levdan159/abx-motion/abx-3dmodels/README.txt

3D visualization models

DFN-8-1EP_3x3mm_P0.65mm_EP1.5x2.25mm.step
Source: installed KiCad Package_DFN_QFN.3dshapes library (/usr/share/kicad/3dmodels).
Used as a generic 3 x 3 mm, 0.65 mm pitch visual package for U710 (TPS3431 DRB).
The generic model exposed-pad geometry differs from the device-specific footprint; this model does not define copper, paste, assembly or thermal requirements.

U701-U703 use the existing project-local DRV8462_DDW0044E_Envelope.wrl mechanical envelope.
These visual models do not replace component drawings or the PCB land patterns.
