levdan159/abx-motion/design/thermal-rev1.2-20261023/README.txt

Rev 1.2a checkpoint, 2026-10-23

filled-capped-vias.csv describes the implemented PCB fabrication features.
thermal-assembly.pdf, HS1-machining-plan.dxf, heatsink-bom.csv and heatsink-placement.png describe a SUPERSEDED machined-heatsink study. They are not current assembly instructions or purchasing approval.

No custom machining is available. Current cooling direction: stock underside finned heatsinks plus supplemental individual top-side driver heatsinks. Exact parts, retention and performance are pending. See ../thermal-rev1.2-20261023.md and ../rev-1.2a-checkpoint.md.
