levdan159/abx-motion/production/rev-1.2a-20261023/drill-report.txt

Drill report for abx-motion.kicad_pcb
Created on 2026-10-23T12:07:56

Copper Layer Stackup:
    =============================================================
    L1 :  F.Cu                      front
    L2 :  In1.Cu                    in1
    L3 :  In2.Cu                    in2
    L4 :  B.Cu                      back

Drill file 'abx-motion-PTH.drl' contains
    plated through holes:
    =============================================================
    T1  0.250mm  0.0098"  (587 holes))
    T2  0.300mm  0.0118"  (511 holes))
    T3  0.300mm  0.0118"  (38 holes))
    T4  0.400mm  0.0157"  (33 holes))
    T5  0.500mm  0.0197"  (32 holes))
    T6  0.600mm  0.0236"  (4 holes)  (with 4 slots)
    T7  0.750mm  0.0295"  (24 holes))
    T8  0.800mm  0.0315"  (6 holes))
    T9  0.900mm  0.0354"  (4 holes))
    T10  0.950mm  0.0374"  (24 holes))
    T11  1.000mm  0.0394"  (32 holes))
    T12  1.300mm  0.0512"  (28 holes))
    T13  1.800mm  0.0709"  (4 holes))
    T14  3.200mm  0.1260"  (4 holes))
    T15  4.500mm  0.1772"  (2 holes))

    Total plated holes count 1333

Drill file 'abx-motion-NPTH.drl' contains
    unplated through holes:
    =============================================================
    T1  0.650mm  0.0256"  (2 holes))
    T2  2.200mm  0.0866"  (2 holes))

    Total unplated holes count 4
