levdan159/abx-motion/design/rev-1.2-research/conduction-loss-comparison.csv

driver | phase_RMS_A | condition | HS_ohm | LS_ohm | conduction_W_per_axis | conduction_W_three_axes
DRV8461_PWP | 1 | typ25 | 0.153 | 0.15 | 0.606 | 1.818
DRV8461_PWP | 1 | max25 | 0.18 | 0.185 | 0.73 | 2.19
DRV8461_PWP | 1 | max125 | 0.285 | 0.3 | 1.17 | 3.51
DRV8461_PWP | 1.5 | typ25 | 0.153 | 0.15 | 1.3635 | 4.0905
DRV8461_PWP | 1.5 | max25 | 0.18 | 0.185 | 1.6425 | 4.9275
DRV8461_PWP | 1.5 | max125 | 0.285 | 0.3 | 2.6325 | 7.8975
DRV8461_PWP | 2 | typ25 | 0.153 | 0.15 | 2.424 | 7.272
DRV8461_PWP | 2 | max25 | 0.18 | 0.185 | 2.92 | 8.76
DRV8461_PWP | 2 | max125 | 0.285 | 0.3 | 4.68 | 14.04
DRV8452_PWP | 1 | typ25 | 0.057 | 0.06 | 0.234 | 0.702
DRV8452_PWP | 1 | max25 | 0.068 | 0.072 | 0.28 | 0.84
DRV8452_PWP | 1 | max125 | 0.1 | 0.105 | 0.41 | 1.23
DRV8452_PWP | 1.5 | typ25 | 0.057 | 0.06 | 0.5265 | 1.5795
DRV8452_PWP | 1.5 | max25 | 0.068 | 0.072 | 0.63 | 1.89
DRV8452_PWP | 1.5 | max125 | 0.1 | 0.105 | 0.9225 | 2.7675
DRV8452_PWP | 2 | typ25 | 0.057 | 0.06 | 0.936 | 2.808
DRV8452_PWP | 2 | max25 | 0.068 | 0.072 | 1.12 | 3.36
DRV8452_PWP | 2 | max125 | 0.1 | 0.105 | 1.64 | 4.92
