levdan159/abx-motion/abx_gears.png

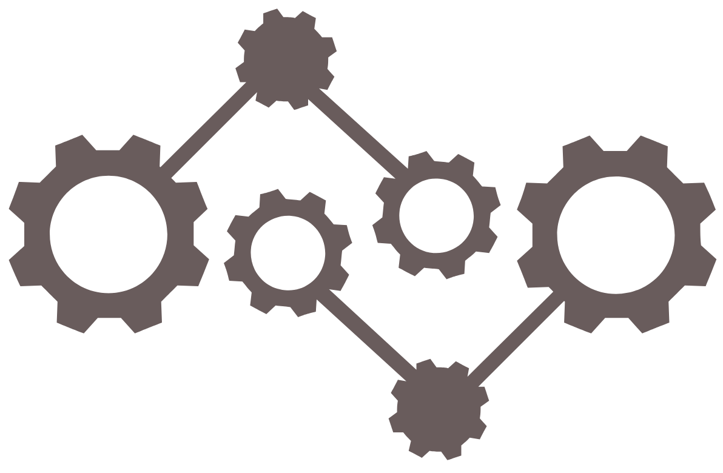
abx_gears.png
