levdan159/abx-motion/design/thermal-rev1.2-20261023/heatsink-placement.png

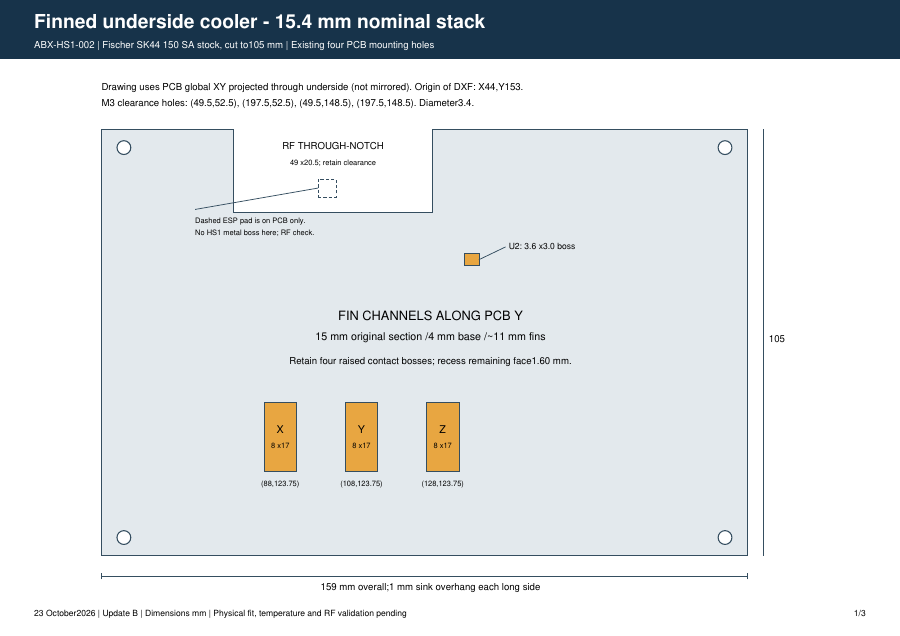
design/thermal-rev1.2-20261023/heatsink-placement.png
