levdan159/abx-motion/production/rev-1.1b-20261020/pcb_3d_top.png

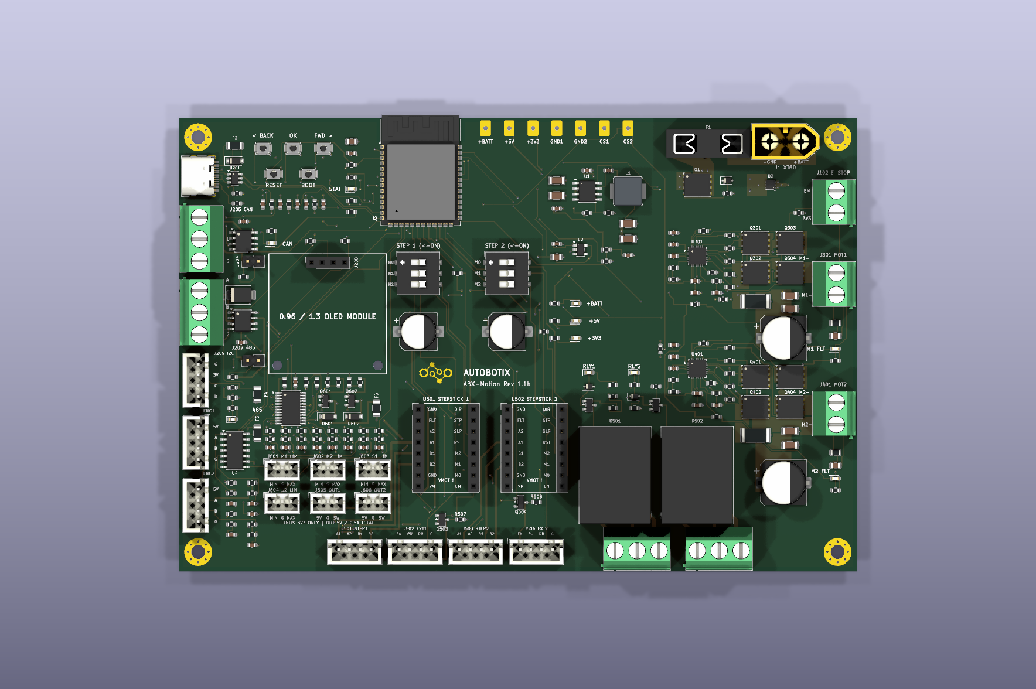
production/rev-1.1b-20261020/pcb_3d_top.png
