levdan159/abx-motion/production/rev-1.1b-20261020/placement-summary.png

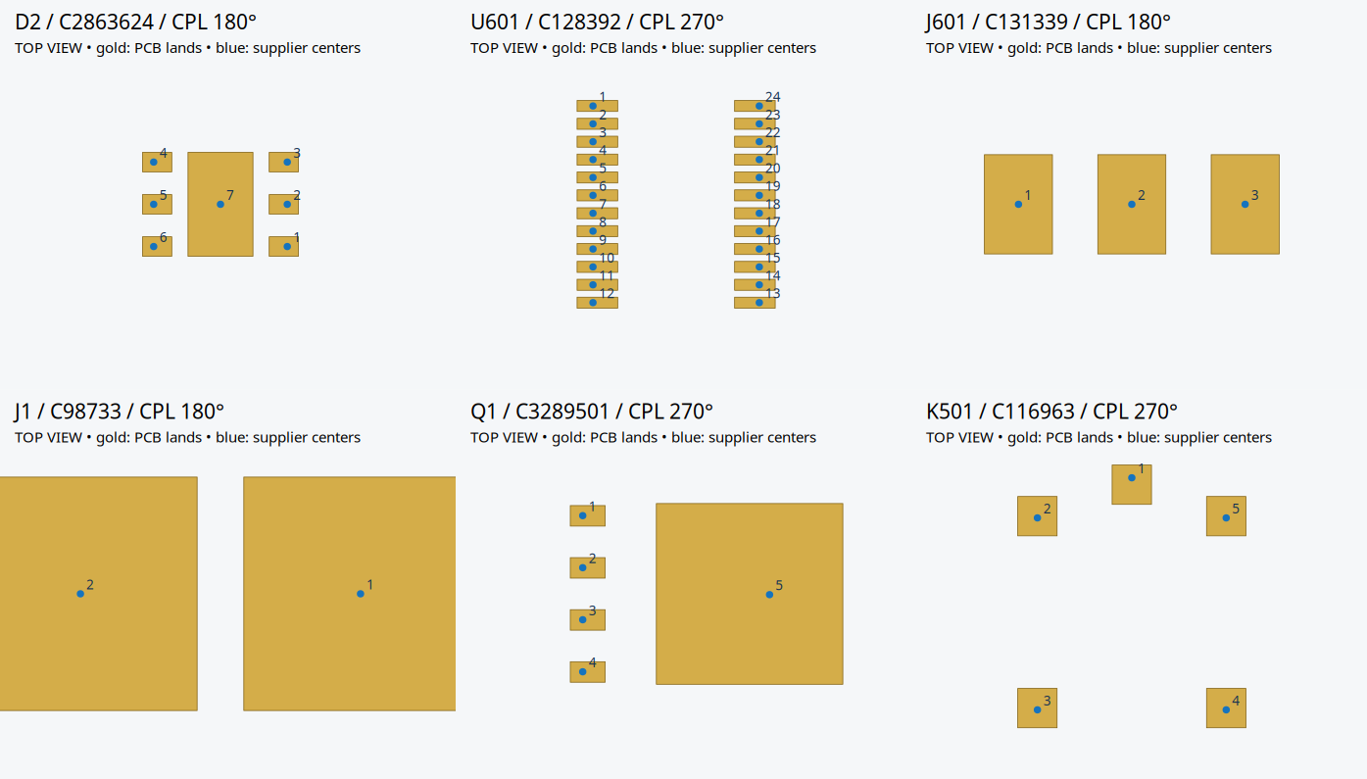
production/rev-1.1b-20261020/placement-summary.png
