levdan159/abx-motion/renders/f1_bottom_check.png

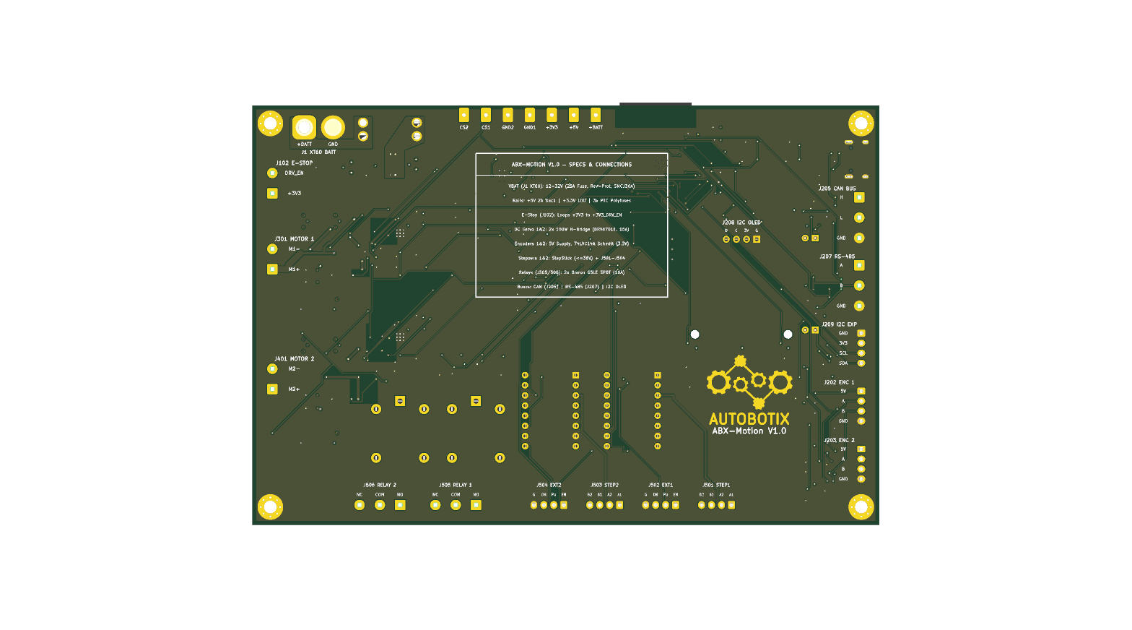
renders/f1_bottom_check.png
