levdan159/abx-motion/renders/f1_check.png

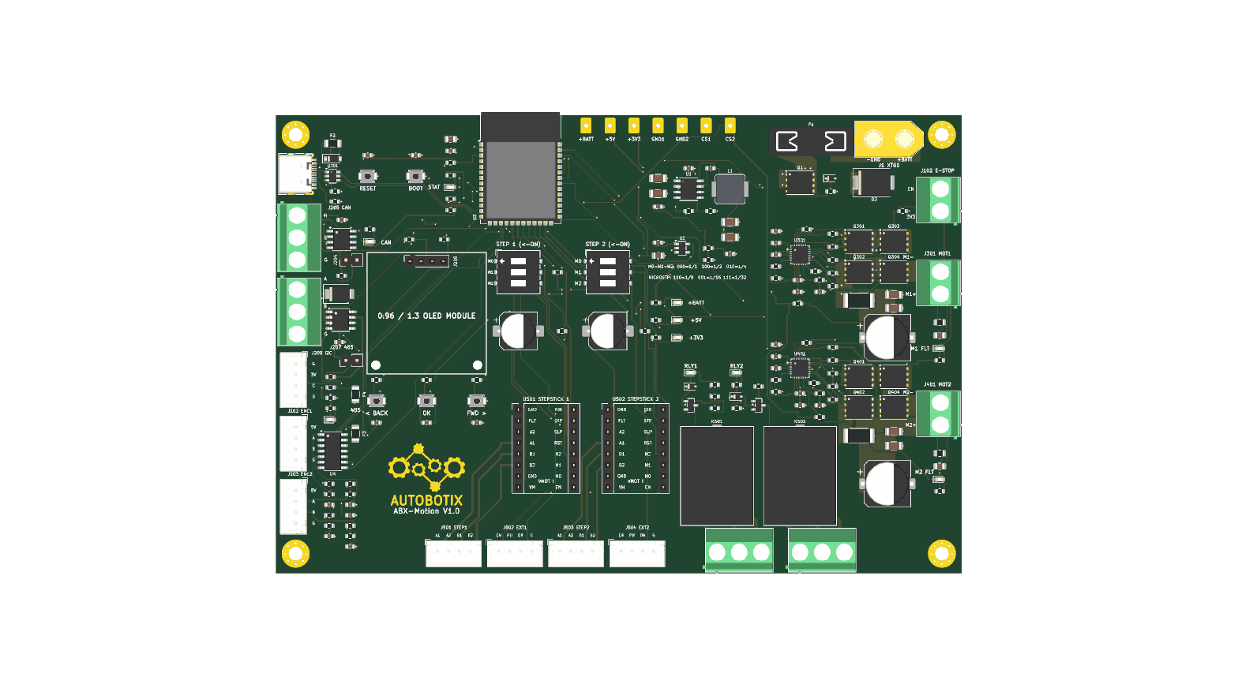
renders/f1_check.png
