levdan159/abx-motion/renders/page-1.png

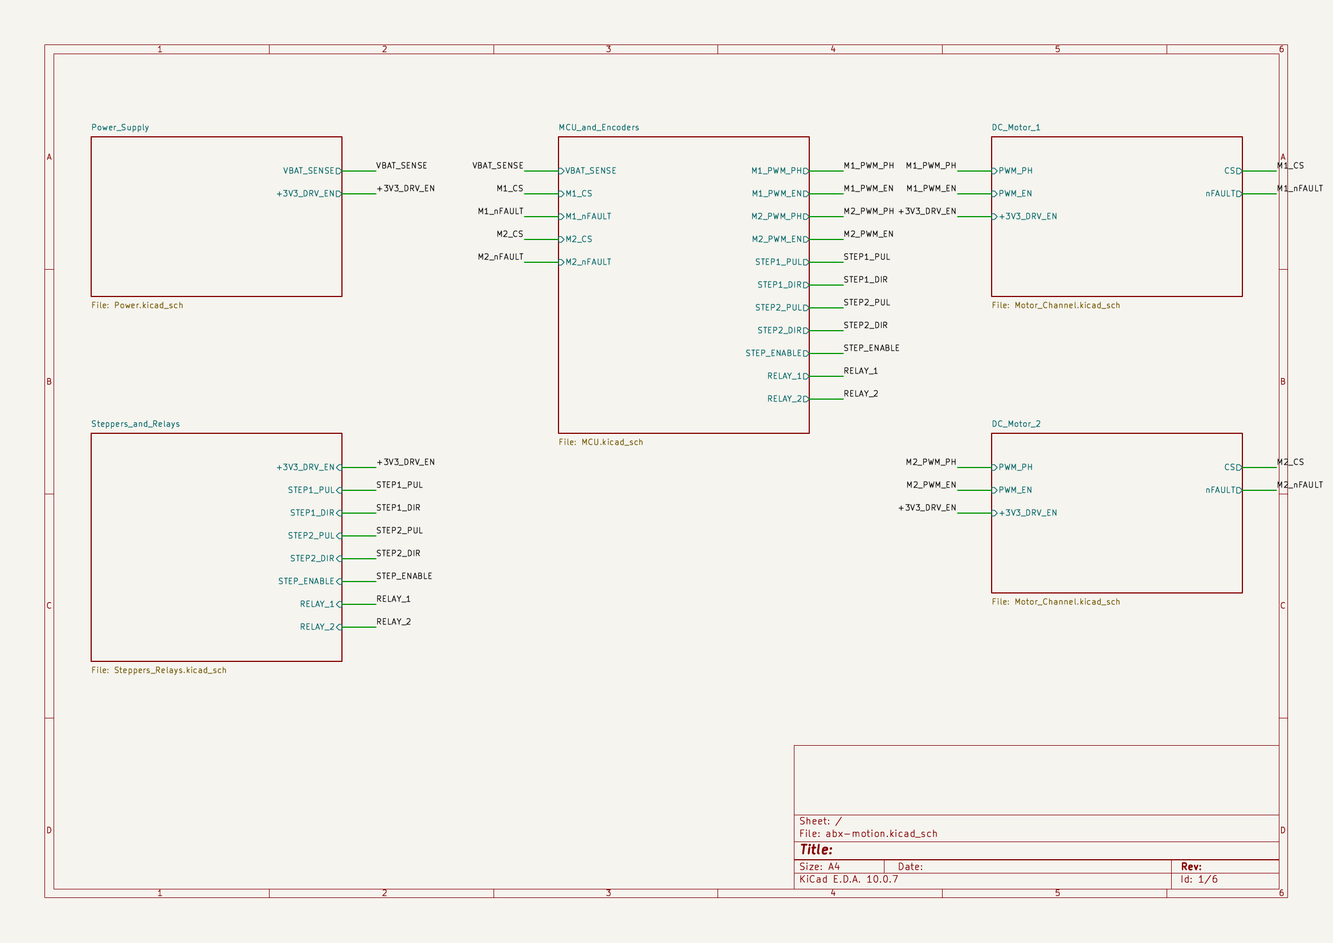
renders/page-1.png
