levdan159/abx-motion/renders/page-2.png

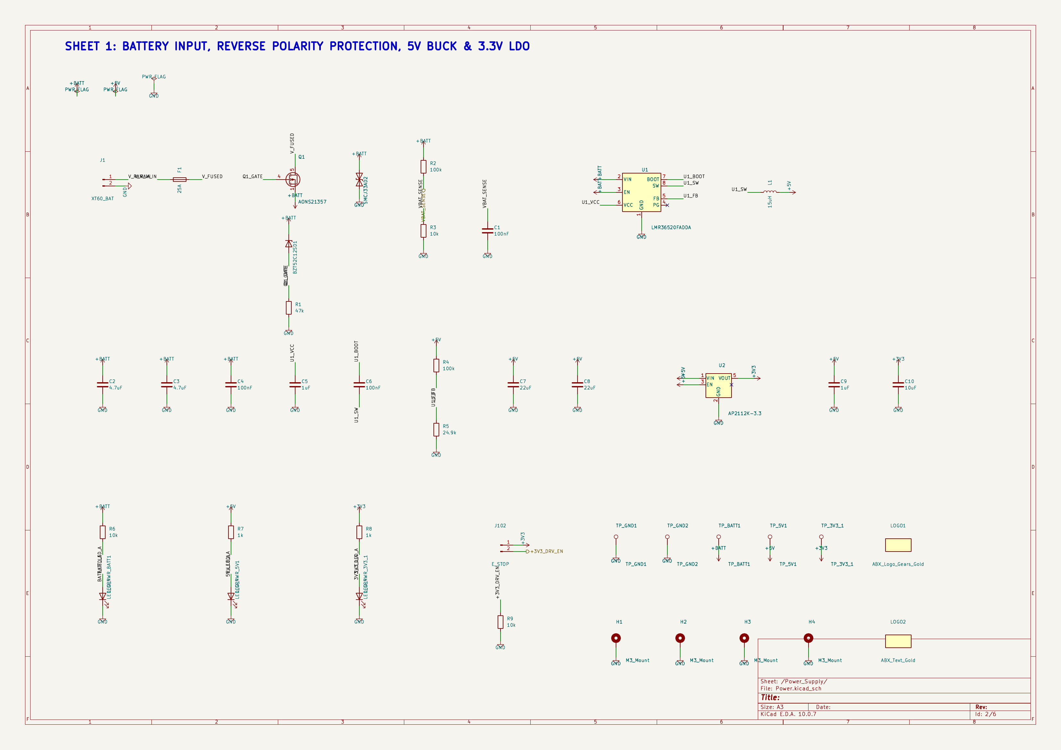
renders/page-2.png
