levdan159/abx-motion/renders/page-3.png

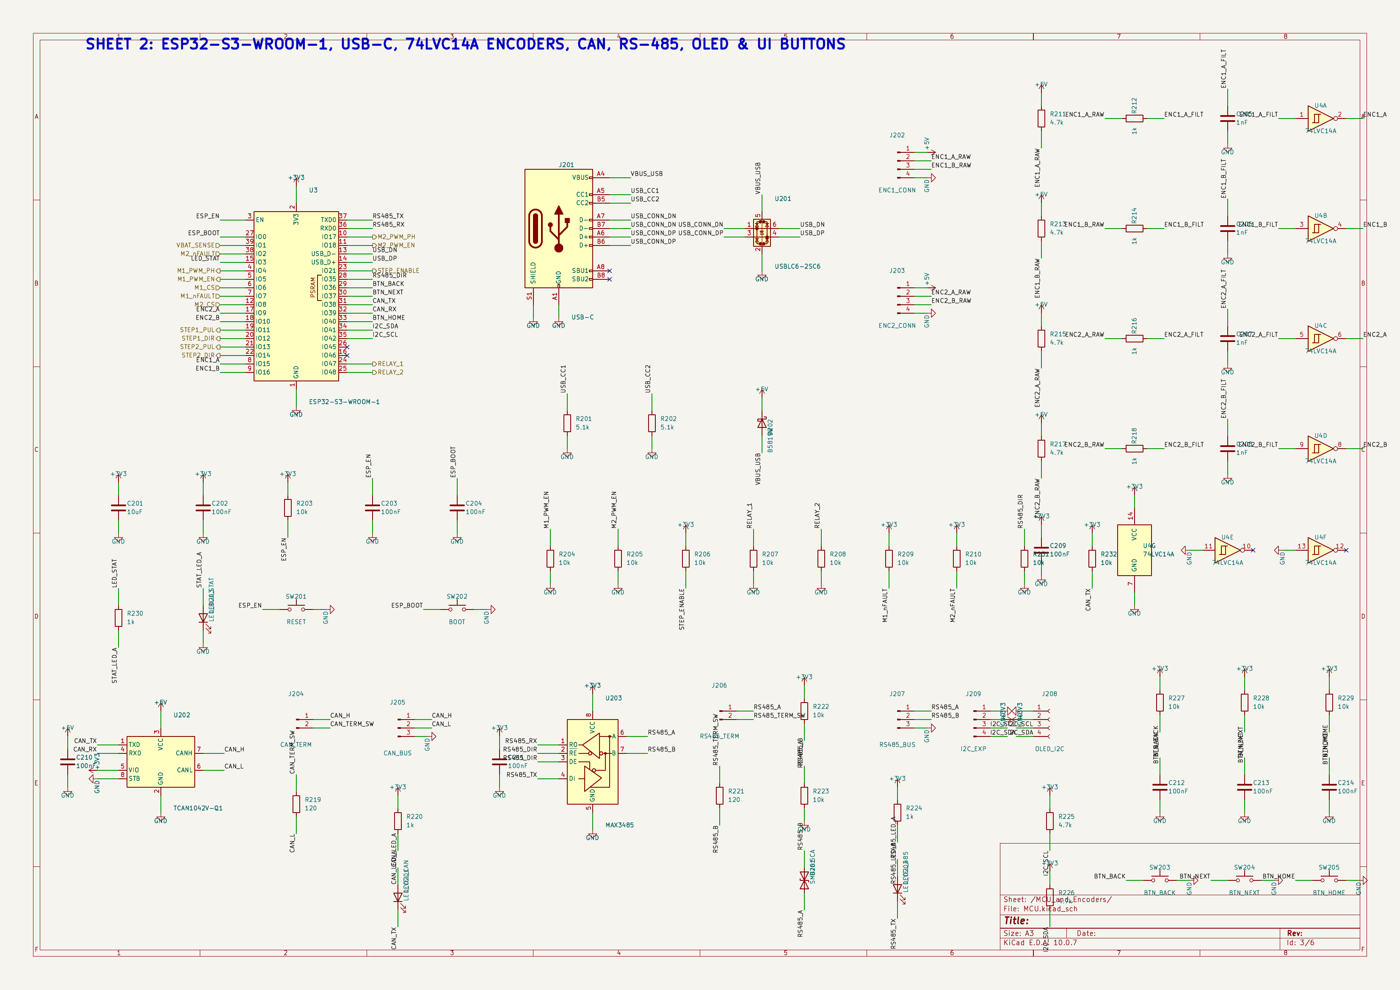
renders/page-3.png
