levdan159/abx-motion/renders/page-4.png

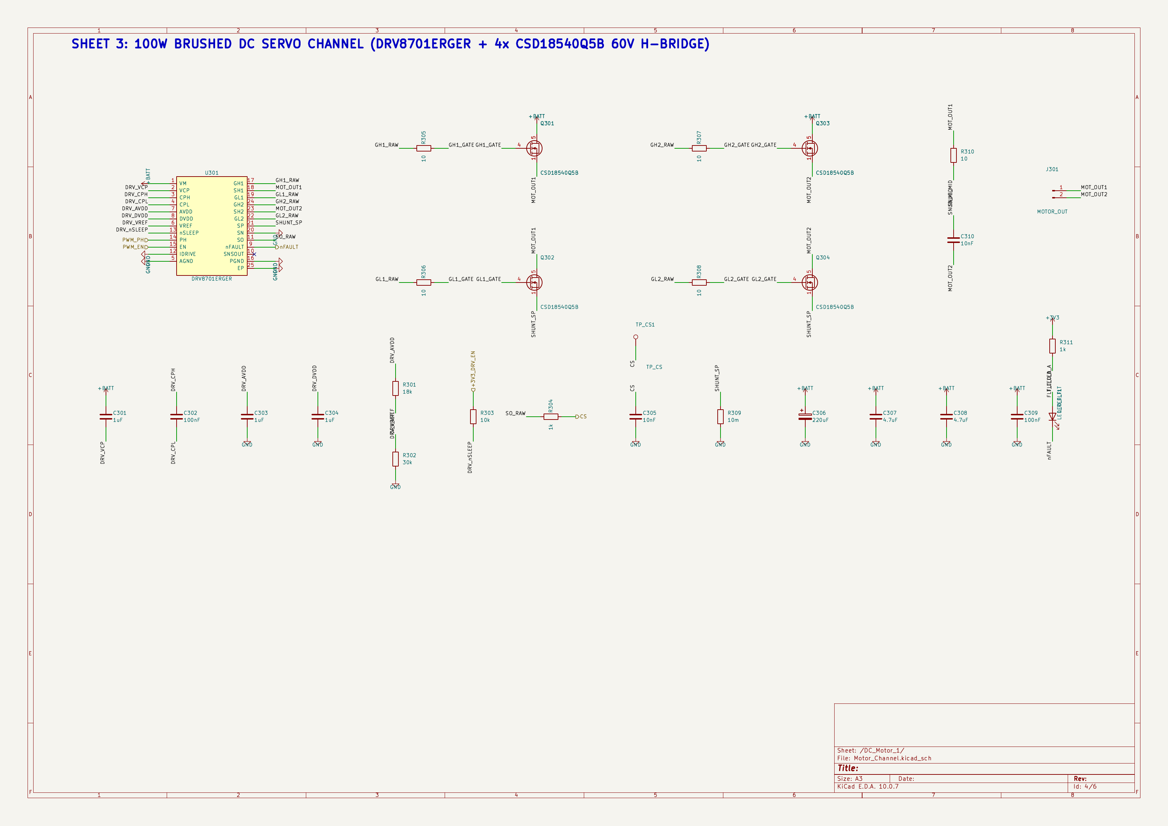
renders/page-4.png
