levdan159/abx-motion/renders/page-6.png

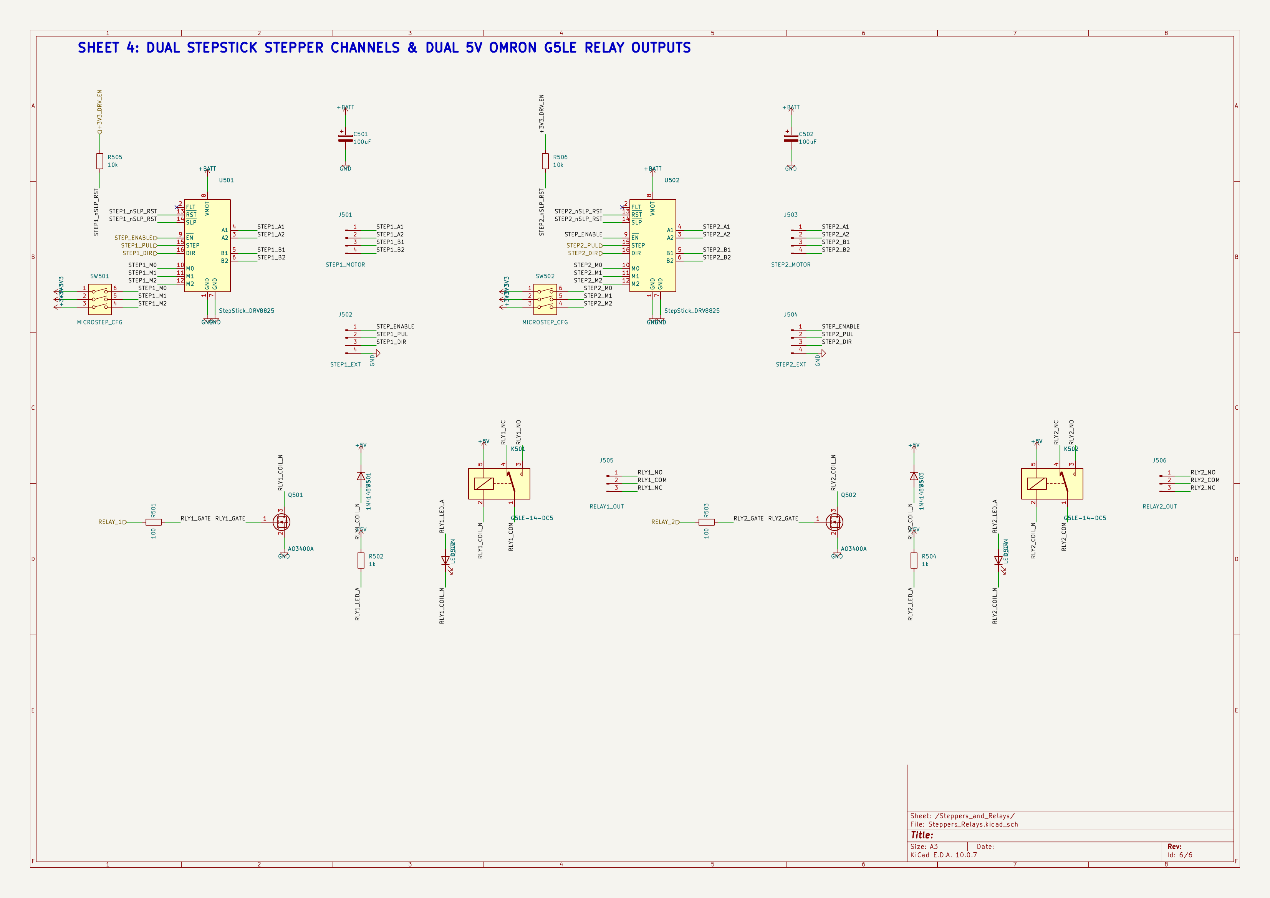
renders/page-6.png
