levdan159/abx-motion/renders/pcb_bottom.png

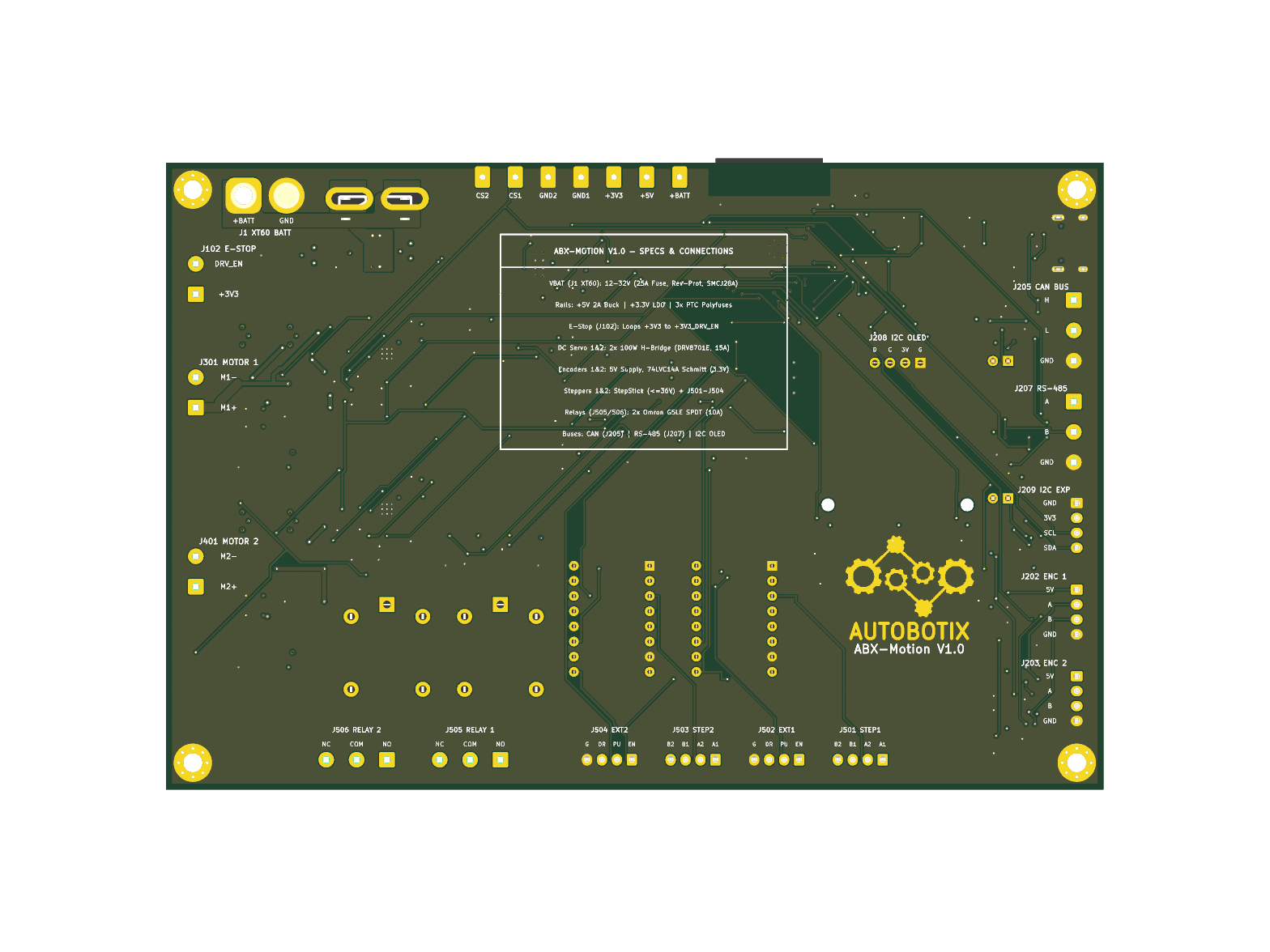
renders/pcb_bottom.png
