levdan159/abx-motion/renders/pcb_isometric.png

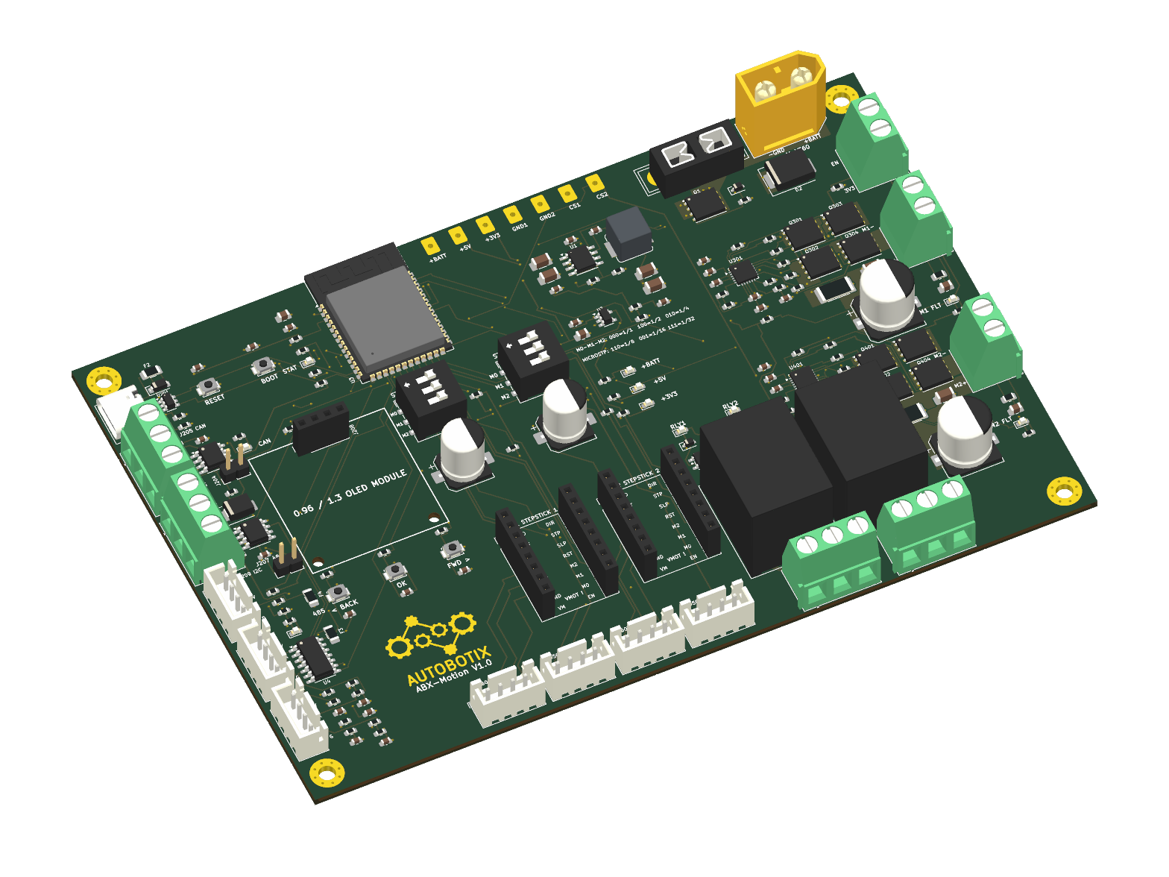
renders/pcb_isometric.png
