levdan159/abx-motion/renders/pcb_placement.png

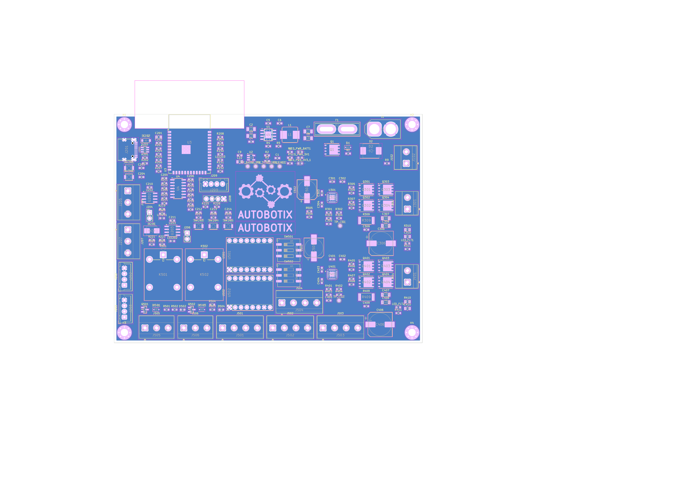
renders/pcb_placement.png
