levdan159/abx-motion/variants/ABX-Motion-ETH/layout-review/placement-3d.png

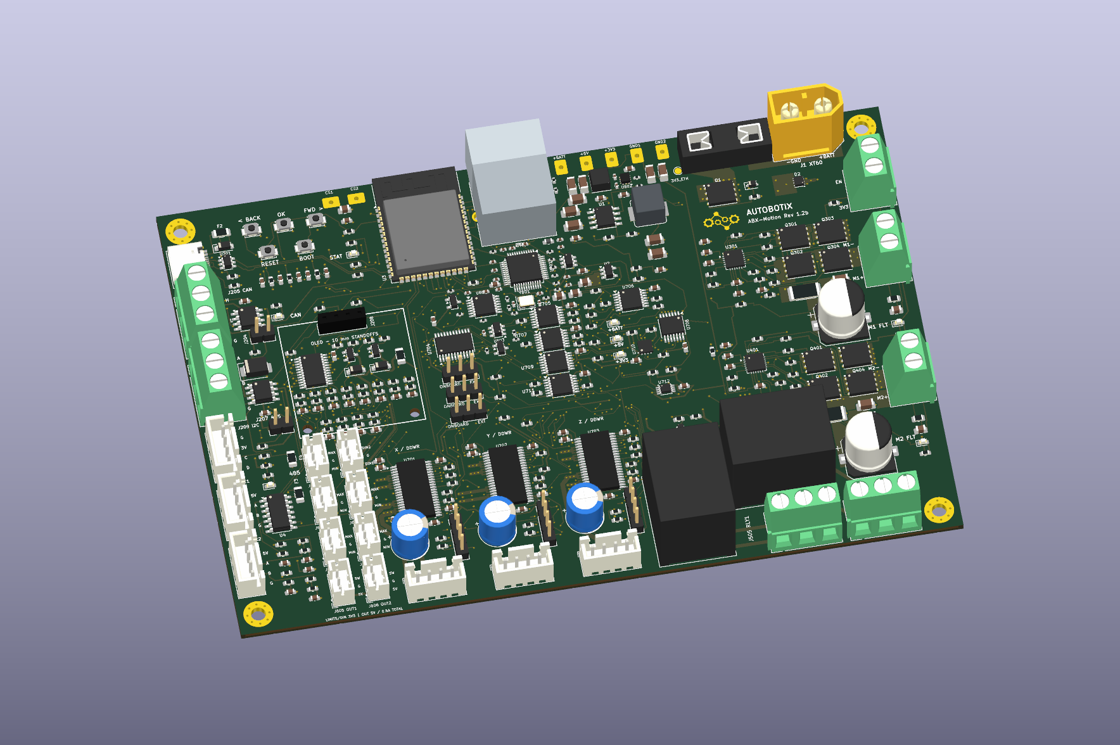
variants/ABX-Motion-ETH/layout-review/placement-3d.png
