levdan159/abx-motion/variants/ABX-Motion-ETH/layout-review/placement-detail.png

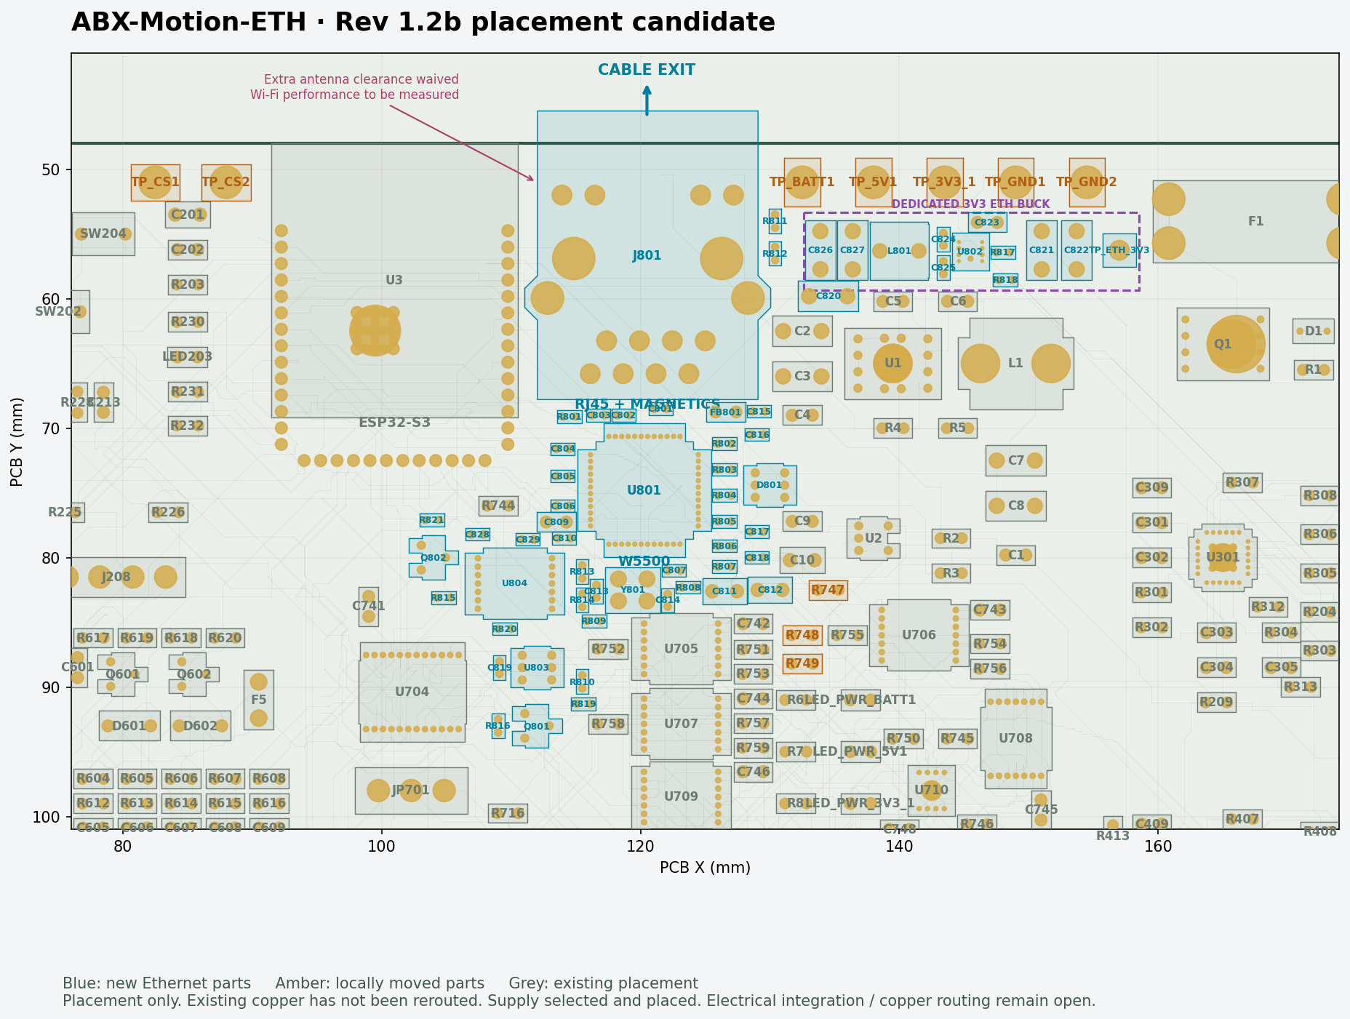
variants/ABX-Motion-ETH/layout-review/placement-detail.png
