levdan159/abx-motion/variants/ABX-Motion-ETH/layout-review/placement-overview.png

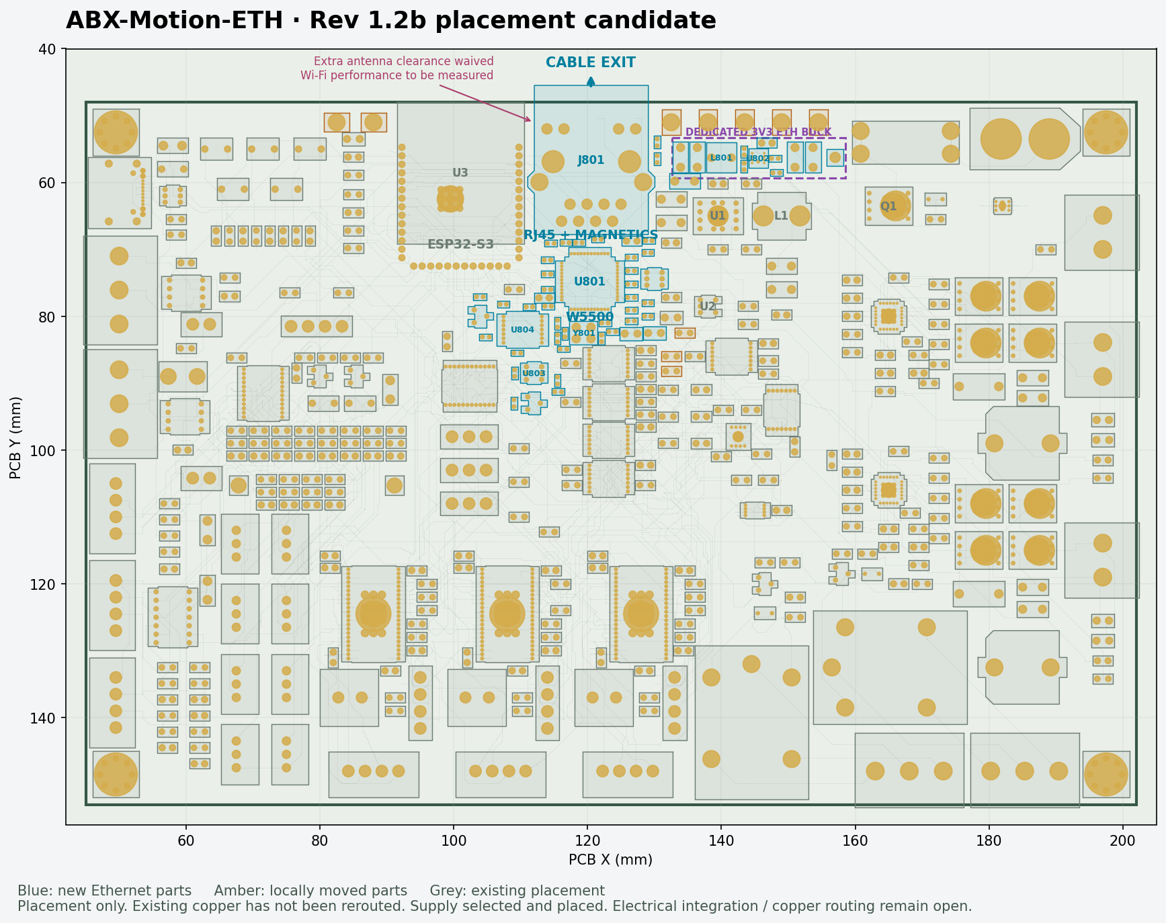
variants/ABX-Motion-ETH/layout-review/placement-overview.png
