levdan159/abx-motion/variants/ABX-Motion-ETH/layout-review/power-routing-plan.png

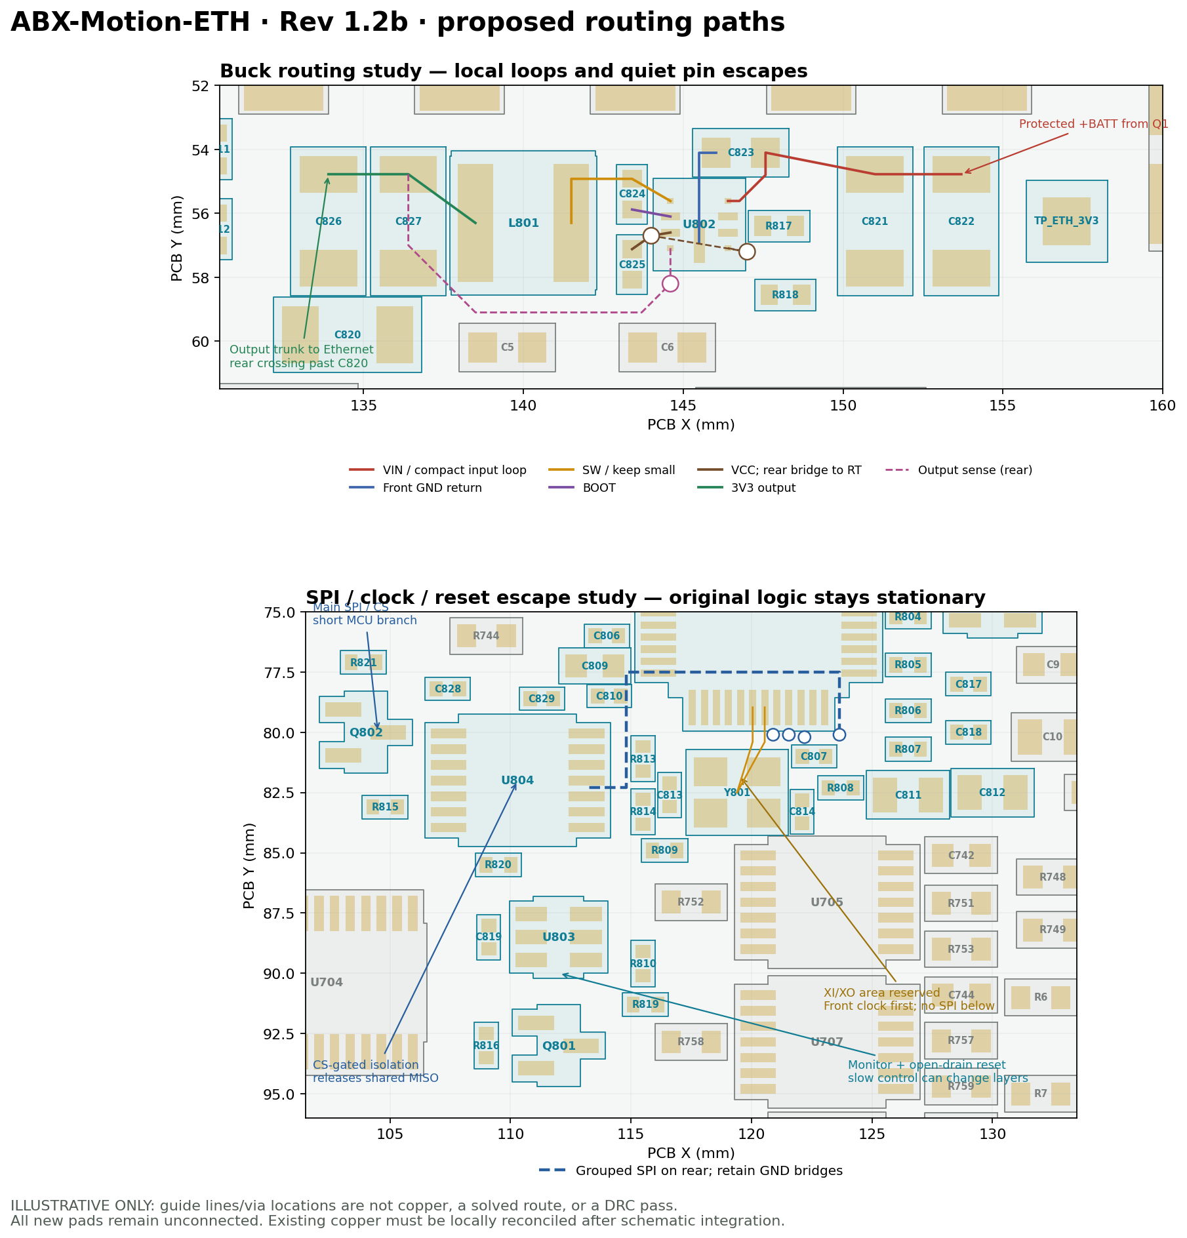
variants/ABX-Motion-ETH/layout-review/power-routing-plan.png
