levdan159/abx-motion/variants/ABX-Motion-ETH/layout-review/routing-overview.png

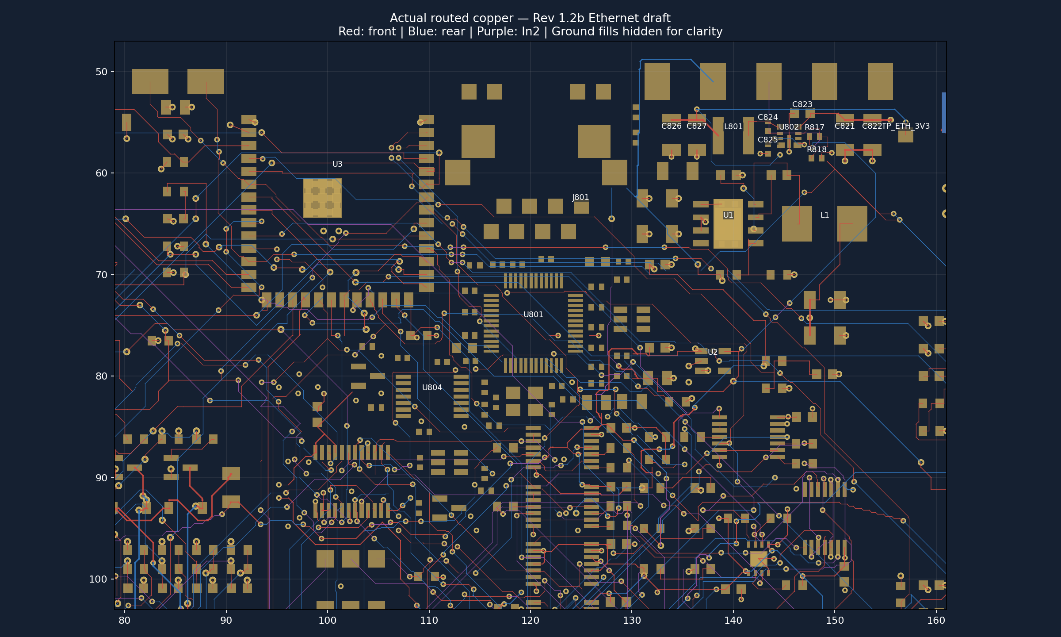
variants/ABX-Motion-ETH/layout-review/routing-overview.png
