levdan159/abx-motion/variants/ABX-Motion-ETH/layout-review/routing-supply.png

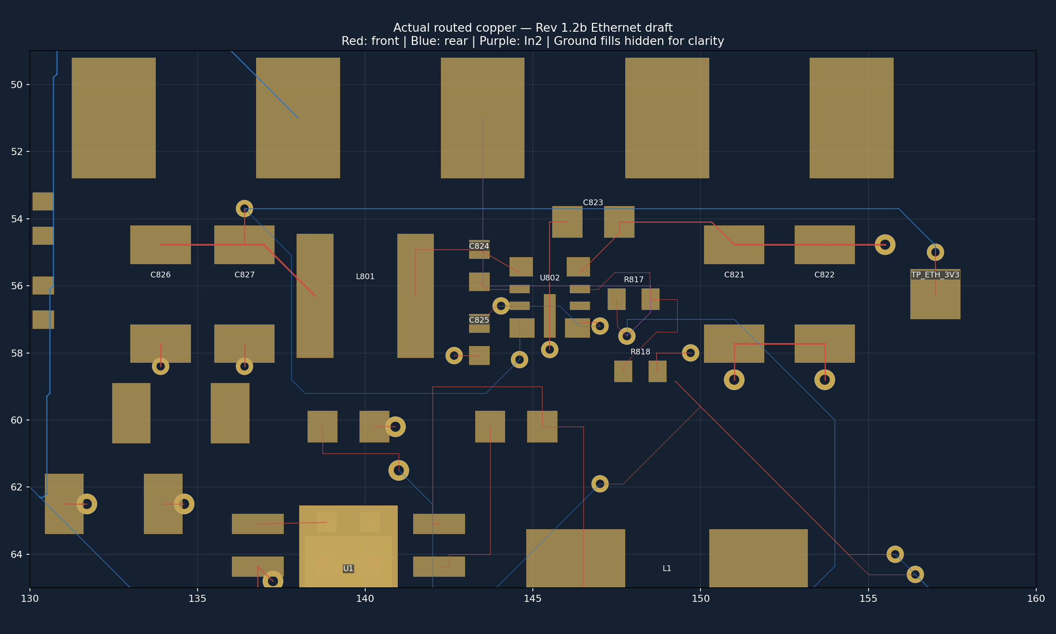
variants/ABX-Motion-ETH/layout-review/routing-supply.png
