levdan159/abx-motion/work/rev-1.2-ext-upright/review/front.png

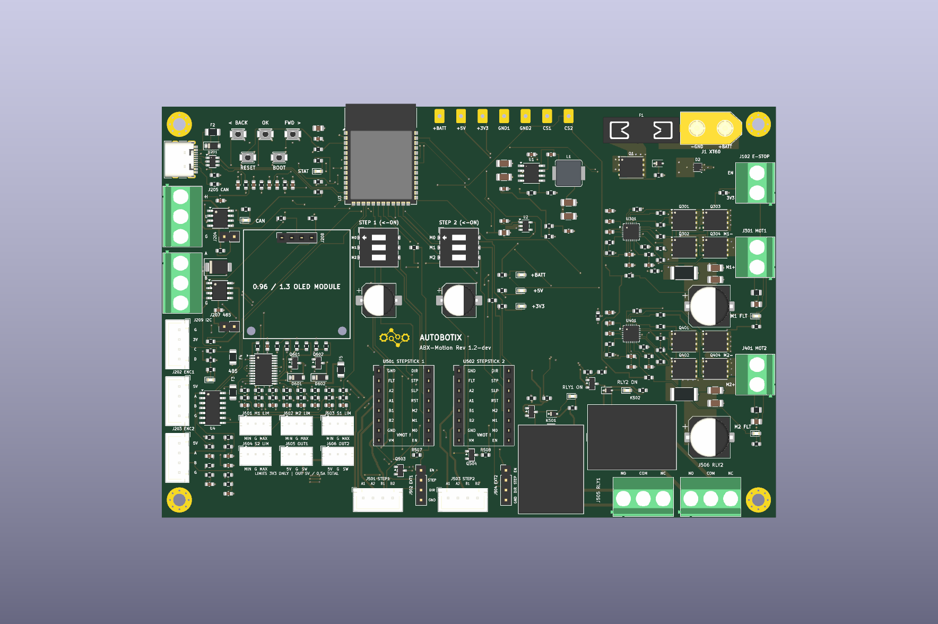
work/rev-1.2-ext-upright/review/front.png
