levdan159/abx-motion/work/rev-1.2-relay-bay/review/relay-bay-before-after.png

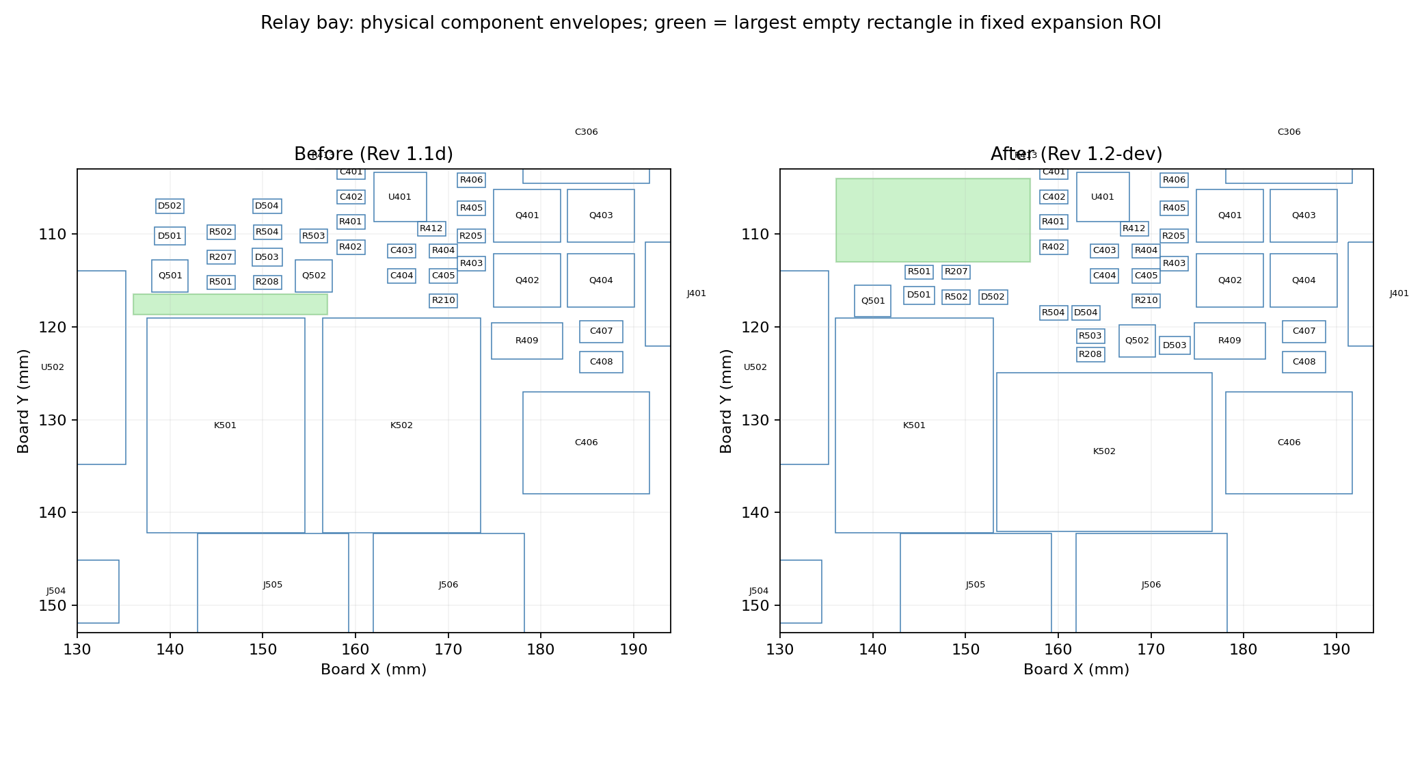
work/rev-1.2-relay-bay/review/relay-bay-before-after.png
