levdan159/abx-motion/work/rev-1.2-relay-bottom-right/review/relay-bay-before-after.png

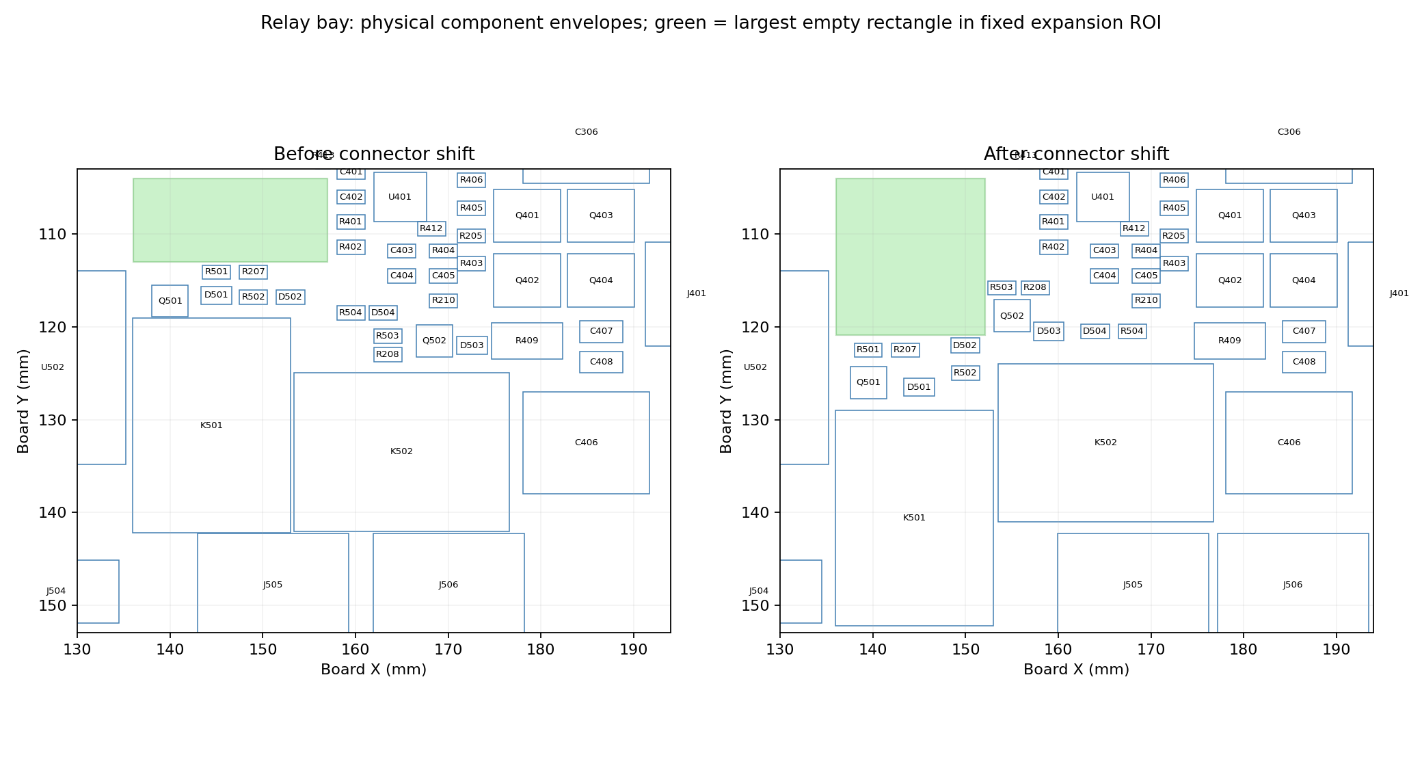
work/rev-1.2-relay-bottom-right/review/relay-bay-before-after.png
