levdan159/abx-motion/validation/rev-1.2a-20261023/inventory-summary.txt

R305,R306,R307,R308,R405,R406,R407,R408 10 R_0603_1608Metric C22859
R310,R410 10 R_0805_2012Metric C844598
R501,R503,R619,R620,R751,R752,R753,R754,R755,R756,R757,R758,R759 100 R_0603_1608Metric C22775
R4 100k R_0603_1608Metric C25803
C1,C202,C203,C204,C209,C210,C211,C212,C213,C214,C302,C309,C4,C402,C409,C6,C601 100nF C_0603_1608Metric C14663
C715,C725,C735,C741,C742,C743,C744,C745,C746,C747,C748,C749 100nF 16V X7R C_0603_1608Metric C14663
C713,C723,C733 100nF 63V X7R C_0603_1608Metric C77058
C717,C727,C737 100uF 63V CP_Radial_D8.0mm_P3.50mm C88747
R203,R204,R205,R206,R207,R208,R209,R210,R227,R228,R229,R231,R232,R3,R303,R403,R711,R712,R713,R714,R715,R716,R717,R718,R721,R722,R723,R724,R725,R726,R727,R728,R731,R732,R733,R734,R735,R736,R737,R738,R744,R745,R746,R747,R748,R749,R750,R9 10k R_0603_1608Metric C25804
R309,R409 10mR_3W R_2512_6332Metric C840621
C305,C405,C602,C603,C604,C605,C606,C607,C608,C609,C610,C611,C612,C613 10nF C_0603_1608Metric C57112
C711,C712,C721,C722,C731,C732 10nF 63V X7R C_0603_1608Metric C162275
C10,C201 10uF C_0805_2012Metric C15850
R219,R221 120 R_0603_1608Metric C22787
F5 1206L050/15YR Fuse_1206_3216Metric C151162
R302,R402 12k R_0603_1608Metric C22790
R2 150k R_0603_1608Metric C22807
L1 15uH L_Bourns_SRP7028A_7.3x6.6mm C177243
R301,R401 18k R_0603_1608Metric C25810
D501,D503 1N4148WS D_SOD-323 C2128
R212,R214,R216,R218,R220,R224,R230,R304,R311,R313,R404,R411,R413,R502,R504,R609,R610,R611,R612,R613,R614,R615,R616,R617,R618,R625,R626,R629,R630,R7,R761,R762,R763,R764,R765,R8 1k R_0603_1608Metric C21190
C205,C206,C207,C208 1nF C_0603_1608Metric C1588
C301,C303,C304,C401,C403,C404,C5,C9 1uF C_0603_1608Metric C15849
C716,C726,C736 1uF 10V X7R C_0603_1608Metric C59782
C714,C724,C734 1uF 16V X7R C_0603_1608Metric C59782
C310,C410 2.2nF C_0805_2012Metric C107136
R312,R412 200k R_0603_1608Metric C25811
C306,C406 220uF CP_Elec_10x10.5 C72499
R6 22k R_0603_1608Metric C31850
C7,C8 22uF C_1206_3216Metric C12891
R5 24.9k R_0603_1608Metric C25962
F4 250mA_PTC Fuse_1206_3216Metric C20798
F1 25A Fuseholder_Keystone_3557-2 C352820
R222,R223 330R R_0603_1608Metric C23138
R211,R213,R215,R217,R225,R226,R601,R602,R603,R604,R605,R606,R607,R608,R623,R624,R627,R628 4.7k R_0603_1608Metric C23162
C2,C3,C307,C308,C407,C408 4.7uF C_1206_3216Metric C29823
R1 47k R_0603_1608Metric C25819
R201,R202 5.1k R_0603_1608Metric C23186
F2,F3 500mA_PTC Fuse_1206_3216Metric C2984676
U4 74LVC14A SOIC-14_3.9x8.7mm_P1.27mm C133541
Q501,Q502,Q601,Q602 AO3400A SOT-23 C20917
U2 AP2112K-3.3 SOT-23-5 C51118
J601,J602,J603,J604,J605,J606,J607,J608 B3B-PH-K-S JST_PH_B3B-PH-K_1x03_P2.00mm_Vertical C131339
D202,D601,D602 B5819W D_SOD-123 C8598
SW202 BOOT SW_SPST_B3U-1000P C231329
SW203 BTN_BACK SW_SPST_B3U-1000P C231329
SW205 BTN_HOME SW_SPST_B3U-1000P C231329
SW204 BTN_NEXT SW_SPST_B3U-1000P C231329
D1 BZT52C12S D_SOD-323 C14643
J205 CAN_BUS TerminalBlock_Phoenix_MKDS-1,5-3-5.08_1x03_P5.08mm_Horizontal C72334
J204 CAN_TERM PinHeader_1x02_P2.54mm_Vertical C492401
Q301,Q302,Q303,Q304,Q401,Q402,Q403,Q404 CSD18540Q5B TDSON-8-1 C86513
U701,U702,U703 DRV8462DDWR DRV8462_DDW0044E C5930226
U301,U401 DRV8701ERGER Texas_RGE0024C_VQFN-24-1EP_4x4mm_P0.5mm_EP2.1x2.1mm_ThermalVias C90964
J202 ENC1_CONN JST_XH_B4B-XH-A_1x04_P2.50mm_Vertical C566014
J203 ENC2_CONN JST_XH_B4B-XH-A_1x04_P2.50mm_Vertical C566014
U3 ESP32-S3-WROOM-1-N8R2 ESP32-S3-WROOM-1 C2913204
J701,J702,J703 EXT 5V TTL EN_N STEP DIR GND PinHeader_1x04_P2.54mm_Vertical C492403
J102 E_STOP TerminalBlock_Phoenix_MKDS-1,5-2-5.08_1x02_P5.08mm_Horizontal C8465
K501,K502 G5LE-14-DC5 Relay_SPDT_Omron-G5LE-1 C116963
J209 I2C_EXP JST_XH_B4B-XH-A_1x04_P2.50mm_Vertical C566014
J711 JST-XH MOTOR 1 JST_XH_B4B-XH-A_1x04_P2.50mm_Vertical C566014
J712 JST-XH MOTOR 2 JST_XH_B4B-XH-A_1x04_P2.50mm_Vertical C566014
J713 JST-XH MOTOR 3 JST_XH_B4B-XH-A_1x04_P2.50mm_Vertical C566014
LED203 LED_BLU_STAT LED_0603_1608Metric C2288
D502,D504,LED_PWR_3V3_1,LED_PWR_5V1,LED_PWR_BATT1 LED_GRN LED_0603_1608Metric C12624
LED_FLT1,LED_FLT2 LED_RED_FLT LED_0603_1608Metric C2286
LED202 LED_YEL_485 LED_0603_1608Metric C2287
LED201 LED_YEL_CAN LED_0603_1608Metric C2287
U1 LMR36520FADDA Texas_HSOP-8-1EP_3.9x4.9mm_P1.27mm_ThermalVias C1858395
H1,H2,H3,H4 M3_Mount MountingHole_3.2mm_M3_Pad_Via 
J301,J401 MOTOR_OUT TerminalBlock_Phoenix_MKDS-1,5-2-5.08_1x02_P5.08mm_Horizontal C8465
J208 OLED_I2C OLED_Socket_SLW_1x04_P2.54mm_LowProfile 
JP701,JP702,JP703 ONBOARD / EXT PinHeader_1x03_P2.54mm_Vertical C492402
U601,U704 PCA9555PW,118 TSSOP-24_4.4x7.8mm_P0.65mm C128392
J505 RELAY1_OUT TerminalBlock_Phoenix_MKDS-1,5-3-5.08_1x03_P5.08mm_Horizontal C72334
J506 RELAY2_OUT TerminalBlock_Phoenix_MKDS-1,5-3-5.08_1x03_P5.08mm_Horizontal C72334
SW201 RESET SW_SPST_B3U-1000P C231329
J207 RS485_BUS TerminalBlock_Phoenix_MKDS-1,5-3-5.08_1x03_P5.08mm_Horizontal C72334
J206 RS485_TERM PinHeader_1x02_P2.54mm_Vertical C492401
D201 SMBJ6.5CA D_SMB C78428
U705,U706,U707 SN74AHCT14PWR TSSOP-14_4.4x5mm_P0.65mm C7481
U708,U711 SN74HC08PWR TSSOP-14_4.4x5mm_P0.65mm C7642
U709 SN74HC74PWR TSSOP-14_4.4x5mm_P0.65mm C6761
U712 SN74LVC2G08DCUR VSSOP-8_2.3x2mm_P0.5mm C91875
Q1 SQJ459EP-T1_GE3 TDSON-8-1 C3289501
U202 TCAN1042V-Q1 SOIC-8_3.9x4.9mm_P1.27mm C132550
U203 THVD1450DR SOIC-8_3.9x4.9mm_P1.27mm C2671361
U710 TPS3431SDRBR TPS3431_DRB0008A C702145
TP_3V3_1 TP_3V3_1 TestPoint_Pad_D1.5mm 
TP_5V1 TP_5V1 TestPoint_Pad_D1.5mm 
TP_BATT1 TP_BATT1 TestPoint_Pad_D1.5mm 
TP_CS1,TP_CS2 TP_CS TestPoint_Pad_D1.5mm 
TP_GND1 TP_GND1 TestPoint_Pad_D1.5mm 
TP_GND2 TP_GND2 TestPoint_Pad_D1.5mm 
D2 TVS3300DRVR TVS3300_DRV0006A_2x2mm C2863624
J201 USB-C USB_C_Receptacle_HRO_TYPE-C-31-M-12 C165948
U201 USBLC6-2SC6 SOT-23-6 C7519
J1 XT60_BAT AMASS_XT60-M_1x02_P7.20mm_Vertical C98733
