levdan159/abx-motion/production/assembly-audit-20261020/DO_NOT_ORDER.txt

HOLD: protection choice unresolved; relay physical alignment requires assembler review
See review.txt. The small TVS candidate is not released for unknown motor energy.
