levdan159/abx-motion/production/abx-motion-bom.csv

Comment | Designator | Footprint | LCSC Part #
100nF | C1,C202,C203,C204,C209,C210,C211,C212,C213,C214,C302,C309,C4,C402,C409,C6,C601 | C_0603_1608Metric | C14663
10uF | C10,C201 | C_0805_2012Metric | C15850
4.7uF | C2,C3,C307,C308,C407,C408 | C_1206_3216Metric | C29823
1nF | C205,C206,C207,C208 | C_0603_1608Metric | C1588
1uF | C301,C303,C304,C401,C403,C404,C5,C9 | C_0603_1608Metric | C15849
10nF | C305,C405,C602,C603,C604,C605,C606,C607,C608,C609 | C_0603_1608Metric | C57112
220uF | C306,C406 | CP_Elec_10x10.5 | C72499
2.2nF | C310,C410 | C_0805_2012Metric | C107136
100uF | C501,C502 | CP_Elec_8x10.5 | C72480
22uF | C7,C8 | C_1206_3216Metric | C12891
BZT52C12S | D1 | D_SOD-323 | C14643
TVS3300DRVR | D2 | TVS3300_DRV0006A_2x2mm | C2863624
SMBJ6.5CA | D201 | D_SMB | C78428
B5819W | D202,D601,D602 | D_SOD-123 | C8598
1N4148WS | D501,D503 | D_SOD-323 | C2128
KT-0603G | D502,D504,LED_PWR_3V3_1,LED_PWR_5V1,LED_PWR_BATT1 | LED_0603_1608Metric | C12624
25A | F1 | Fuseholder_Keystone_3557-2 | C352820
500mA_PTC | F2,F3 | Fuse_1206_3216Metric | C2984676
250mA_PTC | F4 | Fuse_1206_3216Metric | C20798
1206L050/15YR | F5 | Fuse_1206_3216Metric | C151162
XT60_BAT | J1 | AMASS_XT60-M_1x02_P7.20mm_Vertical | C98733
WJ500V-5.08-2P | J102,J301,J401 | TerminalBlock_Phoenix_MKDS-1,5-2-5.08_1x02_P5.08mm_Horizontal | C8465
USB-C | J201 | USB_C_Receptacle_HRO_TYPE-C-31-M-12 | C165948
B4B-XH-A-E(LF)(SN) | J202,J203,J209,J501,J502,J503,J504 | JST_XH_B4B-XH-A_1x04_P2.50mm_Vertical | C566014
PZ254V-11-02P | J204,J206 | PinHeader_1x02_P2.54mm_Vertical | C492401
WJ500V-5.08-3P-14-00A | J205,J207,J505,J506 | TerminalBlock_Phoenix_MKDS-1,5-3-5.08_1x03_P5.08mm_Horizontal | C72334
OLED_I2C | J208 | PinSocket_1x04_P2.54mm_Vertical | C2718488
B3B-PH-K-S | J601,J602,J603,J604,J605,J606 | JST_PH_B3B-PH-K_1x03_P2.00mm_Vertical | C131339
G5LE-14-DC5 | K501,K502 | Relay_SPDT_Omron-G5LE-1 | C116963
15uH | L1 | L_Bourns_SRP7028A_7.3x6.6mm | C177243
KT-0603Y | LED201,LED202 | LED_0603_1608Metric | C2287
LED_BLU_STAT | LED203 | LED_0603_1608Metric | C2288
LED_RED_FLT | LED_FLT1,LED_FLT2 | LED_0603_1608Metric | C2286
SQJ459EP-T1_GE3 | Q1 | TDSON-8-1 | C3289501
CSD18540Q5B | Q301,Q302,Q303,Q304,Q401,Q402,Q403,Q404 | TDSON-8-1 | C86513
AO3400A | Q501,Q502,Q503,Q504,Q601,Q602 | SOT-23 | C20917
47k | R1 | R_0603_1608Metric | C25819
150k | R2 | R_0603_1608Metric | C22807
5.1k | R201,R202 | R_0603_1608Metric | C23186
10k | R203,R204,R205,R206,R207,R208,R209,R210,R227,R228,R229,R231,R232,R3,R303,R403,R505,R506,R507,R508,R621,R622,R9 | R_0603_1608Metric | C25804
4.7k | R211,R213,R215,R217,R225,R226,R601,R602,R603,R604,R605,R606,R607,R608 | R_0603_1608Metric | C23162
1k | R212,R214,R216,R218,R220,R224,R230,R304,R311,R313,R404,R411,R413,R502,R504,R609,R610,R611,R612,R613,R614,R615,R616,R617,R618,R7,R8 | R_0603_1608Metric | C21190
120 | R219,R221 | R_0603_1608Metric | C22787
330R | R222,R223 | R_0603_1608Metric | C23138
18k | R301,R401 | R_0603_1608Metric | C25810
12k | R302,R402 | R_0603_1608Metric | C22790
10 | R305,R306,R307,R308,R405,R406,R407,R408 | R_0603_1608Metric | C22859
10mR_3W | R309,R409 | R_2512_6332Metric | C840621
10 | R310,R410 | R_0805_2012Metric | C844598
200k | R312,R412 | R_0603_1608Metric | C25811
100k | R4 | R_0603_1608Metric | C25803
24.9k | R5 | R_0603_1608Metric | C25962
100 | R501,R503,R619,R620 | R_0603_1608Metric | C22775
22k | R6 | R_0603_1608Metric | C31850
B3U-1000P | SW201,SW202,SW203,SW204,SW205 | SW_SPST_B3U-1000P | C231329
MICROSTEP_CFG | SW501,SW502 | SW_DIP_SPSTx03_Slide_9.78x9.8mm_W8.61mm_P2.54mm | C319040
LMR36520FADDA | U1 | Texas_HSOP-8-1EP_3.9x4.9mm_P1.27mm_ThermalVias | C1858395
AP2112K-3.3 | U2 | SOT-23-5 | C51118
USBLC6-2SC6 | U201 | SOT-23-6 | C7519
TCAN1042V-Q1 | U202 | SOIC-8_3.9x4.9mm_P1.27mm | C132550
THVD1450DR | U203 | SOIC-8_3.9x4.9mm_P1.27mm | C2671361
ESP32-S3-WROOM-1-N8R2 | U3 | ESP32-S3-WROOM-1 | C2913204
DRV8701ERGER | U301,U401 | Texas_RGE0024C_VQFN-24-1EP_4x4mm_P0.5mm_EP2.1x2.1mm_ThermalVias | C90964
74LVC14A | U4 | SOIC-14_3.9x8.7mm_P1.27mm | C133541
2.54-1*8P | U501_L,U501_R,U502_L,U502_R | PinSocket_1x08_P2.54mm_Vertical | C27438
PCA9555PW,118 | U601 | TSSOP-24_4.4x7.8mm_P0.65mm | C128392
