levdan159/abx-motion/validation/jlc-review-20261019_143817/confirmed-bom-errors.csv

references | code | actual | required | impact | source | candidate
C306,C406 | C72496 | ROQANG RVT1C221M0607: 220uF,16V,6.3mm diameter,7.7mm height | Battery-rail capacitor rated above maximum supply/transients; verify 50V or higher candidate and exact 10mm land pattern, ripple and ESR | Both are across +BATT/GND. 16V is unsuitable for the stated 12-32V range. Selected package also differs from CP_Elec_10x10.5 footprint. | https://www.lcsc.com/product-detail/C72496.html
F1 | C2897423 | HCTL PM254-2-03-W-8.5: six-pin right-angle female socket,2.54mm pitch | 25A ATO blade fuse compatible with the direct-solder blade slots | Wrong component category and incompatible lead count/geometry. Rotating the socket cannot make it a fuse. | https://www.lcsc.com/product-detail/C2897423.html | Select an exact blade fuse by mechanical drawing, or omit F1 from factory assembly and fit the verified fuse separately.
J205,J207,J505,J506 | C8466 | KANGNEX WJ15EDGK-3.81-02P-14-00A: two-position,3.81mm free-hanging pluggable connector | Three-position 5.08mm through-hole terminal block | Wrong number of contacts, pitch and connector style for three PCB holes spaced 5.08mm. | https://www.lcsc.com/product-detail/C8466.html | C72334: WJ500V-5.08-03P-14-00A is a three-position 5.08mm candidate. Verify full drawing, pin diameter, body/entry direction and ratings against the Phoenix footprint before substituting. https://www.lcsc.com/product-detail/C72334.html
SW201,SW202,SW203,SW204,SW205 | C110221 | Shikues 1N4148WS diode | OMRON B3U-1000P pushbutton | The diode is not a pushbutton despite the BOM Comment and Footprint labels. | https://www.lcsc.com/product-detail/C110221.html | C231329 is listed as OMRON B3U-1000P. https://www.lcsc.com/product-detail/C231329.html
