levdan159/abx-motion/design/rev-1.2-work-packages.csv

id | phase | title | model | reasoning_effort | depends_on | mode | scope | inputs | deliverables | pass_criteria | starting_context_target_tokens | status | prompt_path | shared_context_path | result_schema_path | estimated_shared_plus_prompt_tokens
1.1 | 1 | Live baseline and compact context | gpt-6.1-sol | low |  | read-only CAD / write reports | Snapshot current root hashes; export fresh ERC/DRC/parity/netlist and footprint/pad/stackup summaries without changing CAD. Inspect helper scripts before use; adapt stale wrappers in an isolated validation project. | Root native project; completion plan; latest layout review | state.json; baseline reports; context.txt; file-index.csv | Fresh reports identify their exact input hashes; root source unchanged; prior drafts not promoted. | 3-6k | PLANNED | design/rev-1.2-execution-contexts/1.1-live-baseline-and-compact-context.txt | design/rev-1.2-execution-contexts/00-project-context.txt | design/rev-1.2-execution-contexts/result.schema.json | 3436
1.2 | 1 | Primary-source component evidence | gpt-6-luna | medium | 1.1 | read-only research | Extract exact selected-part limits and package drawings by component family. Record tables/pages/conditions and source hashes; do not choose substitutes or infer ratings from headlines. | 1.1 inventory; TI DDWR and selected Q1/regulator/connector/relay datasheets | component-evidence.csv; source index | Every numerical limit has units, conditions, exact MPN/package and primary-source location; missing data explicit. | 3-6k per family | PLANNED | design/rev-1.2-execution-contexts/1.2-primary-source-component-evidence.txt | design/rev-1.2-execution-contexts/00-project-context.txt | design/rev-1.2-execution-contexts/result.schema.json | 3048
1.3 | 1 | As-built pin and connector maps | gpt-6.1-sol | low | 1.1 | read-only CAD / write reports | Derive GPIO, expander addresses/bits, connector pins and schematic-to-PCB mappings using deterministic extraction. Include the proposed Z mapping separately from current hardware. | 1.1 exports; authoritative root schematics | pinmap.csv; connector-map.csv; discrepancy list | Maps reconcile fresh netlist and PCB pads; no invented or stale StepStick mappings. | 3-6k | PLANNED | design/rev-1.2-execution-contexts/1.3-as-built-pin-and-connector-maps.txt | design/rev-1.2-execution-contexts/00-project-context.txt | design/rev-1.2-execution-contexts/result.schema.json | 2969
1.4 | 1 | Reset and inhibit behavior | gpt-6.1-sol | high | 1.2;1.3 | analysis | Audit cold/warm boot, power-domain sequencing, E-stop, watchdog, expander retained state, faults, missing jumpers and re-arm behavior; distinguish DC brake and high-Z states. | Relevant schematic slices; 1.2 selected-device evidence; 1.3 map | truth-table.csv; timing targets; electrical issues | Every defined fault has a reasoned output state and recovery sequence tied to actual pins and component behavior. | 6-12k | PLANNED | design/rev-1.2-execution-contexts/1.4-reset-and-inhibit-behavior.txt | design/rev-1.2-execution-contexts/00-project-context.txt | design/rev-1.2-execution-contexts/result.schema.json | 3101
1.5 | 1 | Power path and protection budget | gpt-6.1-sol | high | 1.2;1.3 | analysis | Calculate STEPPER_ONLY and COMBINED input/component currents, Q1 and regulator dissipation, fuse/connector/copper limits and bounded return-energy envelope. Include radio/peripheral loads and tolerances. | Relevant power/DC schematics; geometry extracts; 1.2 evidence | power-budget.csv; protection-envelope.txt; reproducible calculations | No battery/phase-current conflation; margins and unknown motor/BMS properties explicit; failed budget is an issue rather than a cooling assumption. | 6-12k | PLANNED | design/rev-1.2-execution-contexts/1.5-power-path-and-protection-budget.txt | design/rev-1.2-execution-contexts/00-project-context.txt | design/rev-1.2-execution-contexts/result.schema.json | 3143
1.6 | 1 | Driver and board thermal model | gpt-6.1-sol | high | 1.2;1.5 | analysis | Calculate 2/3/3.5 A RMS driver losses and thermal paths, shared heating, actual 1 oz baseline and candidate 2 oz/via options. Include PCB resistance between exposed pad and underside sink. | Selected DDWR data; 1.1 geometry; 1.5 loads; thermal construction evidence | thermal-model script/results; heat map; sink/interface requirements | Source-backed units and hot losses; sensitivity/uncertainty; both profiles; 40 C ambient and proposed <=125 C driver-junction target checked. | 6-12k | PLANNED | design/rev-1.2-execution-contexts/1.6-driver-and-board-thermal-model.txt | design/rev-1.2-execution-contexts/00-project-context.txt | design/rev-1.2-execution-contexts/result.schema.json | 3201
1.7 | 1 | Independent electrical and thermal gate | gpt-6-astra | medium | 1.4;1.5;1.6 | independent review | Challenge coupled assumptions in the circuit, load budget, fault behavior and thermal model. Recompute representative cases and inspect source evidence independently. No CAD edits. | Frozen phase-1 evidence pack plus selected original source/schematic excerpts | phase-1-review.txt; approved decisions and issue owners | No unresolved electrical/protection/thermal blocker; unmeasured claims and unresolved requirements remain explicit. Stop for user review. | 8-16k | PLANNED | design/rev-1.2-execution-contexts/1.7-independent-electrical-and-thermal-gate.txt | design/rev-1.2-execution-contexts/00-project-context.txt | design/rev-1.2-execution-contexts/result.schema.json | 3186
2.1 | 2 | Z-limit schematic and placement | gpt-6.1-sol | medium | 1.7 | single CAD writer | Add J607 and matching two 4.7k/two 1k/two 10nF network using U704.19/.20; move existing connector bank down nominally 10.5 mm and add top connector. Validate isolated draft against live source before reuse. | Accepted phase-1 pin map; local bank/OLED geometry; current root | Root CAD delta; fresh netlist; placement views | Existing pin functions retained; correct Z mappings; actual courtyard/edge/OLED/cable checks; only declared schematic changes. | 5-9k | PLANNED | design/rev-1.2-execution-contexts/2.1-z-limit-schematic-and-placement.txt | design/rev-1.2-execution-contexts/00-project-context.txt | design/rev-1.2-execution-contexts/result.schema.json | 3202
2.2 | 2 | Reconnect moved bank and Z inputs | gpt-6.1-sol | medium | 2.1 | single CAD writer | Route the moved connectors and new conditioning/network locally. Preserve existing input/output contracts, ground reference and power copper. | 2.1 local geometry/netlist; exact before snapshot; approved routing constraints | Root routing delta; local connectivity report | All new and moved-bank pad groups connected; no accidental pad/via net reassignment or unrelated lost groups. | 5-9k | PLANNED | design/rev-1.2-execution-contexts/2.2-reconnect-moved-bank-and-z-inputs.txt | design/rev-1.2-execution-contexts/00-project-context.txt | design/rev-1.2-execution-contexts/result.schema.json | 3051
2.3 | 2 | U702 sleep-pin escape | gpt-6.1-sol | medium | 2.2 | single CAD writer | Close AX2_SLEEP_N using actual connected anchors. Preserve charge-pump loop; use bounded local R721/ENABLE-fanout adjustment only if needed. | Fresh target-net components; U702 local F/B/In2 plots; R721 candidate | Route delta; DRC and before/after local view | Target net closed without sacrificing power/thermal/charge-pump geometry; stopped searches report obstacle geometry. | 4-8k | PLANNED | design/rev-1.2-execution-contexts/2.3-u702-sleep-pin-escape.txt | design/rev-1.2-execution-contexts/00-project-context.txt | design/rev-1.2-execution-contexts/result.schema.json | 3014
2.4 | 2 | Close CS and E-stop-feed gaps | gpt-6.1-sol | medium | 2.3 | single CAD writer | Route AX3_CS_N and +3V3_DRV_EN as two sequential net-specific substeps. Validate each before proceeding; the latter is the E-stop-derived logic feed. | Fresh connected-anchor reports and local corridors; phase-1 maps | Two route deltas; current connectivity/DRC | Both gaps closed; correct logical topology retained; no signal use of In1 ground layer or reserved heat-contact areas. | 4-8k per net | PLANNED | design/rev-1.2-execution-contexts/2.4-close-cs-and-e-stop-feed-gaps.txt | design/rev-1.2-execution-contexts/00-project-context.txt | design/rev-1.2-execution-contexts/result.schema.json | 2959
2.5 | 2 | DVDD loops and signal cleanup | gpt-6.1-sol | medium | 2.4 | single CAD writer | Trial in-place capacitor flips and shorter supply/return loops; retire only proven orphan stubs and redundant signal geometry. Keep intentional current and thermal structures. | Local capacitor/return geometry; raw warning items; phase-1 thermal constraints | Geometry delta; retained-connected-group audit | Every retained change has an actual loop/routing benefit; no blanket deletion of dangling-warning items. | 4-8k | PLANNED | design/rev-1.2-execution-contexts/2.5-dvdd-loops-and-signal-cleanup.txt | design/rev-1.2-execution-contexts/00-project-context.txt | design/rev-1.2-execution-contexts/result.schema.json | 3040
2.6 | 2 | Silkscreen and connector legends | gpt-6.1-sol | low | 2.5 | single CAD writer | Apply prescribed front/back reference/function/pin labels for the shifted bank and J607; resolve identified overlaps without altering copper. | Accepted connector map; actual footprint views; exact label issues | Root label-only delta; front/back plots | Correct physical pin positions on both faces; readable assembled labels; copper/net geometry unchanged. | 3-6k | PLANNED | design/rev-1.2-execution-contexts/2.6-silkscreen-and-connector-legends.txt | design/rev-1.2-execution-contexts/00-project-context.txt | design/rev-1.2-execution-contexts/result.schema.json | 2939
2.7 | 2 | Layout regression review | gpt-6.1-sol | high | 2.6 | independent review | Run fresh refill/ERC/DRC/parity and compare all old pad groups, allowed net changes, critical copper and new via-drill clearances. Review warning dispositions and actual layout. | Fresh root and before state; change manifest; official pin evidence | Phase-2 audit; issue list; final native previews | Zero opens and unexplained errors; no parity mismatch or unapproved topology/copper loss. Stop for user review. | 6-12k | PLANNED | design/rev-1.2-execution-contexts/2.7-layout-regression-review.txt | design/rev-1.2-execution-contexts/00-project-context.txt | design/rev-1.2-execution-contexts/result.schema.json | 3097
3.1 | 3 | Exact sourcing evidence | gpt-6-luna | medium | 1.7 | read-only research | Collect exact availability/drawings for selected MPNs, capacitor dimensions/ripple, harness contacts, relay holes, OLED stack, TIM and heatsink candidates. Report gaps; no substitution approval. | Approved MPN list; supplier sources; mechanical envelope | sourcing.csv; numbered-pad/dimension evidence | Every candidate exact variant and source/date recorded; no misleading stock equivalence or package assumptions. | 3-6k per family | PLANNED | design/rev-1.2-execution-contexts/3.1-exact-sourcing-evidence.txt | design/rev-1.2-execution-contexts/00-project-context.txt | design/rev-1.2-execution-contexts/result.schema.json | 2969
3.2 | 3 | Passive heatsink assembly | gpt-6.1-sol | high | 2.7;3.1 | analysis / mechanical design | Choose dimensioned common or individual underside cooling from the thermal budget. Specify TIM, insulation, support, flatness, compression and natural-convection conditions; check cable/solder-tail/antenna access. | 1.6 thermal model; current geometry; 3.1 parts evidence | Cooling/assembly drawing; thermal-resistance allocation; exact parts | Buildable fit with mechanical tolerances, no board bow or live-copper contact, thermal coupling accounted for. | 6-12k | PLANNED | design/rev-1.2-execution-contexts/3.2-passive-heatsink-assembly.txt | design/rev-1.2-execution-contexts/00-project-context.txt | design/rev-1.2-execution-contexts/result.schema.json | 3153
3.3 | 3 | Thermal copper and fabrication construction | gpt-6.1-sol | high | 3.2 | single CAD writer | Implement only justified local GND/via/mask/paste or stackup changes. Validate fabricator limits for chosen copper and fine pitch; reconcile actual PowerPAD solder/via process. | 3.2 drawings; 1.6 calculations; exact fab/assembler process evidence | Root thermal delta; mask/paste views; fabrication notes; repeated DRC/parity | Quantified heat-path improvement; preserved intended return paths and nets; supported assembly process; no new routing regression. | 6-12k | PLANNED | design/rev-1.2-execution-contexts/3.3-thermal-copper-and-fabrication-construction.txt | design/rev-1.2-execution-contexts/00-project-context.txt | design/rev-1.2-execution-contexts/result.schema.json | 3152
3.4 | 3 | Mechanical and procurement freeze | gpt-6.1-sol | medium | 3.3 | review / documentation | Reconcile final mechanical stack, exact BOM, hand-fit/DNP decisions and all phase-3 CAD changes. Independently check relay pad mapping and post-thermal geometry. | 3.1-3.3 evidence; fresh native checks | Phase-3 BOM/drawings/audit; closed exceptions | No critical mechanical/part/process unknown; phases 2 and 3 remain electrically consistent. Stop for user review. | 5-9k | PLANNED | design/rev-1.2-execution-contexts/3.4-mechanical-and-procurement-freeze.txt | design/rev-1.2-execution-contexts/00-project-context.txt | design/rev-1.2-execution-contexts/result.schema.json | 3061
4.1 | 4 | Firmware board definition and diagnostics skeleton | gpt-6.1-sol | low | 1.7 | firmware writer | Create explicit versioned GPIO/expander/connector definitions and buildable diagnostic scaffolding from approved maps; no guessed hardware allocation. | Approved 1.3 map; selected toolchain documents | Firmware build; board definitions; map consistency check | Build reproducible; definitions match source-reviewed pin map, including Z bits; no motor-arm logic enabled by scaffolding. | 4-8k | PLANNED | design/rev-1.2-execution-contexts/4.1-firmware-board-definition-and-diagnostics-skeleton.txt | design/rev-1.2-execution-contexts/00-project-context.txt | design/rev-1.2-execution-contexts/result.schema.json | 3065
4.2 | 4 | Arming, watchdog and latched faults | gpt-6.1-sol | high | 4.1 | firmware writer | Implement reviewed state machine, warm-reset handling, safe expander sequencing, verified configuration and progress-based watchdog; define safe stop/re-arm actions. | 1.4 state/timing specification; board definitions | State-machine firmware; representative fault/sequence tests | Behavior matches 1.4 truth table; failure cannot silently arm/restart; logical tests distinguished from physical measurements. | 6-12k | PLANNED | design/rev-1.2-execution-contexts/4.2-arming-watchdog-and-latched-faults.txt | design/rev-1.2-execution-contexts/00-project-context.txt | design/rev-1.2-execution-contexts/result.schema.json | 3104
4.3 | 4 | Hardware pulse generation and motion bounds | gpt-6.1-sol | medium | 4.2 | firmware writer | Implement synchronized STEP/DIR timing with appropriate hardware peripherals; acceleration, buffer-underrun and bounded-command handling. | Selected ESP-IDF primary docs; timing contract; 4.2 API | Motion module; timing tests; expected scope traces | No I2C-generated pulse train; DIR/pulse timings respect device data; failure/underrun follows accepted inhibit policy. | 5-9k | PLANNED | design/rev-1.2-execution-contexts/4.3-hardware-pulse-generation-and-motion-bounds.txt | design/rev-1.2-execution-contexts/00-project-context.txt | design/rev-1.2-execution-contexts/result.schema.json | 3008
4.4 | 4 | Limits and onboard/external modes | gpt-6.1-sol | medium | 4.3 | firmware writer | Implement all limit/encoder checks and controlled retreat; axis mode selection and external interface profiles; no armed mode change. | Approved connector map; 4.2-4.3 interfaces | I/O/mode module; simulated limit/mode tests | Existing DC/X/Y mapping retained; Z works logically; EXT remains ESP-controlled; mode transitions are defined and bounded. | 4-8k | PLANNED | design/rev-1.2-execution-contexts/4.4-limits-and-onboard-external-modes.txt | design/rev-1.2-execution-contexts/00-project-context.txt | design/rev-1.2-execution-contexts/result.schema.json | 3061
4.5 | 4 | Operating profiles, telemetry and calibration | gpt-6.1-sol | medium | 4.4 | firmware writer | Implement STEPPER_ONLY/COMBINED ceilings, DC burst limits, readback, fault/OT reporting, timestamped logs and versioned calibration/configuration integrity. | Approved power/thermal ceilings; telemetry scale/error model | Profile/diagnostic firmware; schema and decoder; calibration commands | No unqualified setting enabled by default; DC commands locked off in stepper-only mode; measurements distinguish inferred/set/observed quantities. | 5-9k | PLANNED | design/rev-1.2-execution-contexts/4.5-operating-profiles-telemetry-and-calibration.txt | design/rev-1.2-execution-contexts/00-project-context.txt | design/rev-1.2-execution-contexts/result.schema.json | 3141
4.6 | 4 | Firmware integration gate | gpt-6.1-sol | high | 4.5;3.4 | independent review | Review reset/fault/timing/profile interactions against final hardware; run meaningful host tests and build checks; define unrun hardware tests. | Final board definition; source modules; independent requirements/test mapping | Phase-4 review; build artifacts; test map | Every safety/timing requirement mapped to a check; firmware ready for controlled commissioning. Stop for user review. | 6-12k | PLANNED | design/rev-1.2-execution-contexts/4.6-firmware-integration-gate.txt | design/rev-1.2-execution-contexts/00-project-context.txt | design/rev-1.2-execution-contexts/result.schema.json | 3091
5.1 | 5 | Reproducible first-article export | gpt-6.1-sol | low | 3.4;4.6 | exports only | Export matched CAM, BOM, CPL and assembly drawings from frozen native source with version/tool/hash manifest. Never rebuild CAD with legacy generators. | Frozen CAD; exact approved BOM; reviewed export commands | First-article candidate bundle; manifest; deterministic exporter | All outputs from same source revision; counts/references reconcile; originals/releases preserved. | 4-8k | PLANNED | design/rev-1.2-execution-contexts/5.1-reproducible-first-article-export.txt | design/rev-1.2-execution-contexts/00-project-context.txt | design/rev-1.2-execution-contexts/result.schema.json | 3083
5.2 | 5 | CAM, numbered-pad and assembly audit | gpt-6.1-sol | high | 5.1 | independent review | Check actual Gerbers/mask/paste/drills, layer stack, clearances, populated sides, every MPN pin1/polarity and CPL origin/rotation against supplier drawings and assembly preview. | 5.1 outputs; exact source drawings; current assembly preview | CAM/assembly audit with annotated evidence; dispositions | No unexplained orientation/package/process discrepancy; 3D model is not sole placement proof; heatsink/harness/fuse details included. | 6-12k | PLANNED | design/rev-1.2-execution-contexts/5.2-cam-numbered-pad-and-assembly-audit.txt | design/rev-1.2-execution-contexts/00-project-context.txt | design/rev-1.2-execution-contexts/result.schema.json | 3138
5.3 | 5 | Independent first-article release gate | gpt-6-astra | medium | 5.2 | independent review | Read actual source/output checks and challenge electrical, thermal and assembly consistency. Confirm test firmware/fixture readiness and list post-fabrication tests explicitly. | Compact accepted phase evidence; selected original CAD/CAM/source checks | Phase-5 first-article release recommendation; unresolved issues | Pre-fabrication blockers closed; no claims of powered qualification. Stop for user review; no order/upload/push by review alone. | 8-16k | PLANNED | design/rev-1.2-execution-contexts/5.3-independent-first-article-release-gate.txt | design/rev-1.2-execution-contexts/00-project-context.txt | design/rev-1.2-execution-contexts/result.schema.json | 3109
6.1 | 6 | Bench fixture and commissioning procedure | gpt-6.1-sol | medium | 5.3 | procedure design | Prepare intended-voltage energy-limited fixture, probe references, calibrated instruments, rail targets, scope setup, thermal sensors and step-by-step stop conditions. | Released hardware/firmware; power/protection envelope; available instruments | Fixture/procedure; expected observations; blank result sheets | Energy-return path defined before regeneration; no unjustified destructive short/reverse/hot-plug procedure; all readings attributable to a test setup. | 5-9k | PLANNED | design/rev-1.2-execution-contexts/6.1-bench-fixture-and-commissioning-procedure.txt | design/rev-1.2-execution-contexts/00-project-context.txt | design/rev-1.2-execution-contexts/result.schema.json | 3141
6.2 | 6 | First power and interface evidence | gpt-6.1-sol | medium | 6.1 | HUMAN BENCH + analysis | A human technician inspects assembly, powers at intended voltage and checks rails, USB/battery modes and all interfaces. Model reviews supplied measurements and photos. | Physical first article; technician readings and instruments; 6.1 procedure | Actual bench records; assembly and rail measurements; interface results | No unintended energization, cycling/backfeed or unexplained heat; failures investigated; missing physical evidence remains NOT RUN. | 4-8k per result set | PLANNED | design/rev-1.2-execution-contexts/6.2-first-power-and-interface-evidence.txt | design/rev-1.2-execution-contexts/00-project-context.txt | design/rev-1.2-execution-contexts/result.schema.json | 3063
6.3 | 6 | Fault timing and low-current motors | gpt-6.1-sol | medium | 6.2 | HUMAN BENCH + analysis | Human measures reset/E-stop/watchdog/config-failure behavior and one low-current motor per channel; model compares scope/current records with timing/behavior contract. | 6.2 passed setup; measured scope/current data; fault truth table | Fault/timing traces; low-current motor records; phase-6 report | Each expected state/timing verified; no unexpected restart; escalation to Sol High for ambiguous waveforms or contradictions. Stop for user review. | 5-9k per result set | PLANNED | design/rev-1.2-execution-contexts/6.3-fault-timing-and-low-current-motors.txt | design/rev-1.2-execution-contexts/00-project-context.txt | design/rev-1.2-execution-contexts/result.schema.json | 3116
7.1 | 7 | Qualification experiment design | gpt-6.1-sol | high | 6.3 | analysis | Freeze matrix for current, all-axis concurrency, hold/motion, ambient, heatsink orientation, DC duty, cables and calibration uncertainty. Define stop/acceptance criteria before testing. | Approved targets; actual parts/fixture; commissioning evidence | Qualification matrix; thermal/current uncertainty method; report templates | Tests isolate assumptions and cover both profiles; 3.5 A port tests excluded unless complete path specifications allow them. | 6-12k | PLANNED | design/rev-1.2-execution-contexts/7.1-qualification-experiment-design.txt | design/rev-1.2-execution-contexts/00-project-context.txt | design/rev-1.2-execution-contexts/result.schema.json | 3164
7.2 | 7 | Per-axis and all-axis thermal runs | gpt-6.1-sol | medium | 7.1 | HUMAN BENCH + analysis | Human performs progressive 2 A then allowed 3 A stepper-only tests, including hold and motion; model analyzes temperature/current/voltage trends and equilibrium. | 7.1 matrix; actual bench time-series and configuration | Raw logs; plots; measured margins and exceptions | Actual harness/heatsink/ambient documented; uncertainty included; proposed junction/connector limits met or current derated. | 4-8k per run family | PLANNED | design/rev-1.2-execution-contexts/7.2-per-axis-and-all-axis-thermal-runs.txt | design/rev-1.2-execution-contexts/00-project-context.txt | design/rev-1.2-execution-contexts/result.schema.json | 3072
7.3 | 7 | Combined loading and regenerative limits | gpt-6.1-sol | high | 7.2 | HUMAN BENCH + analysis | Human performs bounded DC bursts, combined profiles and defined stop/return-energy cases only with an adequate sink/fixture. Model reviews interacting input, switch-node and thermal evidence. | 7.1 matrix; protection envelope; human-supplied waveforms and signed-current data | Combined-load/current/VM traces; duty limits; fault/return-energy results | No transfer of stepper-only rating to combined use; transients/components inside reviewed limits; actual energy acceptance demonstrated. | 6-12k per run family | PLANNED | design/rev-1.2-execution-contexts/7.3-combined-loading-and-regenerative-limits.txt | design/rev-1.2-execution-contexts/00-project-context.txt | design/rev-1.2-execution-contexts/result.schema.json | 3132
7.4 | 7 | Derive validated limits and calibration | gpt-6.1-sol | high | 7.2;7.3 | analysis / bounded firmware update | Fit calibration with uncertainty; determine per-profile ratings and firmware ceilings from measurements; evaluate mixed-load acceptance run and unresolved failures. | Raw test data; computation scripts; independent requirements and pass criteria | Measured rating tables; calibration/error report; firmware-limit changes and retest scope | No extrapolation beyond evidence; limits trace to raw data; any hardware/firmware change gets affected checks repeated. Stop for user review. | 6-12k | PLANNED | design/rev-1.2-execution-contexts/7.4-derive-validated-limits-and-calibration.txt | design/rev-1.2-execution-contexts/00-project-context.txt | design/rev-1.2-execution-contexts/result.schema.json | 3150
8.1 | 8 | Instrument manual and unit records | gpt-6-luna | medium | 7.4 | documentation | Assemble user/service documentation from approved pin maps, mechanical drawings, validated rating/calibration tables and actual test records. Do not invent performance claims. | Only accepted phase outputs; approved documentation outline | Operating/service manual; quick start; unit record template | Every published rating maps to approved evidence; correct hardware/firmware/serial/recovery and thermal/harness requirements. | 4-8k | PLANNED | design/rev-1.2-execution-contexts/8.1-instrument-manual-and-unit-records.txt | design/rev-1.2-execution-contexts/00-project-context.txt | design/rev-1.2-execution-contexts/result.schema.json | 3077
8.2 | 8 | Reproduction and release archive | gpt-6.1-sol | low | 8.1 | packaging | Package exact CAD, dependencies, BOM/CPL/CAM, firmware/config/calibration schema and test references; verify manifests and reproduction instructions. | Accepted artifacts; deterministic export/build procedures | Release candidate archive; manifest; reproduction checklist | Artifacts reconcile their frozen revisions; no stale release files or unapproved upload/push; reproducibility checks pass. | 4-8k | PLANNED | design/rev-1.2-execution-contexts/8.2-reproduction-and-release-archive.txt | design/rev-1.2-execution-contexts/00-project-context.txt | design/rev-1.2-execution-contexts/result.schema.json | 3034
8.3 | 8 | Final evidence and traceability review | gpt-6.1-sol | high | 8.2 | independent review | Cross-check manual, firmware settings, hardware source, released manufacturing data and actual qualification evidence; ensure failures/deferred tests remain visible. | Release candidate; index of underlying evidence; sampled original records | Phase-8 final review and release recommendation | An outside engineer can reproduce/commission/diagnose from the package; all rating claims supported. Stop for user review. | 6-12k | PLANNED | design/rev-1.2-execution-contexts/8.3-final-evidence-and-traceability-review.txt | design/rev-1.2-execution-contexts/00-project-context.txt | design/rev-1.2-execution-contexts/result.schema.json | 3067
