levdan159/abx-motion/abx-motion.csv

Reference | Qty | Value | DNP | Exclude from BOM | Exclude from Board | Footprint | Datasheet
C1,C4,C6,C202,C203,C204,C209,C210,C211,C212,C213,C214,C302,C309,C402,C409 | 16 | 100nF |  |  |  | Capacitor_SMD:C_0603_1608Metric
C2,C3,C307,C308,C407,C408 | 6 | 4.7uF |  |  |  | Capacitor_SMD:C_1206_3216Metric
C5,C9,C301,C303,C304,C401,C403,C404 | 8 | 1uF |  |  |  | Capacitor_SMD:C_0603_1608Metric
C7,C8 | 2 | 22uF |  |  |  | Capacitor_SMD:C_1206_3216Metric
C10,C201 | 2 | 10uF |  |  |  | Capacitor_SMD:C_0805_2012Metric
C205,C206,C207,C208 | 4 | 1nF |  |  |  | Capacitor_SMD:C_0603_1608Metric
C305,C405 | 2 | 10nF |  |  |  | Capacitor_SMD:C_0603_1608Metric
C306,C406 | 2 | 220uF |  |  |  | Capacitor_SMD:CP_Elec_10x10.5
C310,C410 | 2 | 10nF |  |  |  | Capacitor_SMD:C_0805_2012Metric
C501,C502 | 2 | 100uF |  |  |  | Capacitor_SMD:CP_Elec_8x10.5
D1 | 1 | BZT52C12S |  |  |  | Diode_SMD:D_SOD-323
D2 | 1 | SMCJ33A |  |  |  | Diode_SMD:D_SMC
D201 | 1 | SMBJ6.5CA |  |  |  | Diode_SMD:D_SMB
D202 | 1 | B5819W |  |  |  | Diode_SMD:D_SOD-123
D501,D503 | 2 | 1N4148WS |  |  |  | Diode_SMD:D_SOD-323
D502,D504,LED_PWR_3V3_1,LED_PWR_5V1,LED_PWR_BATT1 | 5 | LED_GRN |  |  |  | LED_SMD:LED_0603_1608Metric
F1 | 1 | 25A |  |  |  | Fuse:Fuse_Blade_ATO_directSolder
H1,H2,H3,H4 | 4 | M3_Mount |  |  |  | MountingHole:MountingHole_3.2mm_M3_Pad_Via
J1 | 1 | XT60_BAT |  |  |  | Connector_AMASS:AMASS_XT60-M_1x02_P7.20mm_Vertical
J102 | 1 | E_STOP |  |  |  | TerminalBlock_Phoenix:TerminalBlock_Phoenix_MKDS-1,5-2-5.08_1x02_P5.08mm_Horizontal
J201 | 1 | USB-C |  |  |  | Connector_USB:USB_C_Receptacle_HRO_TYPE-C-31-M-12
J202 | 1 | ENC1_CONN |  |  |  | Connector_JST:JST_XH_B4B-XH-A_1x04_P2.50mm_Vertical
J203 | 1 | ENC2_CONN |  |  |  | Connector_JST:JST_XH_B4B-XH-A_1x04_P2.50mm_Vertical
J204 | 1 | CAN_TERM |  |  |  | Connector_PinHeader_2.54mm:PinHeader_1x02_P2.54mm_Vertical
J205 | 1 | CAN_BUS |  |  |  | TerminalBlock_Phoenix:TerminalBlock_Phoenix_MKDS-1,5-3-5.08_1x03_P5.08mm_Horizontal
J206 | 1 | RS485_TERM |  |  |  | Connector_PinHeader_2.54mm:PinHeader_1x02_P2.54mm_Vertical
J207 | 1 | RS485_BUS |  |  |  | TerminalBlock_Phoenix:TerminalBlock_Phoenix_MKDS-1,5-3-5.08_1x03_P5.08mm_Horizontal
J208 | 1 | OLED_I2C |  |  |  | Connector_PinSocket_2.54mm:PinSocket_1x04_P2.54mm_Vertical
J209 | 1 | I2C_EXP |  |  |  | Connector_JST:JST_XH_B4B-XH-A_1x04_P2.50mm_Vertical
J301,J401 | 2 | MOTOR_OUT |  |  |  | TerminalBlock_Phoenix:TerminalBlock_Phoenix_MKDS-1,5-2-5.08_1x02_P5.08mm_Horizontal
J501 | 1 | STEP1_MOTOR |  |  |  | Connector_JST:JST_XH_B4B-XH-A_1x04_P2.50mm_Vertical
J502 | 1 | STEP1_EXT |  |  |  | Connector_JST:JST_XH_B4B-XH-A_1x04_P2.50mm_Vertical
J503 | 1 | STEP2_MOTOR |  |  |  | Connector_JST:JST_XH_B4B-XH-A_1x04_P2.50mm_Vertical
J504 | 1 | STEP2_EXT |  |  |  | Connector_JST:JST_XH_B4B-XH-A_1x04_P2.50mm_Vertical
J505 | 1 | RELAY1_OUT |  |  |  | TerminalBlock_Phoenix:TerminalBlock_Phoenix_MKDS-1,5-3-5.08_1x03_P5.08mm_Horizontal
J506 | 1 | RELAY2_OUT |  |  |  | TerminalBlock_Phoenix:TerminalBlock_Phoenix_MKDS-1,5-3-5.08_1x03_P5.08mm_Horizontal
K501,K502 | 2 | G5LE-14-DC5 |  |  |  | Relay_THT:Relay_SPDT_Omron-G5LE-1
L1 | 1 | 15uH |  |  |  | Inductor_SMD:L_Bourns_SRP7028A_7.3x6.6mm
LED201 | 1 | LED_YEL_CAN |  |  |  | LED_SMD:LED_0603_1608Metric
LED202 | 1 | LED_YEL_485 |  |  |  | LED_SMD:LED_0603_1608Metric
LED203 | 1 | LED_BLU_STAT |  |  |  | LED_SMD:LED_0603_1608Metric
LED_FLT1,LED_FLT2 | 2 | LED_RED_FLT |  |  |  | LED_SMD:LED_0603_1608Metric
Q1 | 1 | AONS21357 |  |  |  | Package_TO_SOT_SMD:TDSON-8-1
Q301,Q302,Q303,Q304,Q401,Q402,Q403,Q404 | 8 | CSD18540Q5B |  |  |  | Package_TO_SOT_SMD:TDSON-8-1
Q501,Q502 | 2 | AO3400A |  |  |  | Package_TO_SOT_SMD:SOT-23
R1 | 1 | 47k |  |  |  | Resistor_SMD:R_0603_1608Metric
R2,R4 | 2 | 100k |  |  |  | Resistor_SMD:R_0603_1608Metric
R3,R6,R9,R203,R204,R205,R206,R207,R208,R209,R210,R222,R223,R227,R228,R229,R231,R232,R303,R403,R505,R506 | 22 | 10k |  |  |  | Resistor_SMD:R_0603_1608Metric
R5 | 1 | 24.9k |  |  |  | Resistor_SMD:R_0603_1608Metric
R7,R8,R212,R214,R216,R218,R220,R224,R230,R304,R311,R404,R411,R502,R504 | 15 | 1k |  |  |  | Resistor_SMD:R_0603_1608Metric
R201,R202 | 2 | 5.1k |  |  |  | Resistor_SMD:R_0603_1608Metric
R211,R213,R215,R217,R225,R226 | 6 | 4.7k |  |  |  | Resistor_SMD:R_0603_1608Metric
R219,R221 | 2 | 120 |  |  |  | Resistor_SMD:R_0603_1608Metric
R301,R401 | 2 | 18k |  |  |  | Resistor_SMD:R_0603_1608Metric
R302,R402 | 2 | 30k |  |  |  | Resistor_SMD:R_0603_1608Metric
R305,R306,R307,R308,R405,R406,R407,R408 | 8 | 10 |  |  |  | Resistor_SMD:R_0603_1608Metric
R309,R409 | 2 | 10m |  |  |  | Resistor_SMD:R_2512_6332Metric
R310,R410 | 2 | 10 |  |  |  | Resistor_SMD:R_0805_2012Metric
R501,R503 | 2 | 100 |  |  |  | Resistor_SMD:R_0603_1608Metric
SW201 | 1 | RESET |  |  |  | Button_Switch_SMD:SW_SPST_B3U-1000P
SW202 | 1 | BOOT |  |  |  | Button_Switch_SMD:SW_SPST_B3U-1000P
SW203 | 1 | BTN_BACK |  |  |  | Button_Switch_SMD:SW_SPST_B3U-1000P
SW204 | 1 | BTN_NEXT |  |  |  | Button_Switch_SMD:SW_SPST_B3U-1000P
SW205 | 1 | BTN_HOME |  |  |  | Button_Switch_SMD:SW_SPST_B3U-1000P
SW501,SW502 | 2 | MICROSTEP_CFG |  |  |  | Button_Switch_SMD:SW_DIP_SPSTx03_Slide_9.78x9.8mm_W8.61mm_P2.54mm
TP_3V3_1 | 1 | TP_3V3_1 |  |  |  | TestPoint:TestPoint_Pad_D1.5mm
TP_5V1 | 1 | TP_5V1 |  |  |  | TestPoint:TestPoint_Pad_D1.5mm
TP_BATT1 | 1 | TP_BATT1 |  |  |  | TestPoint:TestPoint_Pad_D1.5mm
TP_CS1,TP_CS2 | 2 | TP_CS |  |  |  | TestPoint:TestPoint_Pad_D1.5mm
TP_GND1 | 1 | TP_GND1 |  |  |  | TestPoint:TestPoint_Pad_D1.5mm
TP_GND2 | 1 | TP_GND2 |  |  |  | TestPoint:TestPoint_Pad_D1.5mm
U1 | 1 | LMR36520FADDA |  |  |  | Package_SO:Texas_HSOP-8-1EP_3.9x4.9mm_P1.27mm_ThermalVias
U2 | 1 | AP2112K-3.3 |  |  |  | Package_TO_SOT_SMD:SOT-23-5
U3 | 1 | ESP32-S3-WROOM-1 |  |  |  | RF_Module:ESP32-S3-WROOM-1
U4 | 1 | 74LVC14A |  |  |  | Package_SO:SOIC-14_3.9x8.7mm_P1.27mm
U201 | 1 | USBLC6-2SC6 |  |  |  | Package_TO_SOT_SMD:SOT-23-6
U202 | 1 | TCAN1042V-Q1 |  |  |  | Package_SO:SOIC-8_3.9x4.9mm_P1.27mm
U203 | 1 | MAX3485 |  |  |  | Package_SO:SOIC-8_3.9x4.9mm_P1.27mm
U301,U401 | 2 | DRV8701ERGER |  |  |  | Package_DFN_QFN:Texas_RGE0024C_VQFN-24-1EP_4x4mm_P0.5mm_EP2.1x2.1mm_ThermalVias
U501,U502 | 2 | StepStick_DRV8825 |  |  |  | Module:Pololu_Breakout-16_15.2x20.3mm
