levdan159/abx-motion/validation/jlc-review-20261019_143817/placement-review.csv

references | observation | current_cpl_rotation | required_action | confidence
U1 | Preview lead rows appear rotated 90 degrees relative to board pads. | 270 | Match actual supplier pin 1 and all lead positions to the PCB before selecting the corrected angle. | visual flag; exact correction not established
D2 | Preview diode is vertical while PCB lands are horizontal. | 270 | Rotate to align lands and verify cathode ends on +BATT (PCB pad 1); do not rely only on body outline. | visual flag; exact correction not established
SW501,SW502 | Preview switch orientation appears inconsistent with the two side rows of PCB pads. | 0 | Verify supplier pad numbering and switched pairs against board nets, then establish the per-part rotation. | visual flag; exact correction not established
U3 | Preview module appears translated relative to castellated PCB pads. | 0 | Align the supplier module land pattern with all side/bottom rows; confirm model centroid convention rather than changing PCB position. | visual flag; exact translation not established
J102,J301,J401,J202,J203,J209,J501,J502,J503,J504 | Connector body position needs supplier-model origin and pin-order verification; footprint anchor and pin-row midpoint differ. | part dependent | Match individual leads to holes and verify pin order/connector facing. A pad-average centroid is not universally the supplier-model body centroid. | requires model/drawing comparison
K501,K502 | BOM still names G5LE-14-DC5 but code C35449 selects Songle SRD-05VDC-SL-C. | 270 | Either source the named Omron relay or verify Songle coil/contact positions, hole spacing and ratings as a deliberate substitution. | supplier identity confirmed; substitution compatibility not signed off
