levdan159/abx-motion/design/thermal-rev1.2-20261023/filled-capped-vias.csv

ref | x_mm | y_mm | drill_mm | uuid | process
U701 | 89.4 | 124.1 | 0.3 | 01e62a76-96b3-4650-9e13-ecd90d6b0d5a | IPC-4761 Type VII resin filled, planarized, copper capped both faces
U701 | 85.75 | 123.0 | 0.25 | 1a3be12f-e983-4233-8366-f716ec11b351 | IPC-4761 Type VII resin filled, planarized, copper capped both faces
U701 | 86.6 | 125.7 | 0.3 | 1add6488-926d-40a2-9cd0-897c0e3d2895 | IPC-4761 Type VII resin filled, planarized, copper capped both faces
U701 | 88.58 | 125.35 | 0.3 | 2036bd23-f1d6-4bae-b232-1f82d0228789 | IPC-4761 Type VII resin filled, planarized, copper capped both faces
U701 | 86.6 | 127.3 | 0.3 | 20ce0355-86a6-4efe-899b-d611fa6a2ac5 | IPC-4761 Type VII resin filled, planarized, copper capped both faces
U701 | 90.25 | 130.0 | 0.25 | 2bf44e89-e2e1-4571-baae-ffad1e272bd7 | IPC-4761 Type VII resin filled, planarized, copper capped both faces
U701 | 88.0 | 121.7 | 0.3 | 5757cc4b-53c6-4f89-a2ac-07fea5fa7917 | IPC-4761 Type VII resin filled, planarized, copper capped both faces
U701 | 87.3 | 126.5 | 0.3 | 5e152323-78e1-4484-aadf-04d9f3926151 | IPC-4761 Type VII resin filled, planarized, copper capped both faces
U701 | 85.75 | 128.0 | 0.25 | 61480eb2-1cca-435a-8f56-ddfe677312a9 | IPC-4761 Type VII resin filled, planarized, copper capped both faces
U701 | 87.3 | 120.9 | 0.3 | 6313315d-b5ca-41b7-a13b-85c7dae96631 | IPC-4761 Type VII resin filled, planarized, copper capped both faces
U701 | 85.75 | 130.0 | 0.25 | 63aaf42c-fd7e-4963-aee0-278da318906b | IPC-4761 Type VII resin filled, planarized, copper capped both faces
U701 | 88.7 | 126.5 | 0.3 | 670507fe-faf6-4a27-b7aa-d0a9658b9d18 | IPC-4761 Type VII resin filled, planarized, copper capped both faces
U701 | 85.75 | 121.0 | 0.25 | 68401341-2d88-450e-bace-d53021dd02af | IPC-4761 Type VII resin filled, planarized, copper capped both faces
U701 | 88.7 | 123.3 | 0.3 | 6cfd1e69-7dc4-484b-aa2d-5f487df2c857 | IPC-4761 Type VII resin filled, planarized, copper capped both faces
U701 | 90.25 | 128.0 | 0.25 | 7dd4f469-17c3-4193-889e-5505dd8f2e5d | IPC-4761 Type VII resin filled, planarized, copper capped both faces
U701 | 85.75 | 119.0 | 0.25 | 88bf8180-ce02-47fe-8cfa-2544e4d7c3df | IPC-4761 Type VII resin filled, planarized, copper capped both faces
U701 | 90.25 | 119.0 | 0.25 | 8da82592-91c5-480f-b319-c7112c047455 | IPC-4761 Type VII resin filled, planarized, copper capped both faces
U701 | 90.25 | 121.0 | 0.25 | 96576bd7-cd5c-43bf-b3b2-a3880b4888f4 | IPC-4761 Type VII resin filled, planarized, copper capped both faces
U701 | 85.75 | 126.0 | 0.25 | a0089ad6-967f-4a25-b0cb-912e609abf6f | IPC-4761 Type VII resin filled, planarized, copper capped both faces
U701 | 90.25 | 126.0 | 0.25 | a8fb20ca-fb49-4e25-84d5-edc52af9ed6f | IPC-4761 Type VII resin filled, planarized, copper capped both faces
U701 | 89.4 | 127.3 | 0.3 | b0bcc4e6-90db-4c8a-b36e-ef993c05354e | IPC-4761 Type VII resin filled, planarized, copper capped both faces
U701 | 87.3 | 122.5 | 0.3 | b951c2c3-f200-4c51-ba20-9e5c8708560e | IPC-4761 Type VII resin filled, planarized, copper capped both faces
U701 | 88.0 | 128.1 | 0.3 | bdb6ebbb-554e-453b-91e7-82d32291d24a | IPC-4761 Type VII resin filled, planarized, copper capped both faces
U701 | 88.7 | 120.9 | 0.3 | ce73dc62-7ede-4376-9fa5-990dc886220c | IPC-4761 Type VII resin filled, planarized, copper capped both faces
U701 | 89.4 | 125.7 | 0.3 | d0d9588a-a008-401d-8222-8dbafb68eab9 | IPC-4761 Type VII resin filled, planarized, copper capped both faces
U701 | 89.4 | 121.7 | 0.3 | d79f7246-05a1-4395-8053-9e624e389a69 | IPC-4761 Type VII resin filled, planarized, copper capped both faces
U701 | 86.6 | 123.3 | 0.3 | daab00f8-b581-42f7-acec-b55e0eb1adcf | IPC-4761 Type VII resin filled, planarized, copper capped both faces
U701 | 86.6 | 121.7 | 0.3 | e47c69b5-3a51-4e0a-8979-74b1b131bd03 | IPC-4761 Type VII resin filled, planarized, copper capped both faces
U701 | 86.6 | 124.9 | 0.3 | e7b16013-a777-4f38-b7ed-a95264f38290 | IPC-4761 Type VII resin filled, planarized, copper capped both faces
U701 | 90.25 | 123.0 | 0.25 | f0772d97-9114-427c-9fa9-c58729e951e2 | IPC-4761 Type VII resin filled, planarized, copper capped both faces
U701 | 87.3 | 124.1 | 0.3 | ff2a0864-6759-45b1-9f3b-e73a58359cb4 | IPC-4761 Type VII resin filled, planarized, copper capped both faces
U702 | 108.7 | 122.5 | 0.3 | 0f072a1b-bd3b-4c71-ac8e-b8ec799120ec | IPC-4761 Type VII resin filled, planarized, copper capped both faces
U702 | 105.75 | 130.0 | 0.25 | 5326f27d-695c-4ff0-8dd3-ccac2e7d6db2 | IPC-4761 Type VII resin filled, planarized, copper capped both faces
U702 | 105.75 | 128.0 | 0.25 | 63c34d06-c3ed-4739-94aa-025d1fe6b161 | IPC-4761 Type VII resin filled, planarized, copper capped both faces
U702 | 105.75 | 121.0 | 0.25 | 6c0694e0-45ee-4719-9fc2-18899a1e5738 | IPC-4761 Type VII resin filled, planarized, copper capped both faces
U702 | 110.25 | 126.0 | 0.25 | 6e1bd0c2-9c4e-4f83-8797-a0ef9fad9ca9 | IPC-4761 Type VII resin filled, planarized, copper capped both faces
U702 | 107.3 | 125.7 | 0.3 | 7c0240f2-da2c-490c-b9bf-53dd91cce171 | IPC-4761 Type VII resin filled, planarized, copper capped both faces
U702 | 108.7 | 128.1 | 0.3 | 8eb32c1a-355f-4e02-bed5-7f1908cff583 | IPC-4761 Type VII resin filled, planarized, copper capped both faces
U702 | 106.6 | 125.7 | 0.3 | 925ff3d6-6df2-450d-bf9e-7014ef92588d | IPC-4761 Type VII resin filled, planarized, copper capped both faces
U702 | 110.25 | 128.0 | 0.25 | 9ddba233-4023-4dc8-9ad4-8b4003711378 | IPC-4761 Type VII resin filled, planarized, copper capped both faces
U702 | 105.75 | 119.0 | 0.25 | aaa25b8d-8613-48f5-b06a-bb9b3481ebc9 | IPC-4761 Type VII resin filled, planarized, copper capped both faces
U702 | 106.6 | 124.1 | 0.3 | ae758321-f0c3-4762-ab1c-64eea2815428 | IPC-4761 Type VII resin filled, planarized, copper capped both faces
U702 | 107.3 | 128.1 | 0.3 | b19eca7f-cde4-401d-9032-213133c8307a | IPC-4761 Type VII resin filled, planarized, copper capped both faces
U702 | 109.4 | 122.5 | 0.3 | b3ae7855-075a-45a9-93c1-365989b612c8 | IPC-4761 Type VII resin filled, planarized, copper capped both faces
U702 | 105.75 | 126.0 | 0.25 | bac43786-a38e-49da-942d-4bf049994546 | IPC-4761 Type VII resin filled, planarized, copper capped both faces
U702 | 106.6 | 128.1 | 0.3 | bcd81616-0f66-494c-aa98-c4fe5dd3f0e7 | IPC-4761 Type VII resin filled, planarized, copper capped both faces
U702 | 108.7 | 121.7 | 0.3 | bf4a63f6-5da4-466c-8541-790ef97589ce | IPC-4761 Type VII resin filled, planarized, copper capped both faces
U702 | 108.0 | 125.7 | 0.3 | c87bb3ba-47ba-487e-8637-ed1dfa9b190a | IPC-4761 Type VII resin filled, planarized, copper capped both faces
U702 | 108.7 | 125.7 | 0.3 | ca6486fe-7f3f-43f6-83f5-5c32c2ac7007 | IPC-4761 Type VII resin filled, planarized, copper capped both faces
U702 | 109.4 | 121.7 | 0.3 | cd756482-db26-4e0a-8680-1df0e9421683 | IPC-4761 Type VII resin filled, planarized, copper capped both faces
U702 | 105.75 | 123.0 | 0.25 | d2f0dfc2-bc1f-496b-ab4a-c5626938de74 | IPC-4761 Type VII resin filled, planarized, copper capped both faces
U702 | 108.0 | 128.1 | 0.3 | d735cc59-96a7-46a2-9bba-c15c45f4ce03 | IPC-4761 Type VII resin filled, planarized, copper capped both faces
U702 | 109.4 | 128.1 | 0.3 | d84bd03e-2b9f-423c-9fc5-b973d5fb2838 | IPC-4761 Type VII resin filled, planarized, copper capped both faces
U702 | 110.25 | 119.0 | 0.25 | dcffa748-67b2-48e6-8a4e-593f7b7176e9 | IPC-4761 Type VII resin filled, planarized, copper capped both faces
U702 | 108.0 | 121.7 | 0.3 | df3da924-83fa-4944-8b4d-b836d044960d | IPC-4761 Type VII resin filled, planarized, copper capped both faces
U702 | 110.25 | 123.0 | 0.25 | e20c8bff-a6a2-4875-a8d5-4fe3e7824121 | IPC-4761 Type VII resin filled, planarized, copper capped both faces
U702 | 109.4 | 125.7 | 0.3 | e8df0ea6-8db1-49d7-866c-9df65eea00b3 | IPC-4761 Type VII resin filled, planarized, copper capped both faces
U702 | 110.25 | 130.0 | 0.25 | ed43818f-1bf1-44f0-90e0-20c453ba7033 | IPC-4761 Type VII resin filled, planarized, copper capped both faces
U702 | 110.25 | 121.0 | 0.25 | f005a261-f375-42f3-8885-4669e542f5e7 | IPC-4761 Type VII resin filled, planarized, copper capped both faces
U703 | 126.6 | 121.7 | 0.3 | 17a0f3b3-0a6e-48d8-93a5-2905a185a645 | IPC-4761 Type VII resin filled, planarized, copper capped both faces
U703 | 128.699999 | 126.5 | 0.3 | 193af8ba-d896-4dba-94f9-4d31787d3f35 | IPC-4761 Type VII resin filled, planarized, copper capped both faces
U703 | 125.75 | 128.0 | 0.25 | 2898b920-dd1f-4f1f-baeb-da3bd06c41cc | IPC-4761 Type VII resin filled, planarized, copper capped both faces
U703 | 126.6 | 124.1 | 0.3 | 2d7b729c-de9b-4b02-a58f-9a272a4999bb | IPC-4761 Type VII resin filled, planarized, copper capped both faces
U703 | 128.0 | 124.1 | 0.3 | 2fa8dc8a-15be-481d-a567-5b839f578f69 | IPC-4761 Type VII resin filled, planarized, copper capped both faces
U703 | 129.4 | 127.3 | 0.3 | 37c13139-fc1c-4f8a-8259-687d61a43b09 | IPC-4761 Type VII resin filled, planarized, copper capped both faces
U703 | 128.699999 | 120.9 | 0.3 | 43025e0c-0e25-4d81-bfa3-026b26c44a22 | IPC-4761 Type VII resin filled, planarized, copper capped both faces
U703 | 129.4 | 124.1 | 0.3 | 4d03013c-da72-4c38-9a08-ae0cda4d5baf | IPC-4761 Type VII resin filled, planarized, copper capped both faces
U703 | 125.75 | 126.0 | 0.25 | 4fa33f5a-58d9-44eb-8cd0-c4f31c4213ee | IPC-4761 Type VII resin filled, planarized, copper capped both faces
U703 | 130.25 | 130.0 | 0.25 | 588d90a1-4c47-4a3e-a033-8154630e6bc8 | IPC-4761 Type VII resin filled, planarized, copper capped both faces
U703 | 127.3 | 123.3 | 0.3 | 5c6d3783-24a6-4062-b286-28eb5014eb12 | IPC-4761 Type VII resin filled, planarized, copper capped both faces
U703 | 130.25 | 126.0 | 0.25 | 6f7cd730-343b-4dab-8266-7ae7bb10c88b | IPC-4761 Type VII resin filled, planarized, copper capped both faces
U703 | 129.4 | 126.5 | 0.3 | 7166dd6f-9ffd-4e66-9d5a-c619593f2fbc | IPC-4761 Type VII resin filled, planarized, copper capped both faces
U703 | 127.3 | 120.9 | 0.3 | 716fa699-34a8-4169-a6a6-a80ec572d017 | IPC-4761 Type VII resin filled, planarized, copper capped both faces
U703 | 129.4 | 123.3 | 0.3 | 73c6fce9-d8ec-4406-8b7e-075b4cc77a2d | IPC-4761 Type VII resin filled, planarized, copper capped both faces
U703 | 128.699999 | 123.3 | 0.3 | 801242d3-794d-46f0-92f2-ad0bac080010 | IPC-4761 Type VII resin filled, planarized, copper capped both faces
U703 | 130.25 | 123.0 | 0.25 | 8fe15afb-9157-451d-9537-e9671665fb75 | IPC-4761 Type VII resin filled, planarized, copper capped both faces
U703 | 128.0 | 127.3 | 0.3 | 92a20f65-9aad-47ea-afb5-22eadadf0fd3 | IPC-4761 Type VII resin filled, planarized, copper capped both faces
U703 | 126.6 | 127.3 | 0.3 | 94e107c4-7a07-493a-a99a-cd8803ac76b1 | IPC-4761 Type VII resin filled, planarized, copper capped both faces
U703 | 125.75 | 121.0 | 0.25 | 99e09d03-a1be-4278-bfaf-a8e32a3a64b1 | IPC-4761 Type VII resin filled, planarized, copper capped both faces
U703 | 125.75 | 130.0 | 0.25 | 99f34ae2-b331-4f76-84a8-adb1ac35acb8 | IPC-4761 Type VII resin filled, planarized, copper capped both faces
U703 | 130.25 | 128.0 | 0.25 | dc6d25bb-a262-412f-ae27-d3f94c86efa6 | IPC-4761 Type VII resin filled, planarized, copper capped both faces
U703 | 125.75 | 119.0 | 0.25 | e4e01ae3-bc97-4f14-a717-9a84c7d35d5d | IPC-4761 Type VII resin filled, planarized, copper capped both faces
U703 | 130.25 | 121.0 | 0.25 | eb2ee880-8db0-4eba-bc62-25f4a73700ca | IPC-4761 Type VII resin filled, planarized, copper capped both faces
U703 | 127.3 | 126.5 | 0.3 | ed6265e2-9f37-48b0-9370-c095f34737a5 | IPC-4761 Type VII resin filled, planarized, copper capped both faces
U703 | 130.25 | 119.0 | 0.25 | ee4261fa-344f-4588-adc0-c97da2d8a439 | IPC-4761 Type VII resin filled, planarized, copper capped both faces
U703 | 128.0 | 121.7 | 0.3 | eed77cb4-a09f-4127-a201-ca430e483f13 | IPC-4761 Type VII resin filled, planarized, copper capped both faces
U703 | 129.4 | 121.7 | 0.3 | efcd81b0-17d0-493c-9930-8c71c52e8b48 | IPC-4761 Type VII resin filled, planarized, copper capped both faces
U703 | 129.4 | 120.9 | 0.3 | f16be6df-01fb-4460-8e78-19b4e7bef828 | IPC-4761 Type VII resin filled, planarized, copper capped both faces
U703 | 125.75 | 123.0 | 0.25 | f2f84ec7-2b39-4ef6-b86a-bab6b02a420e | IPC-4761 Type VII resin filled, planarized, copper capped both faces
U3_EP41_THERMAL_HOLE | 98.1 | 61.76 | 0.3 | 1918edf4-e2c7-498e-af92-1023292fe677 | SELECTED MODULE EP THERMAL HOLE ONLY: resin fill + planarize + copper cap; not an insertion hole
U3_EP41_THERMAL_HOLE | 98.1 | 63.16 | 0.3 | 1c86b1dd-048c-495a-bb11-d2e46a1305e9 | SELECTED MODULE EP THERMAL HOLE ONLY: resin fill + planarize + copper cap; not an insertion hole
U3_EP41_THERMAL_HOLE | 98.8 | 61.06 | 0.3 | 11dbc1c1-feee-4d90-9524-8405e4780c39 | SELECTED MODULE EP THERMAL HOLE ONLY: resin fill + planarize + copper cap; not an insertion hole
U3_EP41_THERMAL_HOLE | 98.8 | 62.46 | 0.3 | 6afc1480-685d-4911-aa84-3bb07f2c065f | SELECTED MODULE EP THERMAL HOLE ONLY: resin fill + planarize + copper cap; not an insertion hole
U3_EP41_THERMAL_HOLE | 98.8 | 63.86 | 0.3 | 22422f42-81cd-476b-b07d-3ee31ec9e668 | SELECTED MODULE EP THERMAL HOLE ONLY: resin fill + planarize + copper cap; not an insertion hole
U3_EP41_THERMAL_HOLE | 99.5 | 61.76 | 0.3 | 8dba9169-fbe0-48ea-a52c-b067bfbdb25a | SELECTED MODULE EP THERMAL HOLE ONLY: resin fill + planarize + copper cap; not an insertion hole
U3_EP41_THERMAL_HOLE | 99.5 | 63.16 | 0.3 | e2c8e775-dd5e-45f3-805e-22efb75ffc2b | SELECTED MODULE EP THERMAL HOLE ONLY: resin fill + planarize + copper cap; not an insertion hole
U3_EP41_THERMAL_HOLE | 100.2 | 61.06 | 0.3 | a87be300-6335-4ae2-8188-da1bb99dfd70 | SELECTED MODULE EP THERMAL HOLE ONLY: resin fill + planarize + copper cap; not an insertion hole
U3_EP41_THERMAL_HOLE | 100.2 | 62.46 | 0.3 | f03fd1a3-510e-4034-b969-7292186c85b1 | SELECTED MODULE EP THERMAL HOLE ONLY: resin fill + planarize + copper cap; not an insertion hole
U3_EP41_THERMAL_HOLE | 100.2 | 63.86 | 0.3 | f403e7f4-2271-4a8b-b4d6-6fbe60341bae | SELECTED MODULE EP THERMAL HOLE ONLY: resin fill + planarize + copper cap; not an insertion hole
U3_EP41_THERMAL_HOLE | 100.9 | 61.76 | 0.3 | c23f4387-be08-4f53-adc1-655669f185ef | SELECTED MODULE EP THERMAL HOLE ONLY: resin fill + planarize + copper cap; not an insertion hole
U3_EP41_THERMAL_HOLE | 100.9 | 63.16 | 0.3 | 913a90a9-29e5-4c57-961a-bfd09e9f68b7 | SELECTED MODULE EP THERMAL HOLE ONLY: resin fill + planarize + copper cap; not an insertion hole
U2 | 135.6 | 79.0 | 0.3 | 53277dd0-e828-4dab-8d14-0410961239aa | IPC-4761 Type VII resin filled, planarized, copper capped both faces
U2 | 134.1 | 80.2 | 0.3 | 6250c222-097a-4df7-8151-9fc362f9abdc | IPC-4761 Type VII resin filled, planarized, copper capped both faces
U2 | 135.6 | 80.6 | 0.3 | 92528cda-7cdf-4f59-9d82-7229a40b1384 | IPC-4761 Type VII resin filled, planarized, copper capped both faces
