levdan159/abx-motion/work/rev-1.2-io-under-oled/review/placements-native.csv

Reference | X mm native | Y mm native | Rotation degrees native | Side | Value
C601 | 76.5 | 88.5 | -90.0 | Front | 100nF
C602 | 67.5 | 100.9 | 0.0 | Front | 10nF
C603 | 70.9 | 100.9 | 0.0 | Front | 10nF
C604 | 74.3 | 100.9 | 0.0 | Front | 10nF
C605 | 77.7 | 100.9 | 0.0 | Front | 10nF
C606 | 81.1 | 100.9 | 0.0 | Front | 10nF
C607 | 84.5 | 100.9 | 0.0 | Front | 10nF
C608 | 87.9 | 100.9 | 0.0 | Front | 10nF
C609 | 91.3 | 100.9 | 0.0 | Front | 10nF
D601 | 80.5 | 93.0 | 0.0 | Front | B5819W
D602 | 86.0 | 93.0 | 0.0 | Front | B5819W
F5 | 90.5 | 91.0 | 90.0 | Front | 1206L050/15YR
J208 | 75.69 | 81.5 | 90.0 | Front | OLED_I2C
J601 | 67.5 | 116.0 | 90.0 | Front | B3B-PH-K-S
J602 | 75.0 | 116.0 | 90.0 | Front | B3B-PH-K-S
J603 | 67.5 | 126.5 | 90.0 | Front | B3B-PH-K-S
J604 | 75.0 | 126.5 | 90.0 | Front | B3B-PH-K-S
J605 | 67.5 | 137.0 | 90.0 | Front | B3B-PH-K-S
J606 | 75.0 | 137.0 | 90.0 | Front | B3B-PH-K-S
Q601 | 80.0 | 89.0 | 0.0 | Front | AO3400A
Q602 | 85.5 | 89.0 | 0.0 | Front | AO3400A
R206 | 67.5 | 86.2 | 0.0 | Front | 10k
R601 | 67.5 | 97.1 | 0.0 | Front | 4.7k
R602 | 70.9 | 97.1 | 0.0 | Front | 4.7k
R603 | 74.3 | 97.1 | 0.0 | Front | 4.7k
R604 | 77.7 | 97.1 | 0.0 | Front | 4.7k
R605 | 81.1 | 97.1 | 0.0 | Front | 4.7k
R606 | 84.5 | 97.1 | 0.0 | Front | 4.7k
R607 | 87.9 | 97.1 | 0.0 | Front | 4.7k
R608 | 91.3 | 97.1 | 0.0 | Front | 4.7k
R609 | 67.5 | 99.0 | 180.0 | Front | 1k
R610 | 70.9 | 99.0 | 180.0 | Front | 1k
R611 | 74.3 | 99.0 | 180.0 | Front | 1k
R612 | 77.7 | 99.0 | 180.0 | Front | 1k
R613 | 81.1 | 99.0 | 180.0 | Front | 1k
R614 | 84.5 | 99.0 | 180.0 | Front | 1k
R615 | 87.9 | 99.0 | 180.0 | Front | 1k
R616 | 91.3 | 99.0 | 180.0 | Front | 1k
R617 | 77.7 | 86.2 | 0.0 | Front | 1k
R618 | 84.5 | 86.2 | 0.0 | Front | 1k
R619 | 81.1 | 86.2 | 0.0 | Front | 100
R620 | 87.9 | 86.2 | 0.0 | Front | 100
R621 | 70.9 | 86.2 | 0.0 | Front | 10k
R622 | 74.3 | 86.2 | 0.0 | Front | 10k
U601 | 71.5 | 91.5 | 0.0 | Front | PCA9555PW,118
