levdan159/abx-motion/production/rev-1.2a-20261023/assembly/supplier-C8465-entry.png

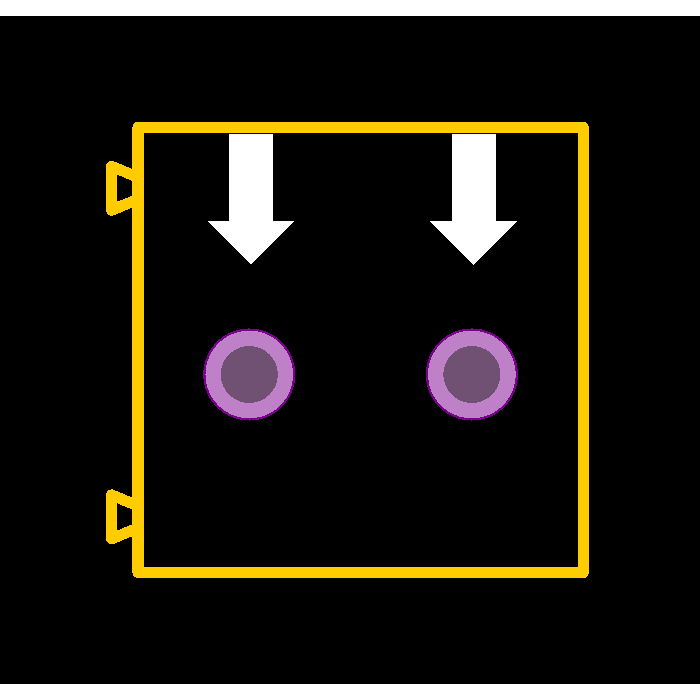
production/rev-1.2a-20261023/assembly/supplier-C8465-entry.png
