levdan159/abx-motion/production/rev-1.2a-20261023/assembly/supplier-C72334-entry.png

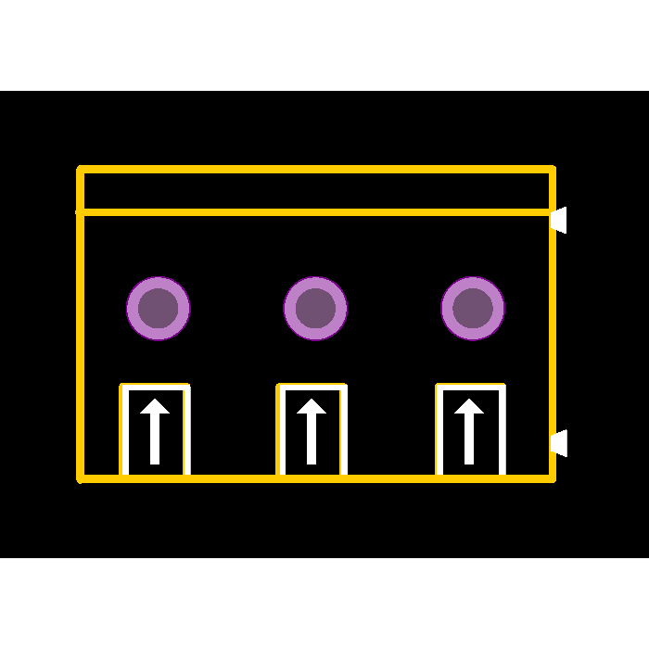
production/rev-1.2a-20261023/assembly/supplier-C72334-entry.png
