levdan159/abx-motion/production/rev-1.2a-20261023/assembly/supplier-polarity-and-keying.png

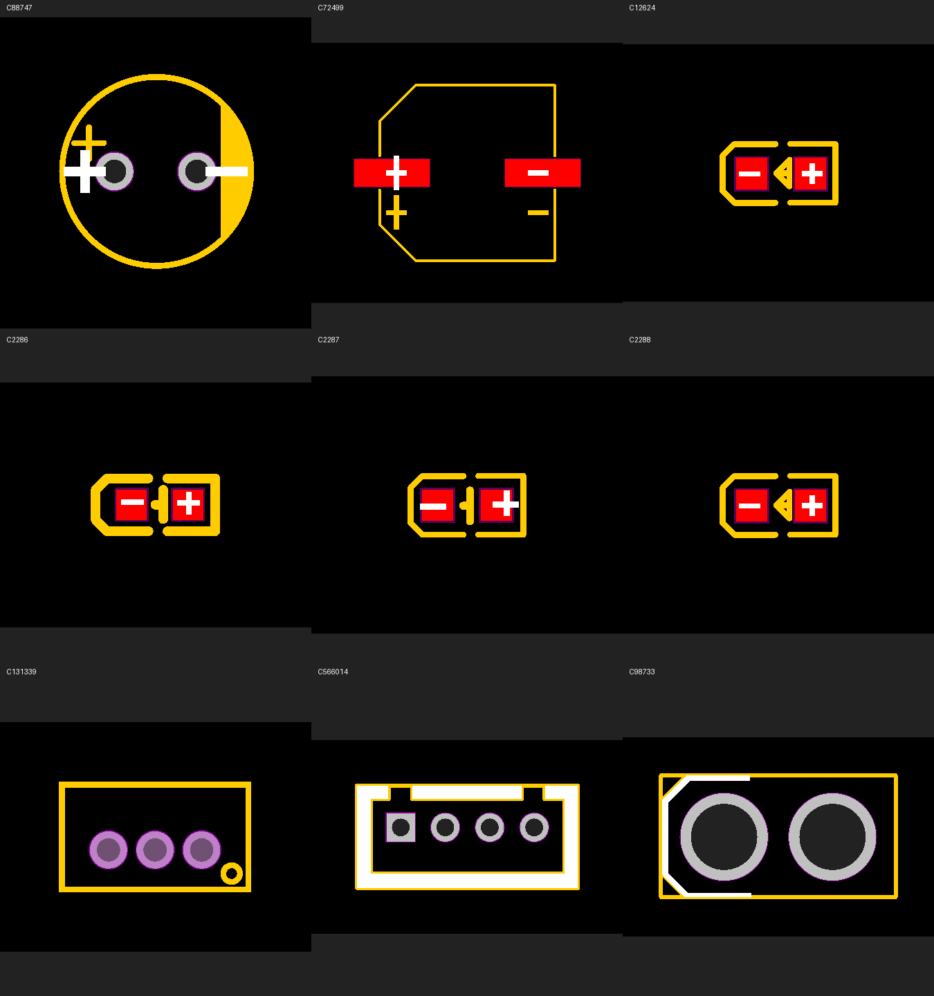
production/rev-1.2a-20261023/assembly/supplier-polarity-and-keying.png
