levdan159/abx-motion/design/thermal-rev1.2-20261023/HS1-machining-plan.dxf

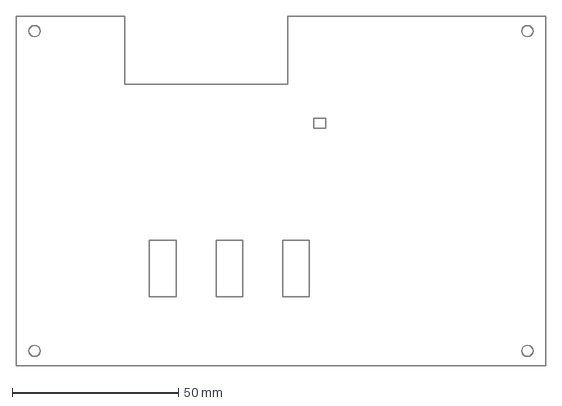
[picture p31: CAD file, 2026-10-23]
design/thermal-rev1.2-20261023/HS1-machining-plan.dxf
159.0 x 105.0 mm
