levdan159/abx-motion/variants/ABX-Motion-ETH/3dmodels/Fuseholder_Keystone_3557-2.step

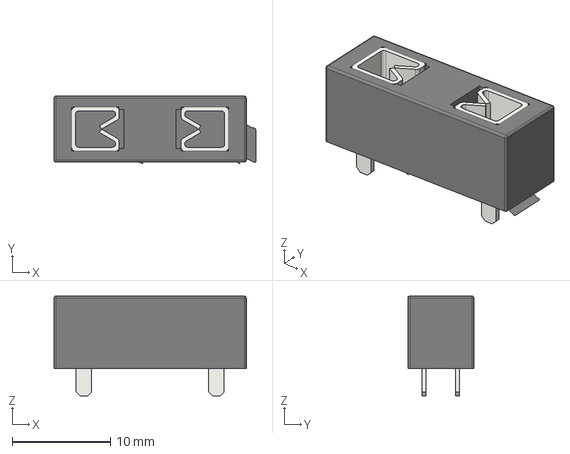
[picture p32: CAD file, 2026-10-19]
variants/ABX-Motion-ETH/3dmodels/Fuseholder_Keystone_3557-2.step
20.5 x 6.91 x 10.2 mm
