levdan159/abx-motion/variants/ABX-Motion-ETH/abx-3dmodels/DFN-8-1EP_3x3mm_P0.65mm_EP1.5x2.25mm.step

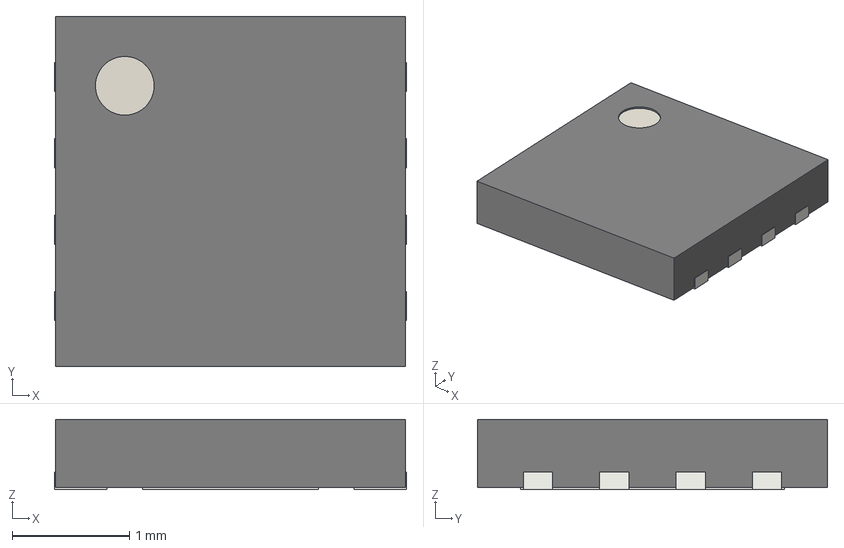
[picture p33: CAD file, 2026-10-23]
variants/ABX-Motion-ETH/abx-3dmodels/DFN-8-1EP_3x3mm_P0.65mm_EP1.5x2.25mm.step
3.00 x 2.98 x 0.6 mm
