levdan159/abx-motion/abx-3dmodels/ethernet/SOT-23-6.step

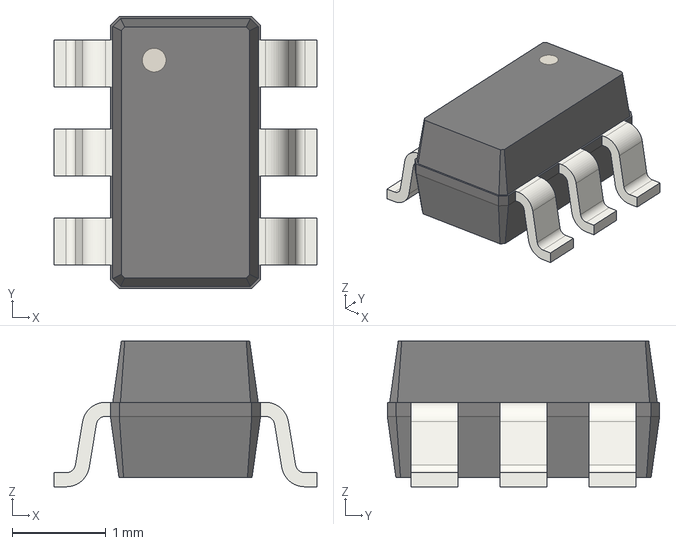
[picture p34: CAD file, 2026-10-24]
abx-3dmodels/ethernet/SOT-23-6.step
2.80 x 2.90 x 1.55 mm
