levdan159/abx-motion/abx-3dmodels/ethernet/C_0805_2012Metric.step

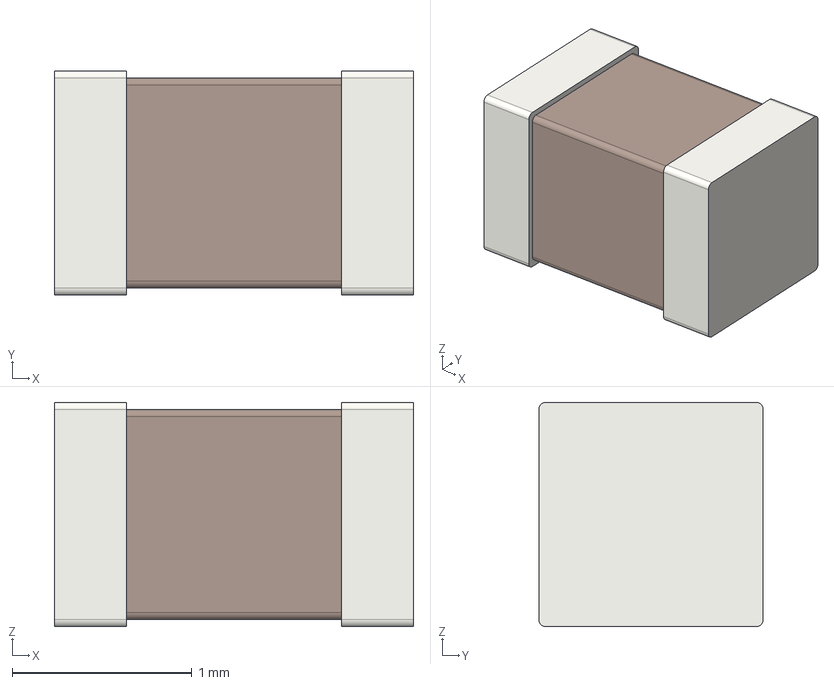
[picture p35: CAD file, 2026-10-24]
abx-3dmodels/ethernet/C_0805_2012Metric.step
2.00 x 1.25 x 1.25 mm
