levdan159/abx-motion/abx-3dmodels/ethernet/SOT-23.step

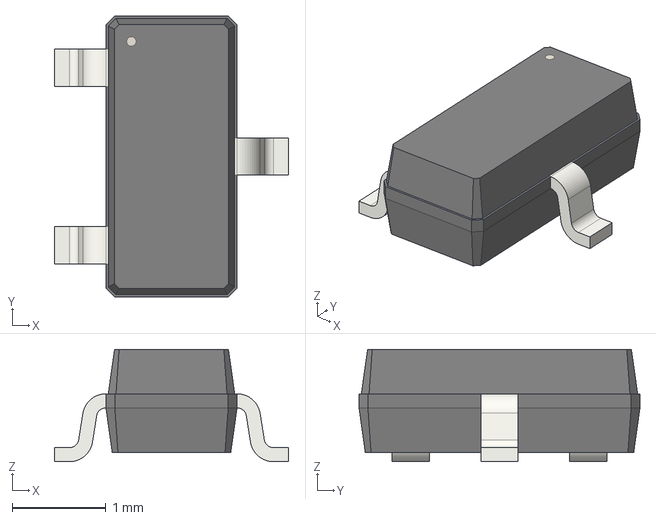
[picture p36: CAD file, 2026-10-24]
abx-3dmodels/ethernet/SOT-23.step
2.50 x 3.00 x 1.20 mm
