levdan159/abx-motion/abx-3dmodels/ethernet/L_0603_1608Metric.step

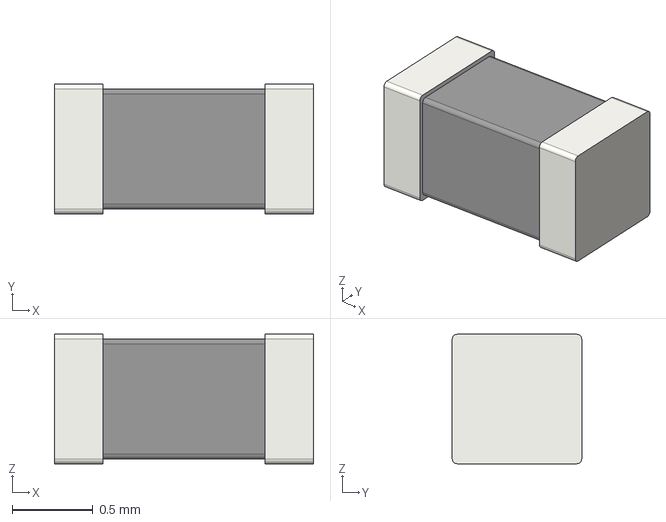
[picture p37: CAD file, 2026-10-24]
abx-3dmodels/ethernet/L_0603_1608Metric.step
1.60 x 0.8 x 0.8 mm
