levdan159/abx-motion/abx-3dmodels/ethernet/C_1206_3216Metric.step

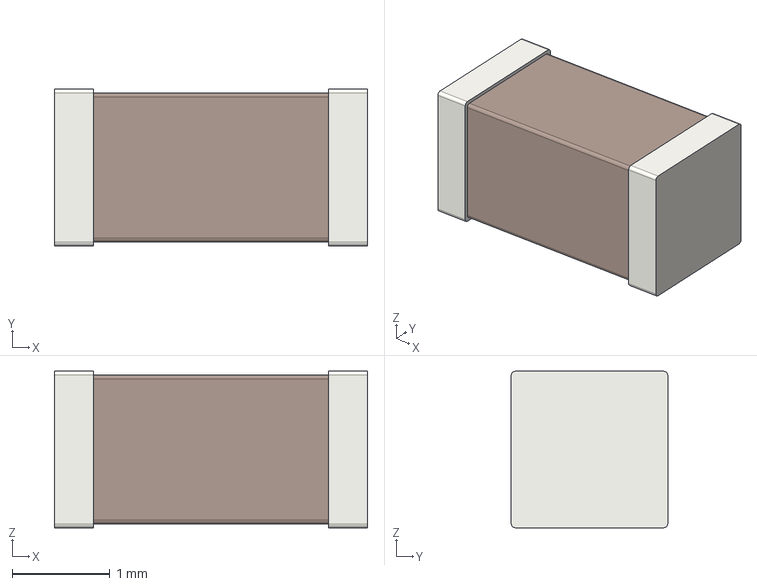
[picture p38: CAD file, 2026-10-24]
abx-3dmodels/ethernet/C_1206_3216Metric.step
3.20 x 1.60 x 1.60 mm
