levdan159/abx-motion/abx-3dmodels/ethernet/L_Sunlord_SWPA4030S.step

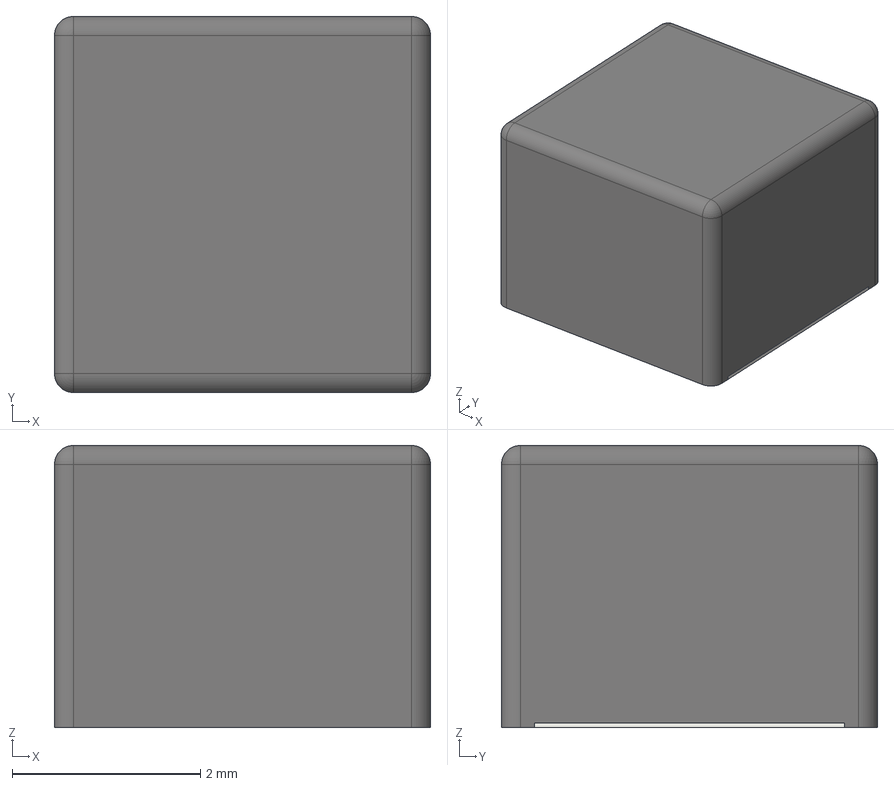
[picture p39: CAD file, 2026-10-24]
abx-3dmodels/ethernet/L_Sunlord_SWPA4030S.step
4.00 x 4.00 x 3.00 mm
a68460a4-8551-11ed-a139-00155d22e2d7_part
a684622a-8551-11ed-a139-00155d22e2d7_part
a68462b6-8551-11ed-a139-00155d22e2d7_part
