levdan159/abx-motion/abx-3dmodels/ethernet/R_0402_1005Metric.step

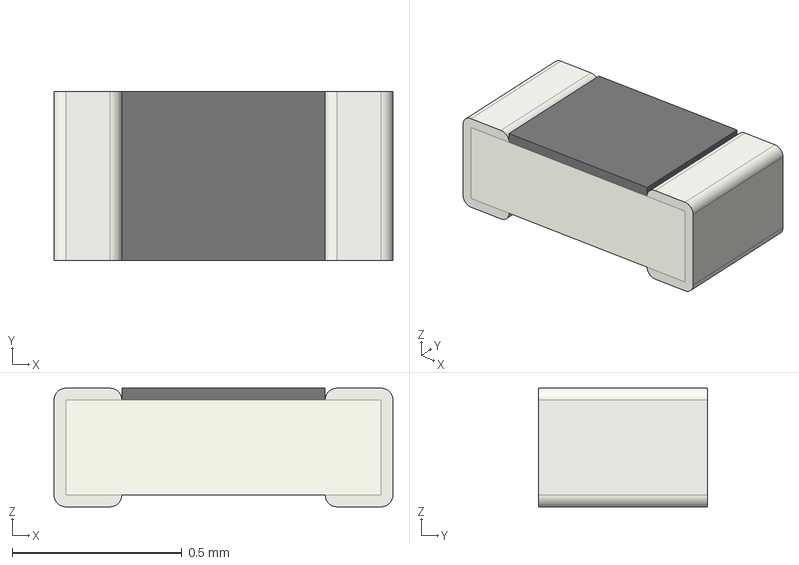
[picture p40: CAD file, 2026-10-24]
abx-3dmodels/ethernet/R_0402_1005Metric.step
1.00 x 0.5 x 0.35 mm
