levdan159/abx-motion/abx-3dmodels/ethernet/TSSOP-14_4.4x5mm_P0.65mm.step

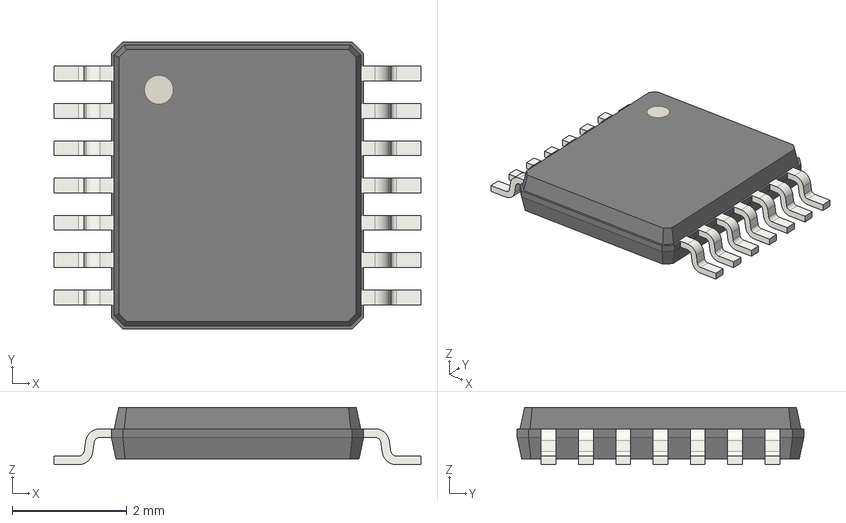
[picture p41: CAD file, 2026-10-24]
abx-3dmodels/ethernet/TSSOP-14_4.4x5mm_P0.65mm.step
6.40 x 5.00 x 1.00 mm
