levdan159/abx-motion/abx-3dmodels/ethernet/Crystal_SMD_3225-4Pin_3.2x2.5mm.step

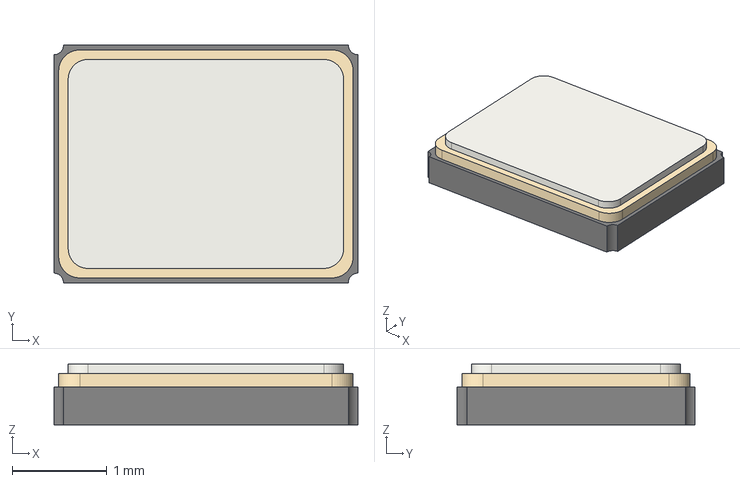
[picture p42: CAD file, 2026-10-24]
abx-3dmodels/ethernet/Crystal_SMD_3225-4Pin_3.2x2.5mm.step
3.20 x 2.50 x 0.64 mm
