levdan159/abx-motion/abx-3dmodels/ethernet/LQFP-48_7x7mm_P0.5mm.step

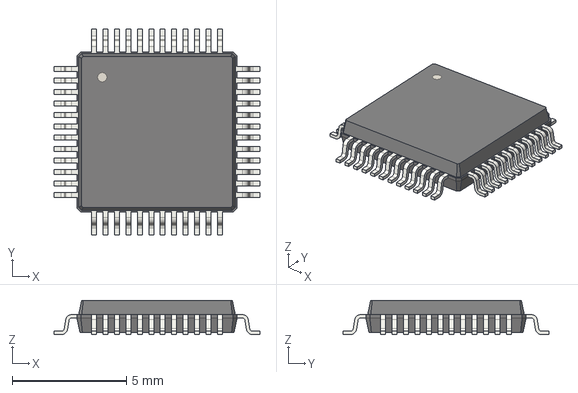
[picture p43: CAD file, 2026-10-24]
abx-3dmodels/ethernet/LQFP-48_7x7mm_P0.5mm.step
9.00 x 9.00 x 1.50 mm
