levdan159/abx-motion/(list of files, cad)

Other CAD files:
abx-3dmodels/ethernet/C_0603_1608Metric.step
