levdan159/abx-motion/production/assembly-audit-20261020/placement-overlays.html

# Supplier-to-PCB placement audit

239 placements / 66 SKUs. Gold = native PCB copper bounding boxes; blue = numbered supplier pad centers. This checks placement geometry, not load/thermal qualification. Relay supplier CAD is inconsistent with Omron: resolve assembler origin against the manufacturer drawing.

Same clockwise-screen transform for all parts: supplier SVG rotated by minus CPL angle.

Same clockwise-screen transform for all parts: supplier SVG rotated by minus CPL angle.

Same clockwise-screen transform for all parts: supplier SVG rotated by minus CPL angle.

Same clockwise-screen transform for all parts: supplier SVG rotated by minus CPL angle.

Same clockwise-screen transform for all parts: supplier SVG rotated by minus CPL angle.

Same clockwise-screen transform for all parts: supplier SVG rotated by minus CPL angle.

Same clockwise-screen transform for all parts: supplier SVG rotated by minus CPL angle.

Same clockwise-screen transform for all parts: supplier SVG rotated by minus CPL angle.

Same clockwise-screen transform for all parts: supplier SVG rotated by minus CPL angle.

Same clockwise-screen transform for all parts: supplier SVG rotated by minus CPL angle.

Same clockwise-screen transform for all parts: supplier SVG rotated by minus CPL angle.

Same clockwise-screen transform for all parts: supplier SVG rotated by minus CPL angle.

Same clockwise-screen transform for all parts: supplier SVG rotated by minus CPL angle. Pin 1 LOWER-RIGHT; left leads +BATT, right leads/EP GND. TI land pattern uses 1.95 mm row centers versus supplier preview 2.0574 mm; matching orientation and overlapping lands.

Same clockwise-screen transform for all parts: supplier SVG rotated by minus CPL angle.

Same clockwise-screen transform for all parts: supplier SVG rotated by minus CPL angle.

Same clockwise-screen transform for all parts: supplier SVG rotated by minus CPL angle.

Same clockwise-screen transform for all parts: supplier SVG rotated by minus CPL angle.

Same clockwise-screen transform for all parts: supplier SVG rotated by minus CPL angle. Unpolarized holder; four holes match two clips. Actual blade fuse is separate.

Same clockwise-screen transform for all parts: supplier SVG rotated by minus CPL angle.

Same clockwise-screen transform for all parts: supplier SVG rotated by minus CPL angle.

Same clockwise-screen transform for all parts: supplier SVG rotated by minus CPL angle.

Same clockwise-screen transform for all parts: supplier SVG rotated by minus CPL angle.

Same clockwise-screen transform for all parts: supplier SVG rotated by minus CPL angle.

Same clockwise-screen transform for all parts: supplier SVG rotated by minus CPL angle.

Same clockwise-screen transform for all parts: supplier SVG rotated by minus CPL angle.

Same clockwise-screen transform for all parts: supplier SVG rotated by minus CPL angle.

Same clockwise-screen transform for all parts: supplier SVG rotated by minus CPL angle.

Same clockwise-screen transform for all parts: supplier SVG rotated by minus CPL angle.

Same clockwise-screen transform for all parts: supplier SVG rotated by minus CPL angle.

Same clockwise-screen transform for all parts: supplier SVG rotated by minus CPL angle.

Same clockwise-screen transform for all parts: supplier SVG rotated by minus CPL angle.

Same clockwise-screen transform for all parts: supplier SVG rotated by minus CPL angle.

Same clockwise-screen transform for all parts: supplier SVG rotated by minus CPL angle.

Same clockwise-screen transform for all parts: supplier SVG rotated by minus CPL angle.

Same clockwise-screen transform for all parts: supplier SVG rotated by minus CPL angle.

Same clockwise-screen transform for all parts: supplier SVG rotated by minus CPL angle.

Same clockwise-screen transform for all parts: supplier SVG rotated by minus CPL angle.

Same clockwise-screen transform for all parts: supplier SVG rotated by minus CPL angle.

Same clockwise-screen transform for all parts: supplier SVG rotated by minus CPL angle.

Same clockwise-screen transform for all parts: supplier SVG rotated by minus CPL angle.

Same clockwise-screen transform for all parts: supplier SVG rotated by minus CPL angle.

Same clockwise-screen transform for all parts: supplier SVG rotated by minus CPL angle. Pin 1 LEFT on top view; MIN for J601–604, +5V for J605–606. Supplier pin1 is right at zero rotation; CPL180 reverses it correctly.

Same clockwise-screen transform for all parts: supplier SVG rotated by minus CPL angle. Pin 1 LEFT on top view; MIN for J601–604, +5V for J605–606. Supplier pin1 is right at zero rotation; CPL180 reverses it correctly.

Same clockwise-screen transform for all parts: supplier SVG rotated by minus CPL angle. Pin 1 LEFT on top view; MIN for J601–604, +5V for J605–606. Supplier pin1 is right at zero rotation; CPL180 reverses it correctly.

Same clockwise-screen transform for all parts: supplier SVG rotated by minus CPL angle. Pin 1 LEFT on top view; MIN for J601–604, +5V for J605–606. Supplier pin1 is right at zero rotation; CPL180 reverses it correctly.

Same clockwise-screen transform for all parts: supplier SVG rotated by minus CPL angle. Pin 1 LEFT on top view; MIN for J601–604, +5V for J605–606. Supplier pin1 is right at zero rotation; CPL180 reverses it correctly.

Same clockwise-screen transform for all parts: supplier SVG rotated by minus CPL angle. Pin 1 LEFT on top view; MIN for J601–604, +5V for J605–606. Supplier pin1 is right at zero rotation; CPL180 reverses it correctly.

Supplier COM-to-coil-row offset is 2.55 mm; Omron specifies 2.00 mm and PCB agrees. Do not move holes to supplier CAD. Assembler must use the manufacturer drawing to align the physical relay; CPL origin is not certified by this malformed supplier pad pattern.

Same clockwise-screen transform for all parts: supplier SVG rotated by minus CPL angle.

Same clockwise-screen transform for all parts: supplier SVG rotated by minus CPL angle.

Same clockwise-screen transform for all parts: supplier SVG rotated by minus CPL angle.

Same clockwise-screen transform for all parts: supplier SVG rotated by minus CPL angle.

Same clockwise-screen transform for all parts: supplier SVG rotated by minus CPL angle.

Same clockwise-screen transform for all parts: supplier SVG rotated by minus CPL angle.

Same clockwise-screen transform for all parts: supplier SVG rotated by minus CPL angle.

Same clockwise-screen transform for all parts: supplier SVG rotated by minus CPL angle.

Same clockwise-screen transform for all parts: supplier SVG rotated by minus CPL angle.

Same clockwise-screen transform for all parts: supplier SVG rotated by minus CPL angle.

Same clockwise-screen transform for all parts: supplier SVG rotated by minus CPL angle.

Same clockwise-screen transform for all parts: supplier SVG rotated by minus CPL angle.

Same clockwise-screen transform for all parts: supplier SVG rotated by minus CPL angle.

Same clockwise-screen transform for all parts: supplier SVG rotated by minus CPL angle.

Same clockwise-screen transform for all parts: supplier SVG rotated by minus CPL angle.

Same clockwise-screen transform for all parts: supplier SVG rotated by minus CPL angle.

Same clockwise-screen transform for all parts: supplier SVG rotated by minus CPL angle.

Same clockwise-screen transform for all parts: supplier SVG rotated by minus CPL angle.

Same clockwise-screen transform for all parts: supplier SVG rotated by minus CPL angle.

Same clockwise-screen transform for all parts: supplier SVG rotated by minus CPL angle.

Same clockwise-screen transform for all parts: supplier SVG rotated by minus CPL angle.

Same clockwise-screen transform for all parts: supplier SVG rotated by minus CPL angle.

Same clockwise-screen transform for all parts: supplier SVG rotated by minus CPL angle.

Same clockwise-screen transform for all parts: supplier SVG rotated by minus CPL angle.

Same clockwise-screen transform for all parts: supplier SVG rotated by minus CPL angle.

Same clockwise-screen transform for all parts: supplier SVG rotated by minus CPL angle.

Same clockwise-screen transform for all parts: supplier SVG rotated by minus CPL angle.

Same clockwise-screen transform for all parts: supplier SVG rotated by minus CPL angle.

Same clockwise-screen transform for all parts: supplier SVG rotated by minus CPL angle.

Same clockwise-screen transform for all parts: supplier SVG rotated by minus CPL angle.

Same clockwise-screen transform for all parts: supplier SVG rotated by minus CPL angle.

Same clockwise-screen transform for all parts: supplier SVG rotated by minus CPL angle.

Same clockwise-screen transform for all parts: supplier SVG rotated by minus CPL angle.

Same clockwise-screen transform for all parts: supplier SVG rotated by minus CPL angle.

Same clockwise-screen transform for all parts: supplier SVG rotated by minus CPL angle.

Same clockwise-screen transform for all parts: supplier SVG rotated by minus CPL angle.

Same clockwise-screen transform for all parts: supplier SVG rotated by minus CPL angle.

Same clockwise-screen transform for all parts: supplier SVG rotated by minus CPL angle.

Same clockwise-screen transform for all parts: supplier SVG rotated by minus CPL angle.

Same clockwise-screen transform for all parts: supplier SVG rotated by minus CPL angle.

Same clockwise-screen transform for all parts: supplier SVG rotated by minus CPL angle. 1.0 mm PCB drills; unkeyed 1x8 strips are electrically symmetric under 180-degree reversal.

Same clockwise-screen transform for all parts: supplier SVG rotated by minus CPL angle. Pin 1 UPPER-LEFT. Supplier zero-angle pin1 is lower-left; CPL270 maps it to upper-left.
