levdan159/abx-motion/production/rev-1.2a-20261023/assembly/placement-overlays.html

# Rev 1.2a supplier placement audit

Top view. Gold: native PCB lands; blue: supplier pad centers using exported CPL origins and rotations. Labels source→native show explicit functional mapping for A/K LED polarity or independent terminal contacts. Raw pad-number equality alone is not an orientation check. All 328 placements audited; panels cover each SKU/angle and every connector/relay. Relays require manufacturer alignment review.

PASS — Supplier numbered pad geometry; native pin mapping retained.

PASS — Supplier numbered pad geometry; native pin mapping retained.

PASS — Supplier numbered pad geometry; native pin mapping retained.

PASS — Supplier numbered pad geometry; native pin mapping retained.

PASS — Supplier numbered pad geometry; native pin mapping retained.

PASS — Supplier numbered pad geometry; native pin mapping retained.

PASS — Supplier numbered pad geometry; native pin mapping retained.

PASS — Supplier numbered pad geometry; native pin mapping retained.

PASS — Supplier numbered pad geometry; native pin mapping retained.

PASS — Supplier numbered pad geometry; native pin mapping retained.

PASS — Supplier numbered pad geometry; native pin mapping retained.

PASS — Supplier numbered pad geometry; native pin mapping retained.

PASS — Supplier numbered pad geometry; native pin mapping retained.

PASS — Supplier numbered pad geometry; native pin mapping retained.

PASS — Supplier numbered pad geometry; native pin mapping retained.

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

PASS — Supplier numbered pad geometry; native pin mapping retained.

PASS — Supplier numbered pad geometry; native pin mapping retained.

PASS — Supplier numbered pad geometry; native pin mapping retained.

PASS — Supplier numbered pad geometry; native pin mapping retained.
