levdan159/abx-motion/validation/robustness-final-20261020/bench-results.csv

Test | Status | VBAT_V | 5V_V | 3V3_V | Input_A | Phase_peak_A | VM_peak_V | Q1_case_C | Bridge_case_C | Duration_s | Notes
Unpowered inspection | NOT RUN
Energy-limited first power at intended voltage | NOT RUN
No-motor rails | NOT RUN
USB-only / battery-only / dual power | NOT RUN
Cold / warm reset defaults | NOT RUN
E-stop gate disable | NOT RUN
Logic fault latch / timeout | NOT RUN
Motor1 low energy | NOT RUN
Motor2 low energy | NOT RUN
Measured chopping threshold | NOT RUN
Motor1 150W 1s | NOT RUN
Motor2 150W 1s | NOT RUN
Both motors 150W each 1s | NOT RUN
Measured low-energy coast / brake / reversal | NOT RUN
