levdan159/abx-motion/validation/drc-cleanup-20261024/top.png

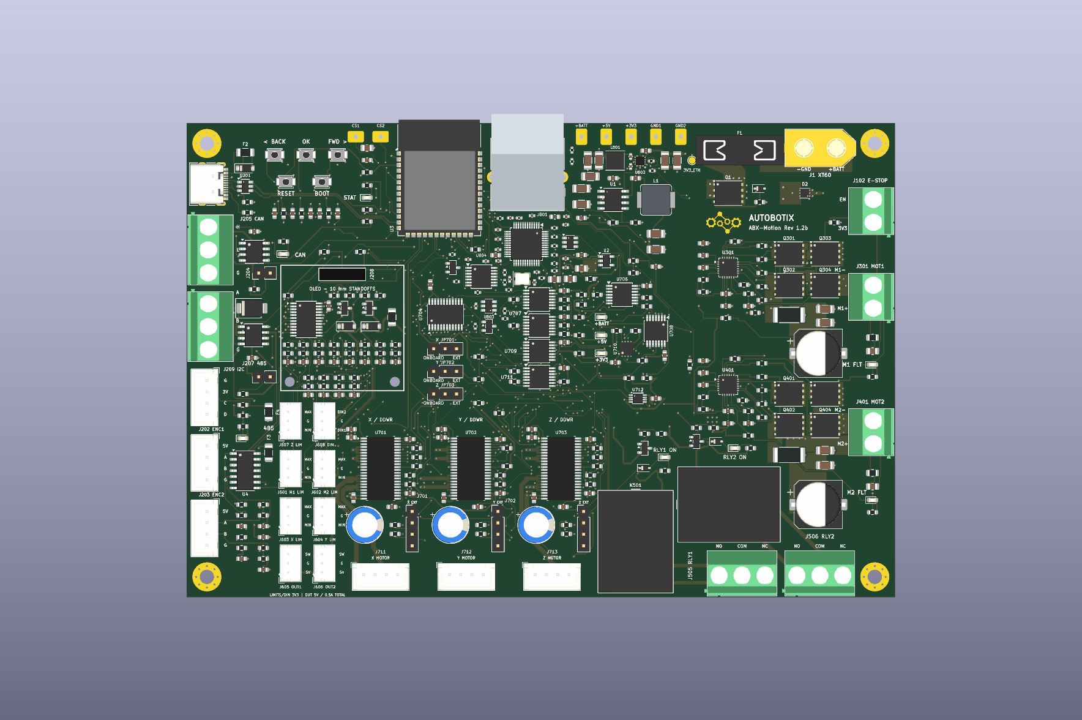
validation/drc-cleanup-20261024/top.png
