levdan159/abx-motion/validation/prototype-review-20261019_153750/ground.png

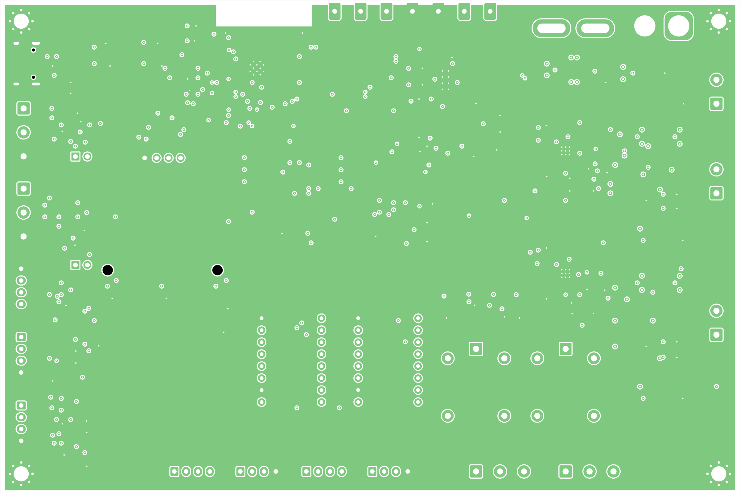
validation/prototype-review-20261019_153750/ground.png
