levdan159/abx-motion/validation/run-review-20261020/aesthetic-bottom.png

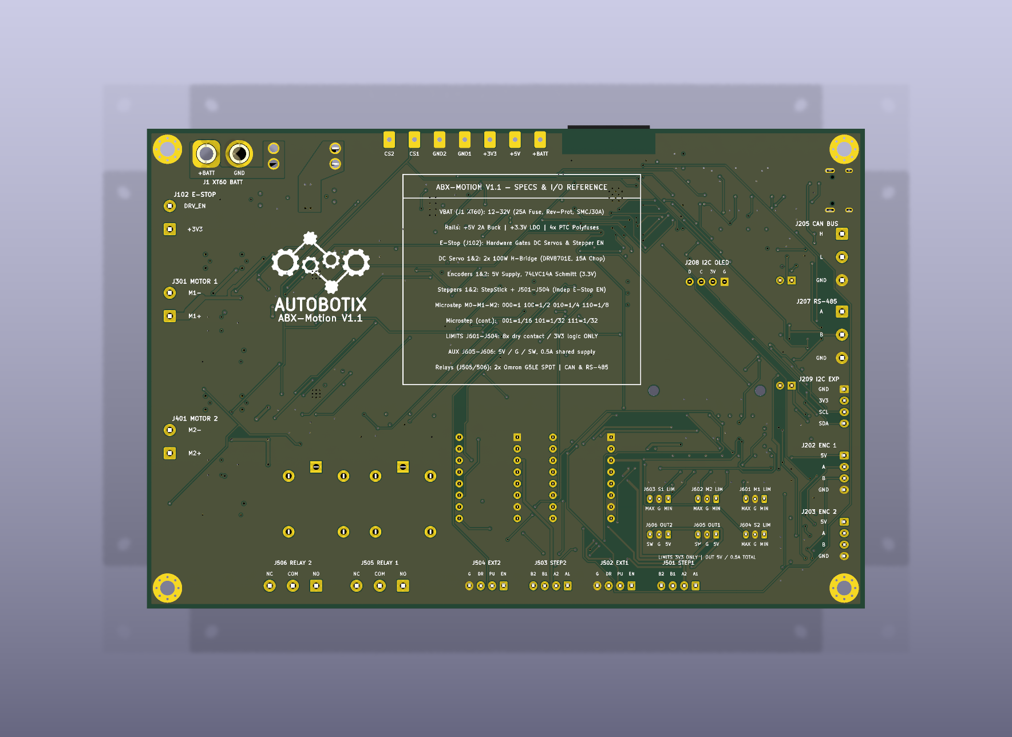
validation/run-review-20261020/aesthetic-bottom.png
