levdan159/abx-motion/work/rev-1.2-relay-bottom-right/review/native-placement-changes.csv

Reference | Old X | Old Y | Old angle | New X | New Y | New native angle
K501 | 144.5 | 122.0 | 0.0 | 144.5 | 132.0 | 0.0
K502 | 173.6 | 133.5 | -90.0 | 156.5 | 132.5 | 90.0
J505 | 146.0 | 148.0 | 0.0 | 163.0 | 148.0 | 0.0
J506 | 165.0 | 148.0 | 0.0 | 180.25 | 148.0 | 0.0
R501 | 145.0 | 114.1 | 0.0 | 139.5 | 122.5 | 0.0
R207 | 149.0 | 114.1 | 0.0 | 143.5 | 122.5 | 0.0
Q501 | 140.0 | 117.2 | 0.0 | 139.5 | 126.0 | 0.0
D501 | 145.0 | 116.6 | 0.0 | 145.0 | 126.5 | 0.0
R502 | 149.0 | 116.8 | 0.0 | 150.0 | 125.0 | 0.0
D502 | 153.0 | 116.8 | 0.0 | 150.0 | 122.0 | 0.0
R503 | 163.5 | 121.0 | 0.0 | 153.9 | 115.8 | 0.0
R208 | 163.5 | 123.0 | 0.0 | 157.5 | 115.8 | 0.0
Q502 | 168.5 | 121.5 | 0.0 | 155.0 | 118.8 | 0.0
D503 | 172.6 | 122.0 | 0.0 | 159.0 | 120.5 | 0.0
R504 | 159.5 | 118.5 | 0.0 | 168.0 | 120.5 | 0.0
D504 | 163.0 | 118.5 | 0.0 | 164.0 | 120.5 | 0.0
