levdan159/abx-motion/work/rev-1.2-relay-bay/review/native-placement-changes.csv

Reference | Old X mm | Old Y mm | Old native angle deg | New X mm | New Y mm | New native angle deg
K501 | 146.0 | 122.0 | 0.0 | 144.5 | 122 | 0
K502 | 165.0 | 122.0 | 0.0 | 173.6 | 133.5 | 270
R207 | 145.5 | 112.5 | 0.0 | 149 | 114.1 | 0
R501 | 145.5 | 115.2 | 0.0 | 145 | 114.1 | 0
R502 | 145.5 | 109.8 | 0.0 | 149 | 116.8 | 0
D502 | 140.0 | 107.0 | 0.0 | 153 | 116.8 | 0
Q501 | 140.0 | 114.5 | 0.0 | 140 | 117.2 | 0
D501 | 140.0 | 110.2 | 0.0 | 145 | 116.6 | 0
R503 | 155.5 | 110.2 | 0.0 | 163.5 | 121 | 0
R208 | 150.5 | 115.2 | 0.0 | 163.5 | 123 | 0
R504 | 150.5 | 109.8 | 0.0 | 159.5 | 118.5 | 0
D504 | 150.5 | 107.0 | 0.0 | 163 | 118.5 | 0
Q502 | 155.5 | 114.5 | 0.0 | 168.5 | 121.5 | 0
D503 | 150.5 | 112.5 | 0.0 | 172.6 | 122 | 0
