levdan159/abx-motion/abx-motion-schematics.pdf

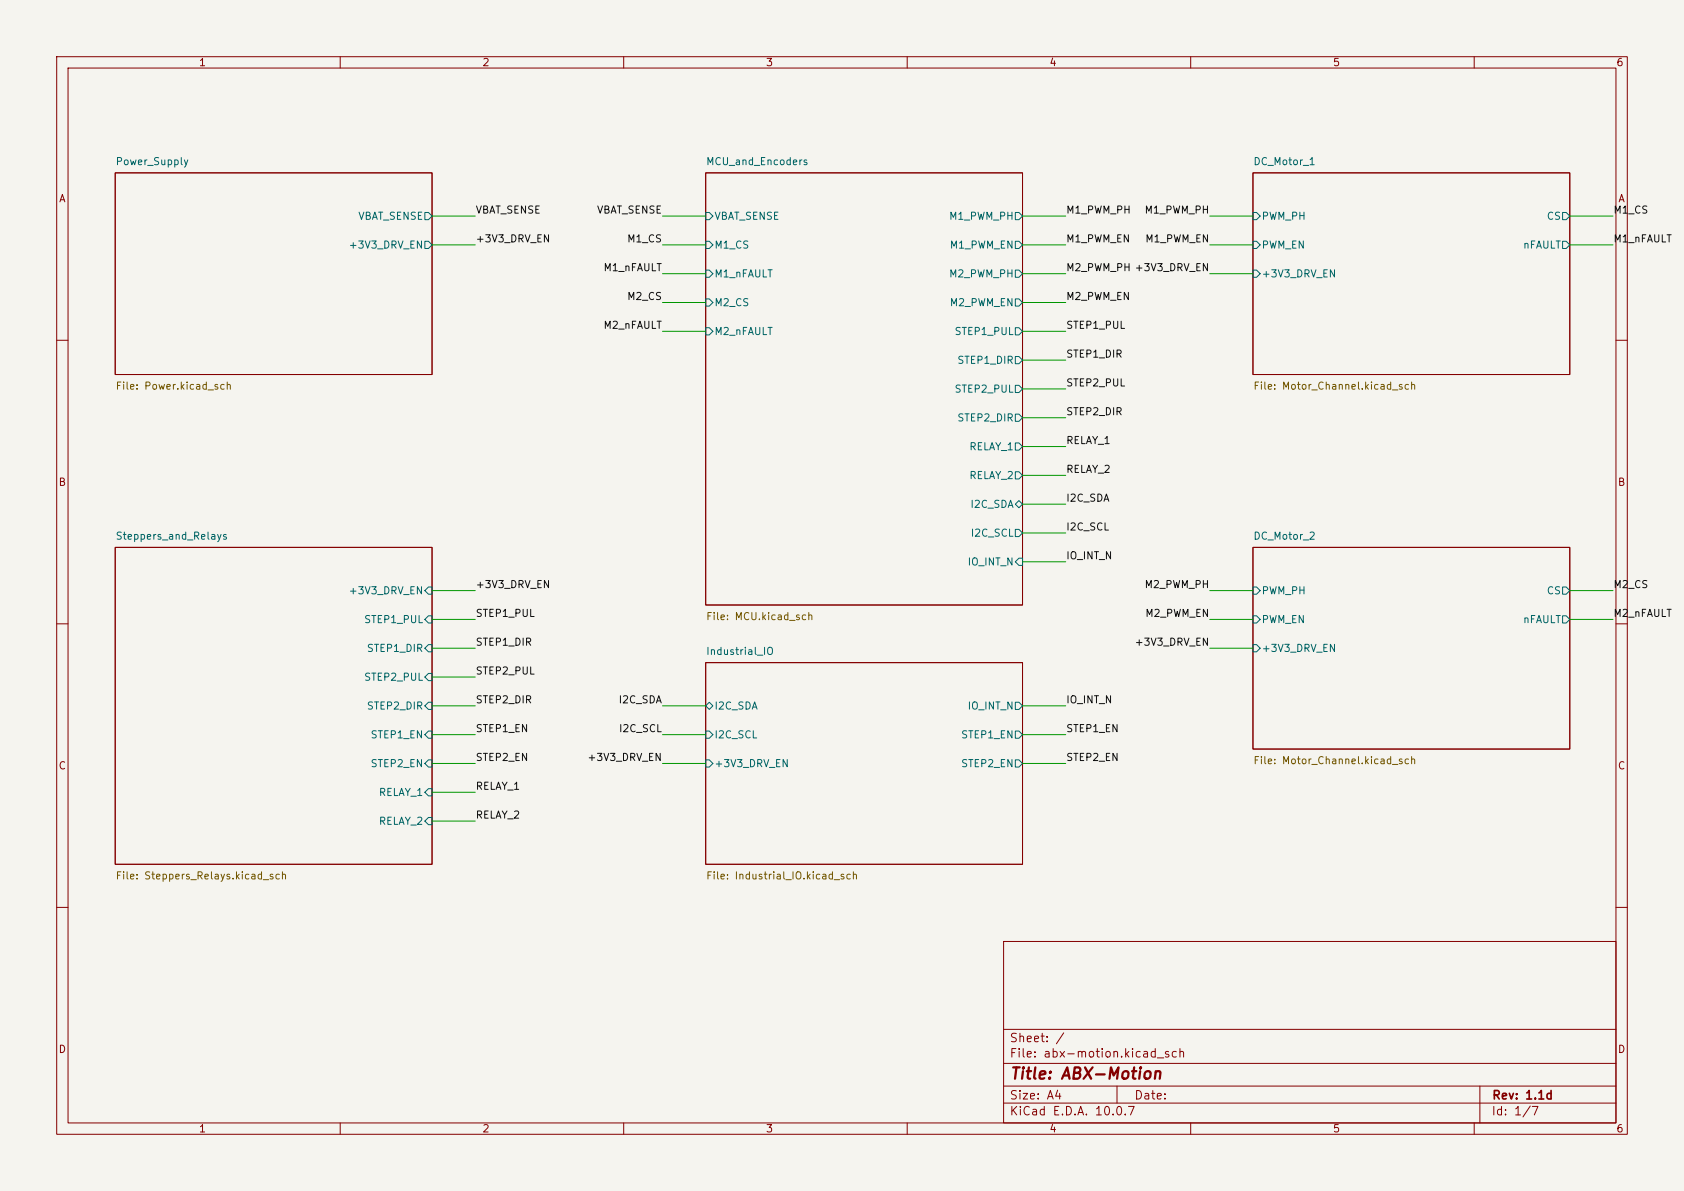
[picture p53: page 1]

Size: A4 | Rev: 1.1d
KiCad E.D.A. 10.0.7 | Id: 1/7

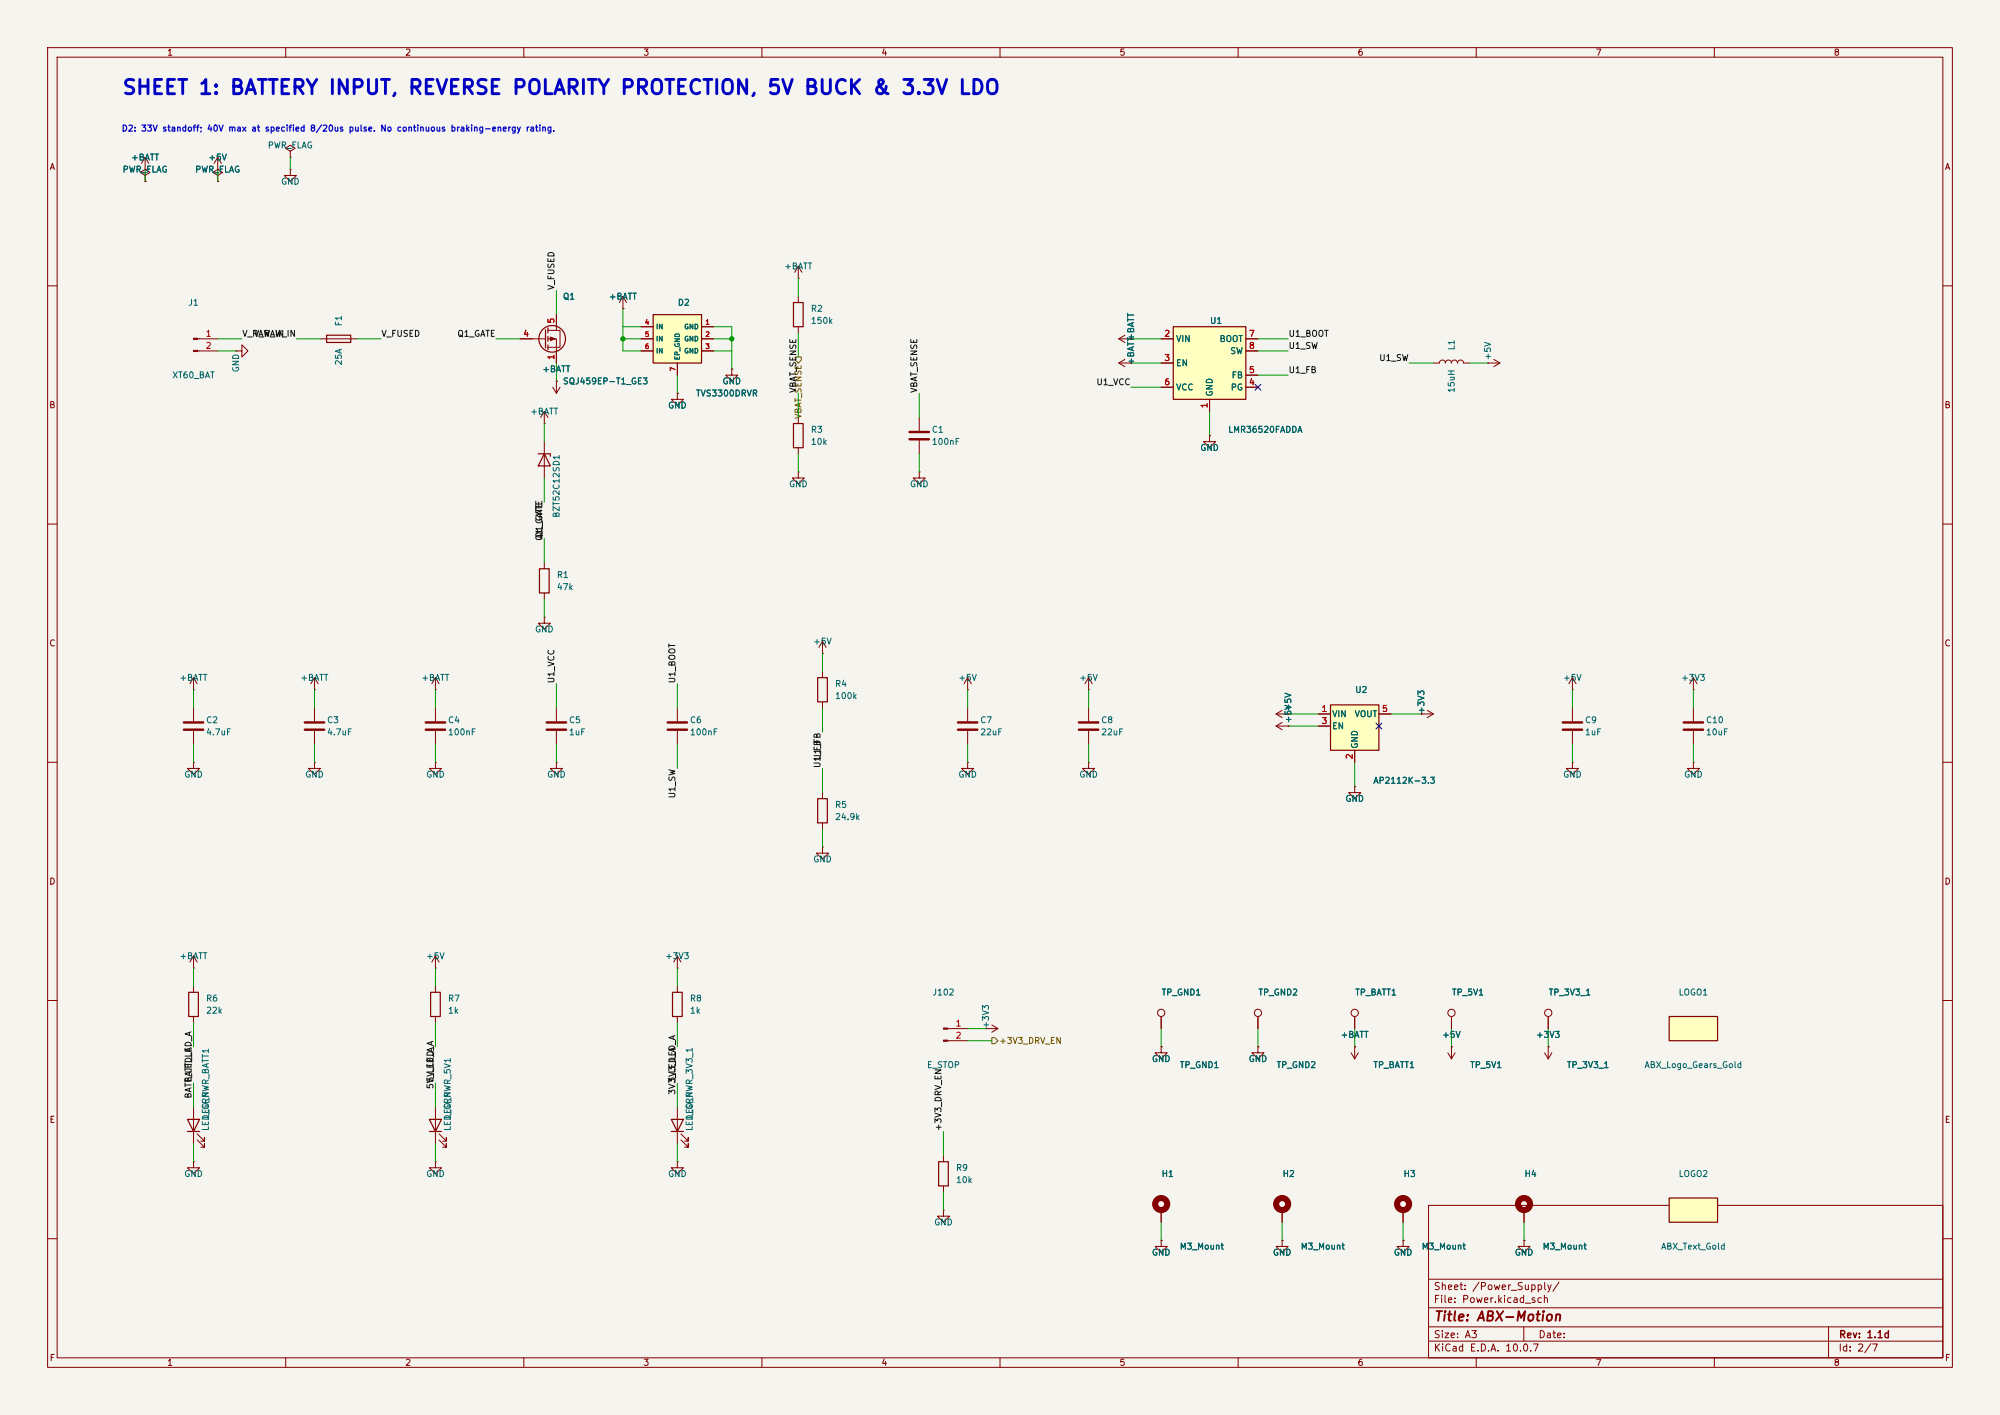
[picture p54: page 2]

SHEET 1: BATTERY INPUT, REVERSE POLARITY PROTECTION, 5V BUCK & 3.3V LDO

D2: 33V standoff; 40V max at specified 8/20us pulse. No continuous braking-energy rating.

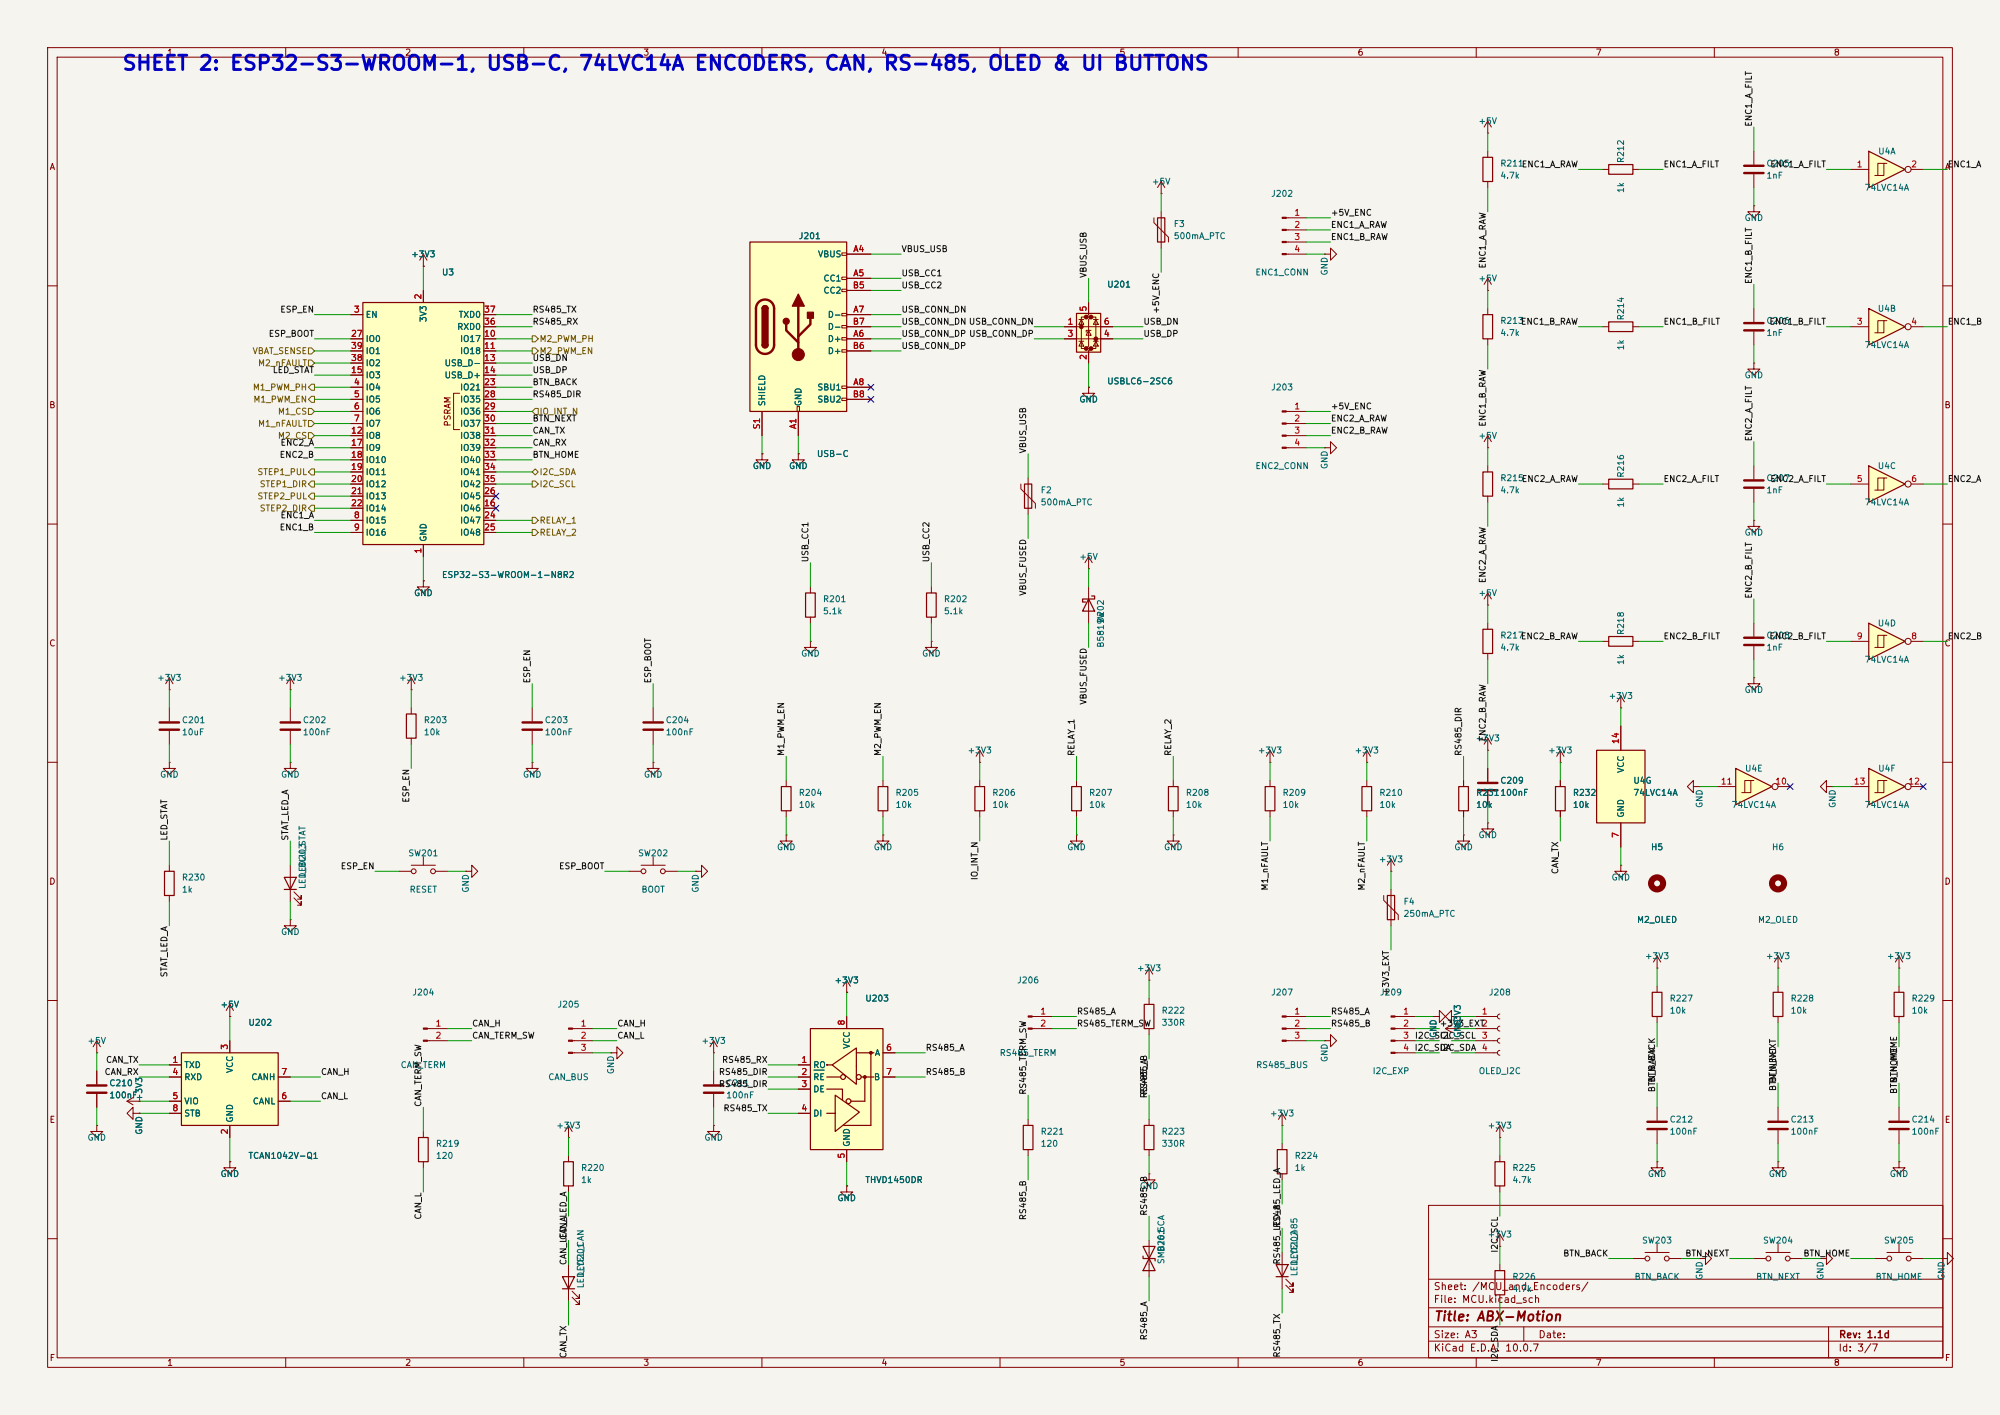
[picture p55: page 3]

SHEET 2: ESP32-S3-WROOM-1, USB-C, 74LVC14A ENCODERS, CAN, RS-485, OLED & UI BUTTONS

4.7k R225 SW205 BTN_HOME GND

File: MCU.kicad_sch

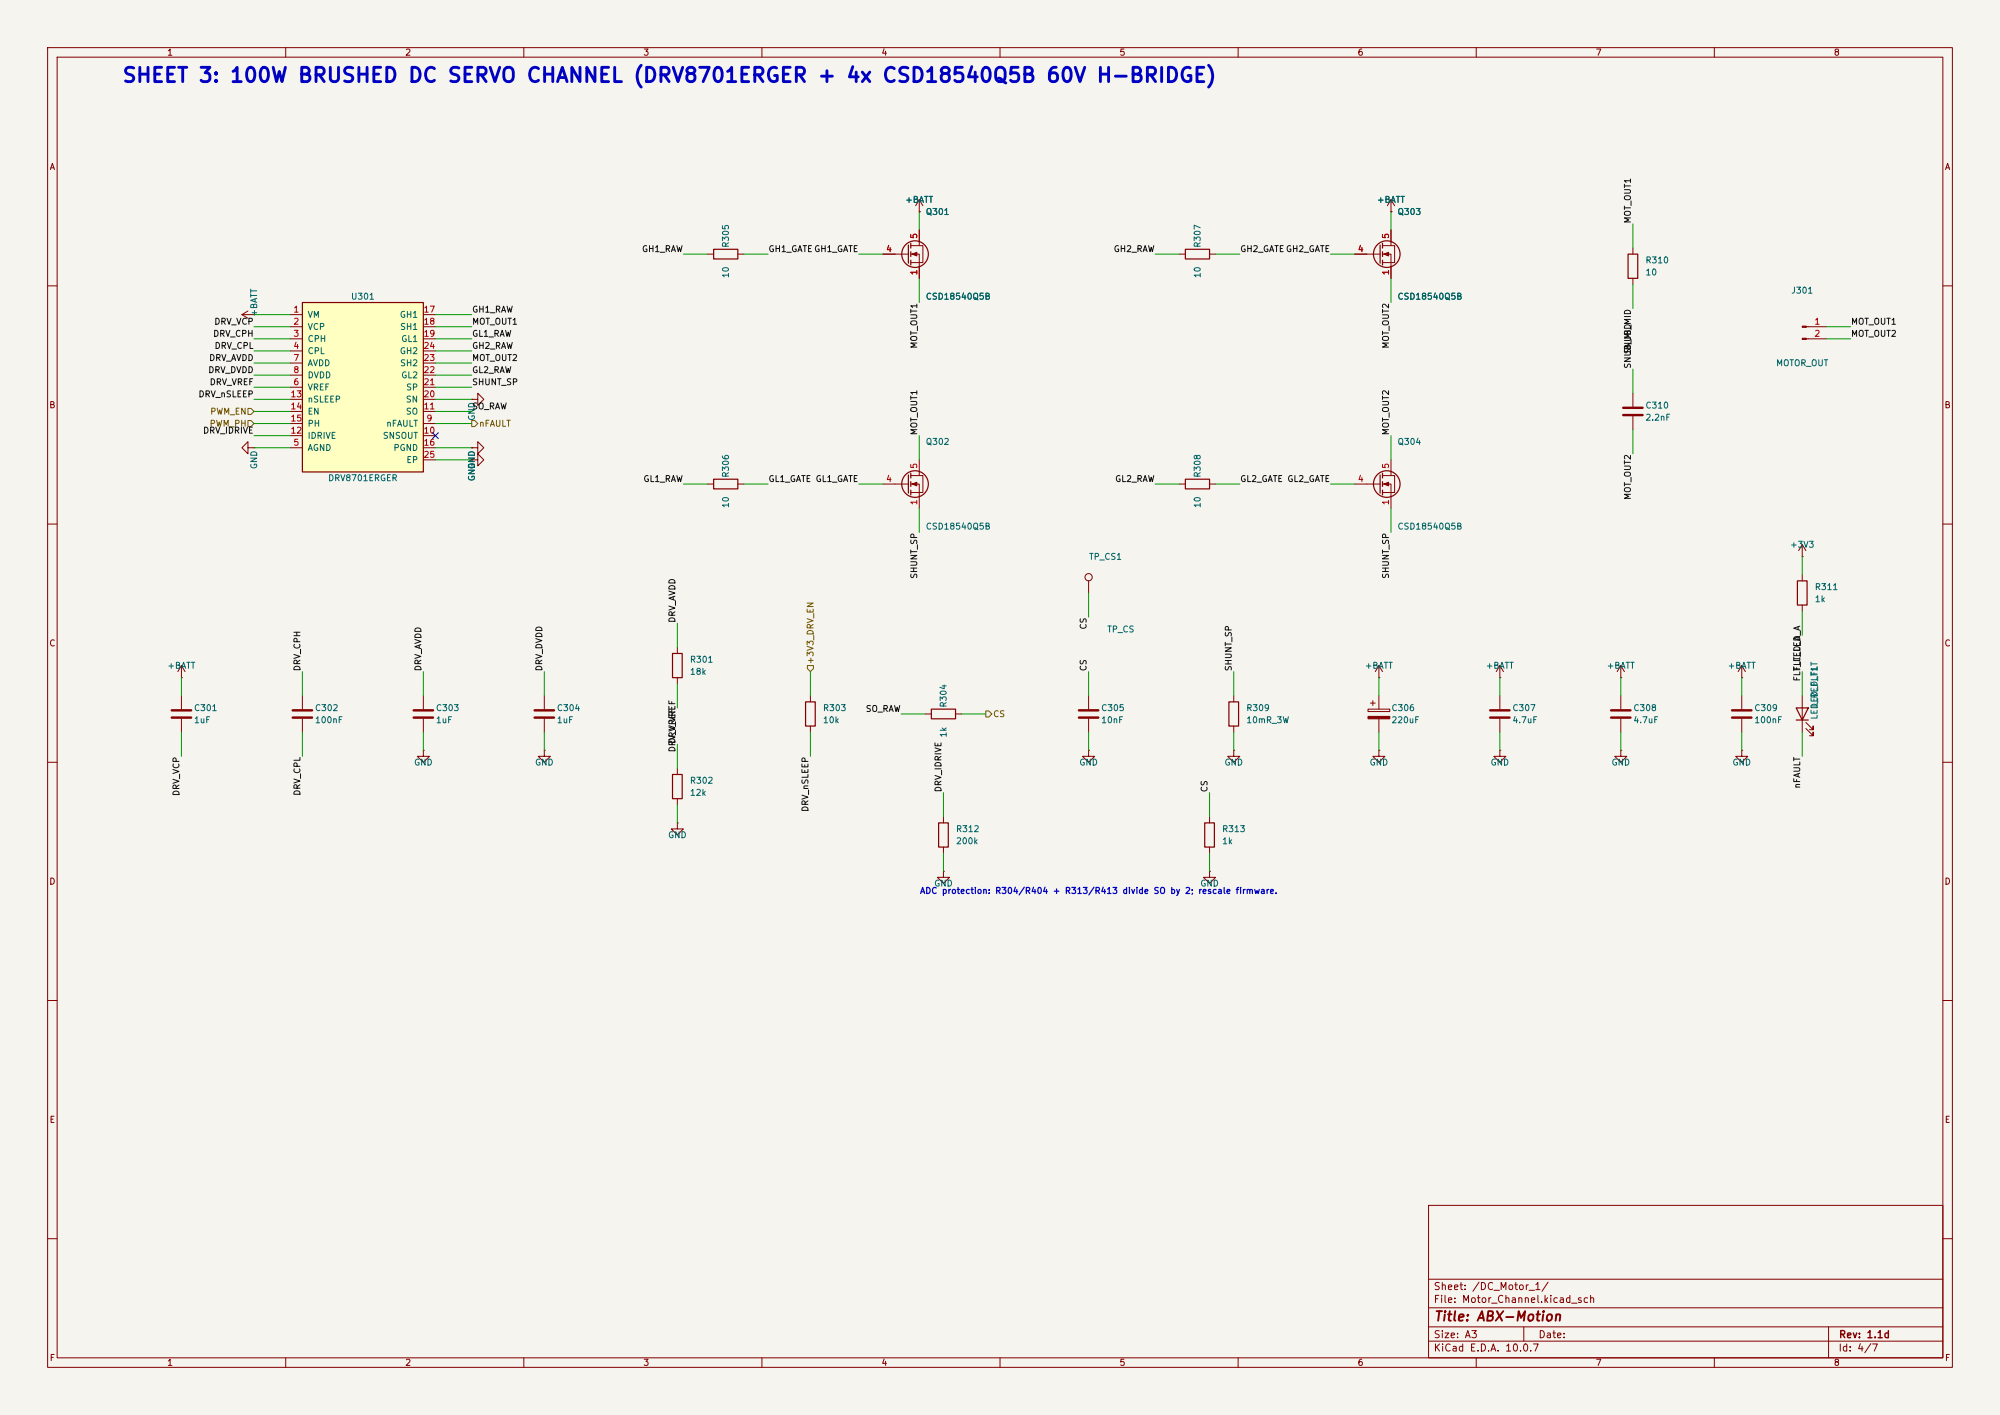
[picture p56: page 4]

ADC protection: R304/R404 + R313/R413 divide SO by 2; rescale firmware. SHEET 3: 100W BRUSHED DC SERVO CHANNEL (DRV8701ERGER + 4x CSD18540Q5B 60V H-BRIDGE) GND

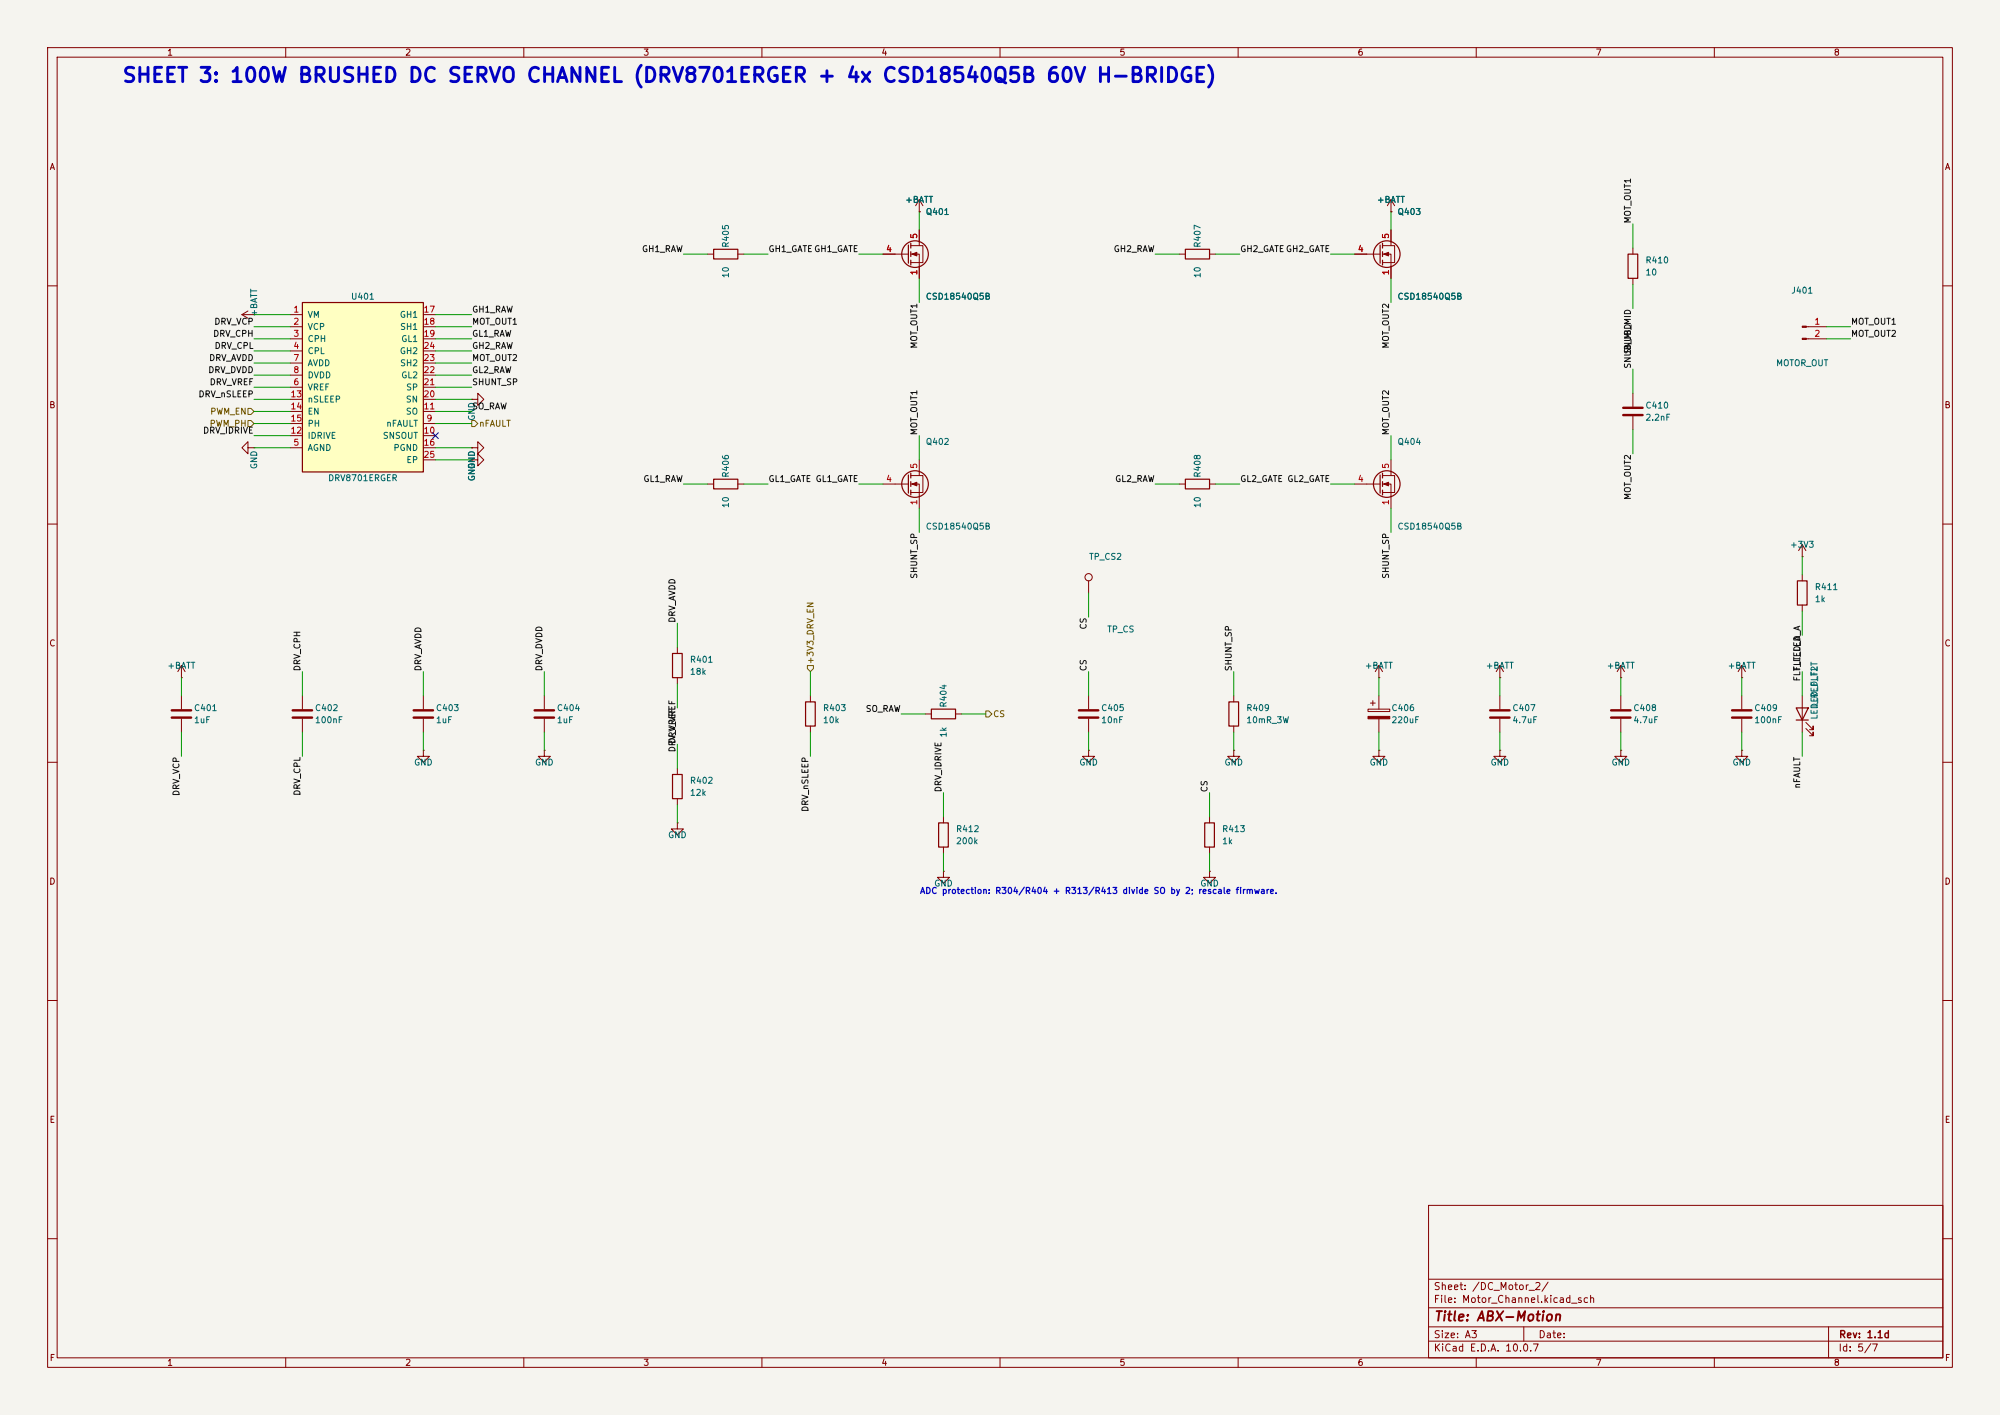
[picture p57: page 5]
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

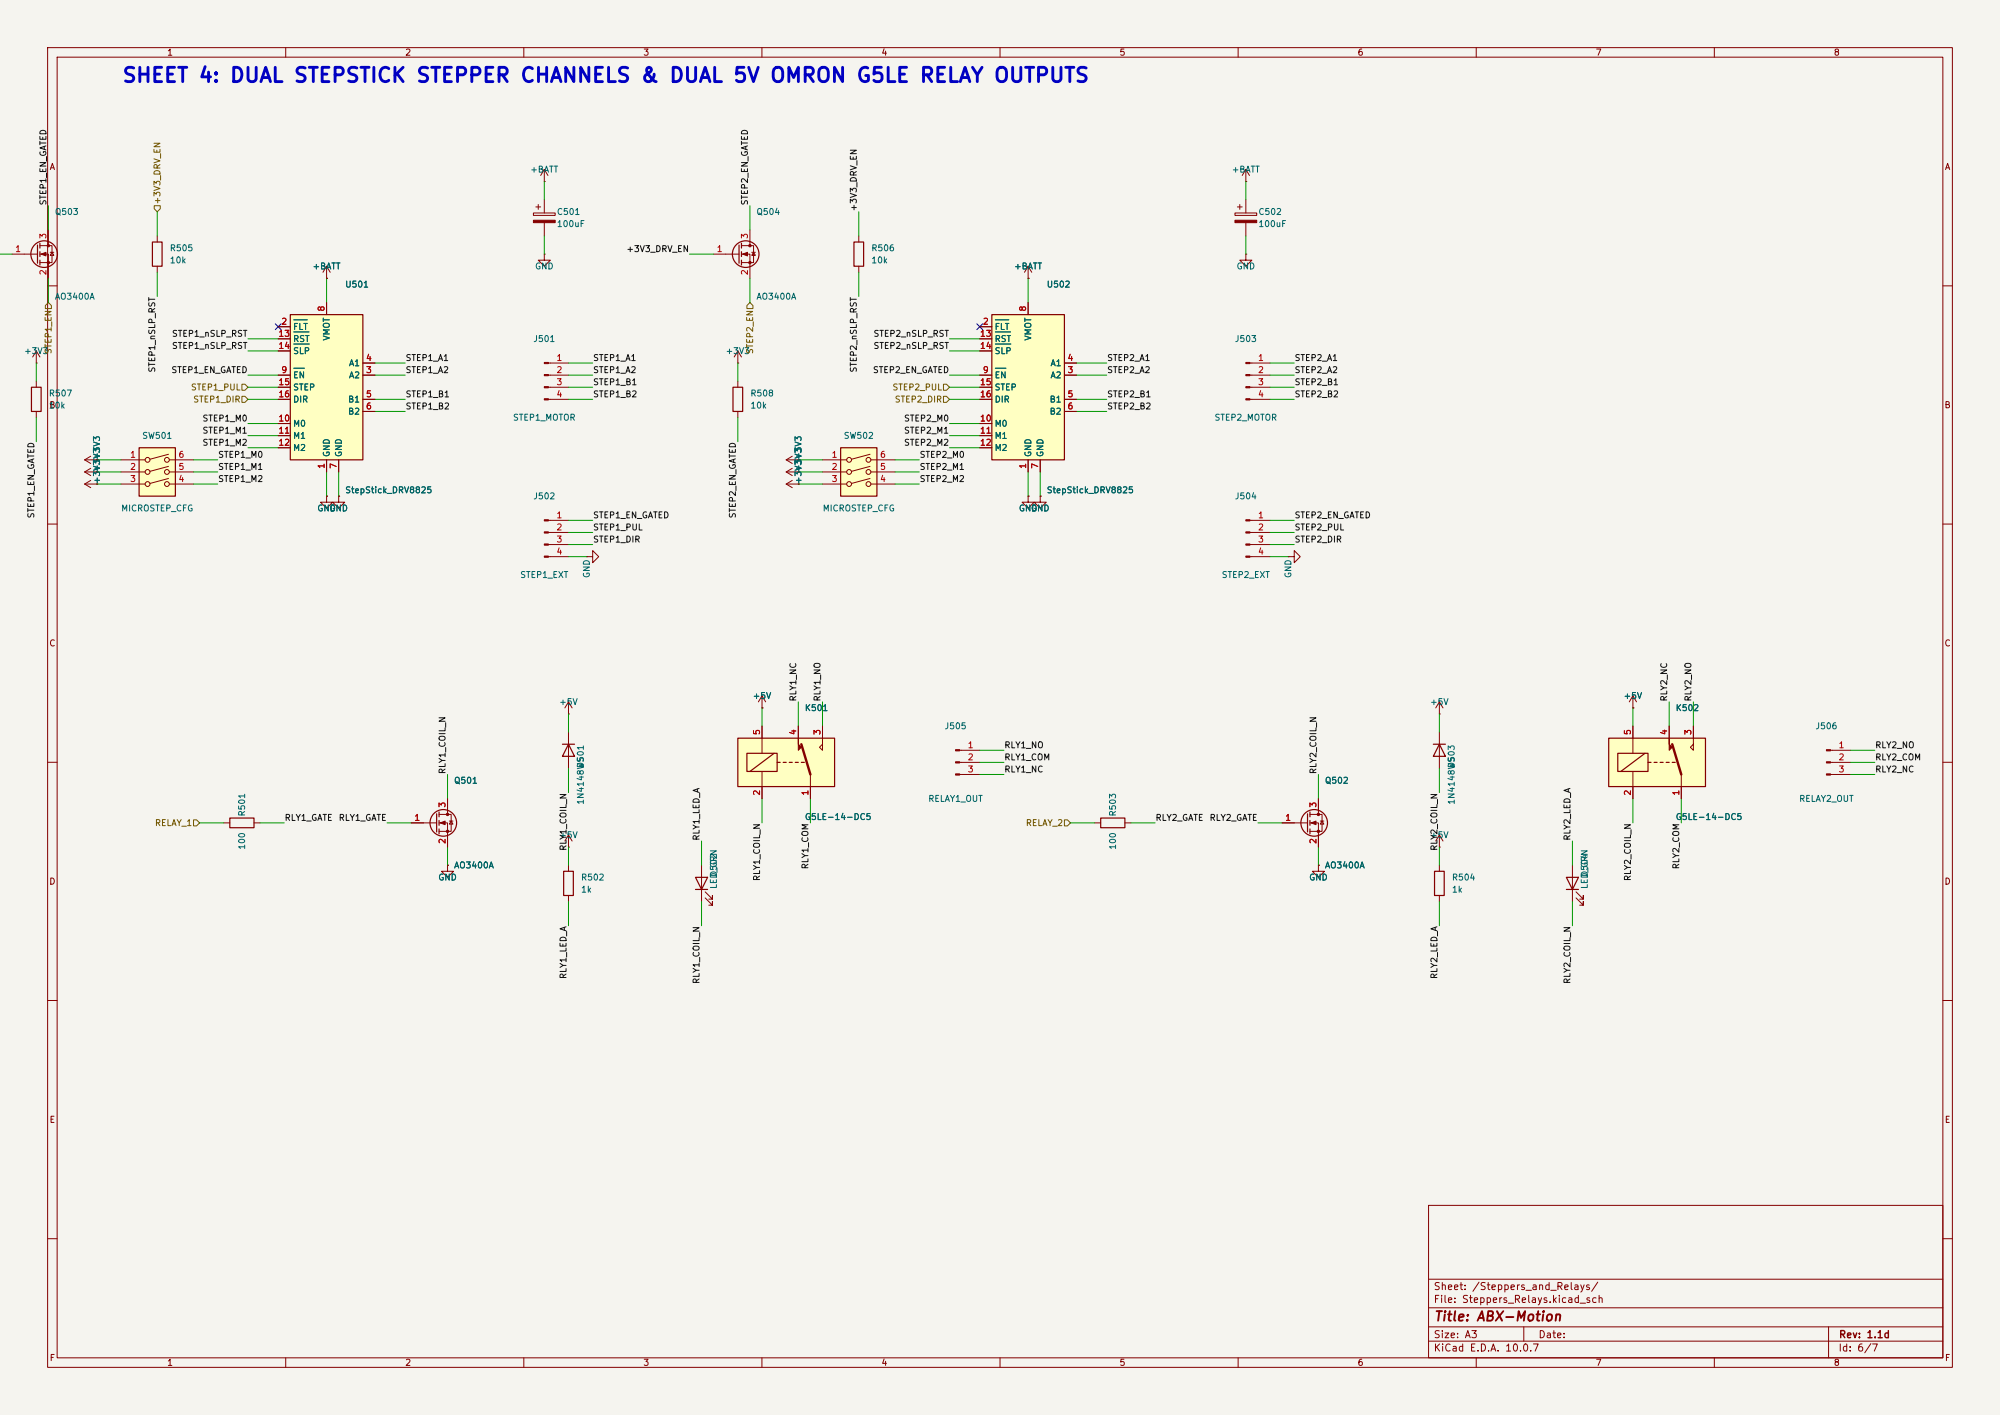
[picture p58: page 6]

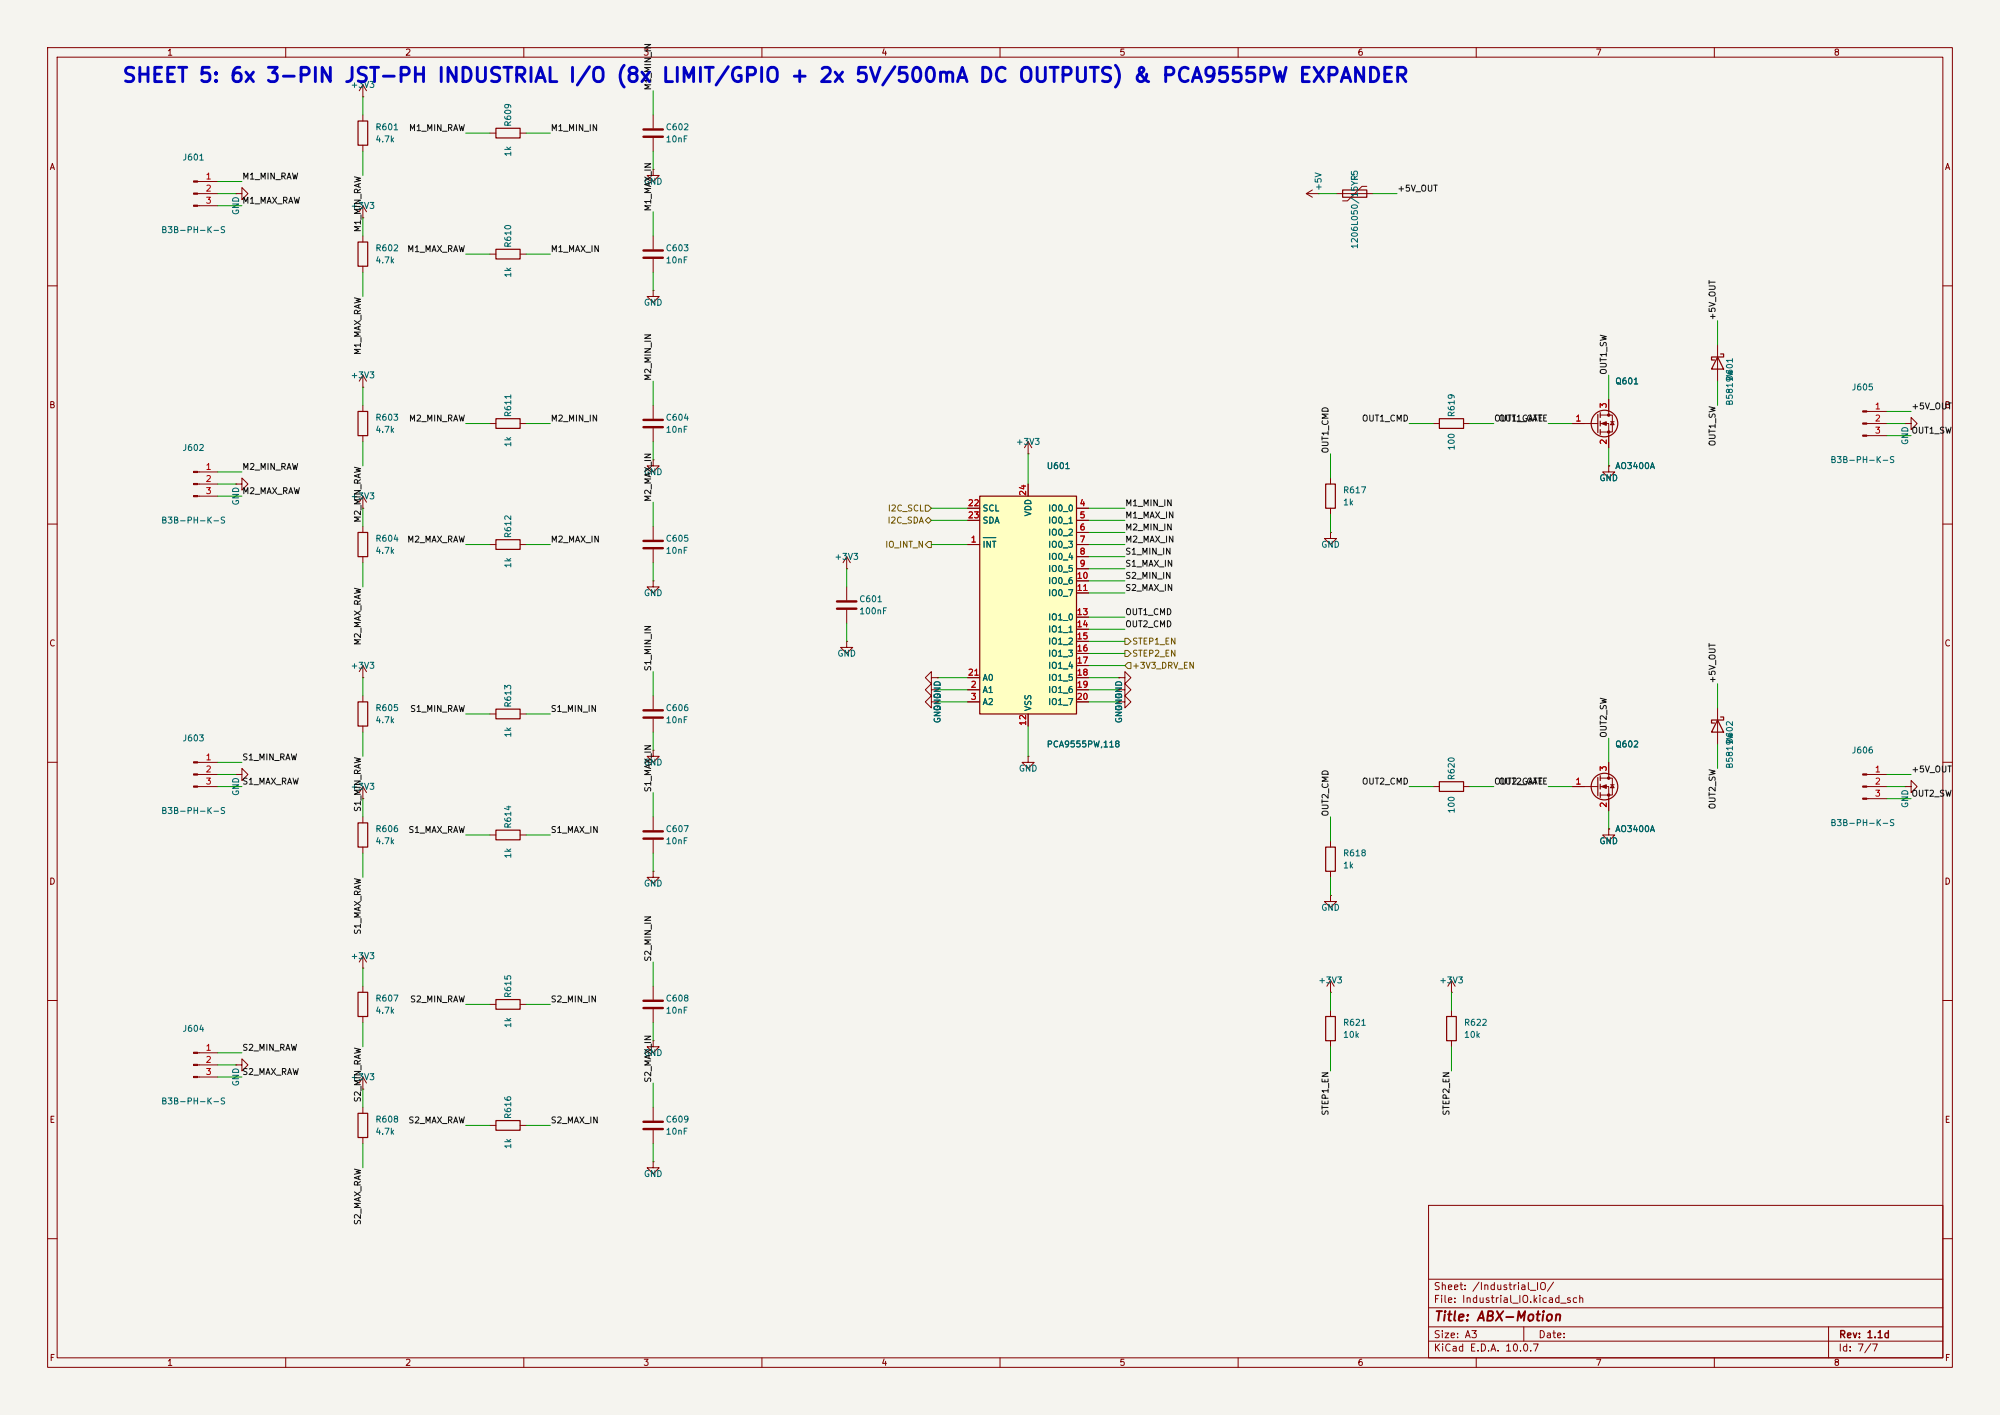
[picture p59: page 7]

OUT1_GATE SHEET 5: 6x 3-PIN JST-PH INDUSTRIAL I/O (8x LIMIT/GPIO + 2x 5V/500mA DC OUTPUTS) & PCA9555PW EXPANDER
