levdan159/abx-motion/production/abx-motion-schematic.pdf

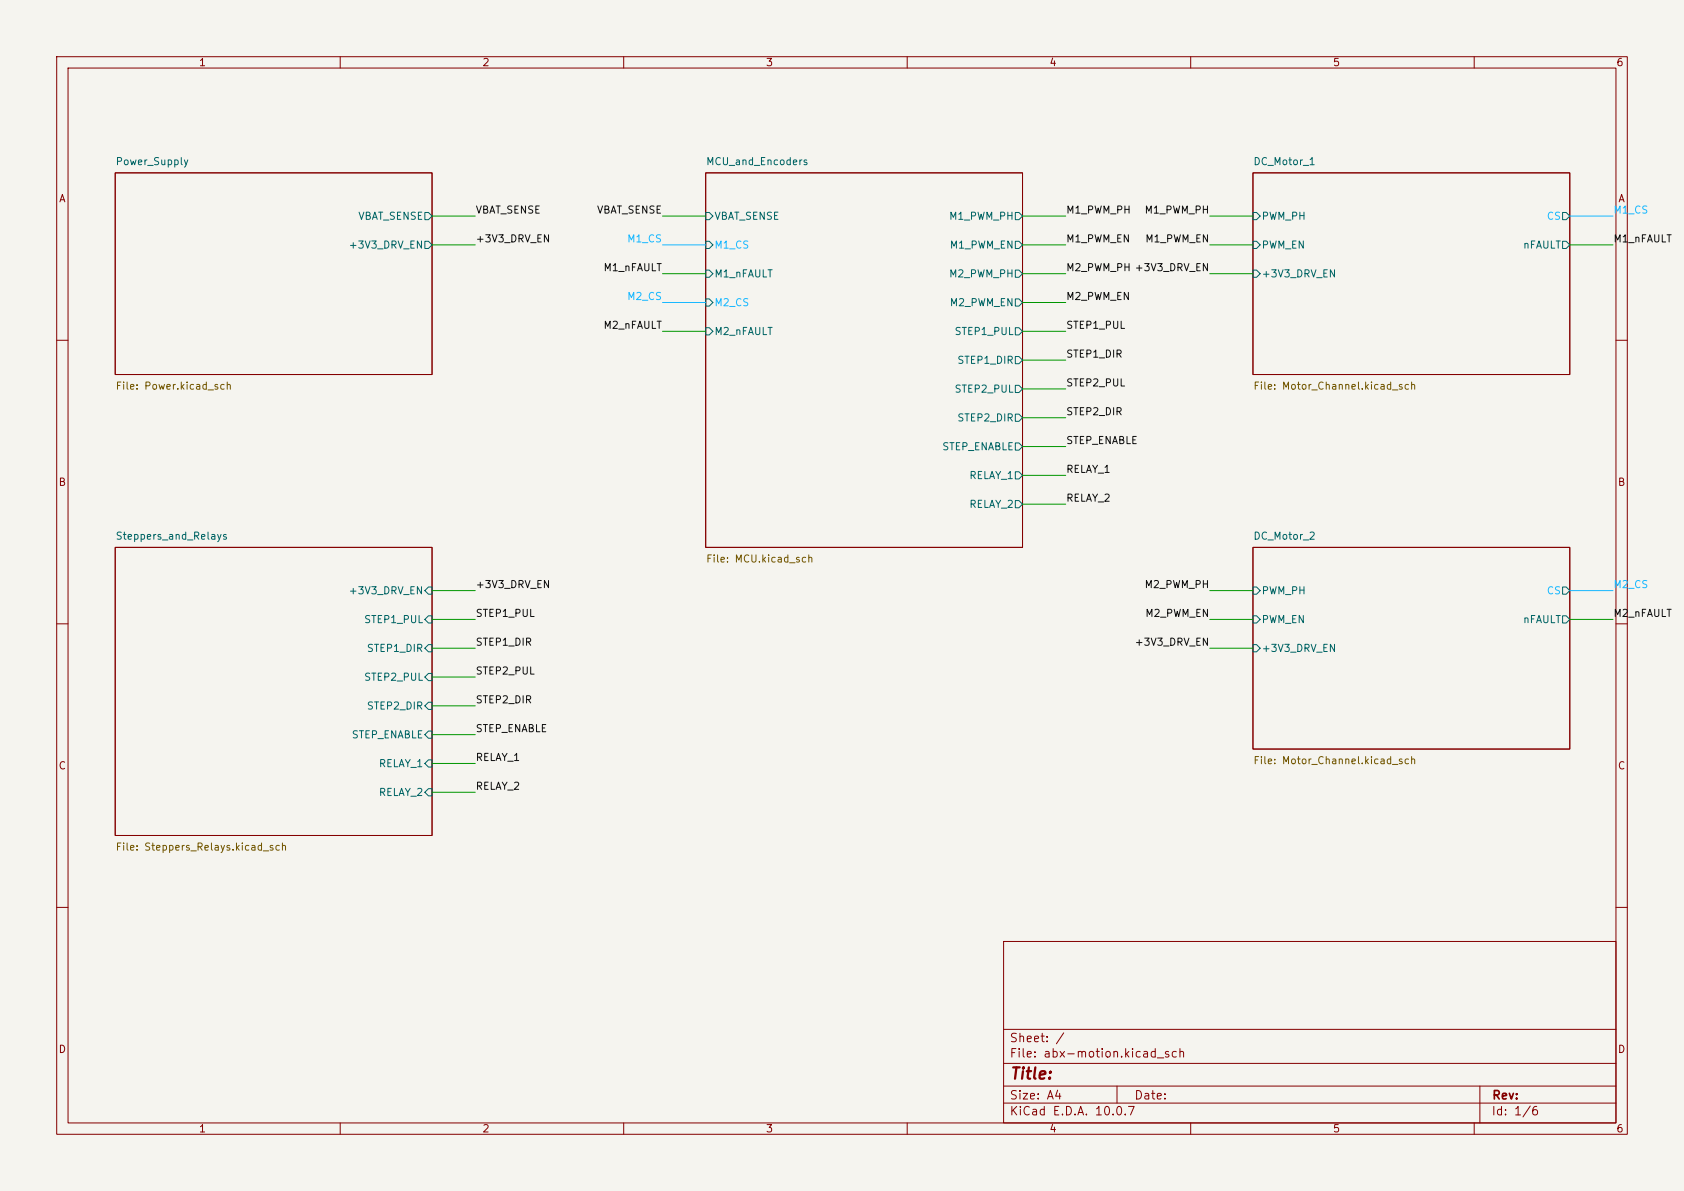
[picture p60: page 1]

Size: A4 | Rev:
KiCad E.D.A. 10.0.7 | Id: 1/6

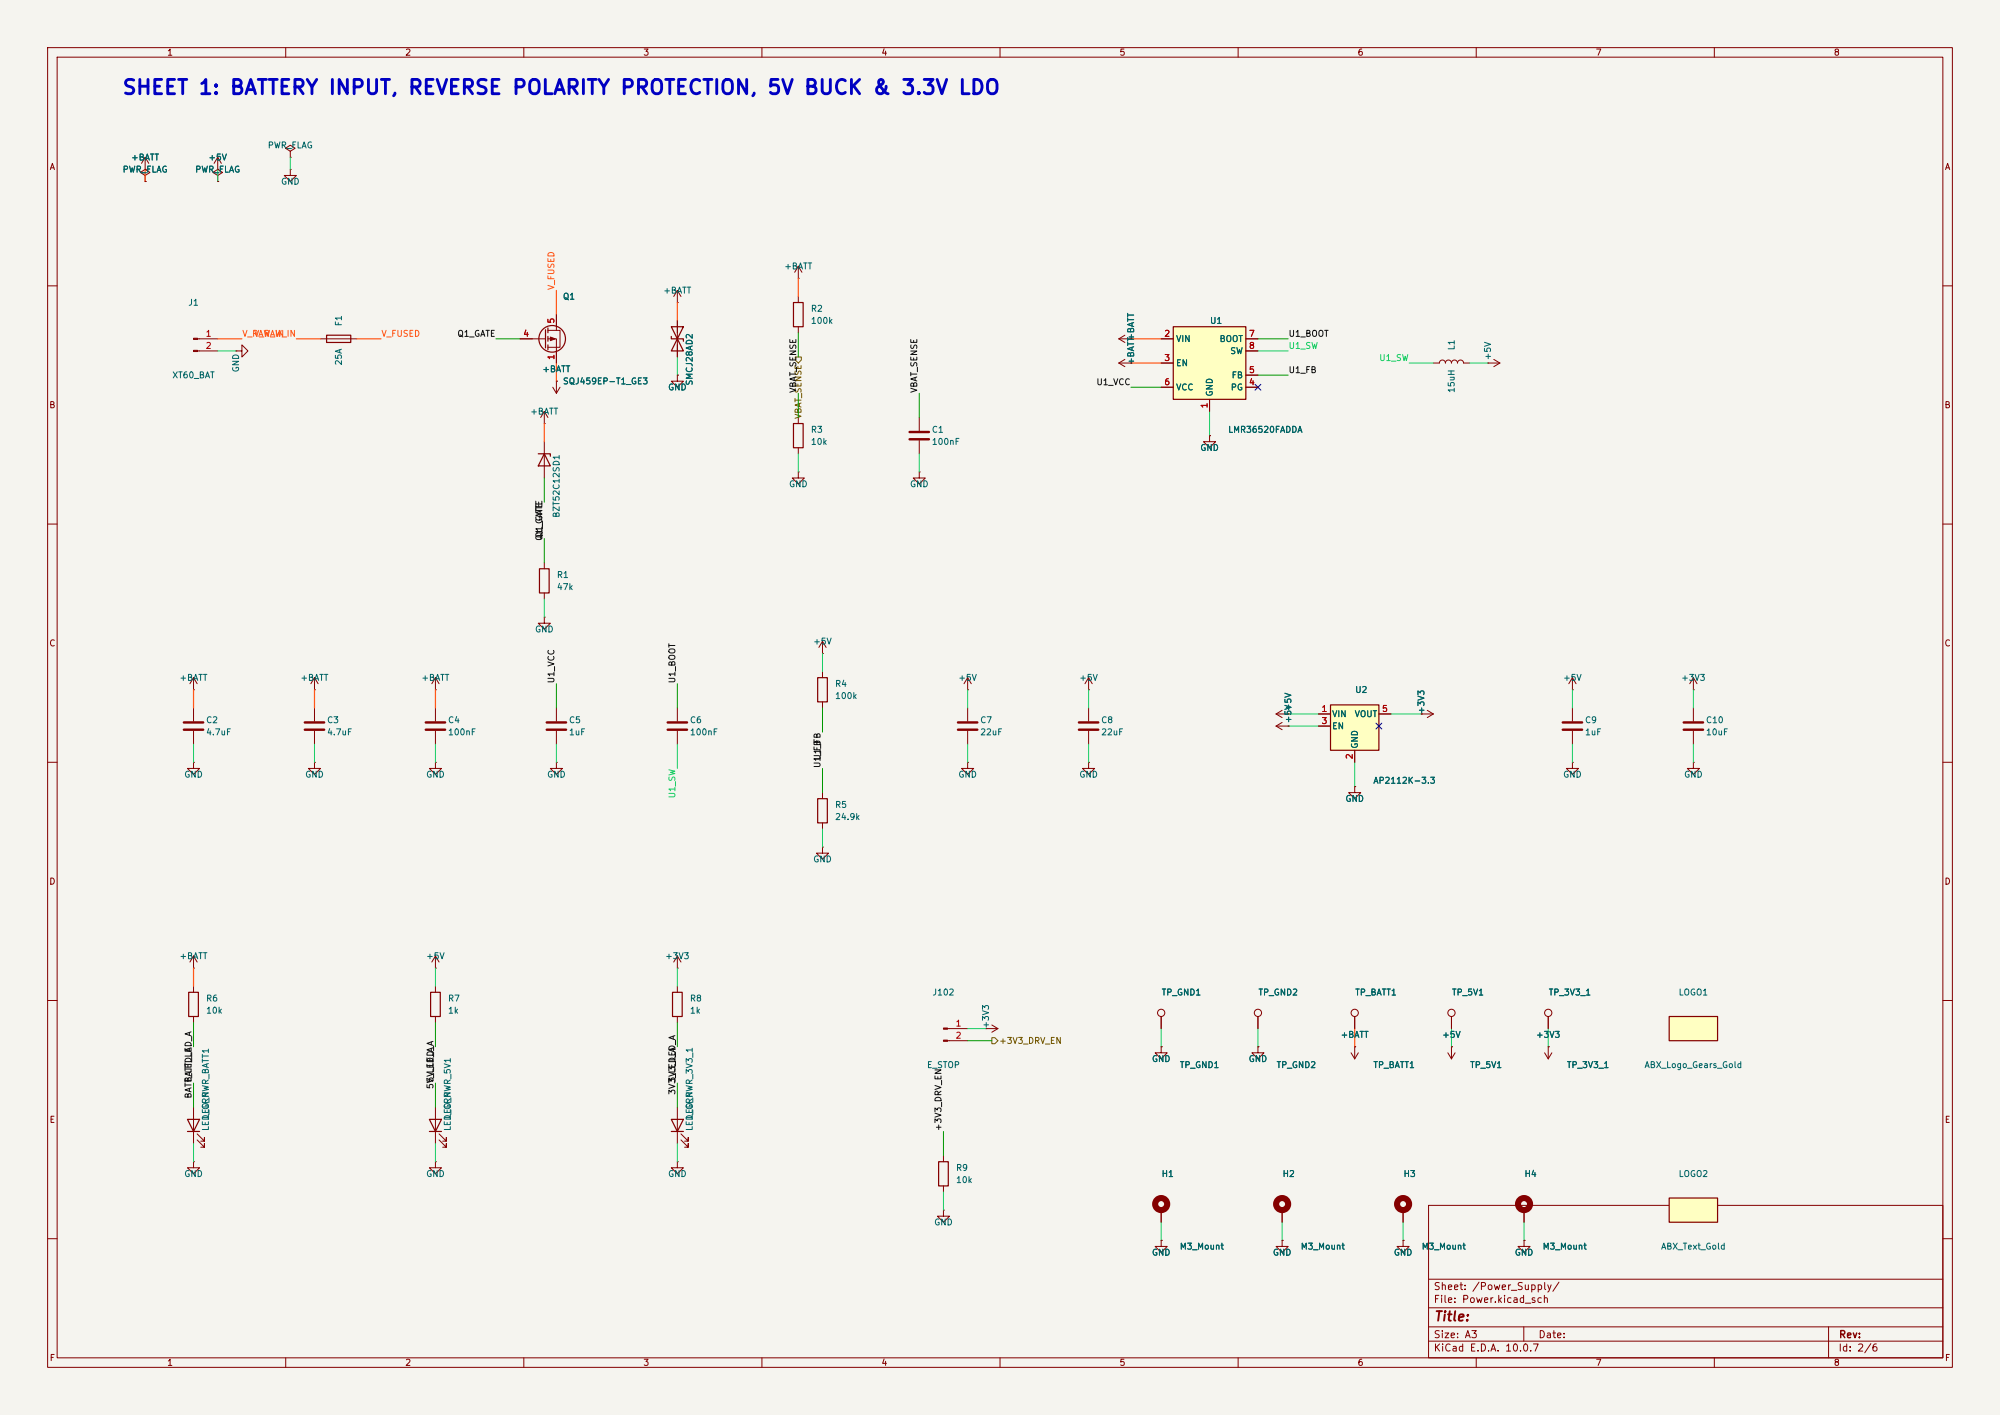
[picture p61: page 2]

V_RAW_IN SHEET 1: BATTERY INPUT, REVERSE POLARITY PROTECTION, 5V BUCK & 3.3V LDO

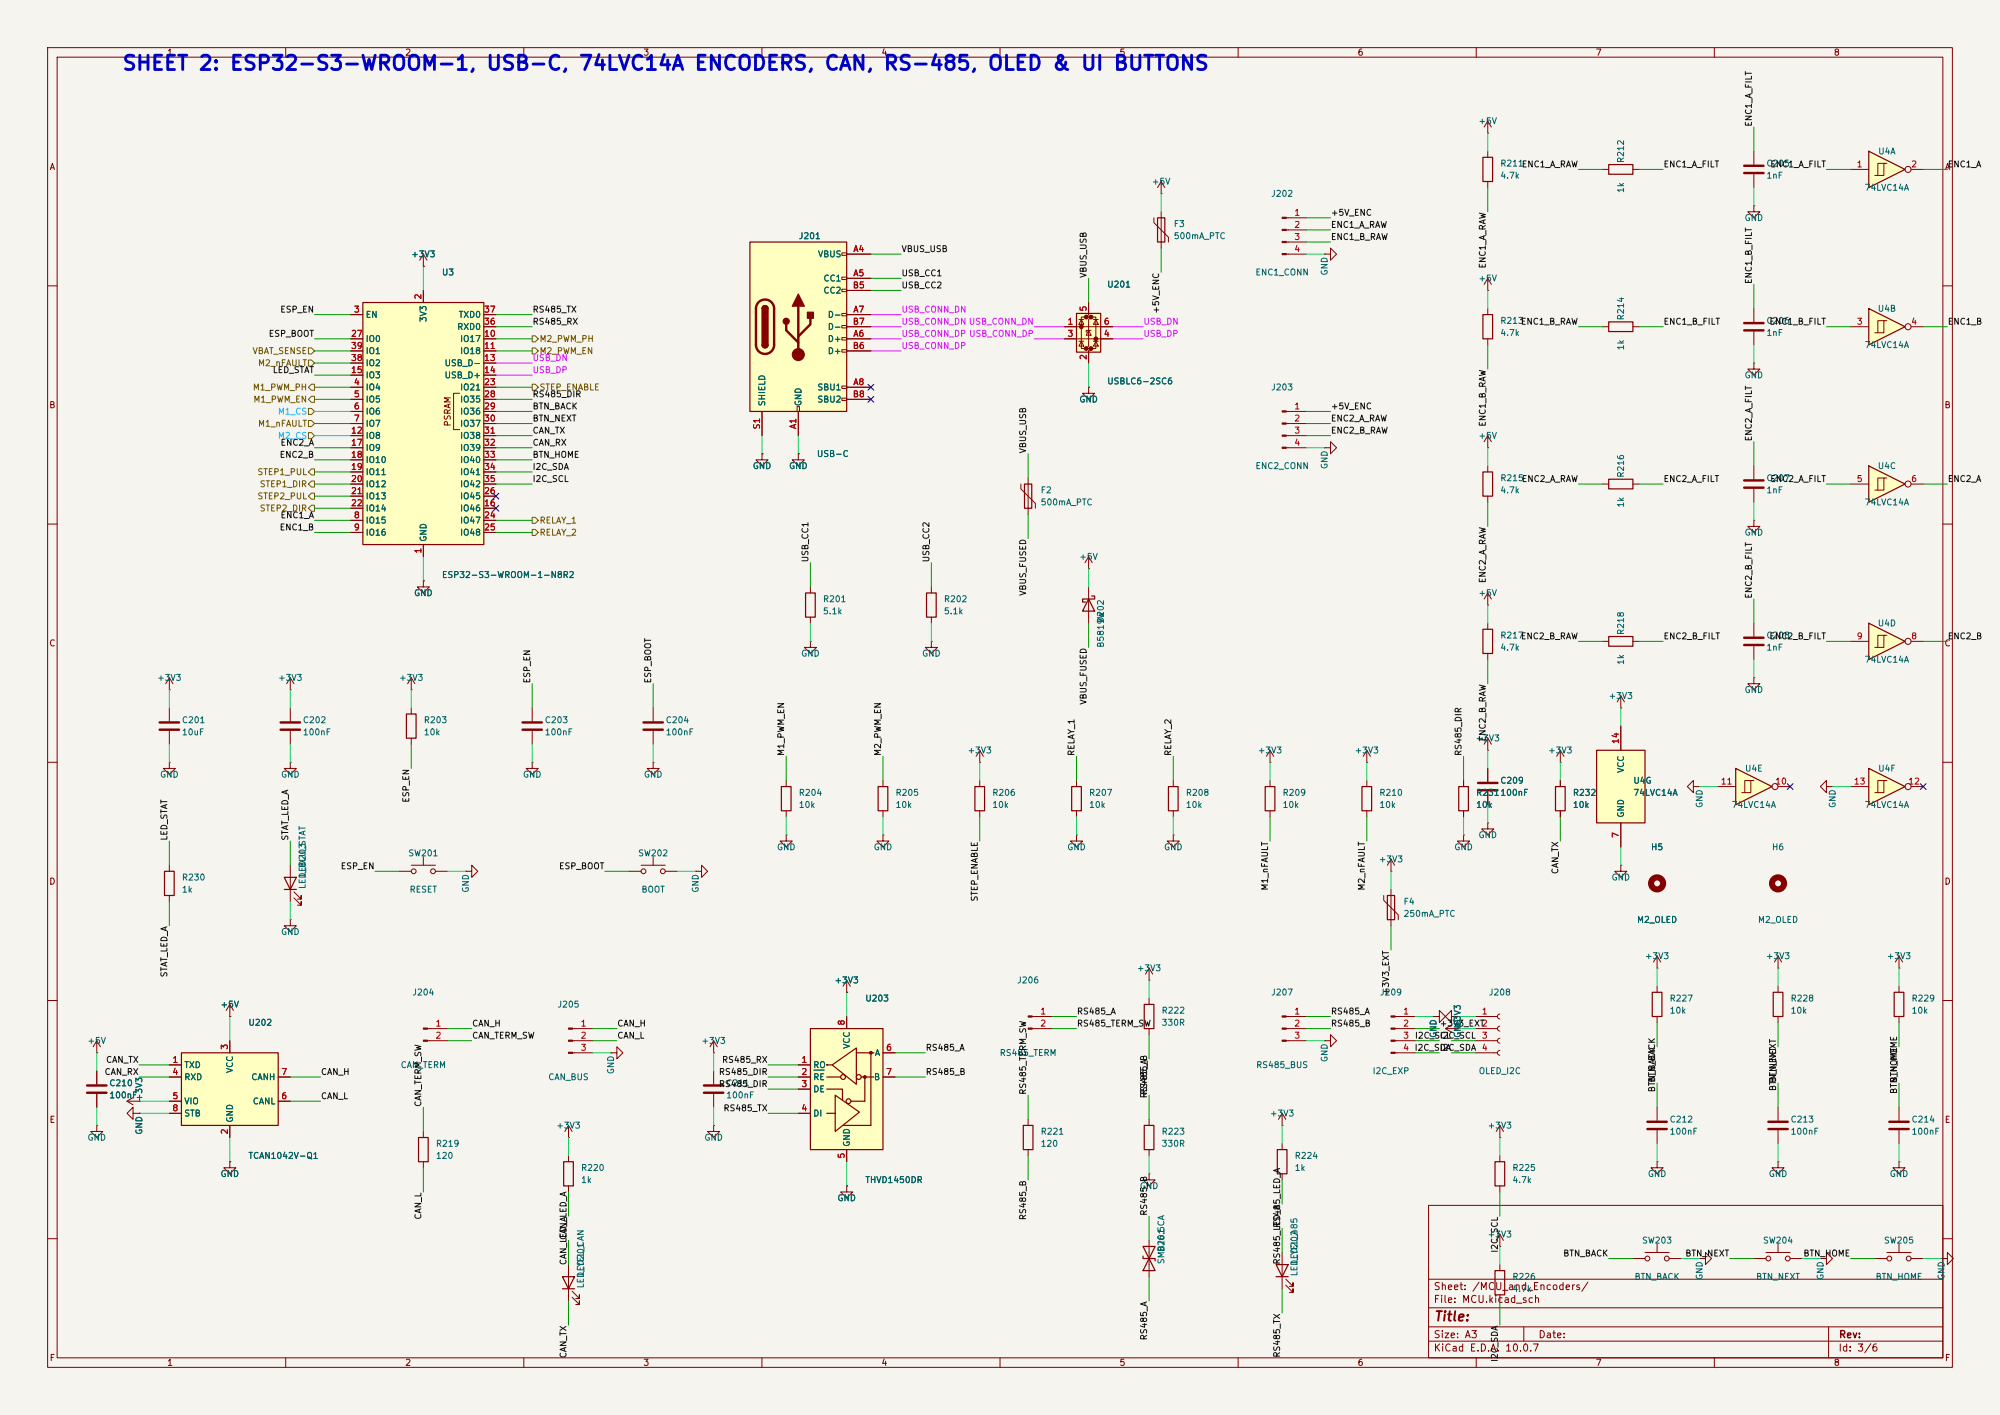
[picture p62: page 3]

SHEET 2: ESP32-S3-WROOM-1, USB-C, 74LVC14A ENCODERS, CAN, RS-485, OLED & UI BUTTONS

SW204 BTN_NEXT GND

Sheet: /MCU_and_Encoders/ File: MCU.kicad_sch

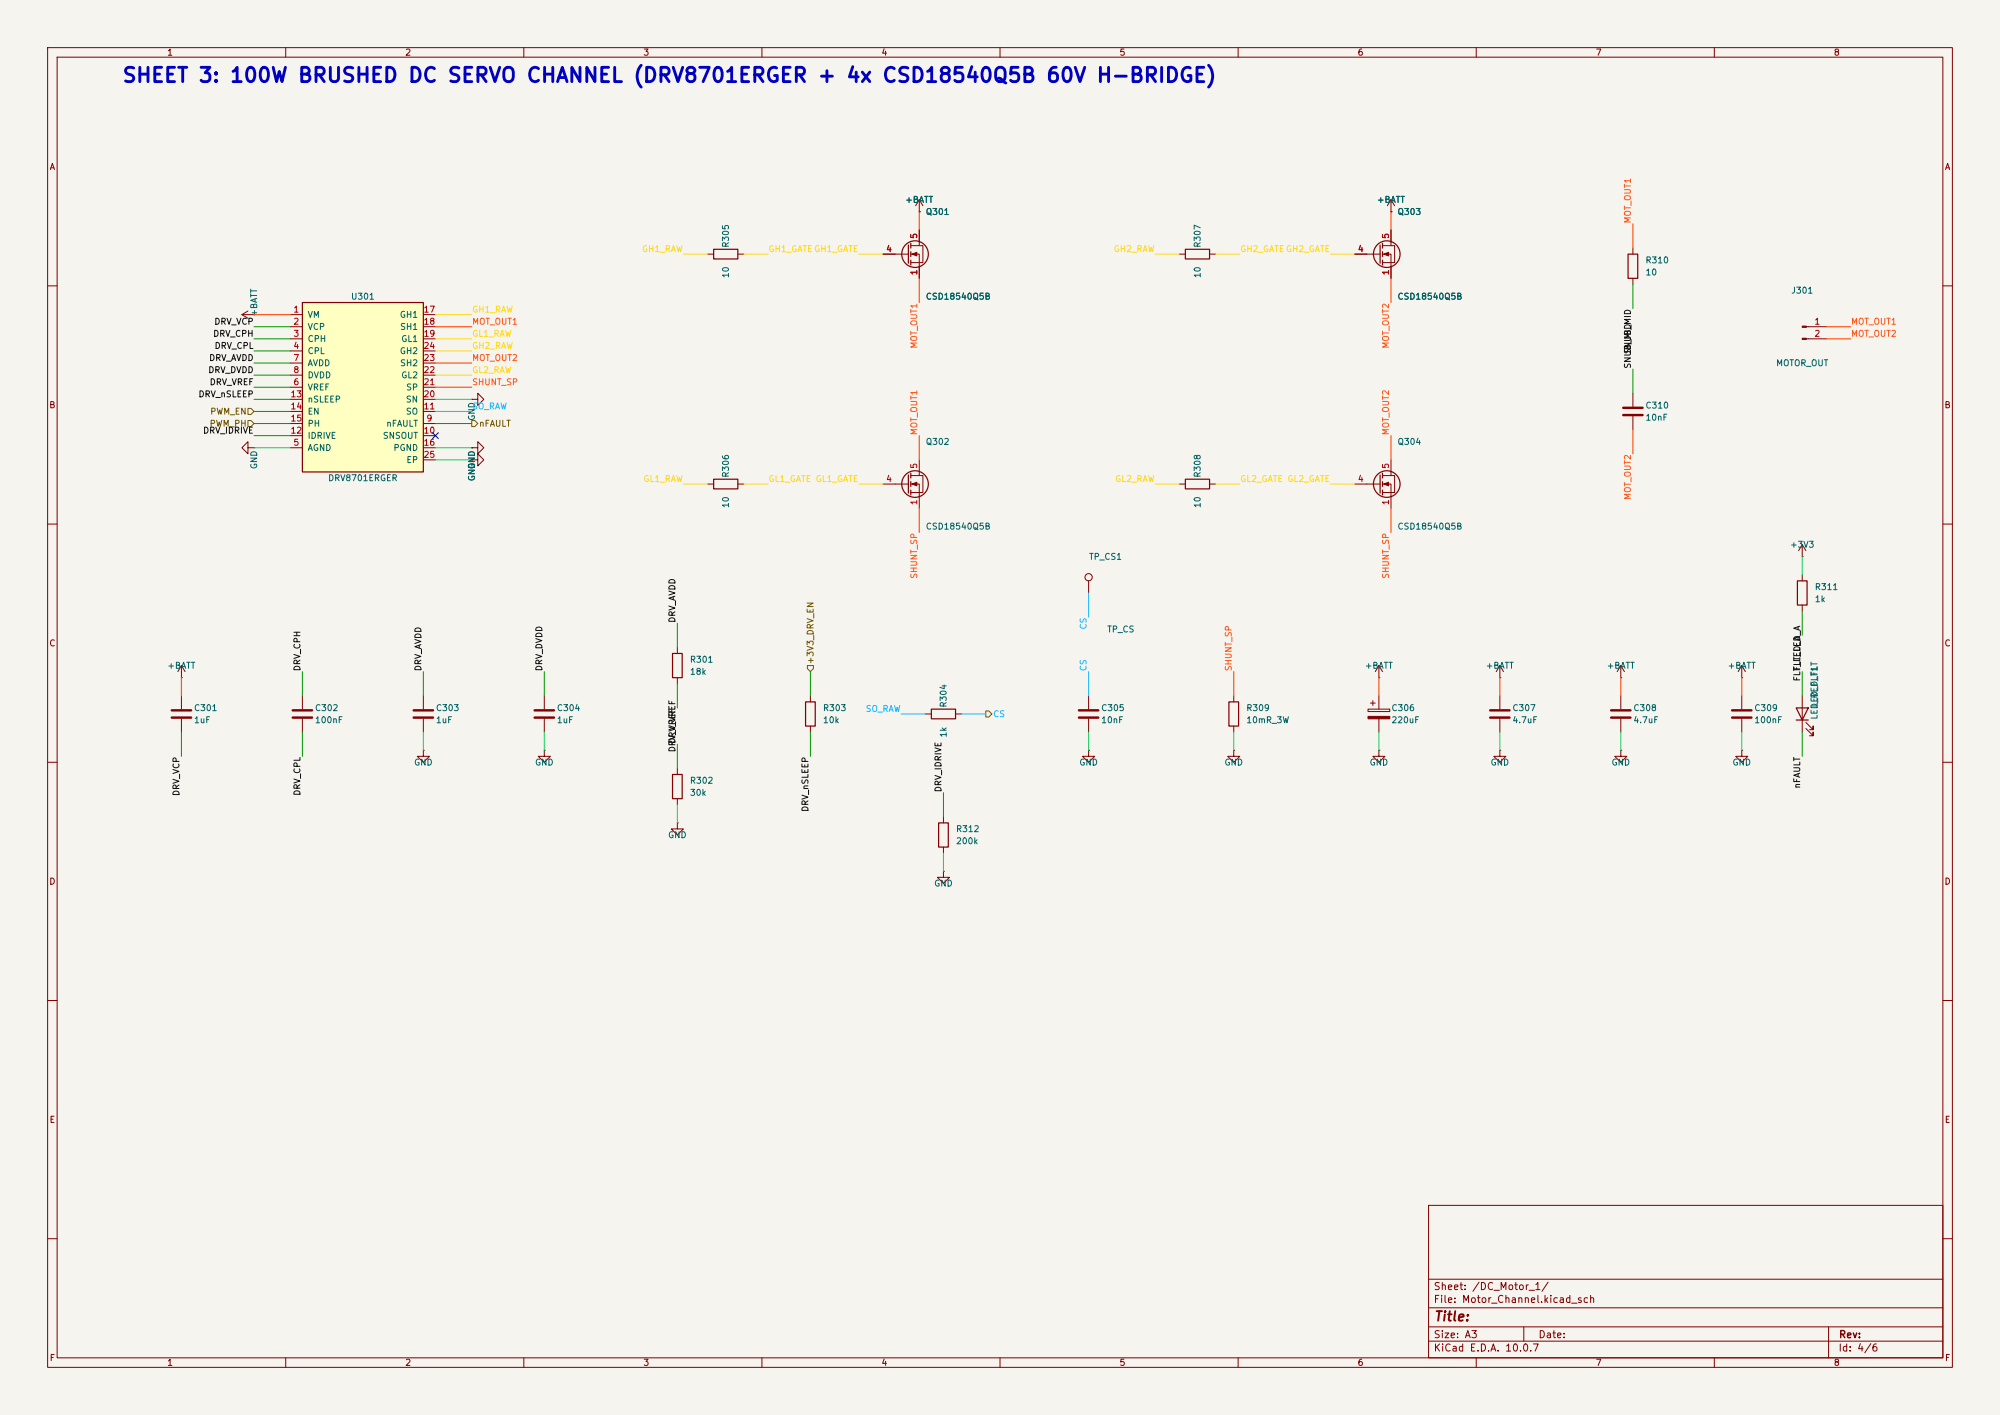
[picture p63: page 4]

SHEET 3: 100W BRUSHED DC SERVO CHANNEL (DRV8701ERGER + 4x CSD18540Q5B 60V H-BRIDGE) GND

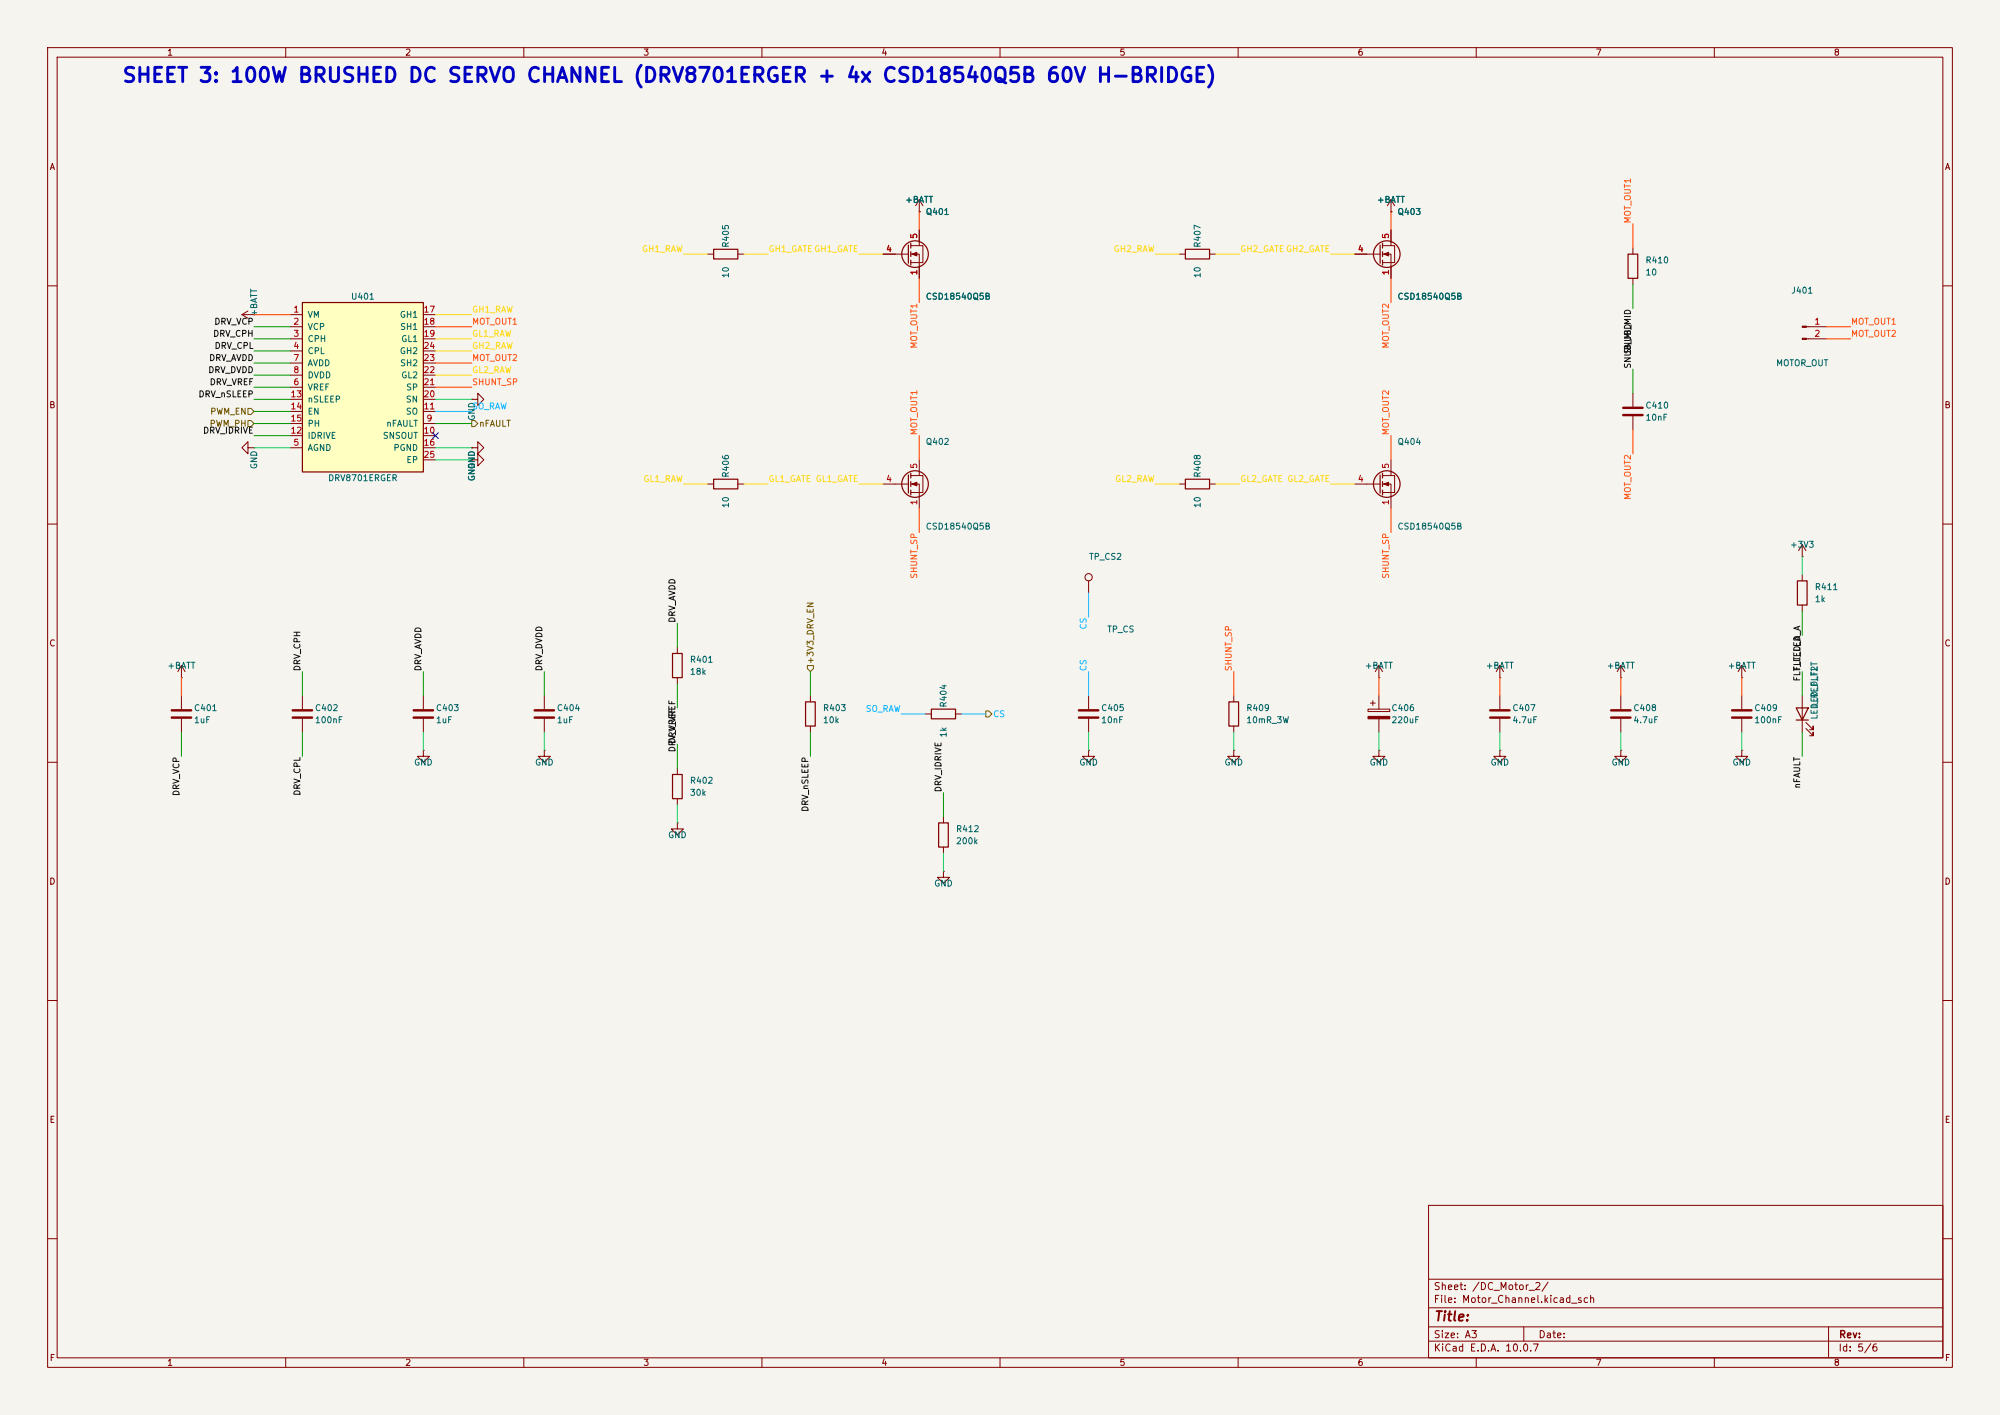
[picture p64: page 5]

SHEET 3: 100W BRUSHED DC SERVO CHANNEL (DRV8701ERGER + 4x CSD18540Q5B 60V H-BRIDGE) GND

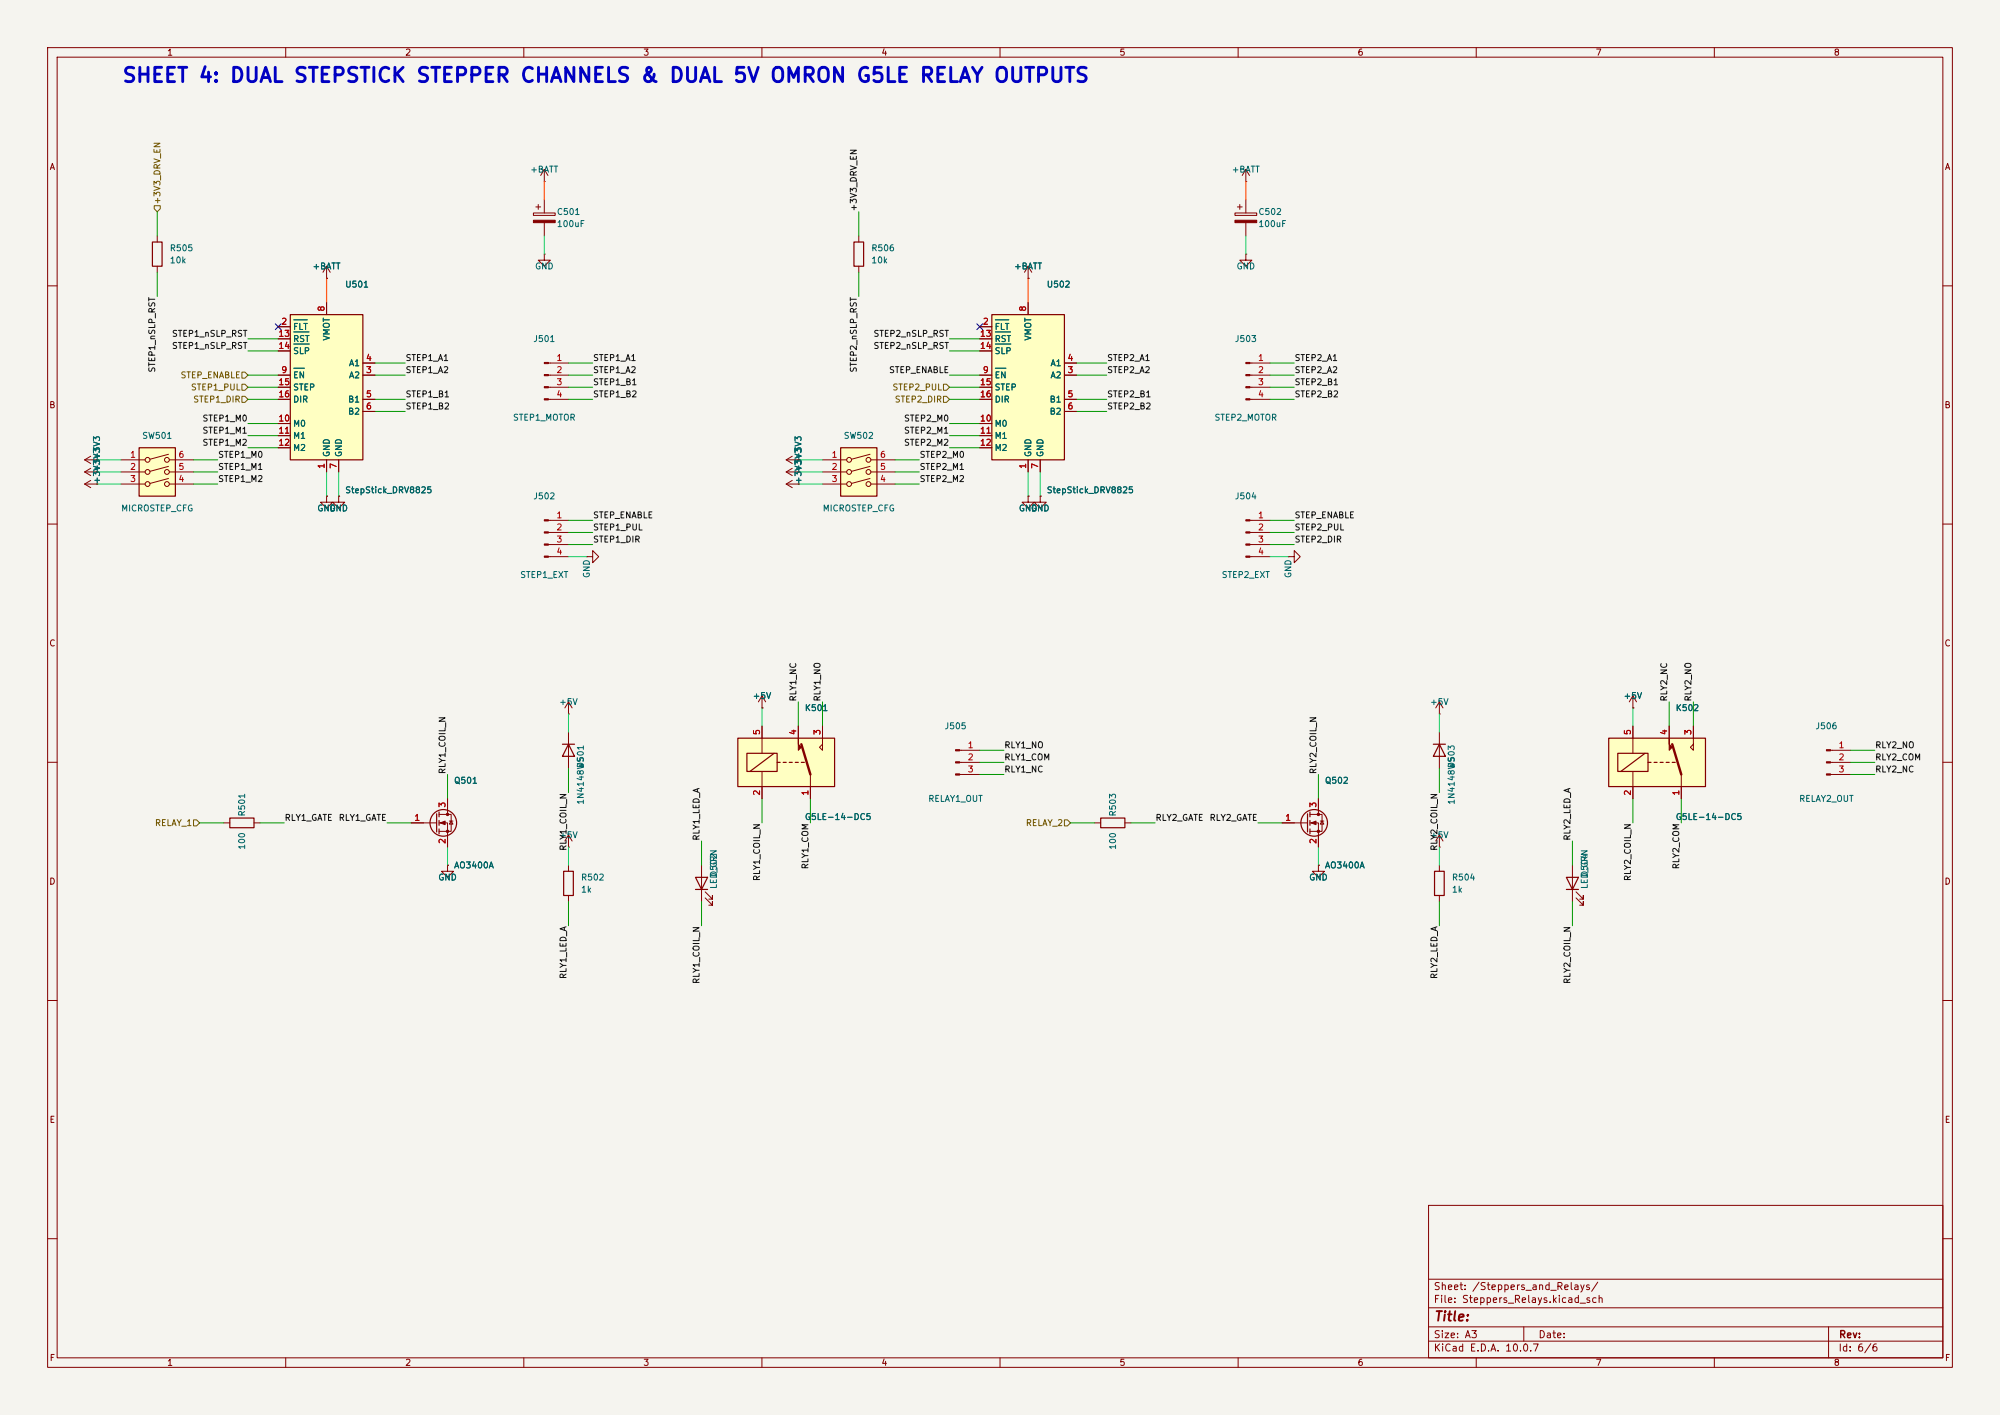
[picture p65: page 6]

STEP2_B2 SHEET 4: DUAL STEPSTICK STEPPER CHANNELS & DUAL 5V OMRON G5LE RELAY OUTPUTS
