levdan159/abx-motion/production/final-20261020/abx-motion-schematics.pdf

Size: A4 | Rev:
KiCad E.D.A. 10.0.7 | Id: 1/7

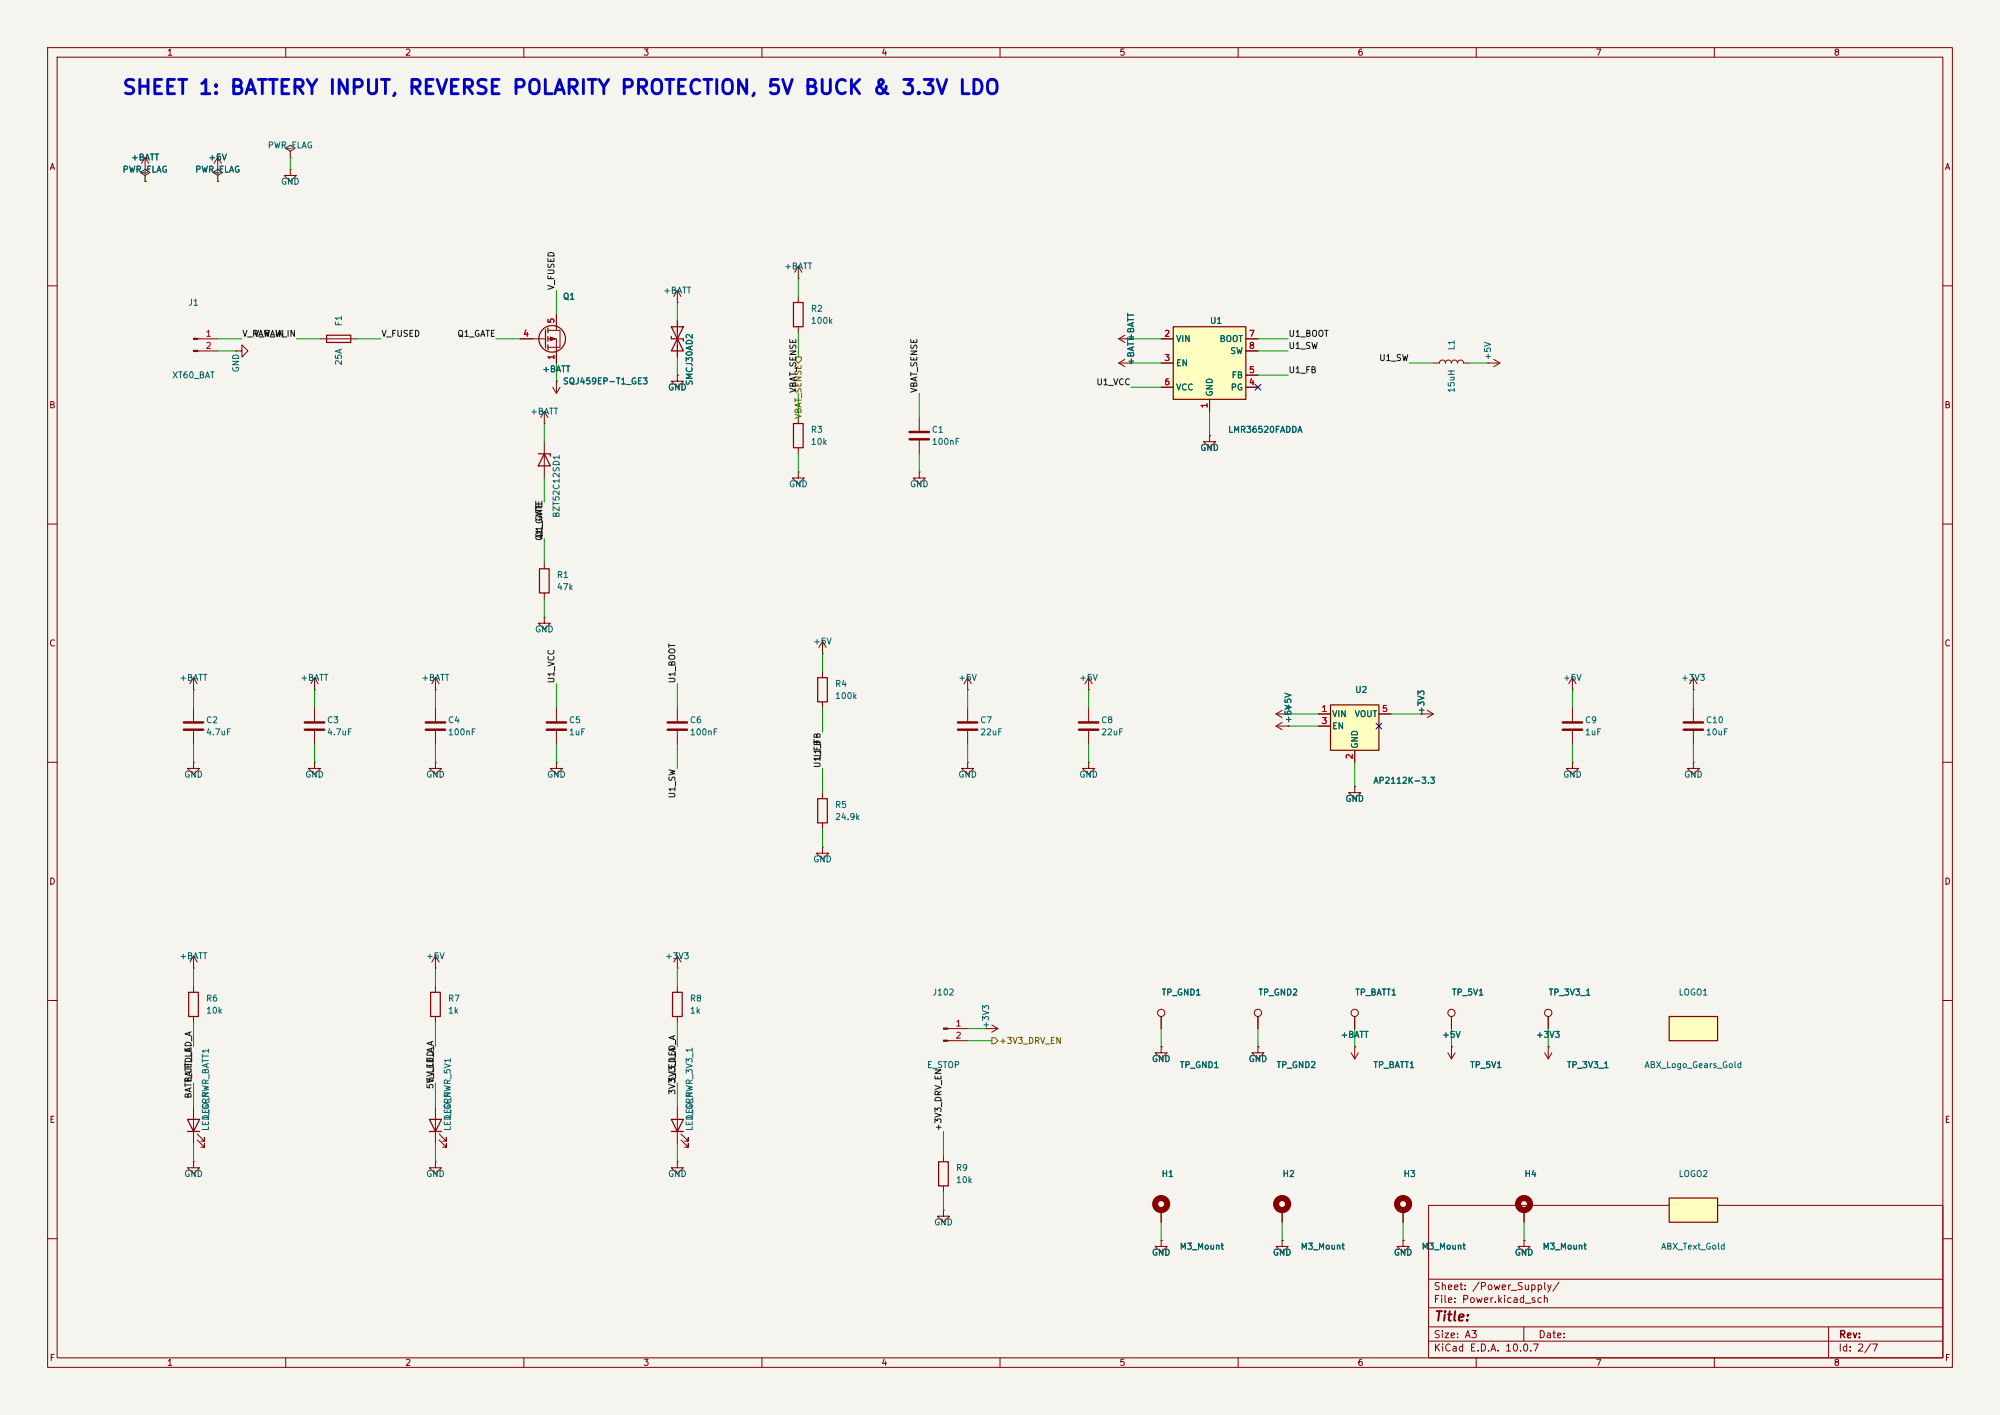
[picture p73: page 2]

V_RAW_IN SHEET 1: BATTERY INPUT, REVERSE POLARITY PROTECTION, 5V BUCK & 3.3V LDO


SHEET 2: ESP32-S3-WROOM-1, USB-C, 74LVC14A ENCODERS, CAN, RS-485, OLED & UI BUTTONS

4.7k R225 SW205 BTN_HOME GND

File: MCU.kicad_sch

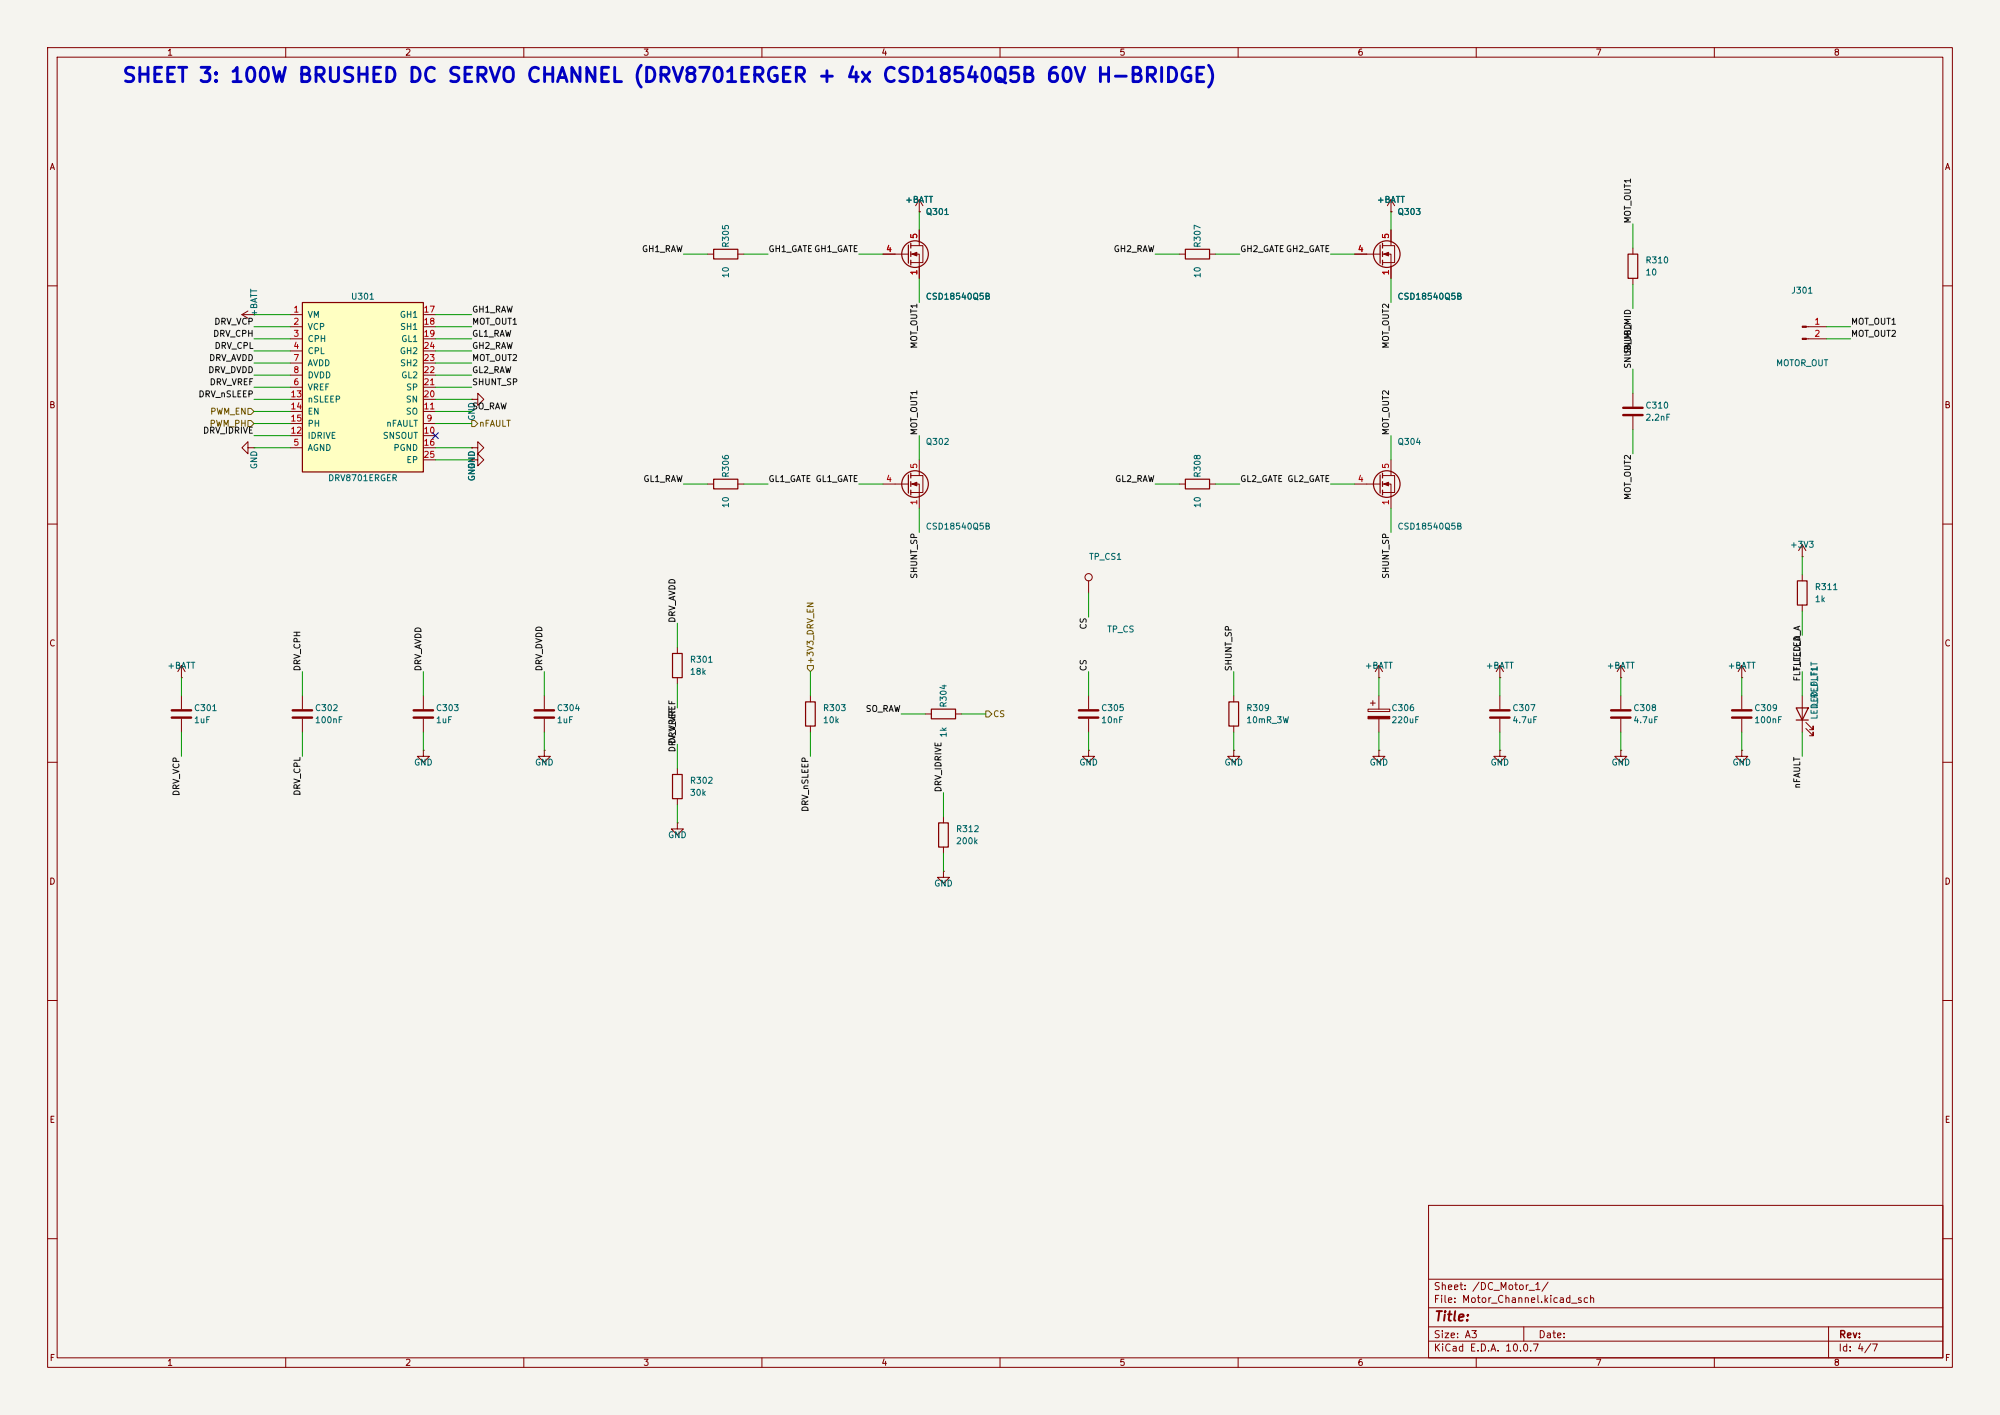
[picture p74: page 4]

SHEET 3: 100W BRUSHED DC SERVO CHANNEL (DRV8701ERGER + 4x CSD18540Q5B 60V H-BRIDGE) GND

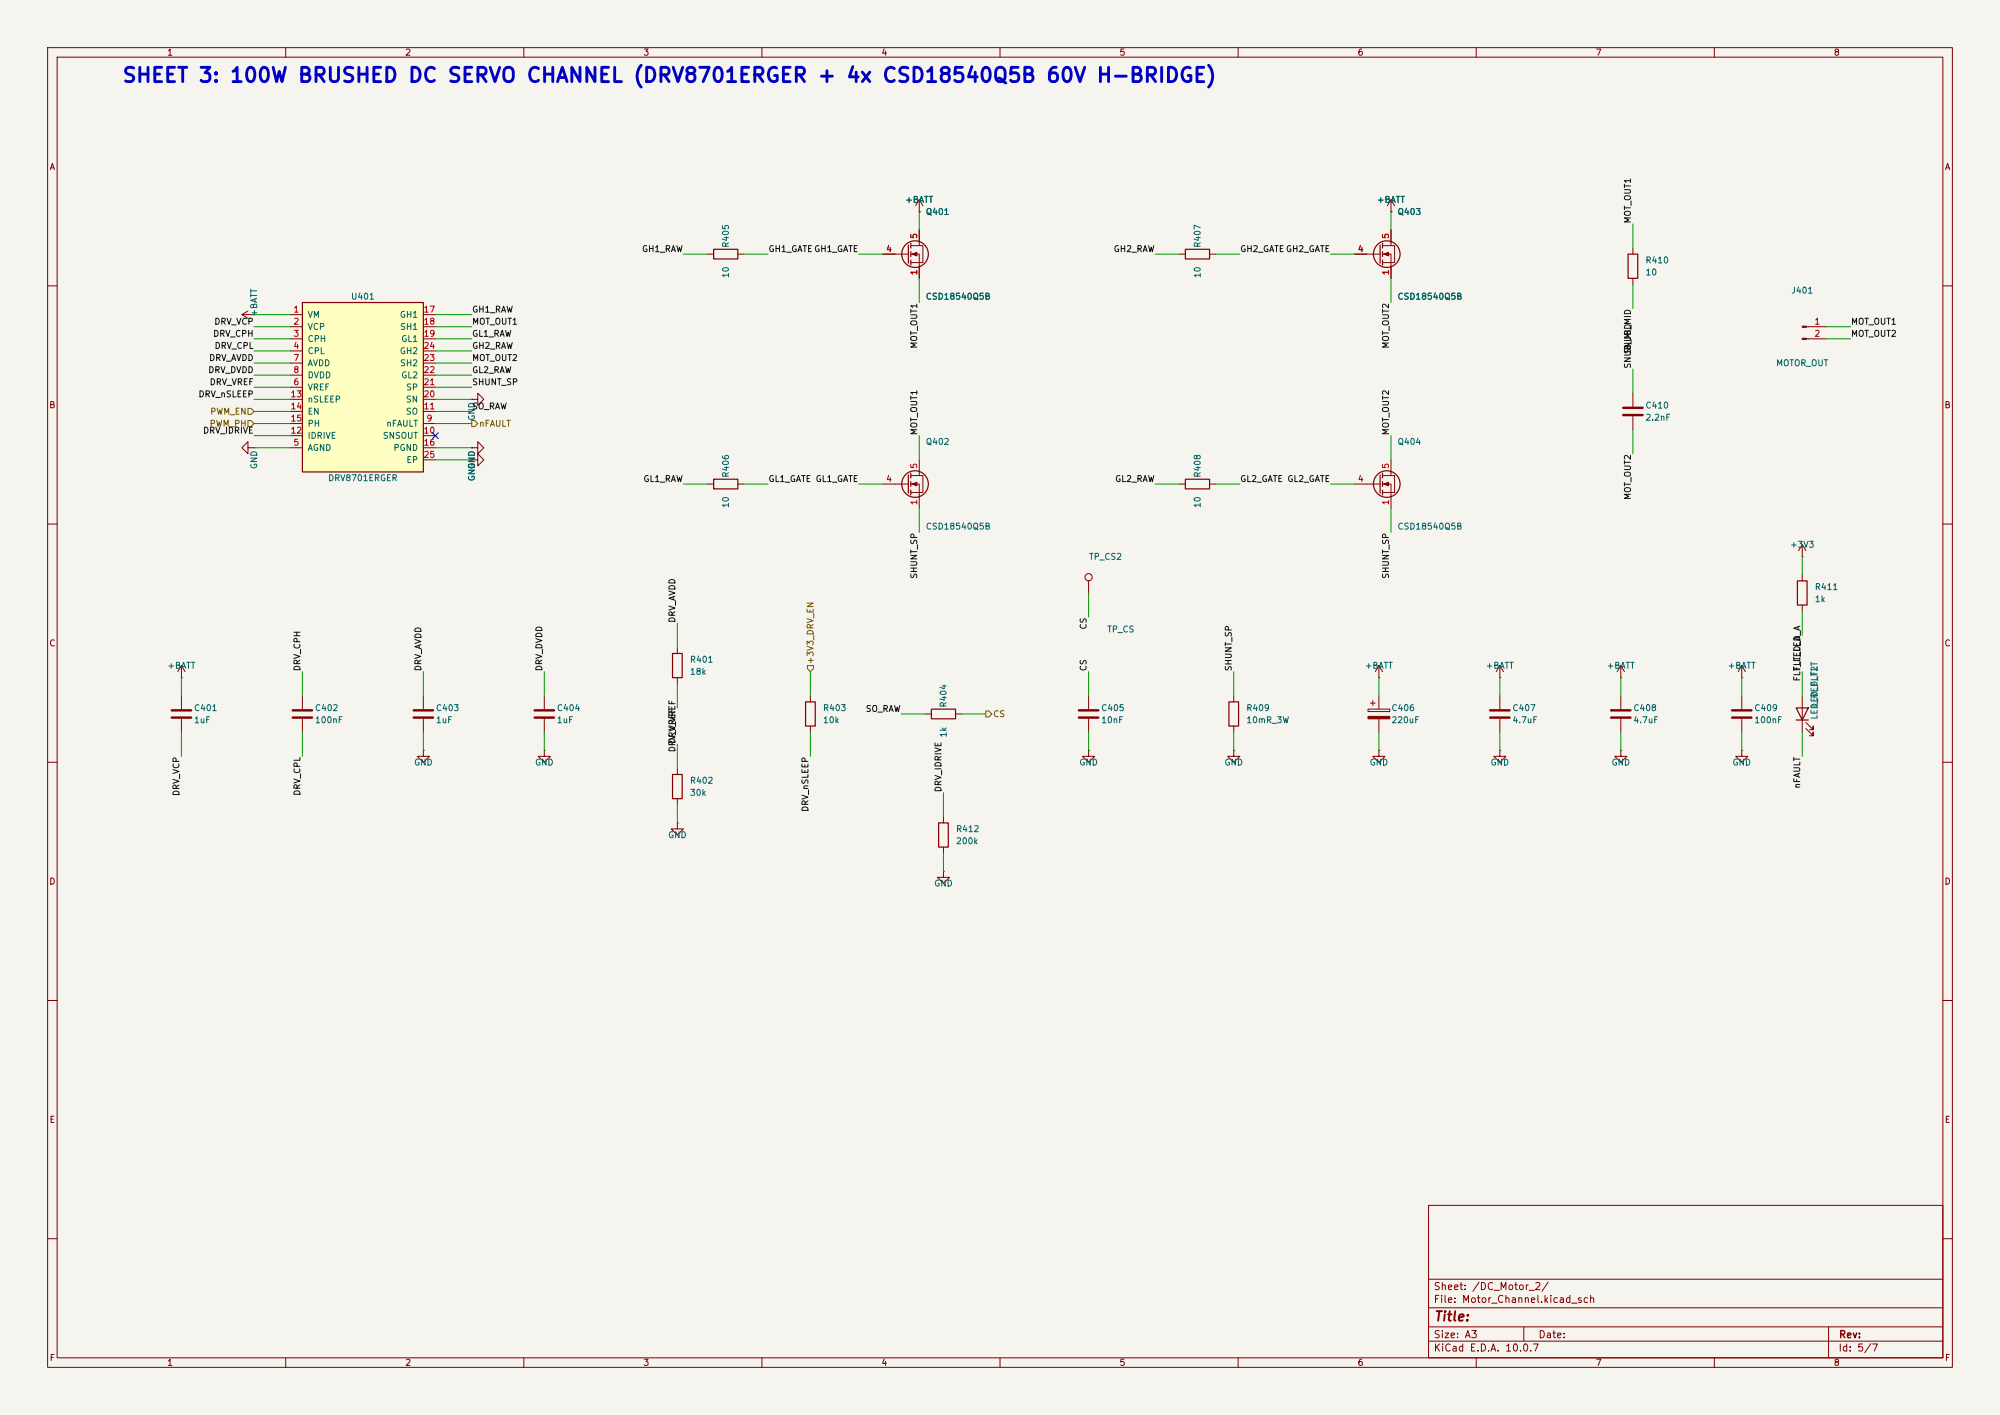
[picture p75: page 5]

SHEET 3: 100W BRUSHED DC SERVO CHANNEL (DRV8701ERGER + 4x CSD18540Q5B 60V H-BRIDGE) GND



OUT1_GATE SHEET 5: 6x 3-PIN JST-PH INDUSTRIAL I/O (8x LIMIT/GPIO + 2x 5V/500mA DC OUTPUTS) & PCA9555PW EXPANDER
