levdan159/abx-motion/renders/abx-motion.pdf

Size: A4 | Rev:
KiCad E.D.A. 10.0.7 | Id: 1/6


V_RAW_IN SHEET 1: BATTERY INPUT, REVERSE POLARITY PROTECTION, 5V BUCK & 3.3V LDO


SHEET 2: ESP32-S3-WROOM-1, USB-C, 74LVC14A ENCODERS, CAN, RS-485, OLED & UI BUTTONS

SW204 BTN_NEXT GND

Sheet: /MCU_and_Encoders/ File: MCU.kicad_sch


SHEET 3: 100W BRUSHED DC SERVO CHANNEL (DRV8701ERGER + 4x CSD18540Q5B 60V H-BRIDGE) GND


SHEET 3: 100W BRUSHED DC SERVO CHANNEL (DRV8701ERGER + 4x CSD18540Q5B 60V H-BRIDGE) GND


STEP2_B2 SHEET 4: DUAL STEPSTICK STEPPER CHANNELS & DUAL 5V OMRON G5LE RELAY OUTPUTS
