levdan159/abx-motion/renders/pcb_bottom.pdf

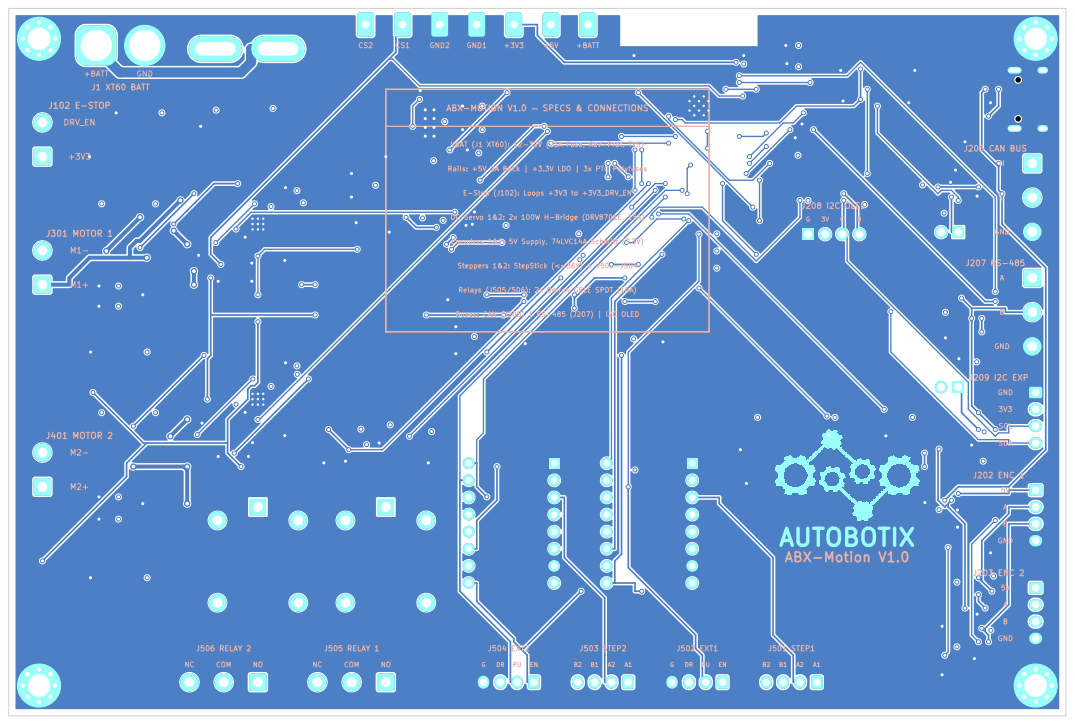
[picture p93: page 1]

Size: A4 | Rev:
KiCad E.D.A. 10.0.7 | Id: 1/1
