levdan159/abx-motion/production/abx-motion-manufacturing_20261019_1253/abx-motion-pcb_20261019_1253.pdf

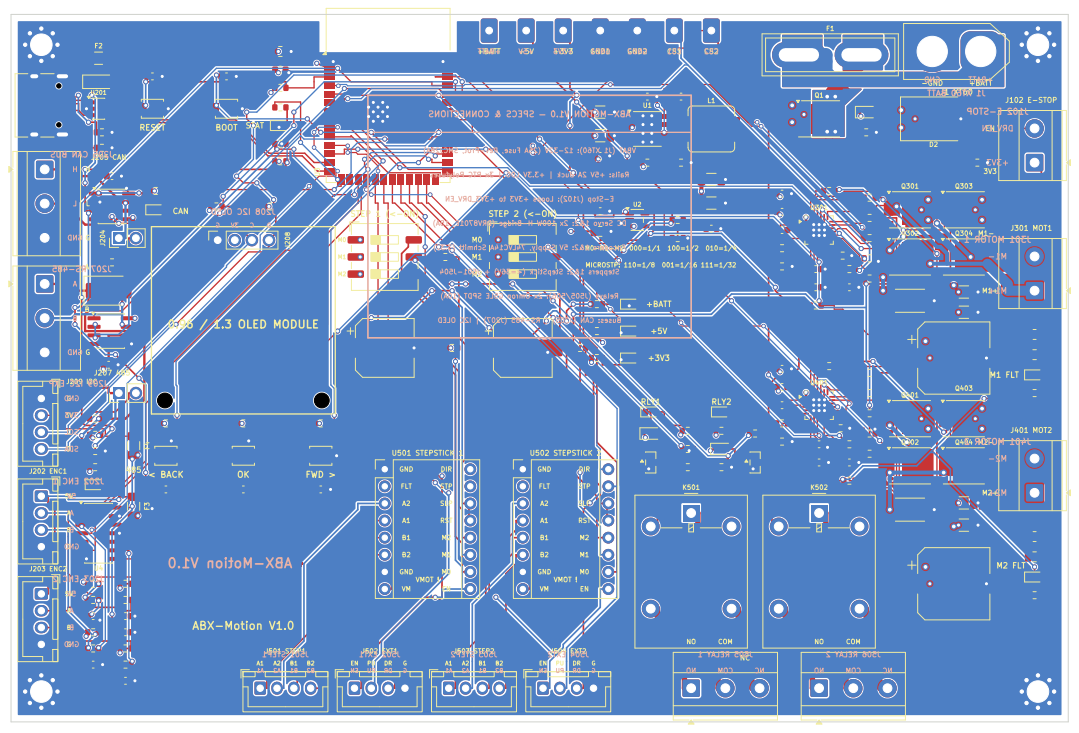
[picture p94: page 1]
