levdan159/abx-motion/renders/pcb_placement.pdf

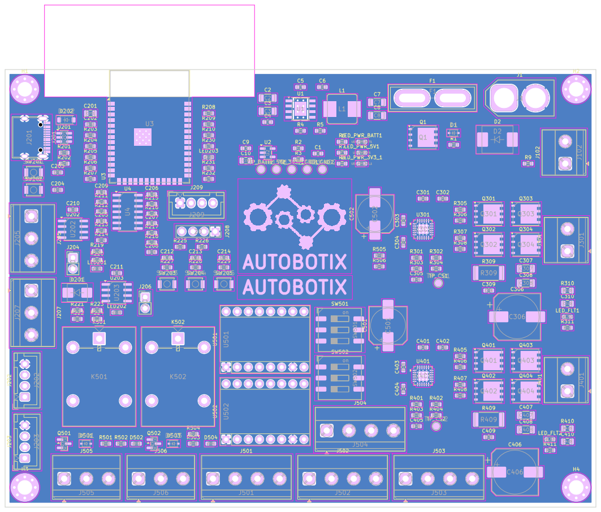
[picture p95: page 1]
