levdan159/abx-motion/renders/pcb_top.pdf

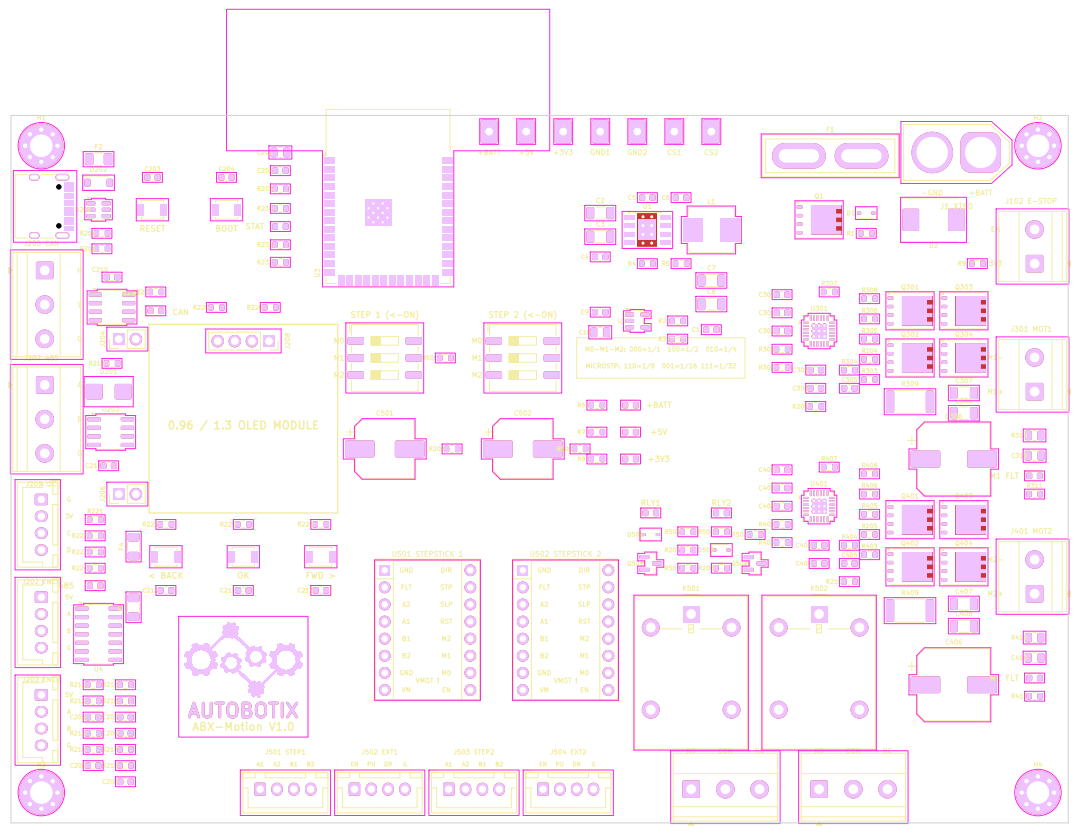
[picture p96: page 1]
