levdan159/abx-motion/design/rev-1.2-research/sources/evm-common-layerplots.pdf

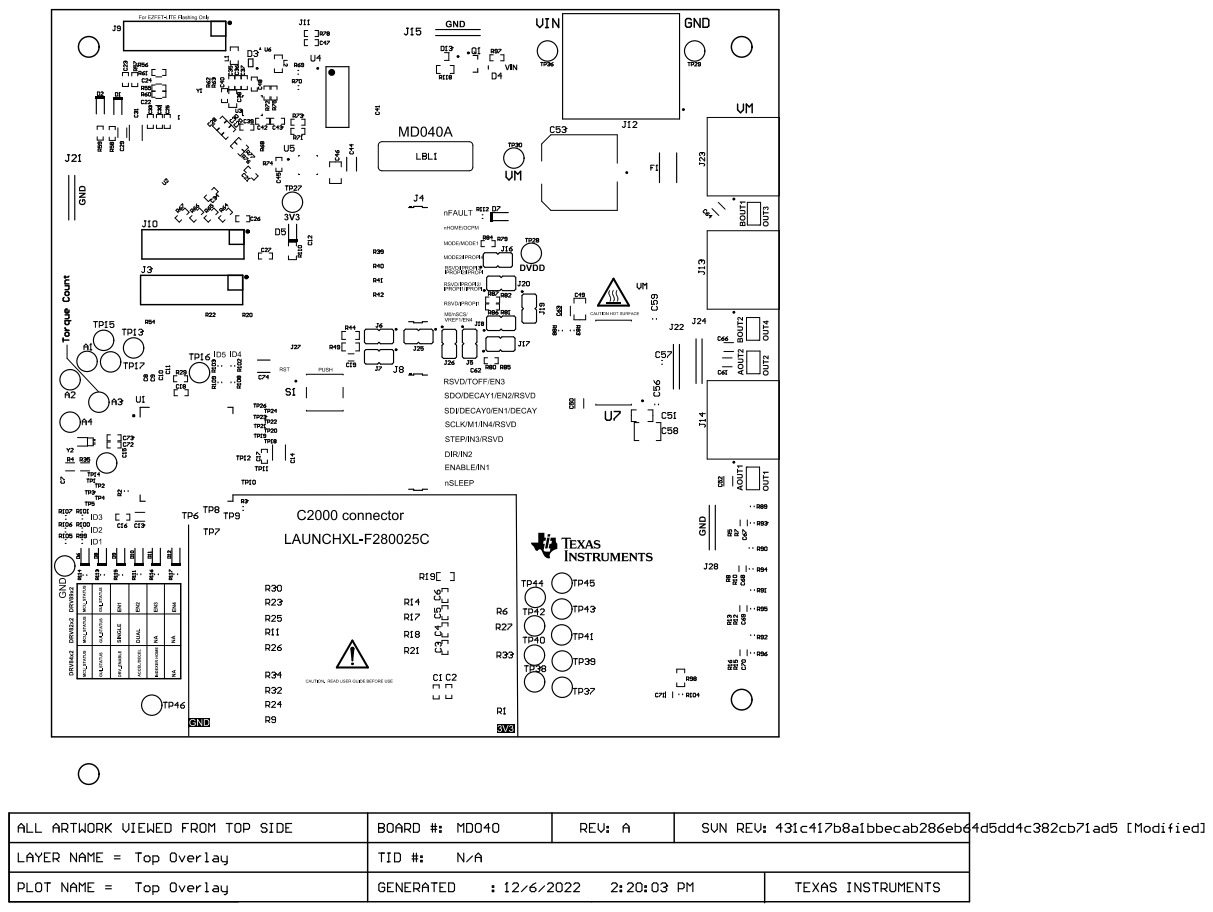
[picture p97: page 1]

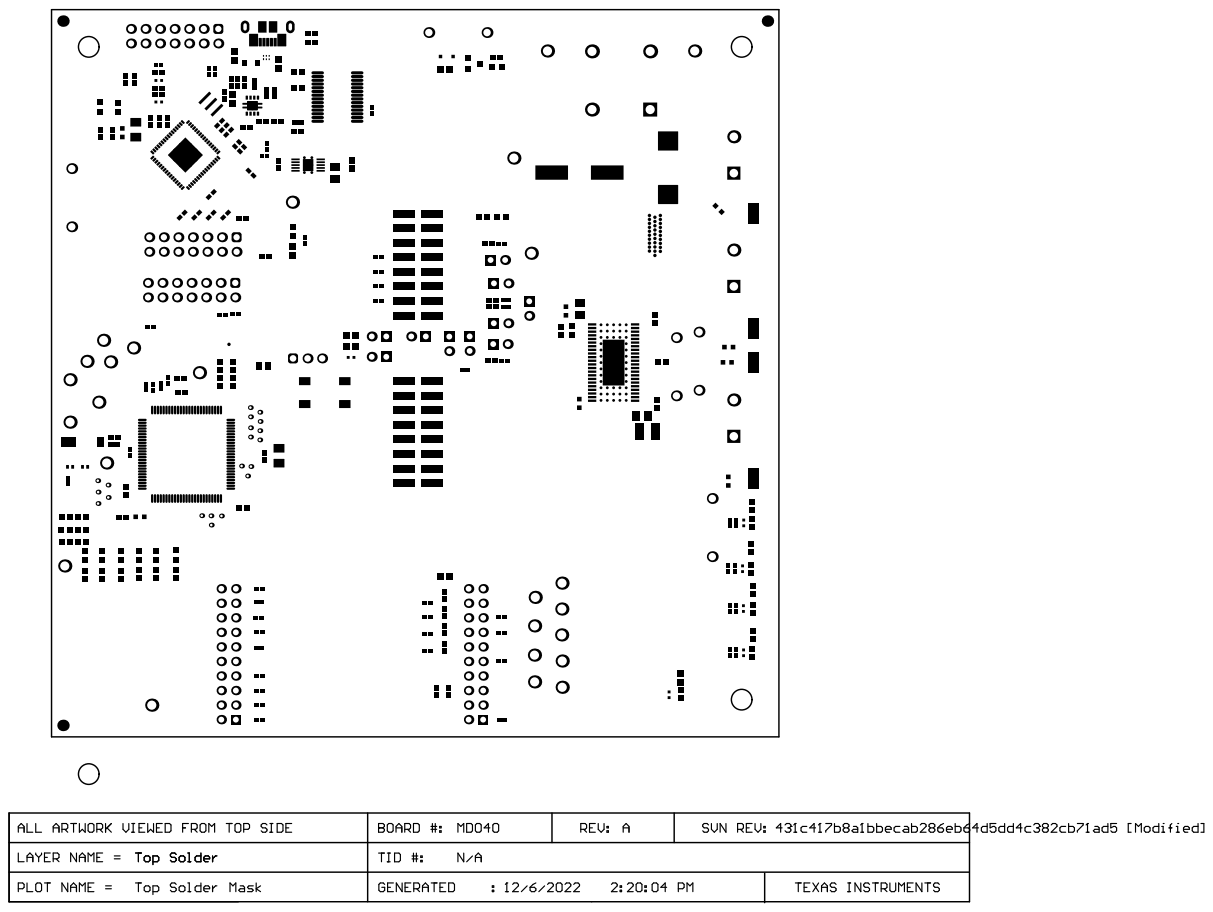
[picture p98: page 2]

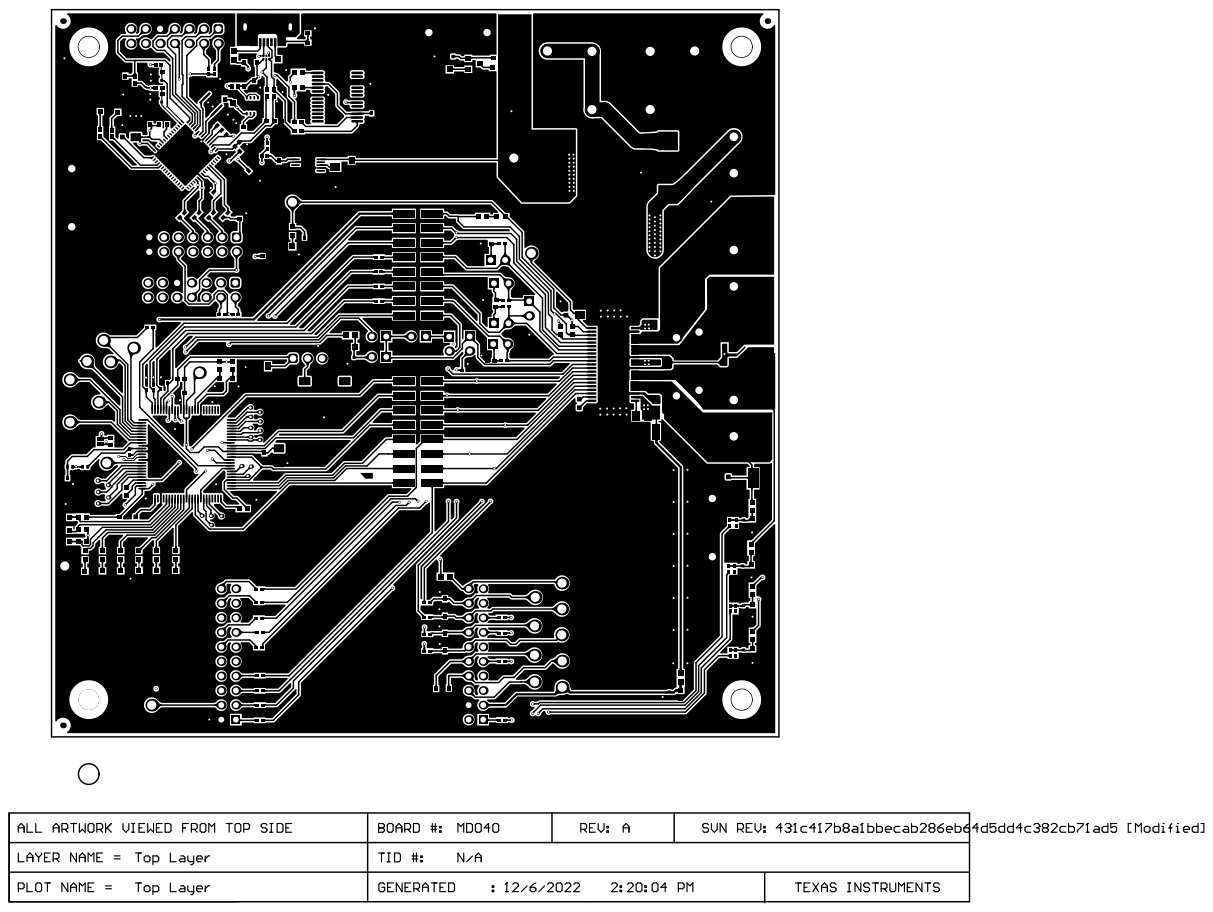
[picture p99: page 3]

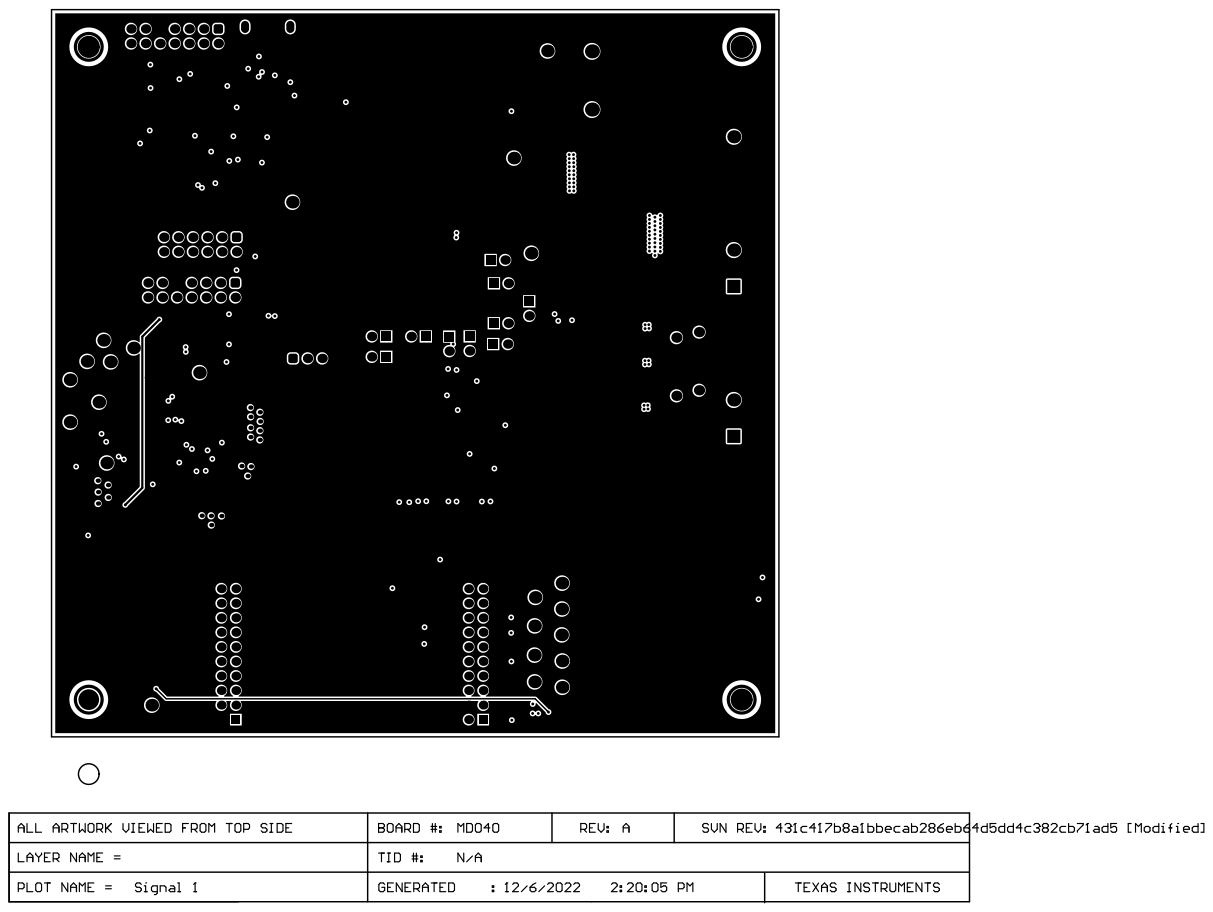
[picture p100: page 4]

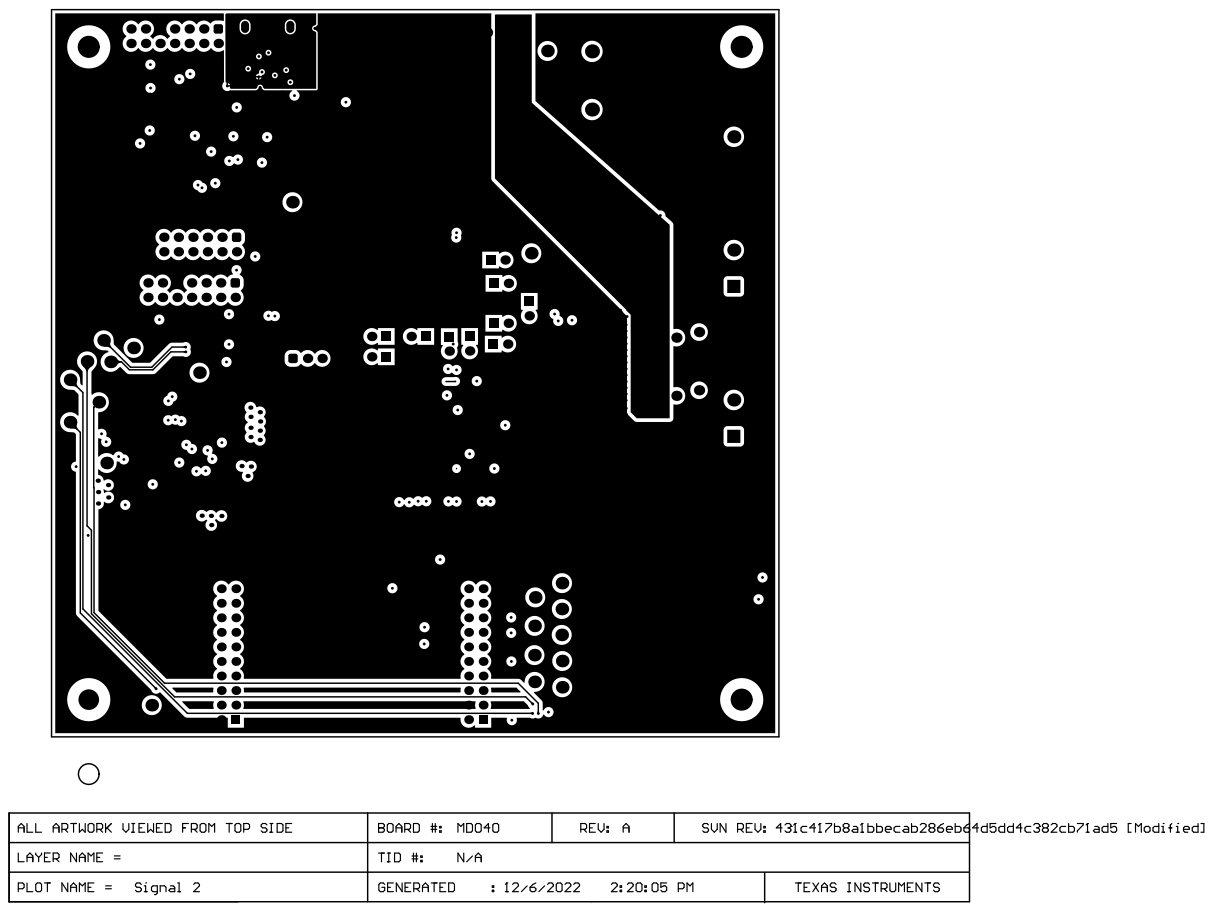
[picture p101: page 5]

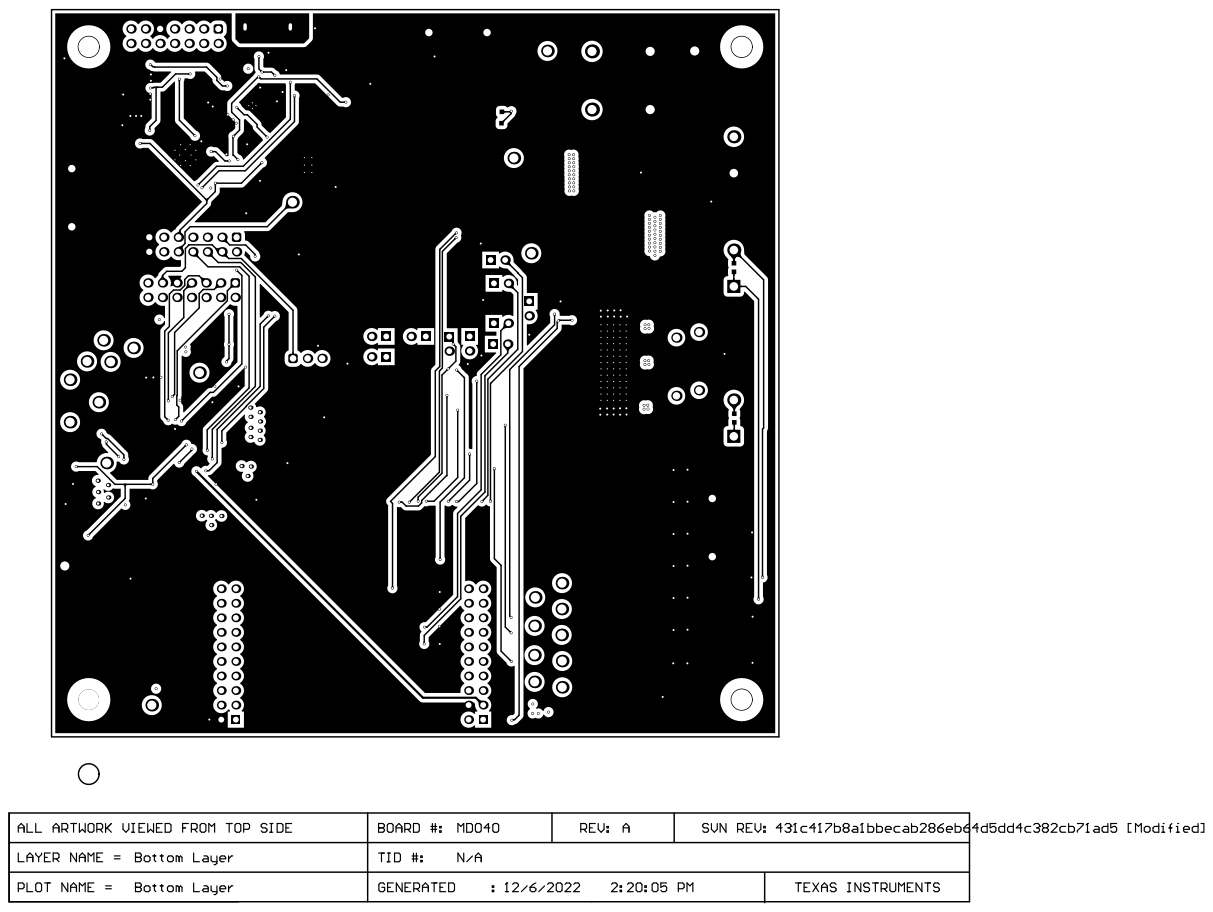
[picture p102: page 6]

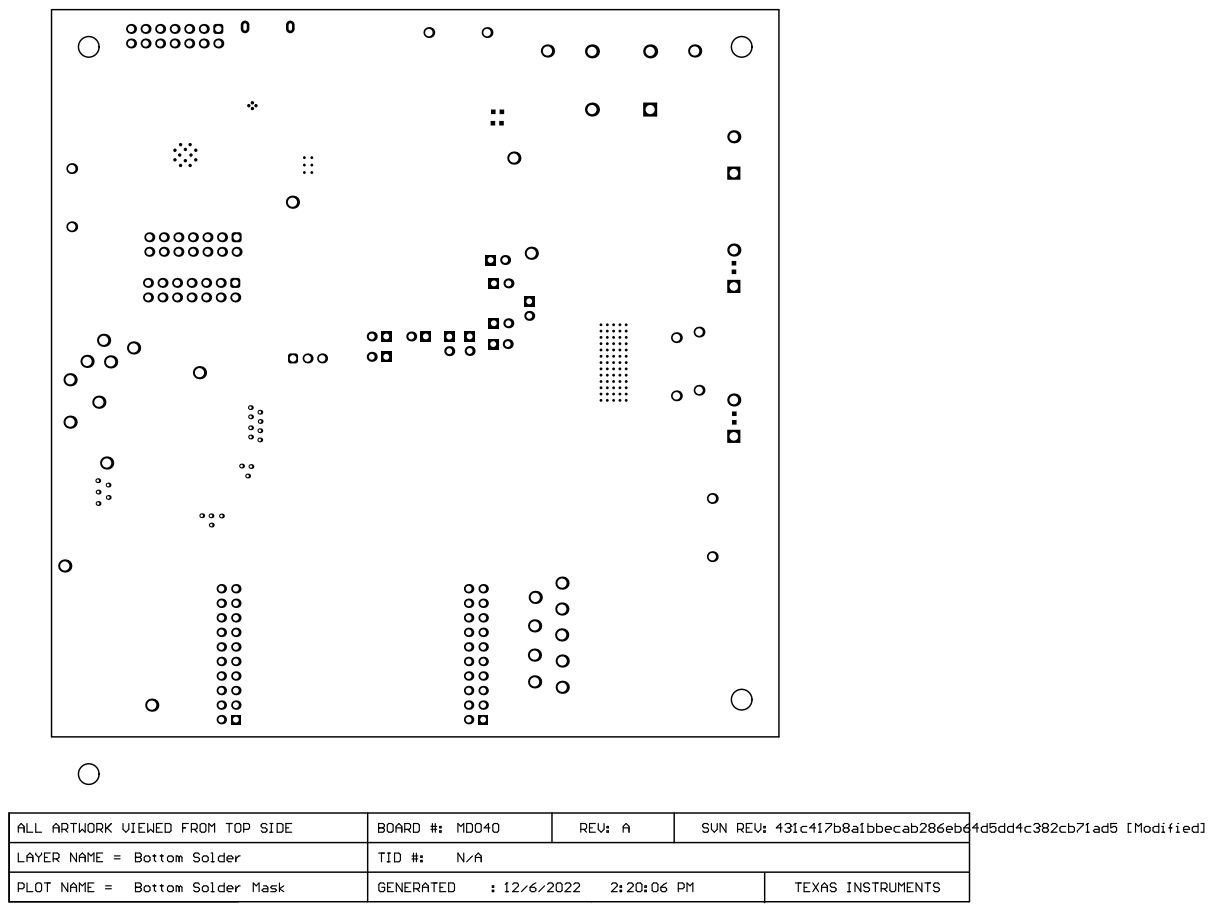
[picture p103: page 7]

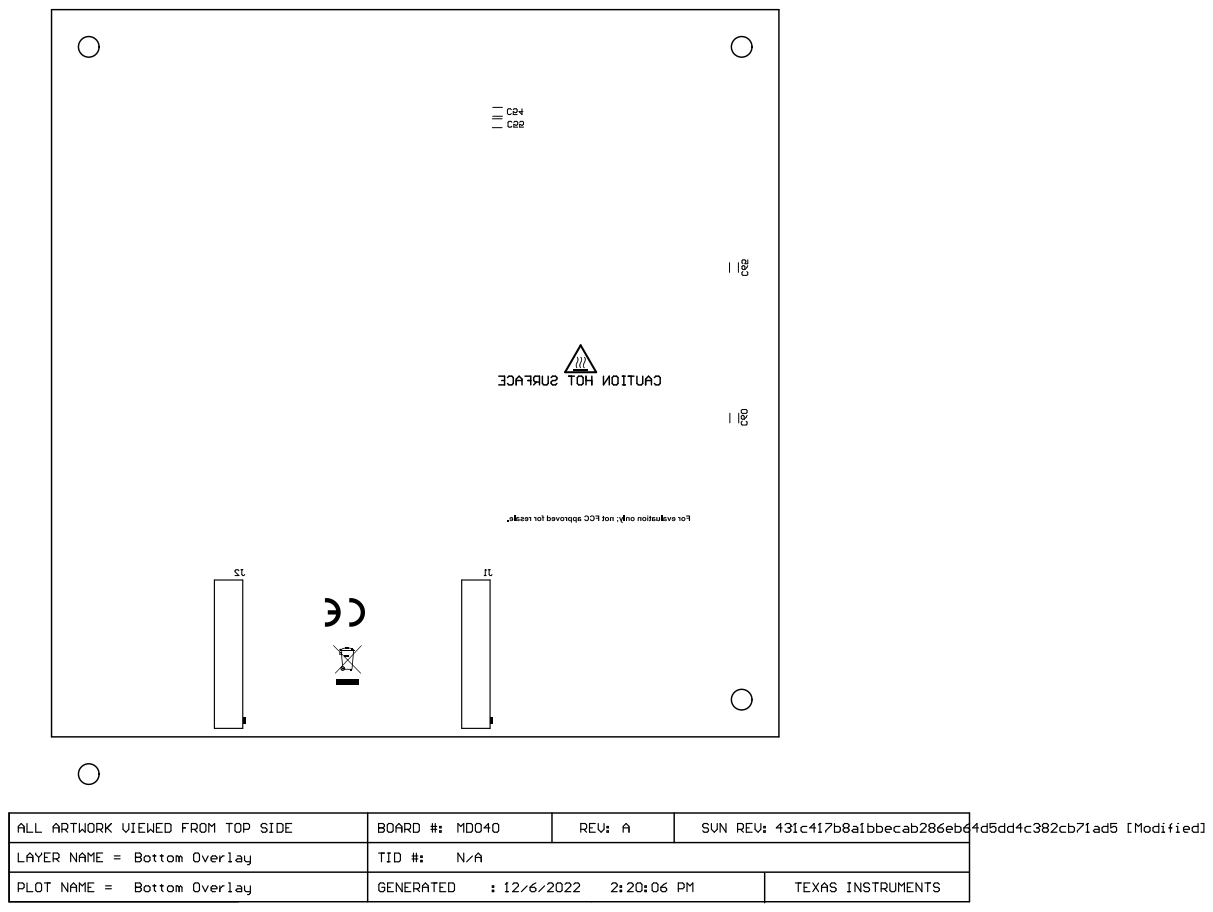
[picture p104: page 8]

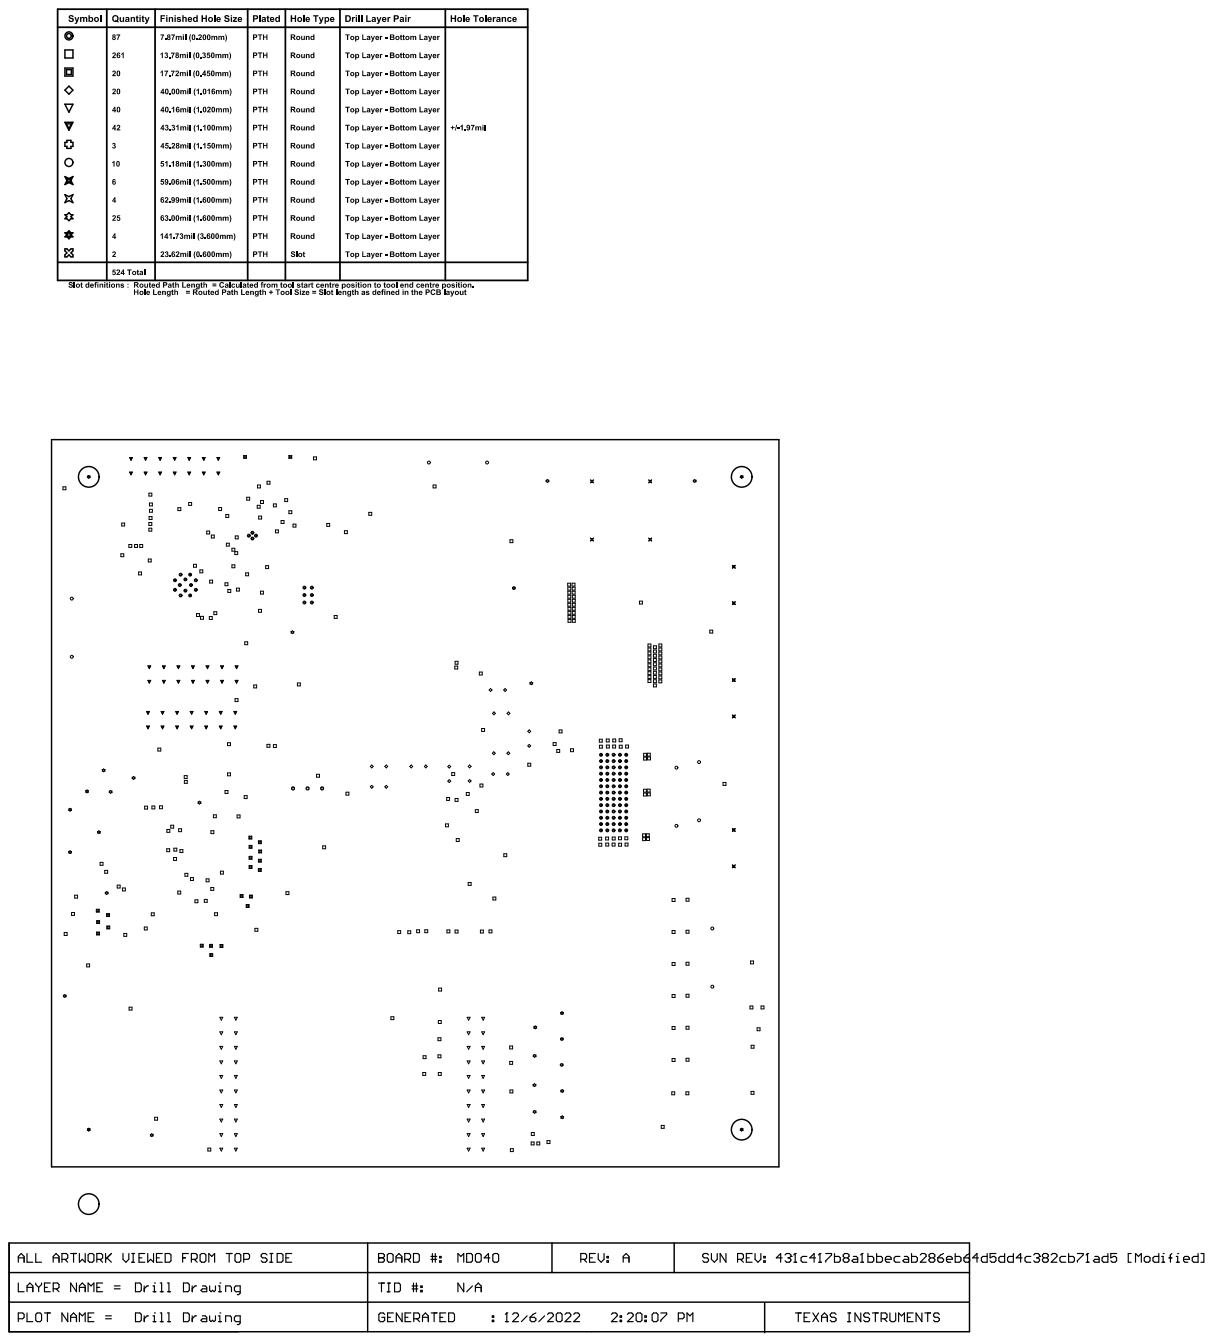
[picture p105: page 9]

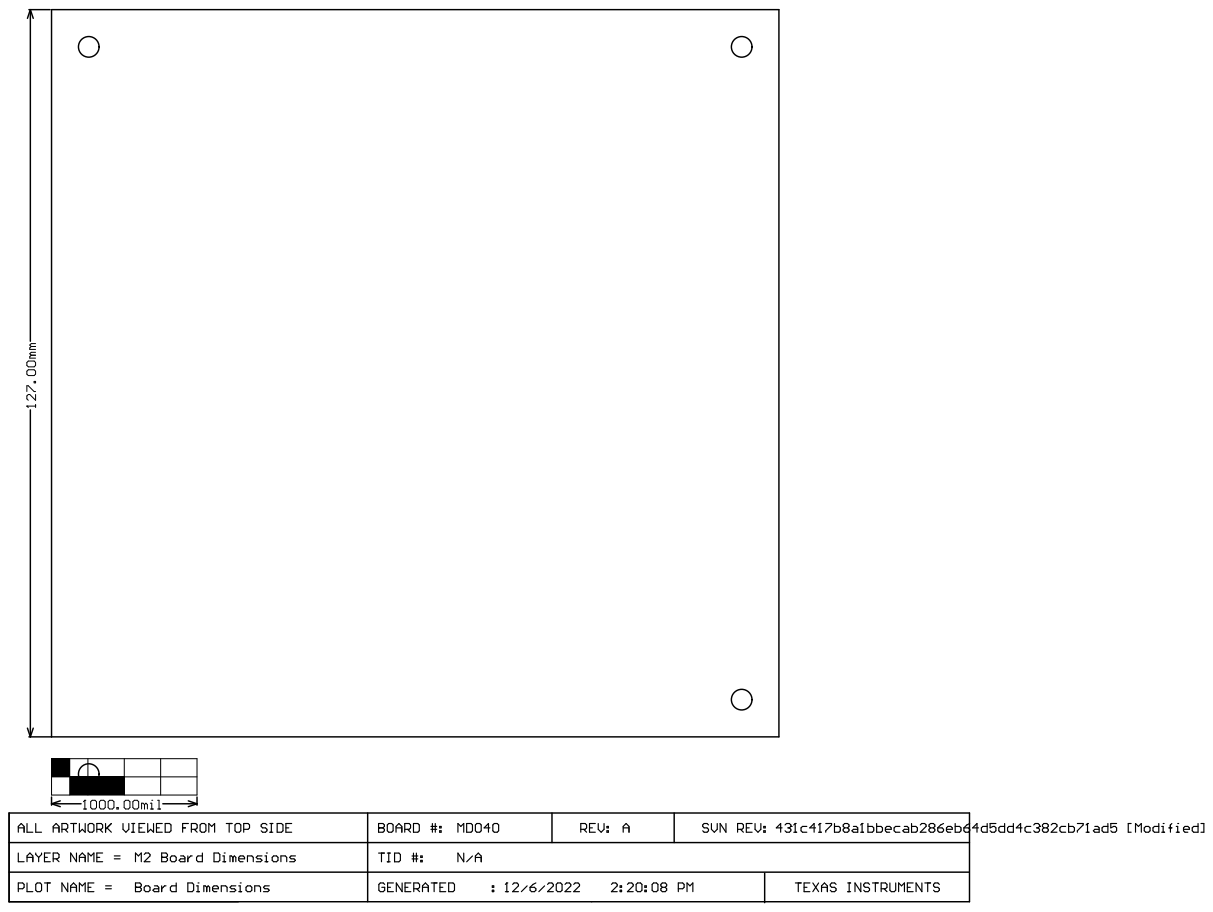
[picture p106: page 10]
