levdan159/abx-motion/design/rev-1.2-research/sources/evm-drv8461-componentviews.pdf

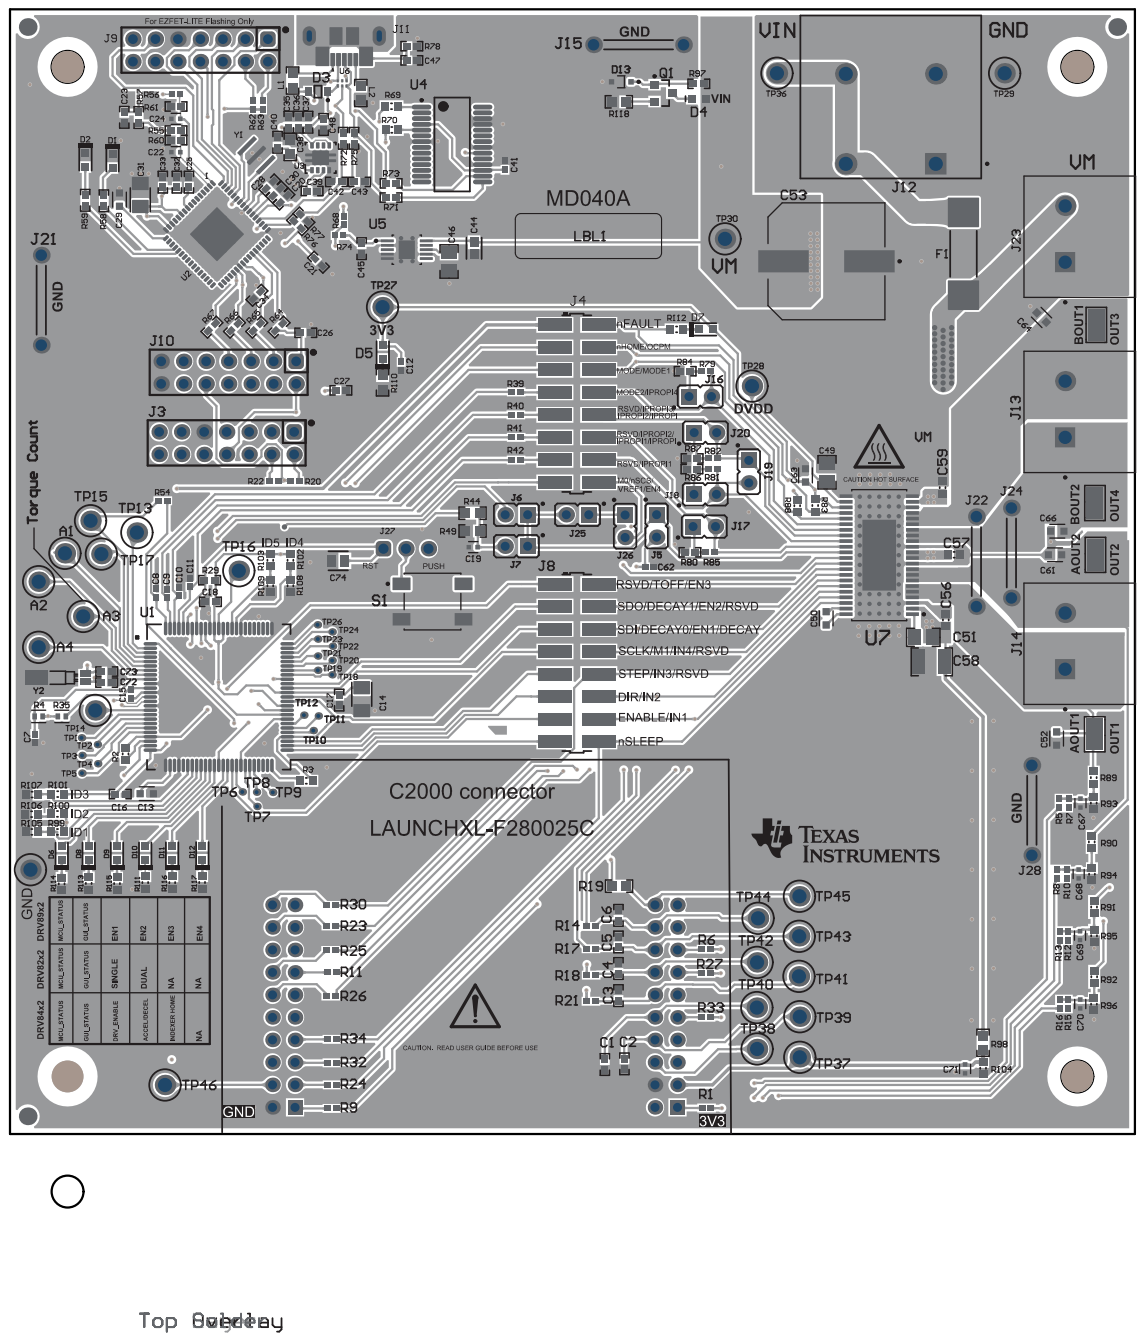
[picture p107: page 1]

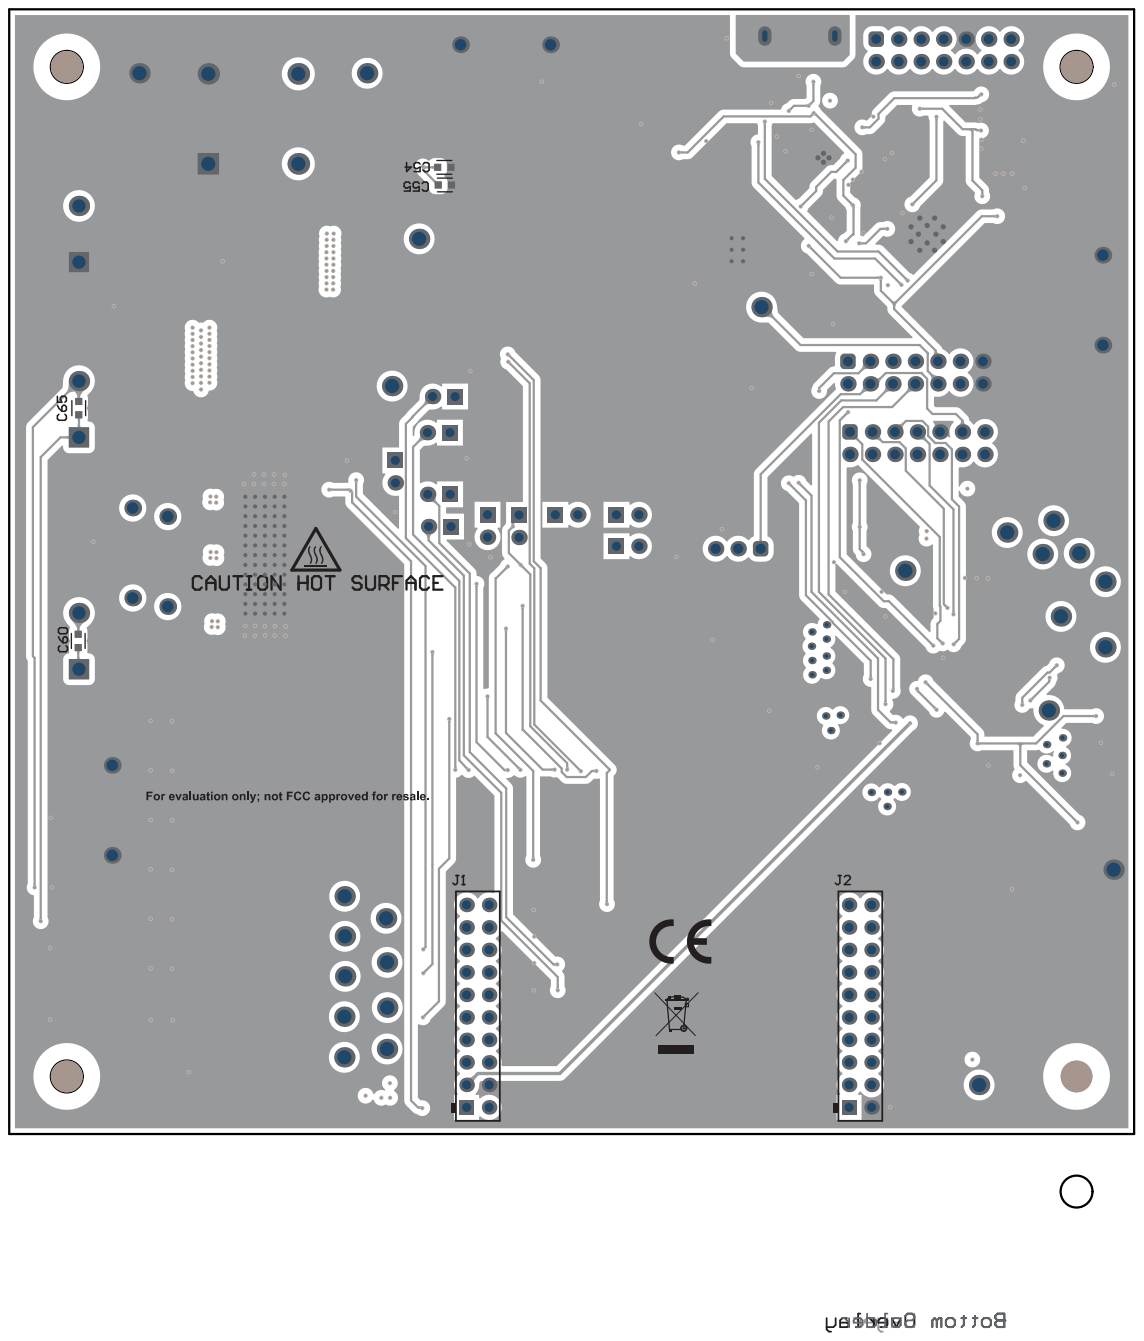
[picture p108: page 2]
