levdan159/abx-motion/design/rev-1.2-research/sources/evm-drv8461-fabnotes.pdf

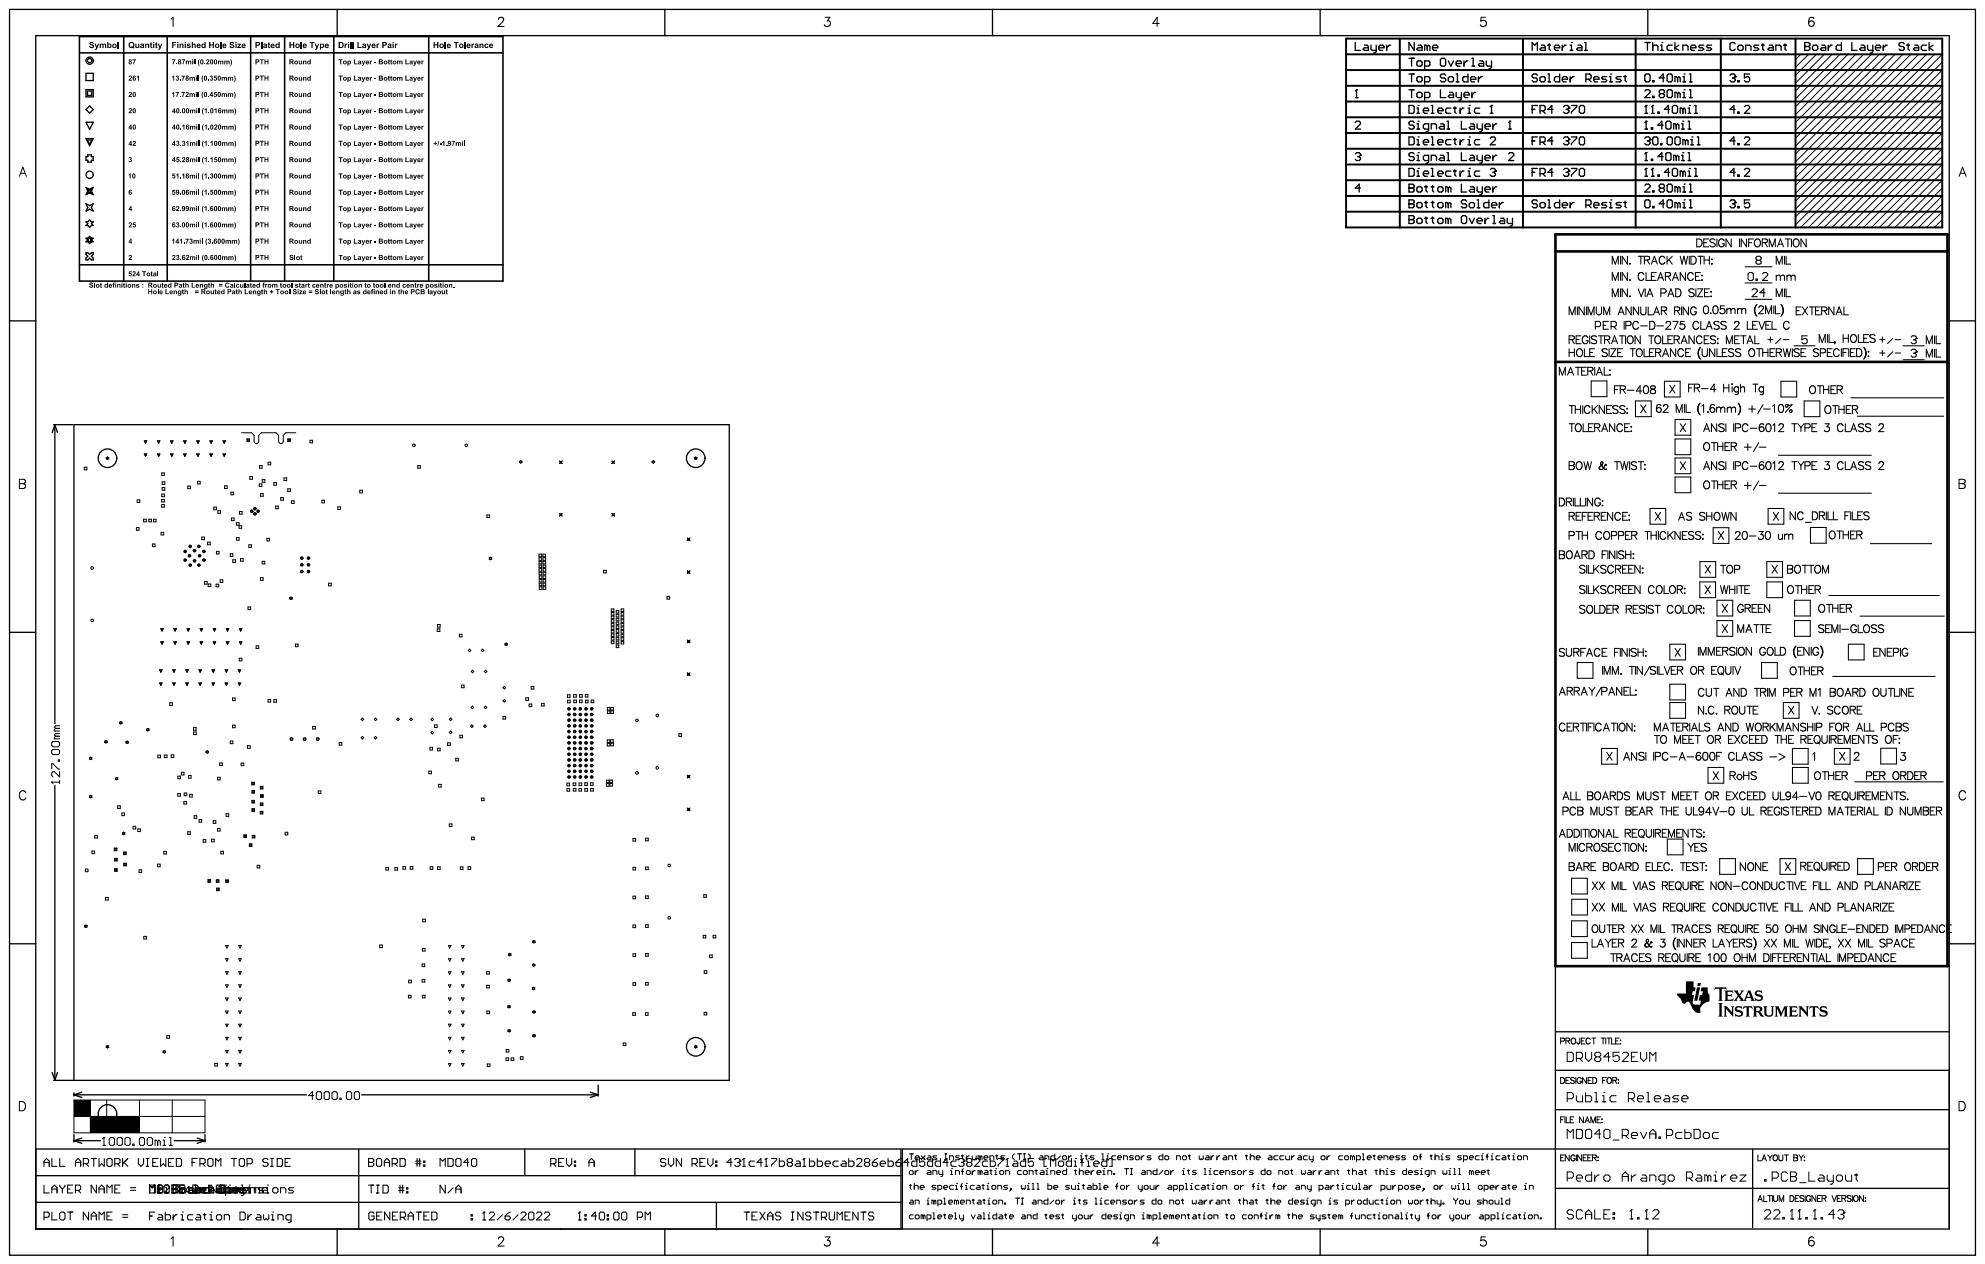
[picture p109: page 1]
