levdan159/abx-motion/(list of files, drawings)

Other design files:
validation/ethernet-checkpoint-20261024/schematic-erc.json
validation/prototype-review-20261019_153750/pcb-supplier-field-mismatches.json
