levdan159/abx-motion/abx-motion.kicad_pcb

## KiCad design abx-motion.kicad_pcb (2026-10-24)

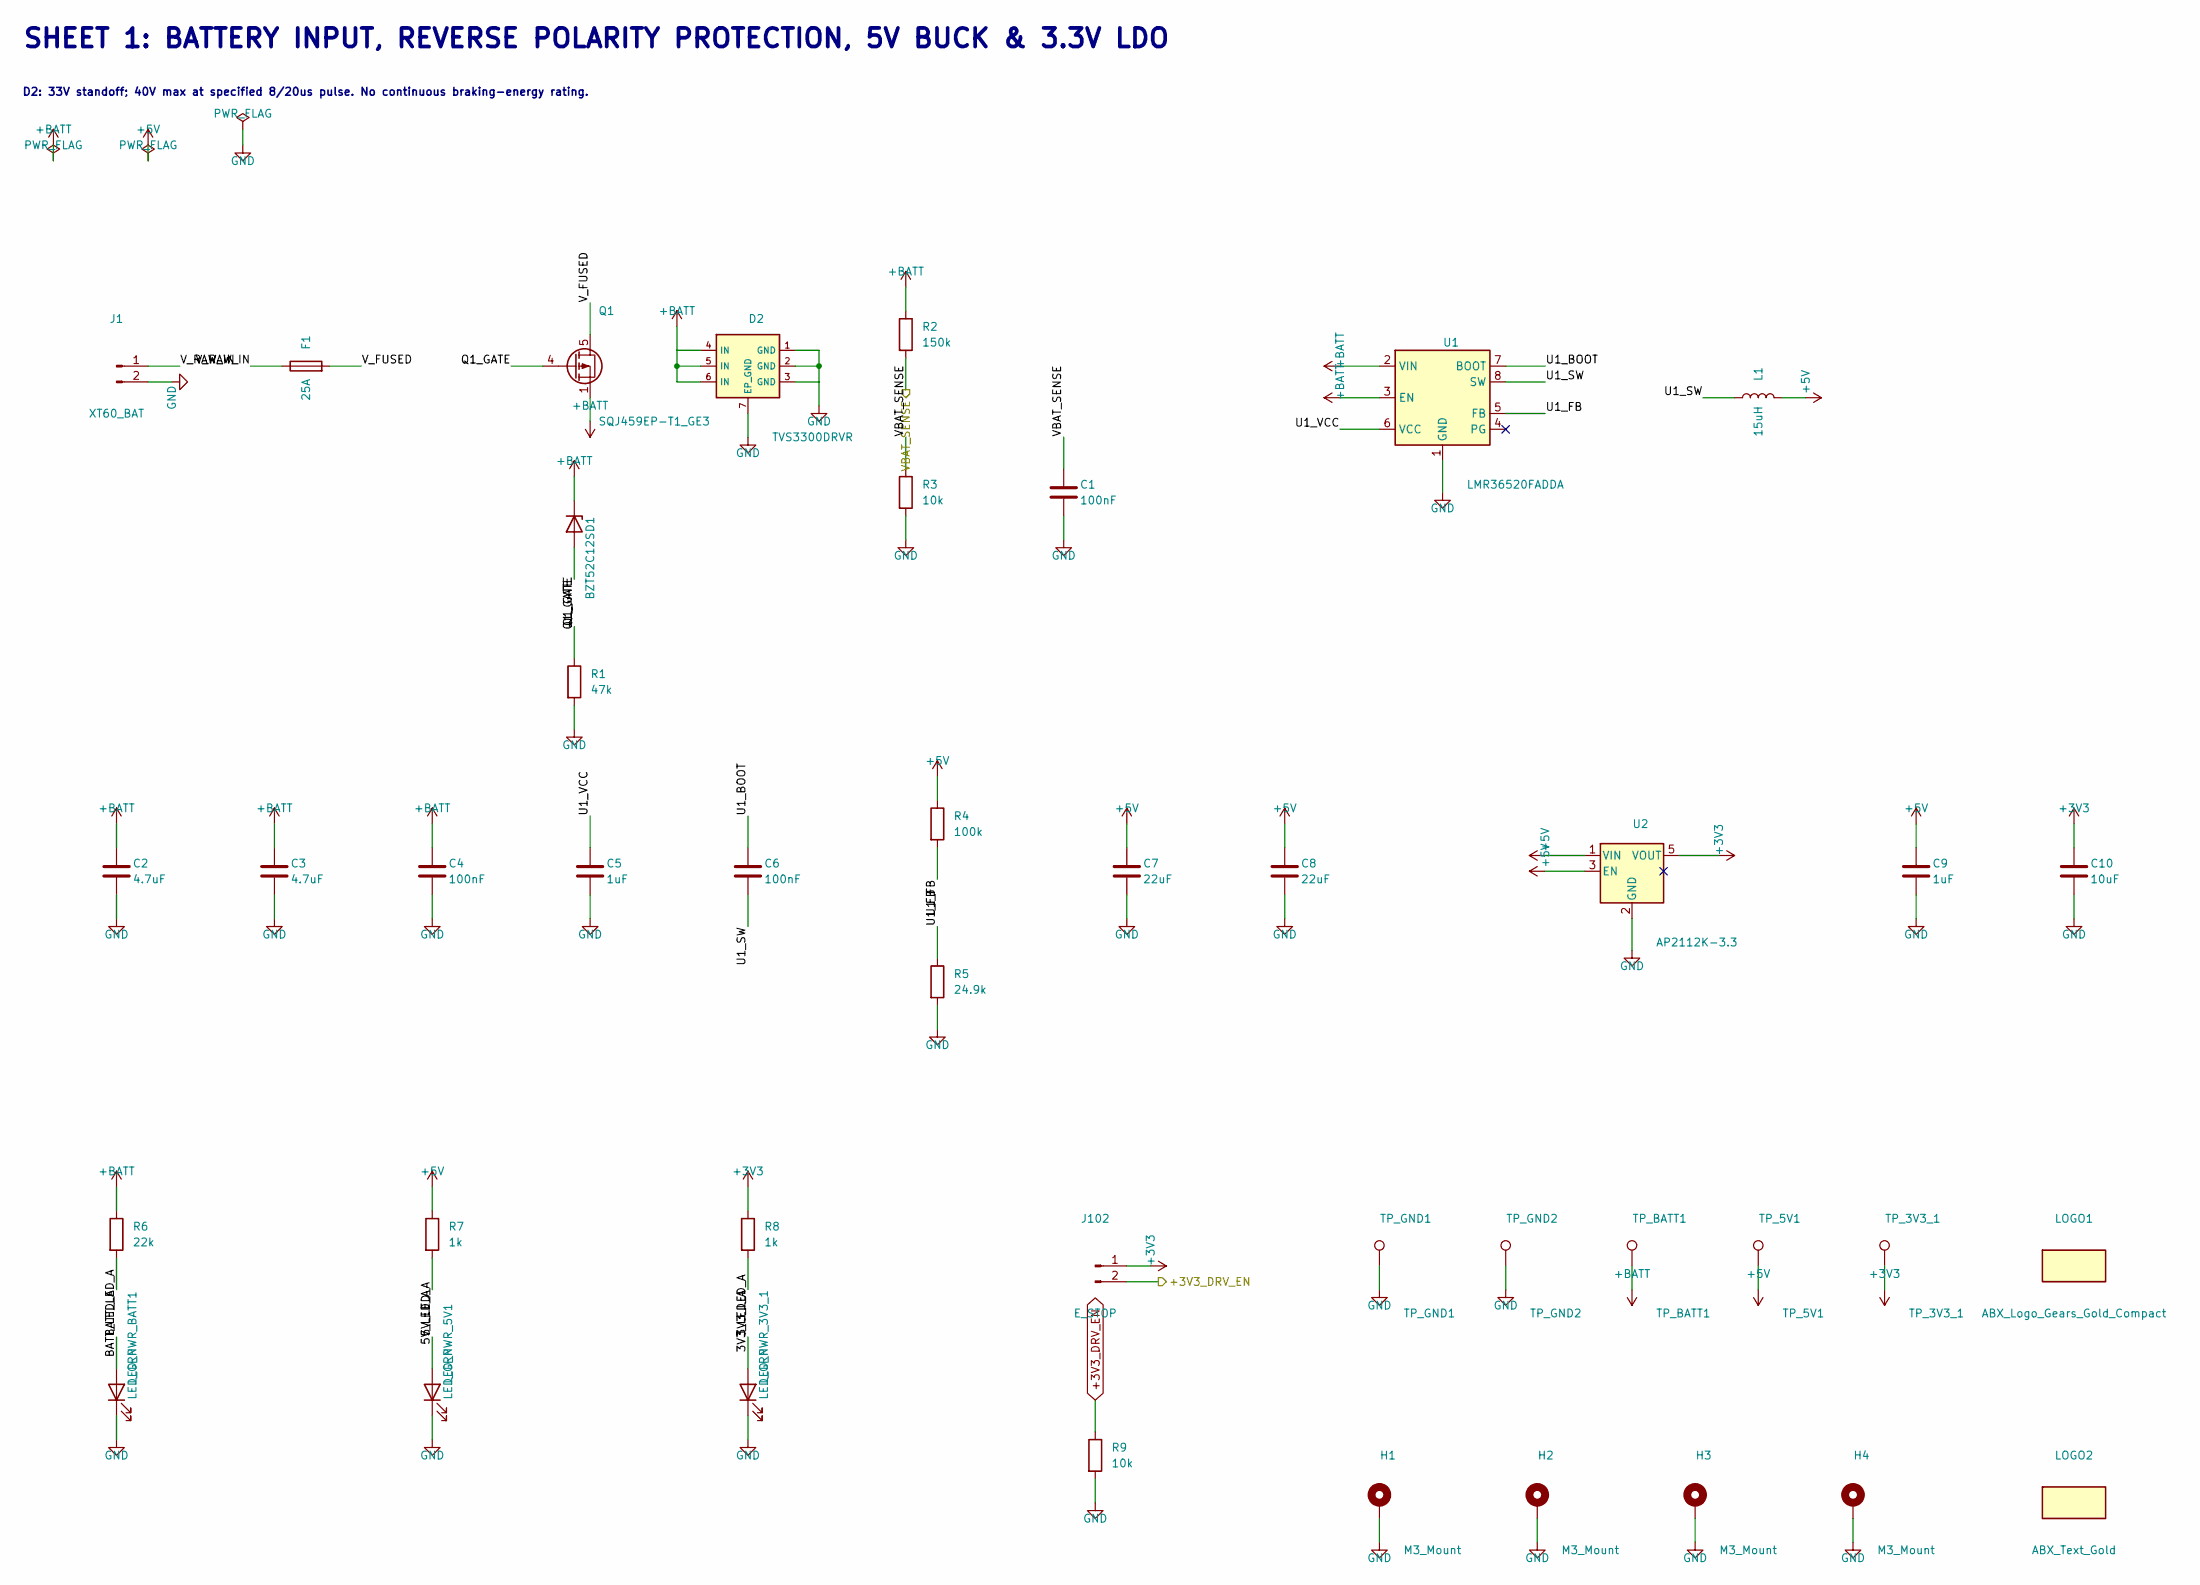
[picture p110: schematic Power.kicad_sch, ABX-Motion]

Parts:
C1, C4, C6: 100nF; C_0603_1608Metric; LCSC C14663
C2, C3: 4.7uF; C_1206_3216Metric; LCSC C29823
C5, C9: 1uF; C_0603_1608Metric; LCSC C15849
C7, C8: 22uF; C_1206_3216Metric; LCSC C12891
C10: 10uF; C_0805_2012Metric; LCSC C15850
D1: BZT52C12S; D_SOD-323; LCSC C14643
D2: TVS3300DRVR; TVS3300_DRV0006A_2x2mm; LCSC C2863624
F1: 25A; Fuseholder_Keystone_3557-2; LCSC C352820
H1, H2, H3, H4: M3_Mount; MountingHole_3.2mm_M3_Pad_Via
J1: XT60_BAT; AMASS_XT60-M_1x02_P7.20mm_Vertical; LCSC C98733
J102: E_STOP; ABX_J102_TerminalBlock_Phoenix_MKDS-1_5-2-5.08_1x02_P5.08mm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; LCSC C8465
L1: 15uH; L_Bourns_SRP7028A_7.3x6.6mm; LCSC C177243
LED_PWR_3V3_1, LED_PWR_5V1: LED_GRN; LED_0603_1608Metric; LCSC C12624
LED_PWR_BATT1: LED_GRN; LED_0603_1608Metric; LCSC C12624
LOGO1: ABX_Logo_Gears_Gold_Compact
LOGO2: ABX_Text_Gold
Q1: SQJ459EP-T1_GE3; TDSON-8-1; LCSC C3289501
R1: 47k; R_0603_1608Metric; LCSC C25819
R2: 150k; R_0603_1608Metric; LCSC C22807
R3, R9: 10k; R_0603_1608Metric; LCSC C25804
R4: 100k; R_0603_1608Metric; LCSC C25803
R5: 24.9k; R_0603_1608Metric; LCSC C25962
R6: 22k; R_0603_1608Metric; LCSC C31850
R7, R8: 1k; R_0603_1608Metric; LCSC C21190
TP_3V3_1: TP_3V3_1; ABX_TP_3V3_1_TestPoint_Pad_D1.5mm
TP_5V1: TP_5V1; ABX_TP_5V1_TestPoint_Pad_D1.5mm
TP_BATT1: TP_BATT1; ABX_TP_BATT1_TestPoint_Pad_D1.5mm
TP_GND1: TP_GND1; ABX_TP_GND1_TestPoint_Pad_D1.5mm
TP_GND2: TP_GND2; ABX_TP_GND2_TestPoint_Pad_D1.5mm
U1: LMR36520FADDA; Texas_HSOP-8-1EP_3.9x4.9mm_P1.27mm_ThermalVias; LCSC C1858395
U2: AP2112K-3.3; SOT-23-5; LCSC C51118

Connections:
+3V3: C10.1, J102.1, R8.1, TP_3V3_1.1 (1_1), U2.5 (VOUT); also elsewhere on the board
+3V3_DRV_EN: J102.2, R9.1; also elsewhere on the board
+5V: C7.1, C8.1, C9.1, L1.2, R4.1, R7.1, TP_5V1.1 (1_1), U2.1 (VIN), U2.3 (EN); also elsewhere on the board
+BATT: C2.1, C3.1, C4.1, D1.1 (K), D2.4 (IN), D2.5 (IN), D2.6 (IN), Q1.1 (S), Q1.2 (S), Q1.3 (S), R2.1, R6.1, TP_BATT1.1 (1_1), U1.2 (VIN), U1.3 (EN); also elsewhere on the board
/Power_Supply/3V3_LED_A: LED_PWR_3V3_1.2 (A), R8.2
/Power_Supply/5V_LED_A: LED_PWR_5V1.2 (A), R7.2
/Power_Supply/BATT_LED_A: LED_PWR_BATT1.2 (A), R6.2
/Power_Supply/Q1_GATE: D1.2 (A), Q1.4 (G), R1.1
/Power_Supply/U1_BOOT: C6.1, U1.7 (BOOT)
/Power_Supply/U1_FB: R4.2, R5.1, U1.5 (FB)
/Power_Supply/U1_SW: C6.2, L1.1, U1.8 (SW)
/Power_Supply/U1_VCC: C5.1, U1.6 (VCC)
/Power_Supply/V_FUSED: F1.2, Q1.5 (D)
/Power_Supply/V_RAW_IN: F1.1, J1.1
/VBAT_SENSE: C1.1, R2.2, R3.1; also elsewhere on the board
GND: C1.2, C2.2, C3.2, C4.2, C5.2, C7.2, C8.2, C9.2, C10.2, D2.1 (GND), D2.2 (GND), D2.3 (GND), D2.7 (EP_GND), H1.1 (1_1), H2.1 (1_1), H3.1 (1_1), H4.1 (1_1), J1.2, LED_PWR_3V3_1.1 (K), LED_PWR_5V1.1 (K), LED_PWR_BATT1.1 (K), R1.2, R3.2, R5.2, R9.2, TP_GND1.1 (1_1), TP_GND2.1 (1_1), U1.1 (GND), U1.9 (GND), U2.2 (GND); also elsewhere on the board

Notes on the sheet:
SHEET 1: BATTERY INPUT, REVERSE POLARITY PROTECTION, 5V BUCK & 3.3V LDO
D2: 33V standoff; 40V max at specified 8/20us pulse. No continuous braking-energy rating.

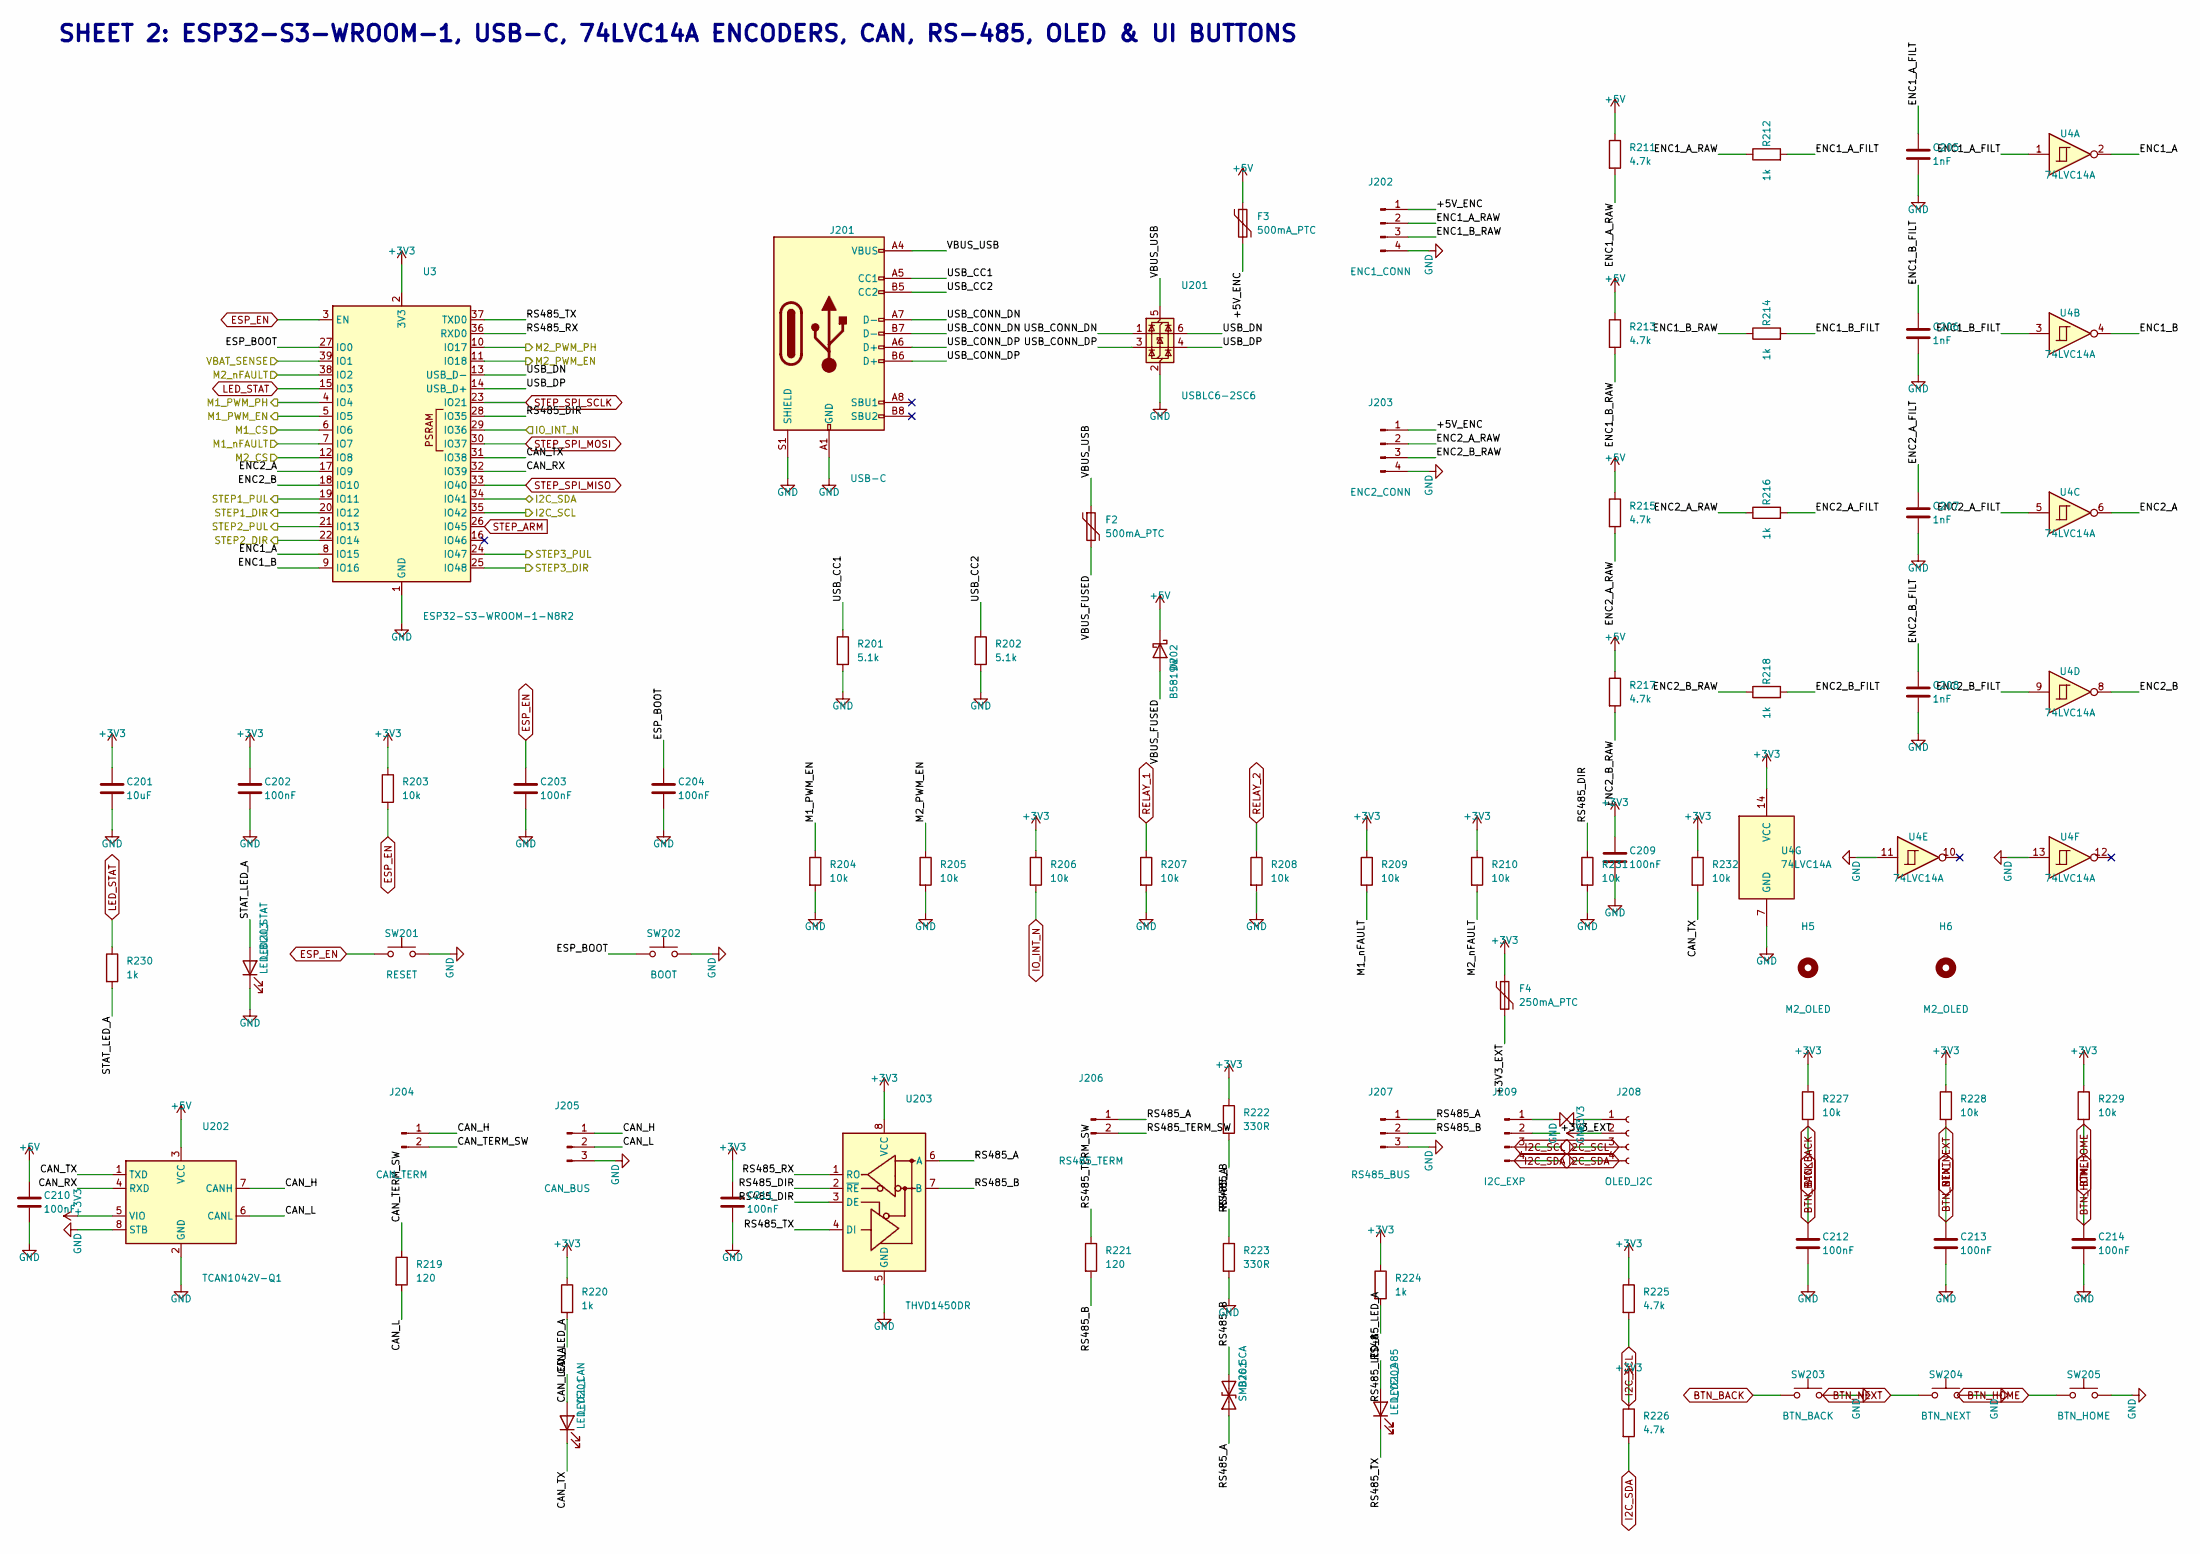
[picture p111: schematic MCU.kicad_sch, ABX-Motion]

Parts:
C201: 10uF; C_0805_2012Metric; LCSC C15850
C202, C203, C204, C209, C210, C211, C212, C213, C214: 100nF; C_0603_1608Metric; LCSC C14663
C205, C206, C207, C208: 1nF; C_0603_1608Metric; LCSC C1588
D201: SMBJ6.5CA; D_SMB; LCSC C78428
D202: B5819W; D_SOD-123; LCSC C8598
F2, F3: 500mA_PTC; Fuse_1206_3216Metric; LCSC C2984676
F4: 250mA_PTC; Fuse_1206_3216Metric; LCSC C20798
H5: M2_OLED; ABX_H5_MountingHole_2.2mm_M2
H6: M2_OLED; ABX_H6_MountingHole_2.2mm_M2
J201: USB-C; USB_C_Receptacle_HRO_TYPE-C-31-M-12; LCSC C165948
J202: ENC1_CONN; JST_XH_B4B-XH-A_1x04_P2.50mm_Vertical; LCSC C566014
J203: ENC2_CONN; JST_XH_B4B-XH-A_1x04_P2.50mm_Vertical; LCSC C566014
J204: CAN_TERM; PinHeader_1x02_P2.54mm_Vertical; LCSC C492401
J205: CAN_BUS; ABX_J205_TerminalBlock_Phoenix_MKDS-1_5-3-5.08_1x03_P5.08mm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; LCSC C72334
J206: RS485_TERM; PinHeader_1x02_P2.54mm_Vertical; LCSC C492401
J207: RS485_BUS; ABX_J207_TerminalBlock_Phoenix_MKDS-1_5-3-5.08_1x03_P5.08mm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; LCSC C72334
J208: OLED_I2C; OLED_Socket_SLW_1x04_P2.54mm_LowProfile
J209: I2C_EXP; JST_XH_B4B-XH-A_1x04_P2.50mm_Vertical; LCSC C566014
LED201: LED_YEL_CAN; LED_0603_1608Metric; LCSC C2287
LED202: LED_YEL_485; LED_0603_1608Metric; LCSC C2287
LED203: LED_BLU_STAT; LED_0603_1608Metric; LCSC C2288
R201, R202: 5.1k; R_0603_1608Metric; LCSC C23186
R203, R204, R205, R206, R207, R208, R209, R210, R227, R228, R229, R231, R232: 10k; R_0603_1608Metric; LCSC C25804
R211, R213, R215, R217, R225, R226: 4.7k; R_0603_1608Metric; LCSC C23162
R212, R214, R216, R218, R220, R224, R230: 1k; R_0603_1608Metric; LCSC C21190
R219, R221: 120; R_0603_1608Metric; LCSC C22787
R222, R223: 330R; R_0603_1608Metric; LCSC C23138
SW201: RESET; SW_SPST_B3U-1000P; LCSC C231329
SW202: BOOT; SW_SPST_B3U-1000P; LCSC C231329
SW203: BTN_BACK; SW_SPST_B3U-1000P; LCSC C231329
SW204: BTN_NEXT; SW_SPST_B3U-1000P; LCSC C231329
SW205: BTN_HOME; SW_SPST_B3U-1000P; LCSC C231329
U3: ESP32-S3-WROOM-1-N8R2; ABX_U3_ESP32-S3-WROOM-1; LCSC C2913204
U4: 74LVC14A; SOIC-14_3.9x8.7mm_P1.27mm; LCSC C133541
U201: USBLC6-2SC6; SOT-23-6; LCSC C7519
U202: TCAN1042V-Q1; SOIC-8_3.9x4.9mm_P1.27mm; LCSC C132550
U203: THVD1450DR; SOIC-8_3.9x4.9mm_P1.27mm; LCSC C2671361

Connections:
+3V3: C201.1, C202.1, C209.1, C211.1, F4.1, J208.2, R203.1, R206.1, R209.1, R210.1, R220.1, R222.1, R224.1, R225.1, R226.1, R227.1, R228.1, R229.1, R232.1, U3.2 (3V3), U4.14 (VCC), U202.5 (VIO), U203.8 (VCC); also elsewhere on the board
+5V: C210.1, D202.1 (K), F3.1, R211.1, R213.1, R215.1, R217.1, U202.3 (VCC); also elsewhere on the board
/M1_CS: U3.6 (IO6); also elsewhere on the board
/M1_PWM_EN: R204.1, U3.5 (IO5); also elsewhere on the board
/M1_PWM_PH: U3.4 (IO4); also elsewhere on the board
/M1_nFAULT: R209.2, U3.7 (IO7); also elsewhere on the board
/M2_CS: U3.12 (IO8); also elsewhere on the board
/M2_PWM_EN: R205.1, U3.11 (IO18); also elsewhere on the board
/M2_PWM_PH: U3.10 (IO17); also elsewhere on the board
/M2_nFAULT: R210.2, U3.38 (IO2); also elsewhere on the board
/MCU_and_Encoders/+3V3_EXT: F4.2, J209.2
/MCU_and_Encoders/+5V_ENC: F3.2, J202.1, J203.1
/MCU_and_Encoders/CAN_H: J204.1, J205.1, U202.7 (CANH)
/MCU_and_Encoders/CAN_L: J205.2, R219.2, U202.6 (CANL)
/MCU_and_Encoders/CAN_LED_A: LED201.2 (A), R220.2
/MCU_and_Encoders/CAN_RX: U3.32 (IO39), U202.4 (RXD)
/MCU_and_Encoders/CAN_TERM_SW: J204.2, R219.1
/MCU_and_Encoders/CAN_TX: LED201.1 (K), R232.2, U3.31 (IO38), U202.1 (TXD)
/MCU_and_Encoders/ENC1_A: U3.8 (IO15), U4.2
/MCU_and_Encoders/ENC1_A_FILT: C205.1, R212.2, U4.1
/MCU_and_Encoders/ENC1_A_RAW: J202.2, R211.2, R212.1
/MCU_and_Encoders/ENC1_B: U3.9 (IO16), U4.4
/MCU_and_Encoders/ENC1_B_FILT: C206.1, R214.2, U4.3
/MCU_and_Encoders/ENC1_B_RAW: J202.3, R213.2, R214.1
/MCU_and_Encoders/ENC2_A: U3.17 (IO9), U4.6
/MCU_and_Encoders/ENC2_A_FILT: C207.1, R216.2, U4.5
/MCU_and_Encoders/ENC2_A_RAW: J203.2, R215.2, R216.1
/MCU_and_Encoders/ENC2_B: U3.18 (IO10), U4.8
/MCU_and_Encoders/ENC2_B_FILT: C208.1, R218.2, U4.9
/MCU_and_Encoders/ENC2_B_RAW: J203.3, R217.2, R218.1
/MCU_and_Encoders/ESP_BOOT: C204.1, SW202.1, U3.27 (IO0)
/MCU_and_Encoders/RS485_A: D201.1 (A1), J206.1, J207.1, R222.2, U203.6 (A)
/MCU_and_Encoders/RS485_B: D201.2 (A2), J207.2, R221.2, R223.1, U203.7 (B)
/MCU_and_Encoders/RS485_DIR: R231.1, U3.28 (IO35), U203.2 (~RE), U203.3 (DE)
/MCU_and_Encoders/RS485_LED_A: LED202.2 (A), R224.2
/MCU_and_Encoders/RS485_RX: U3.36 (RXD0), U203.1 (RO)
/MCU_and_Encoders/RS485_TERM_SW: J206.2, R221.1
/MCU_and_Encoders/RS485_TX: LED202.1 (K), U3.37 (TXD0), U203.4 (DI)
/MCU_and_Encoders/STAT_LED_A: LED203.2 (A), R230.2
/MCU_and_Encoders/USB_CC1: J201.A5 (CC1), R201.1
/MCU_and_Encoders/USB_CC2: J201.B5 (CC2), R202.1
/MCU_and_Encoders/USB_CONN_DN: J201.A7 (D-), J201.B7 (D-), U201.1 (I/O1)
/MCU_and_Encoders/USB_CONN_DP: J201.A6 (D+), J201.B6 (D+), U201.3 (I/O2)
/MCU_and_Encoders/USB_DN: U3.13 (USB_D-), U201.6 (I/O1)
/MCU_and_Encoders/USB_DP: U3.14 (USB_D+), U201.4 (I/O2)
/MCU_and_Encoders/VBUS_FUSED: D202.2 (A), F2.2
/MCU_and_Encoders/VBUS_USB: F2.1, J201.A4 (VBUS), J201.A9 (VBUS), J201.B4 (VBUS), J201.B9 (VBUS), U201.5 (VBUS)
/VBAT_SENSE: U3.39 (IO1); also elsewhere on the board
BTN_BACK: C212.1, R227.2, SW203.1; also elsewhere on the board
BTN_HOME: C214.1, R229.2, SW205.1; also elsewhere on the board
BTN_NEXT: C213.1, R228.2, SW204.1; also elsewhere on the board
ESP_EN: C203.1, R203.2, SW201.1, U3.3 (EN); also elsewhere on the board
GND: C201.2, C202.2, C203.2, C204.2, C205.2, C206.2, C207.2, C208.2, C209.2, C210.2, C211.2, C212.2, C213.2, C214.2, J201.A1 (GND), J201.A12 (GND), J201.B1 (GND), J201.B12 (GND), J201.S1 (SHIELD), J202.4, J203.4, J205.3, J207.3, J208.1, J209.1, LED203.1 (K), R201.2, R202.2, R204.2, R205.2, R207.2, R208.2, R223.2, R231.2, SW201.2, SW202.2, SW203.2, SW204.2, SW205.2, U3.1 (GND), U3.40 (GND), U3.41 (GND), U4.7 (GND), U4.11, U4.13, U201.2 (GND), U202.2 (GND), U202.8 (STB), U203.5 (GND); also elsewhere on the board
I2C_SCL: J208.3, J209.3, R225.2, U3.35 (IO42); also elsewhere on the board
I2C_SDA: J208.4, J209.4, R226.2, U3.34 (IO41); also elsewhere on the board
IO_INT_N: R206.2, U3.29 (IO36); also elsewhere on the board
LED_STAT: R230.1, U3.15 (IO3); also elsewhere on the board
RELAY_1: R207.1; also elsewhere on the board
RELAY_2: R208.1; also elsewhere on the board
STEP1_DIR: U3.20 (IO12); also elsewhere on the board
STEP1_PUL: U3.19 (IO11); also elsewhere on the board
STEP2_DIR: U3.22 (IO14); also elsewhere on the board
STEP2_PUL: U3.21 (IO13); also elsewhere on the board
STEP3_DIR: U3.25 (IO48); also elsewhere on the board
STEP3_PUL: U3.24 (IO47); also elsewhere on the board
STEP_ARM: U3.26 (IO45); also elsewhere on the board
STEP_SPI_MISO: U3.33 (IO40); also elsewhere on the board
STEP_SPI_MOSI: U3.30 (IO37); also elsewhere on the board
STEP_SPI_SCLK: U3.23 (IO21); also elsewhere on the board

Notes on the sheet:
SHEET 2: ESP32-S3-WROOM-1, USB-C, 74LVC14A ENCODERS, CAN, RS-485, OLED & UI BUTTONS

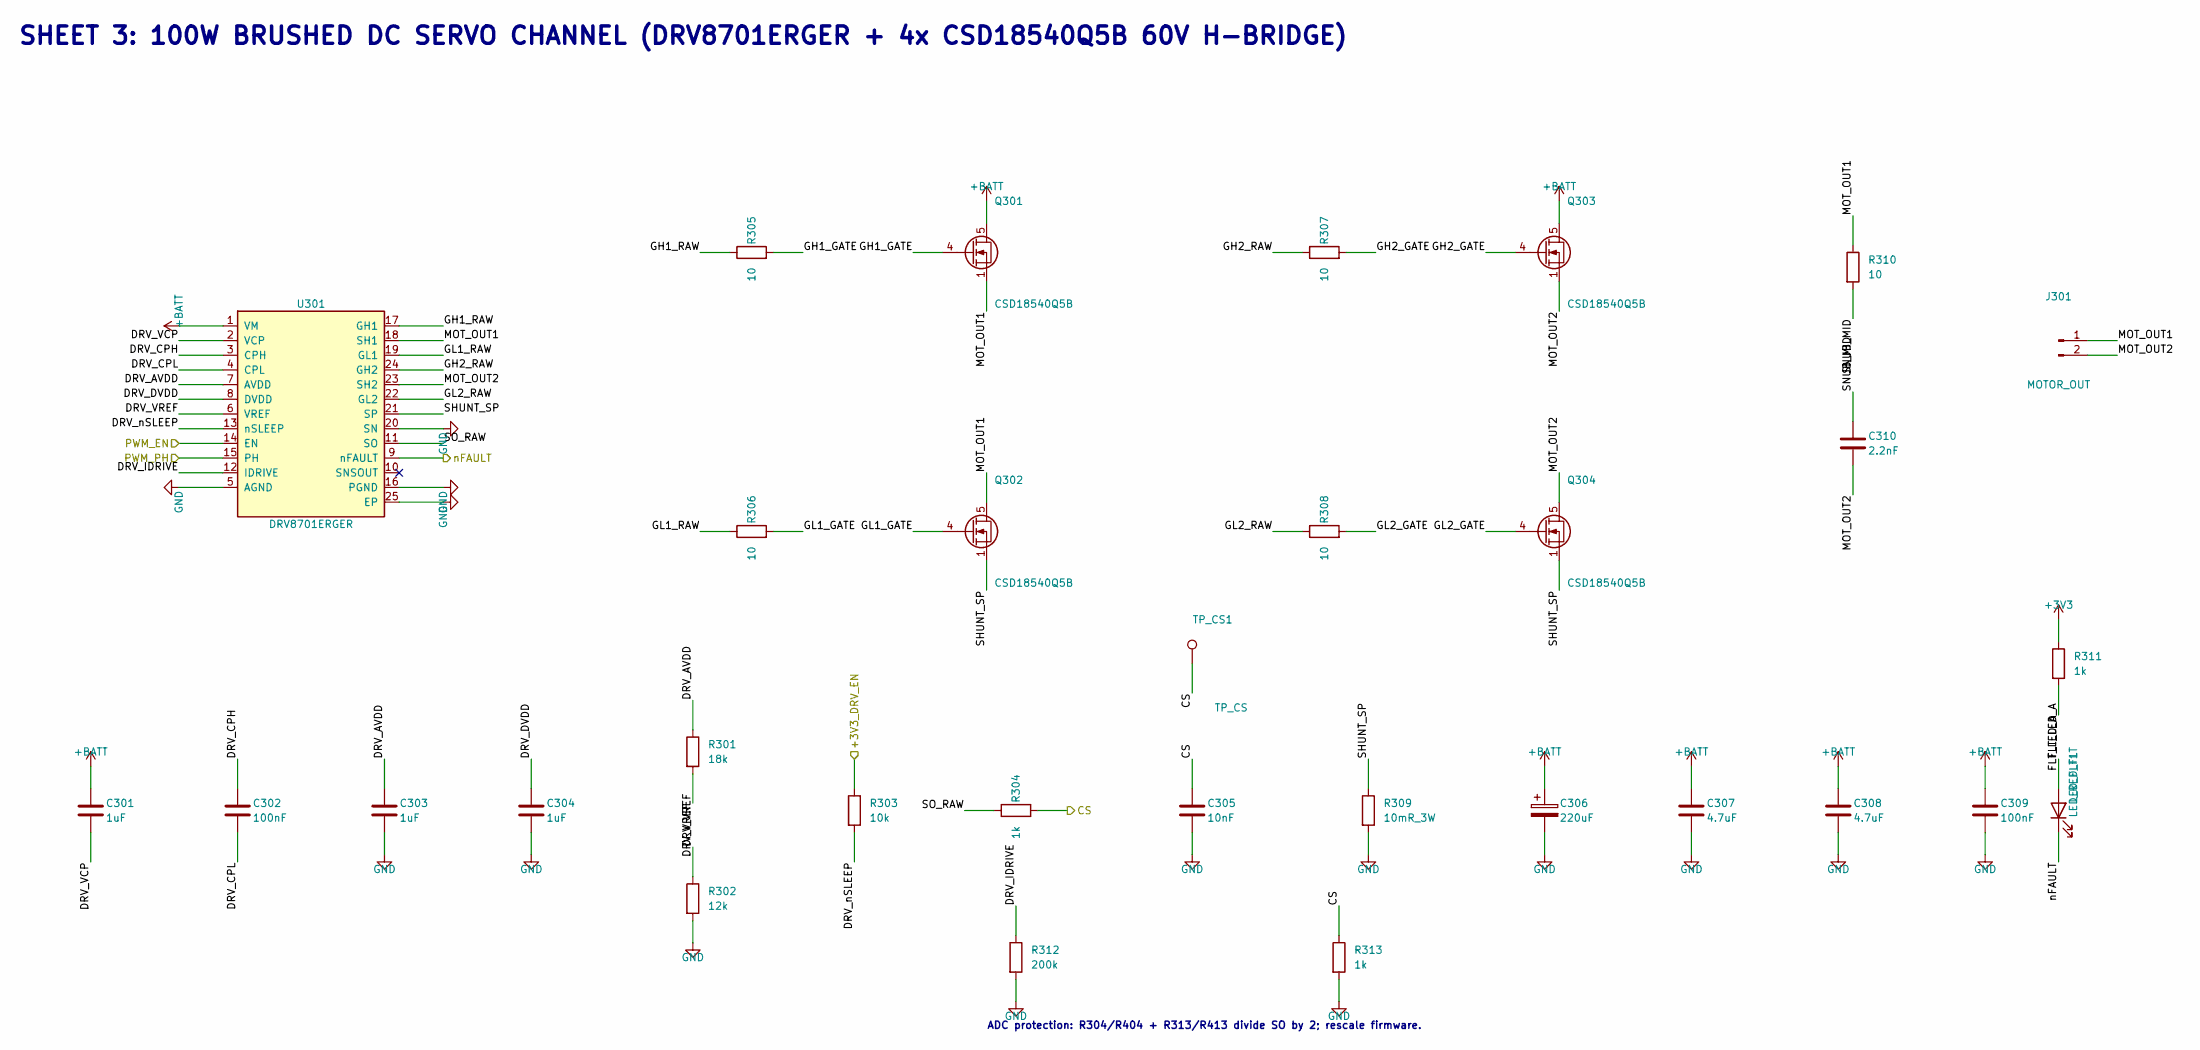
[picture p112: schematic Motor_Channel.kicad_sch, ABX-Motion]

Parts:
C301, C303, C304: 1uF; C_0603_1608Metric; LCSC C15849
C302, C309: 100nF; C_0603_1608Metric; LCSC C14663
C305: 10nF; C_0603_1608Metric; LCSC C57112
C306: 220uF; CP_Elec_10x10.5; LCSC C72499
C307, C308: 4.7uF; C_1206_3216Metric; LCSC C29823
C310: 2.2nF; C_0805_2012Metric; LCSC C107136
J301: MOTOR_OUT; MKDS_2Pin_Motor_ABX; LCSC C8465
LED_FLT1: LED_RED_FLT; LED_0603_1608Metric; LCSC C2286
Q301, Q302, Q303, Q304: CSD18540Q5B; TDSON-8-1; LCSC C86513
R301: 18k; R_0603_1608Metric; LCSC C25810
R302: 12k; R_0603_1608Metric; LCSC C22790
R303: 10k; R_0603_1608Metric; LCSC C25804
R304, R311, R313: 1k; R_0603_1608Metric; LCSC C21190
R305, R306, R307, R308: 10; R_0603_1608Metric; LCSC C22859
R309: 10mR_3W; R_2512_6332Metric; LCSC C840621
R310: 10; R_0805_2012Metric; LCSC C844598
R312: 200k; R_0603_1608Metric; LCSC C25811
TP_CS1: TP_CS; TestPoint_PTH_2.5x3.6_D1.0_CS_ABX
U301: DRV8701ERGER; DRV8701_RGE_Thermal_ABX; LCSC C90964

Connections:
+3V3: R311.1; also elsewhere on the board
+3V3_DRV_EN: R303.1; also elsewhere on the board
+BATT: C301.1, C306.1, C307.1, C308.1, C309.1, Q301.5 (D), Q303.5 (D), U301.1 (VM); also elsewhere on the board
/DC_Motor_1/DRV_AVDD: C303.1, R301.1, U301.7 (AVDD)
/DC_Motor_1/DRV_CPH: C302.1, U301.3 (CPH)
/DC_Motor_1/DRV_CPL: C302.2, U301.4 (CPL)
/DC_Motor_1/DRV_DVDD: C304.1, U301.8 (DVDD)
/DC_Motor_1/DRV_IDRIVE: R312.1, U301.12 (IDRIVE)
/DC_Motor_1/DRV_VCP: C301.2, U301.2 (VCP)
/DC_Motor_1/DRV_VREF: R301.2, R302.1, U301.6 (VREF)
/DC_Motor_1/DRV_nSLEEP: R303.2, U301.13 (nSLEEP)
/DC_Motor_1/FLT_LED_A: LED_FLT1.2 (A), R311.2
/DC_Motor_1/GH1_GATE: Q301.4 (G), R305.2
/DC_Motor_1/GH1_RAW: R305.1, U301.17 (GH1)
/DC_Motor_1/GH2_GATE: Q303.4 (G), R307.2
/DC_Motor_1/GH2_RAW: R307.1, U301.24 (GH2)
/DC_Motor_1/GL1_GATE: Q302.4 (G), R306.2
/DC_Motor_1/GL1_RAW: R306.1, U301.19 (GL1)
/DC_Motor_1/GL2_GATE: Q304.4 (G), R308.2
/DC_Motor_1/GL2_RAW: R308.1, U301.22 (GL2)
/DC_Motor_1/MOT_OUT1: J301.1, Q301.1 (S), Q301.2 (S), Q301.3 (S), Q302.5 (D), R310.1, U301.18 (SH1)
/DC_Motor_1/MOT_OUT2: C310.2, J301.2, Q303.1 (S), Q303.2 (S), Q303.3 (S), Q304.5 (D), U301.23 (SH2)
/DC_Motor_1/SHUNT_SP: Q302.1 (S), Q302.2 (S), Q302.3 (S), Q304.1 (S), Q304.2 (S), Q304.3 (S), R309.1, U301.21 (SP)
/DC_Motor_1/SNUB_MID: C310.1, R310.2
/DC_Motor_1/SO_RAW: R304.1, U301.11 (SO)
/M1_CS: C305.1, R304.2, R313.1, TP_CS1.1 (1_1); also elsewhere on the board
/M1_PWM_EN: U301.14 (PH); also elsewhere on the board
/M1_PWM_PH: U301.15 (EN); also elsewhere on the board
/M1_nFAULT: LED_FLT1.1 (K), U301.9 (nFAULT); also elsewhere on the board
GND: C303.2, C304.2, C305.2, C306.2, C307.2, C308.2, C309.2, R302.2, R309.2, R312.2, R313.2, U301.5 (AGND), U301.16 (PGND), U301.20 (SN), U301.25 (EP); also elsewhere on the board

Parts of its further copies:
C401, C403, C404: 1uF; C_0603_1608Metric; LCSC C15849
C402, C409: 100nF; C_0603_1608Metric; LCSC C14663
C405: 10nF; C_0603_1608Metric; LCSC C57112
C406: 220uF; CP_Elec_10x10.5; LCSC C72499
C407, C408: 4.7uF; C_1206_3216Metric; LCSC C29823
C410: 2.2nF; C_0805_2012Metric; LCSC C107136
J401: MOTOR_OUT; MKDS_2Pin_Motor_ABX; LCSC C8465
LED_FLT2: LED_RED_FLT; LED_0603_1608Metric; LCSC C2286
Q401, Q402, Q403, Q404: CSD18540Q5B; TDSON-8-1; LCSC C86513
R401: 18k; R_0603_1608Metric; LCSC C25810
R402: 12k; R_0603_1608Metric; LCSC C22790
R403: 10k; R_0603_1608Metric; LCSC C25804
R404, R411, R413: 1k; R_0603_1608Metric; LCSC C21190
R405, R406, R407, R408: 10; R_0603_1608Metric; LCSC C22859
R409: 10mR_3W; R_2512_6332Metric; LCSC C840621
R410: 10; R_0805_2012Metric; LCSC C844598
R412: 200k; R_0603_1608Metric; LCSC C25811
TP_CS2: TP_CS; TestPoint_PTH_2.5x3.6_D1.0_CS_ABX
U401: DRV8701ERGER; DRV8701_RGE_Thermal_ABX; LCSC C90964

Connections of its further copies:
+3V3: R411.1; also elsewhere on the board
+3V3_DRV_EN: R403.1; also elsewhere on the board
+BATT: C401.1, C406.1, C407.1, C408.1, C409.1, Q401.5 (D), Q403.5 (D), U401.1 (VM); also elsewhere on the board
/DC_Motor_2/DRV_AVDD: C403.1, R401.1, U401.7 (AVDD)
/DC_Motor_2/DRV_CPH: C402.1, U401.3 (CPH)
/DC_Motor_2/DRV_CPL: C402.2, U401.4 (CPL)
/DC_Motor_2/DRV_DVDD: C404.1, U401.8 (DVDD)
/DC_Motor_2/DRV_IDRIVE: R412.1, U401.12 (IDRIVE)
/DC_Motor_2/DRV_VCP: C401.2, U401.2 (VCP)
/DC_Motor_2/DRV_VREF: R401.2, R402.1, U401.6 (VREF)
/DC_Motor_2/DRV_nSLEEP: R403.2, U401.13 (nSLEEP)
/DC_Motor_2/FLT_LED_A: LED_FLT2.2 (A), R411.2
/DC_Motor_2/GH1_GATE: Q401.4 (G), R405.2
/DC_Motor_2/GH1_RAW: R405.1, U401.17 (GH1)
/DC_Motor_2/GH2_GATE: Q403.4 (G), R407.2
/DC_Motor_2/GH2_RAW: R407.1, U401.24 (GH2)
/DC_Motor_2/GL1_GATE: Q402.4 (G), R406.2
/DC_Motor_2/GL1_RAW: R406.1, U401.19 (GL1)
/DC_Motor_2/GL2_GATE: Q404.4 (G), R408.2
/DC_Motor_2/GL2_RAW: R408.1, U401.22 (GL2)
/DC_Motor_2/MOT_OUT1: J401.1, Q401.1 (S), Q401.2 (S), Q401.3 (S), Q402.5 (D), R410.1, U401.18 (SH1)
/DC_Motor_2/MOT_OUT2: C410.2, J401.2, Q403.1 (S), Q403.2 (S), Q403.3 (S), Q404.5 (D), U401.23 (SH2)
/DC_Motor_2/SHUNT_SP: Q402.1 (S), Q402.2 (S), Q402.3 (S), Q404.1 (S), Q404.2 (S), Q404.3 (S), R409.1, U401.21 (SP)
/DC_Motor_2/SNUB_MID: C410.1, R410.2
/DC_Motor_2/SO_RAW: R404.1, U401.11 (SO)
/M2_CS: C405.1, R404.2, R413.1, TP_CS2.1 (1_1); also elsewhere on the board
/M2_PWM_EN: U401.14 (PH); also elsewhere on the board
/M2_PWM_PH: U401.15 (EN); also elsewhere on the board
/M2_nFAULT: LED_FLT2.1 (K), U401.9 (nFAULT); also elsewhere on the board
GND: C403.2, C404.2, C405.2, C406.2, C407.2, C408.2, C409.2, R402.2, R409.2, R412.2, R413.2, U401.5 (AGND), U401.16 (PGND), U401.20 (SN), U401.25 (EP); also elsewhere on the board

Notes on the sheet:
SHEET 3: 100W BRUSHED DC SERVO CHANNEL (DRV8701ERGER + 4x CSD18540Q5B 60V H-BRIDGE)
ADC protection: R304/R404 + R313/R413 divide SO by 2; rescale firmware.
