levdan159/abx-motion/abx-motion.kicad_pcb

## KiCad design abx-motion.kicad_pcb (continued)

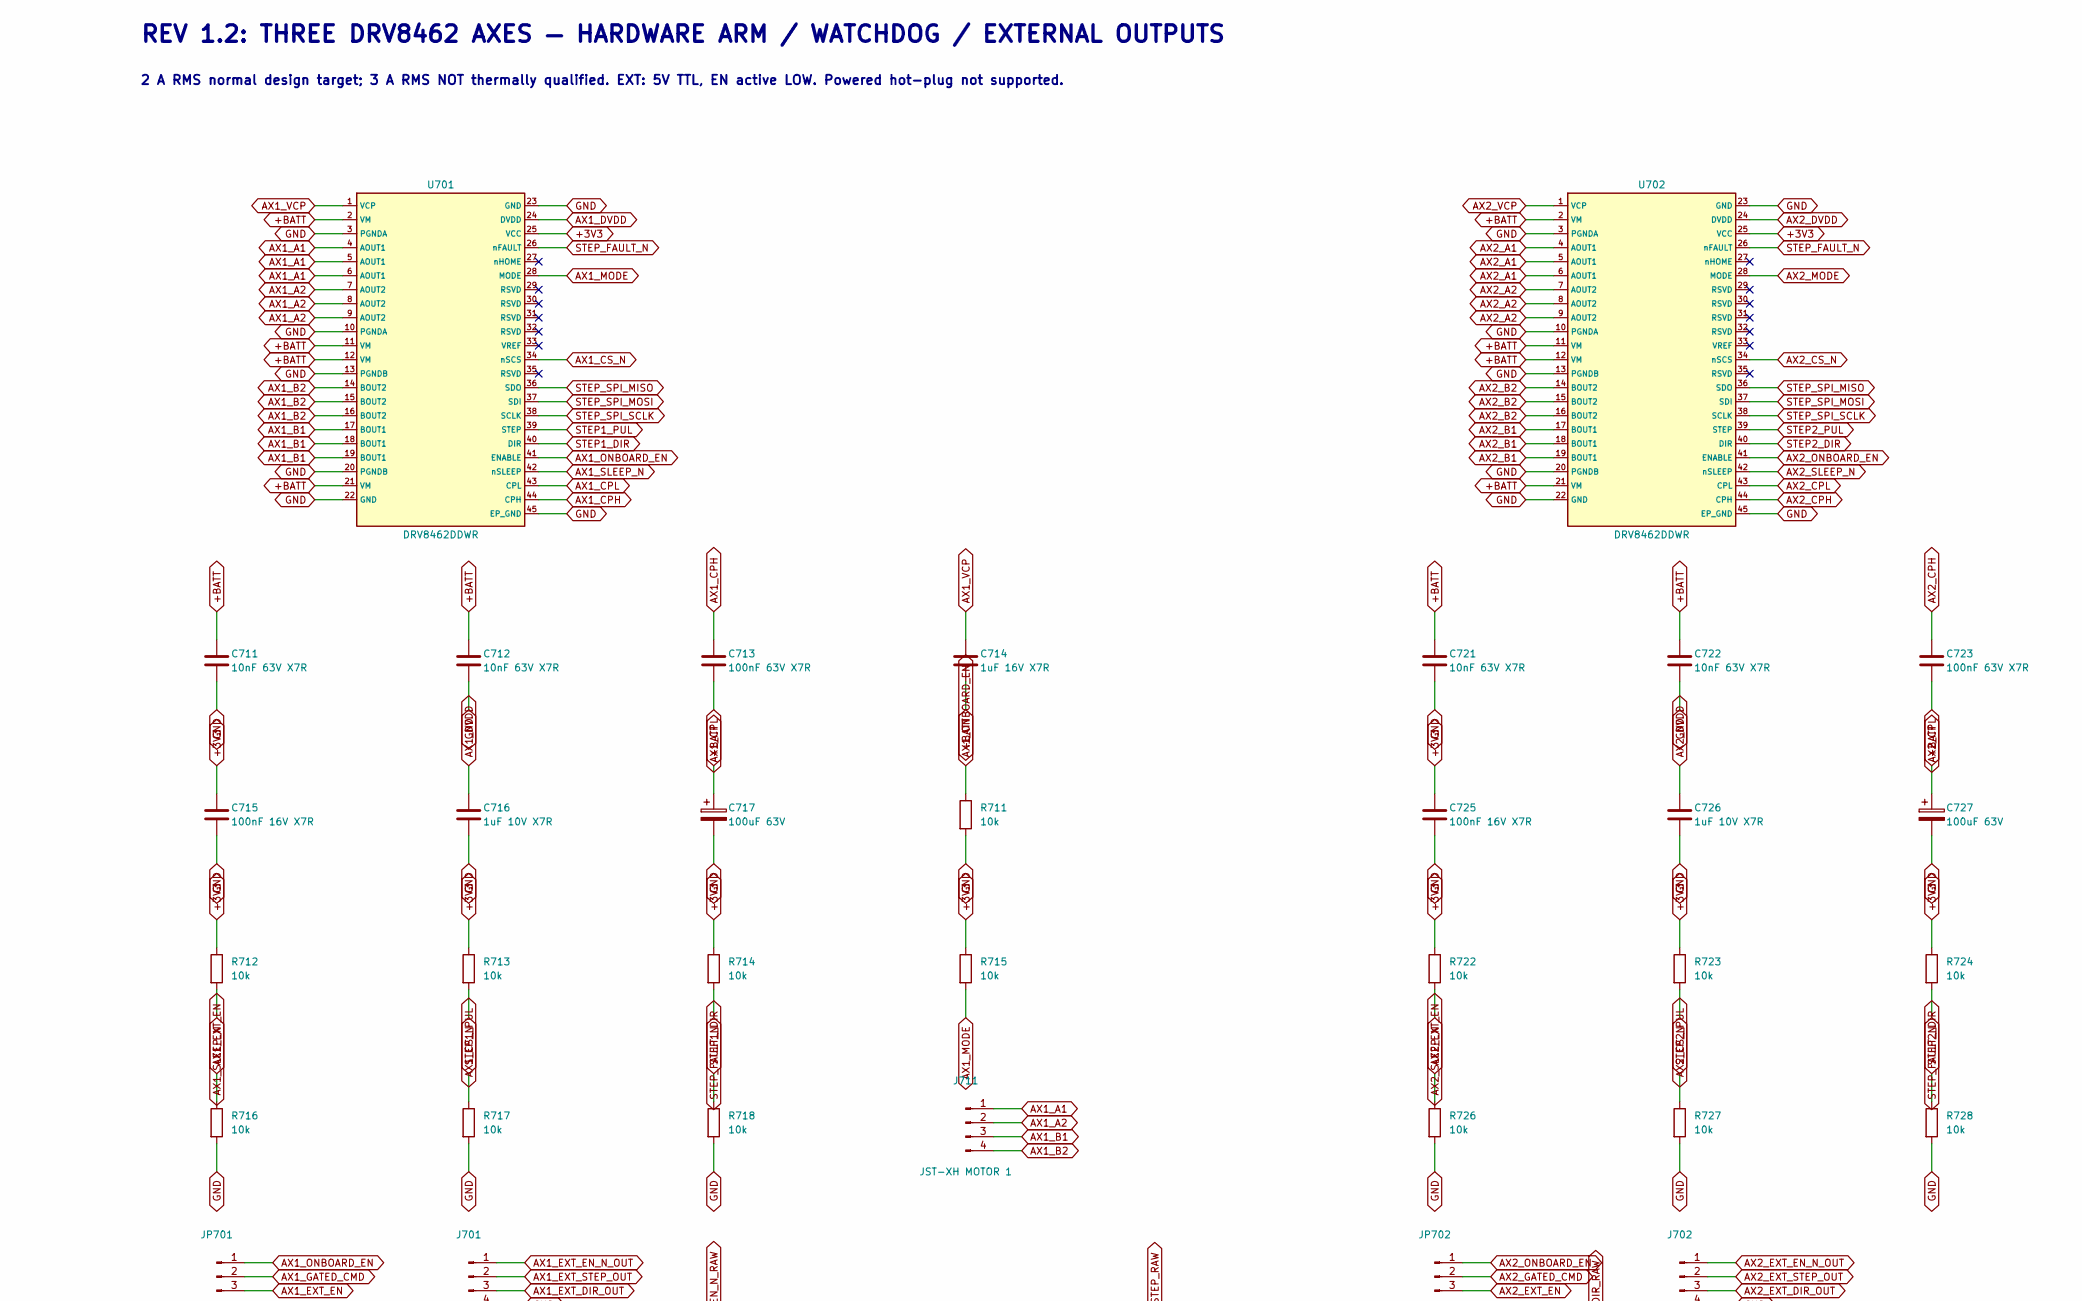
[picture p113: schematic Steppers_Relays.kicad_sch, ABX-Motion, part in row 1, column 1]

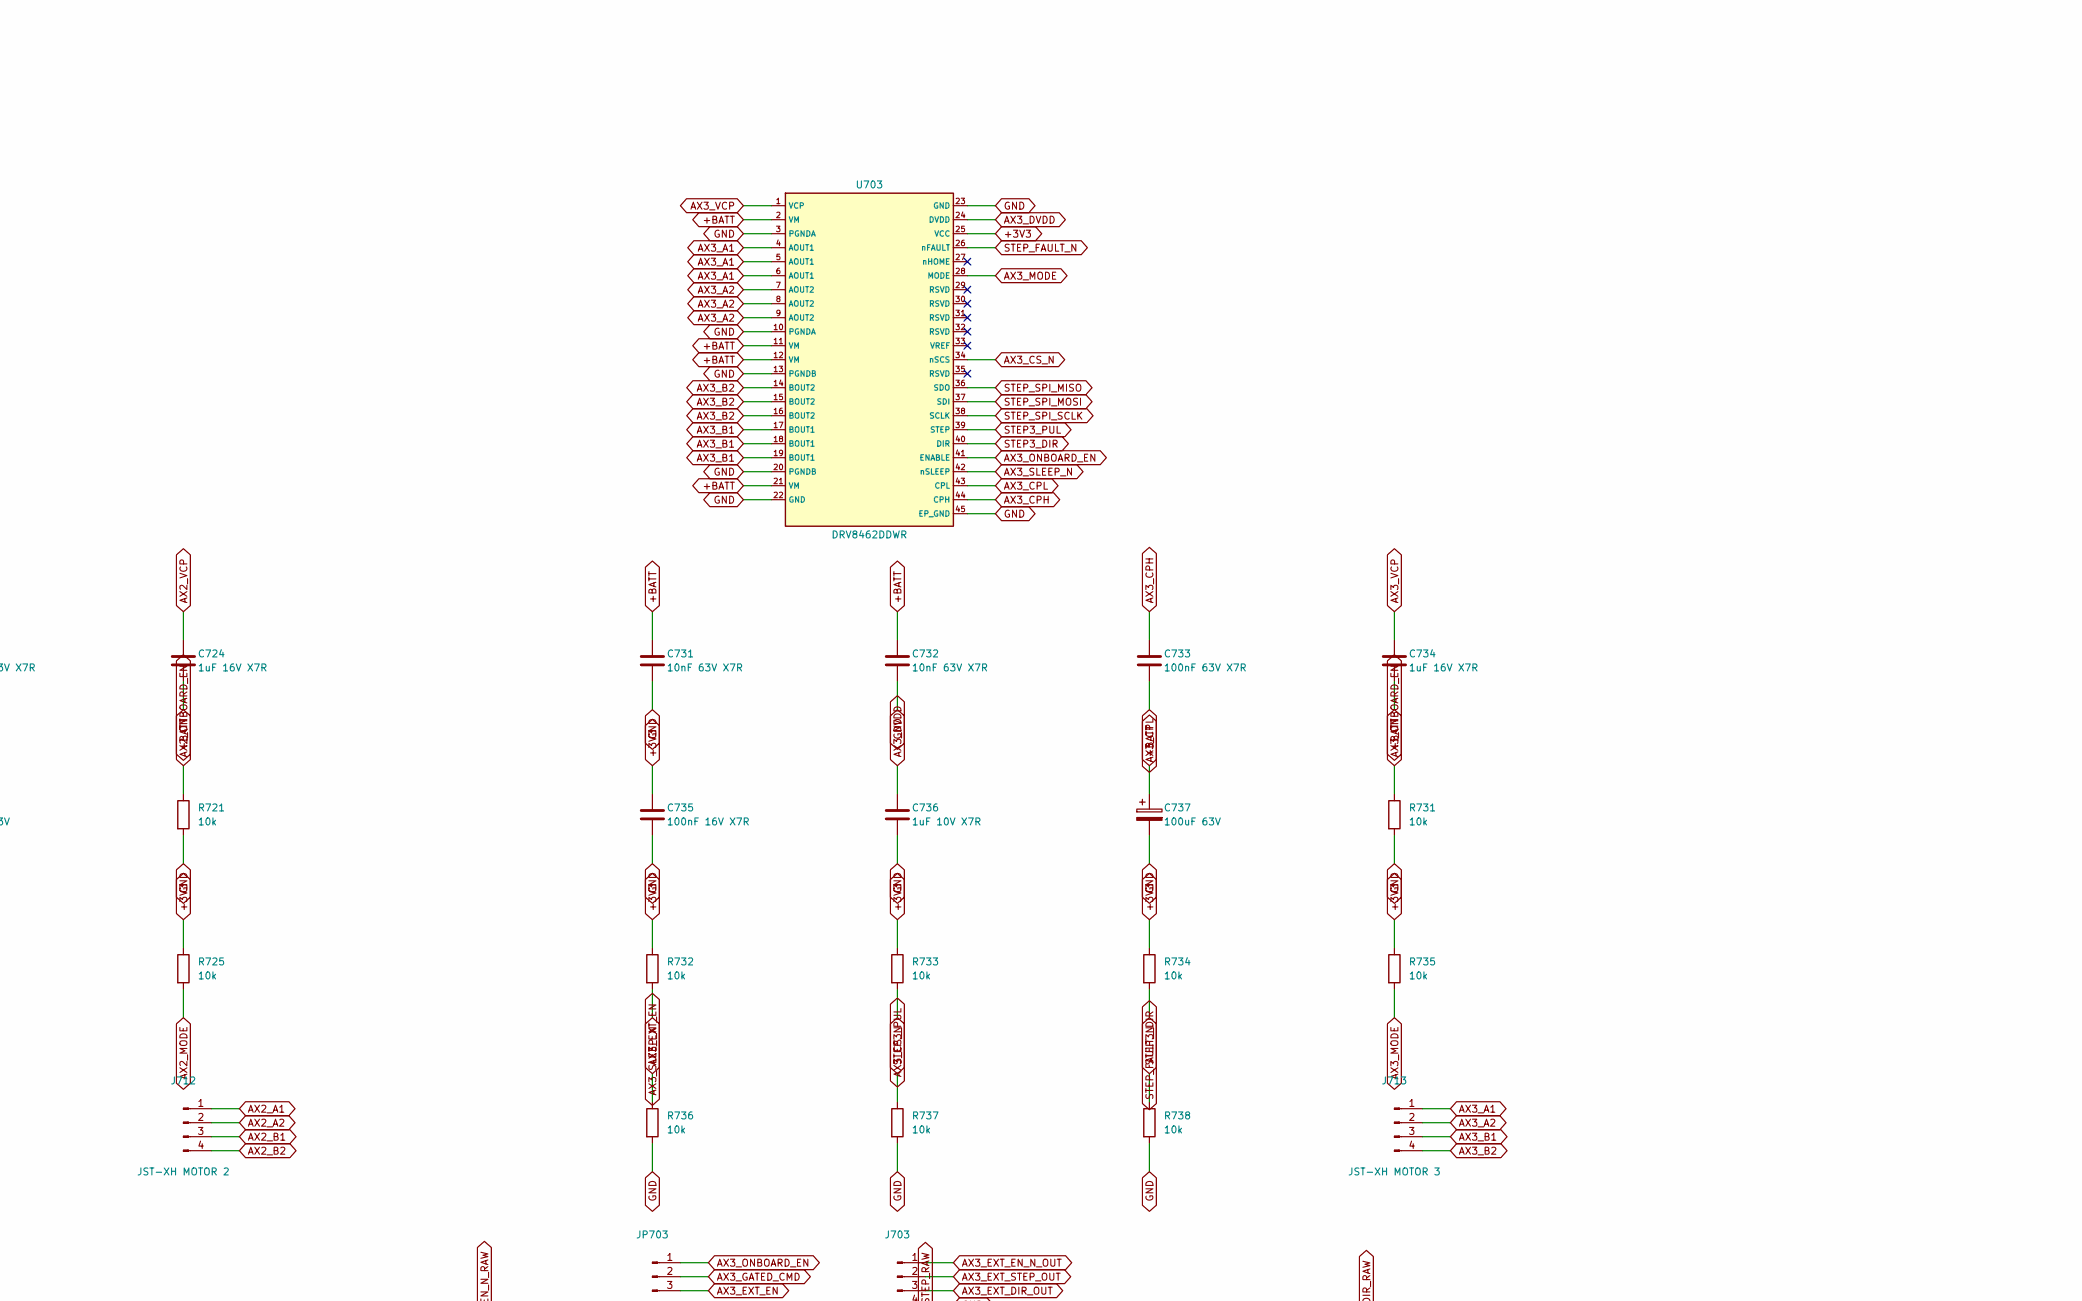
[picture p114: schematic Steppers_Relays.kicad_sch, ABX-Motion, part in row 1, column 2]

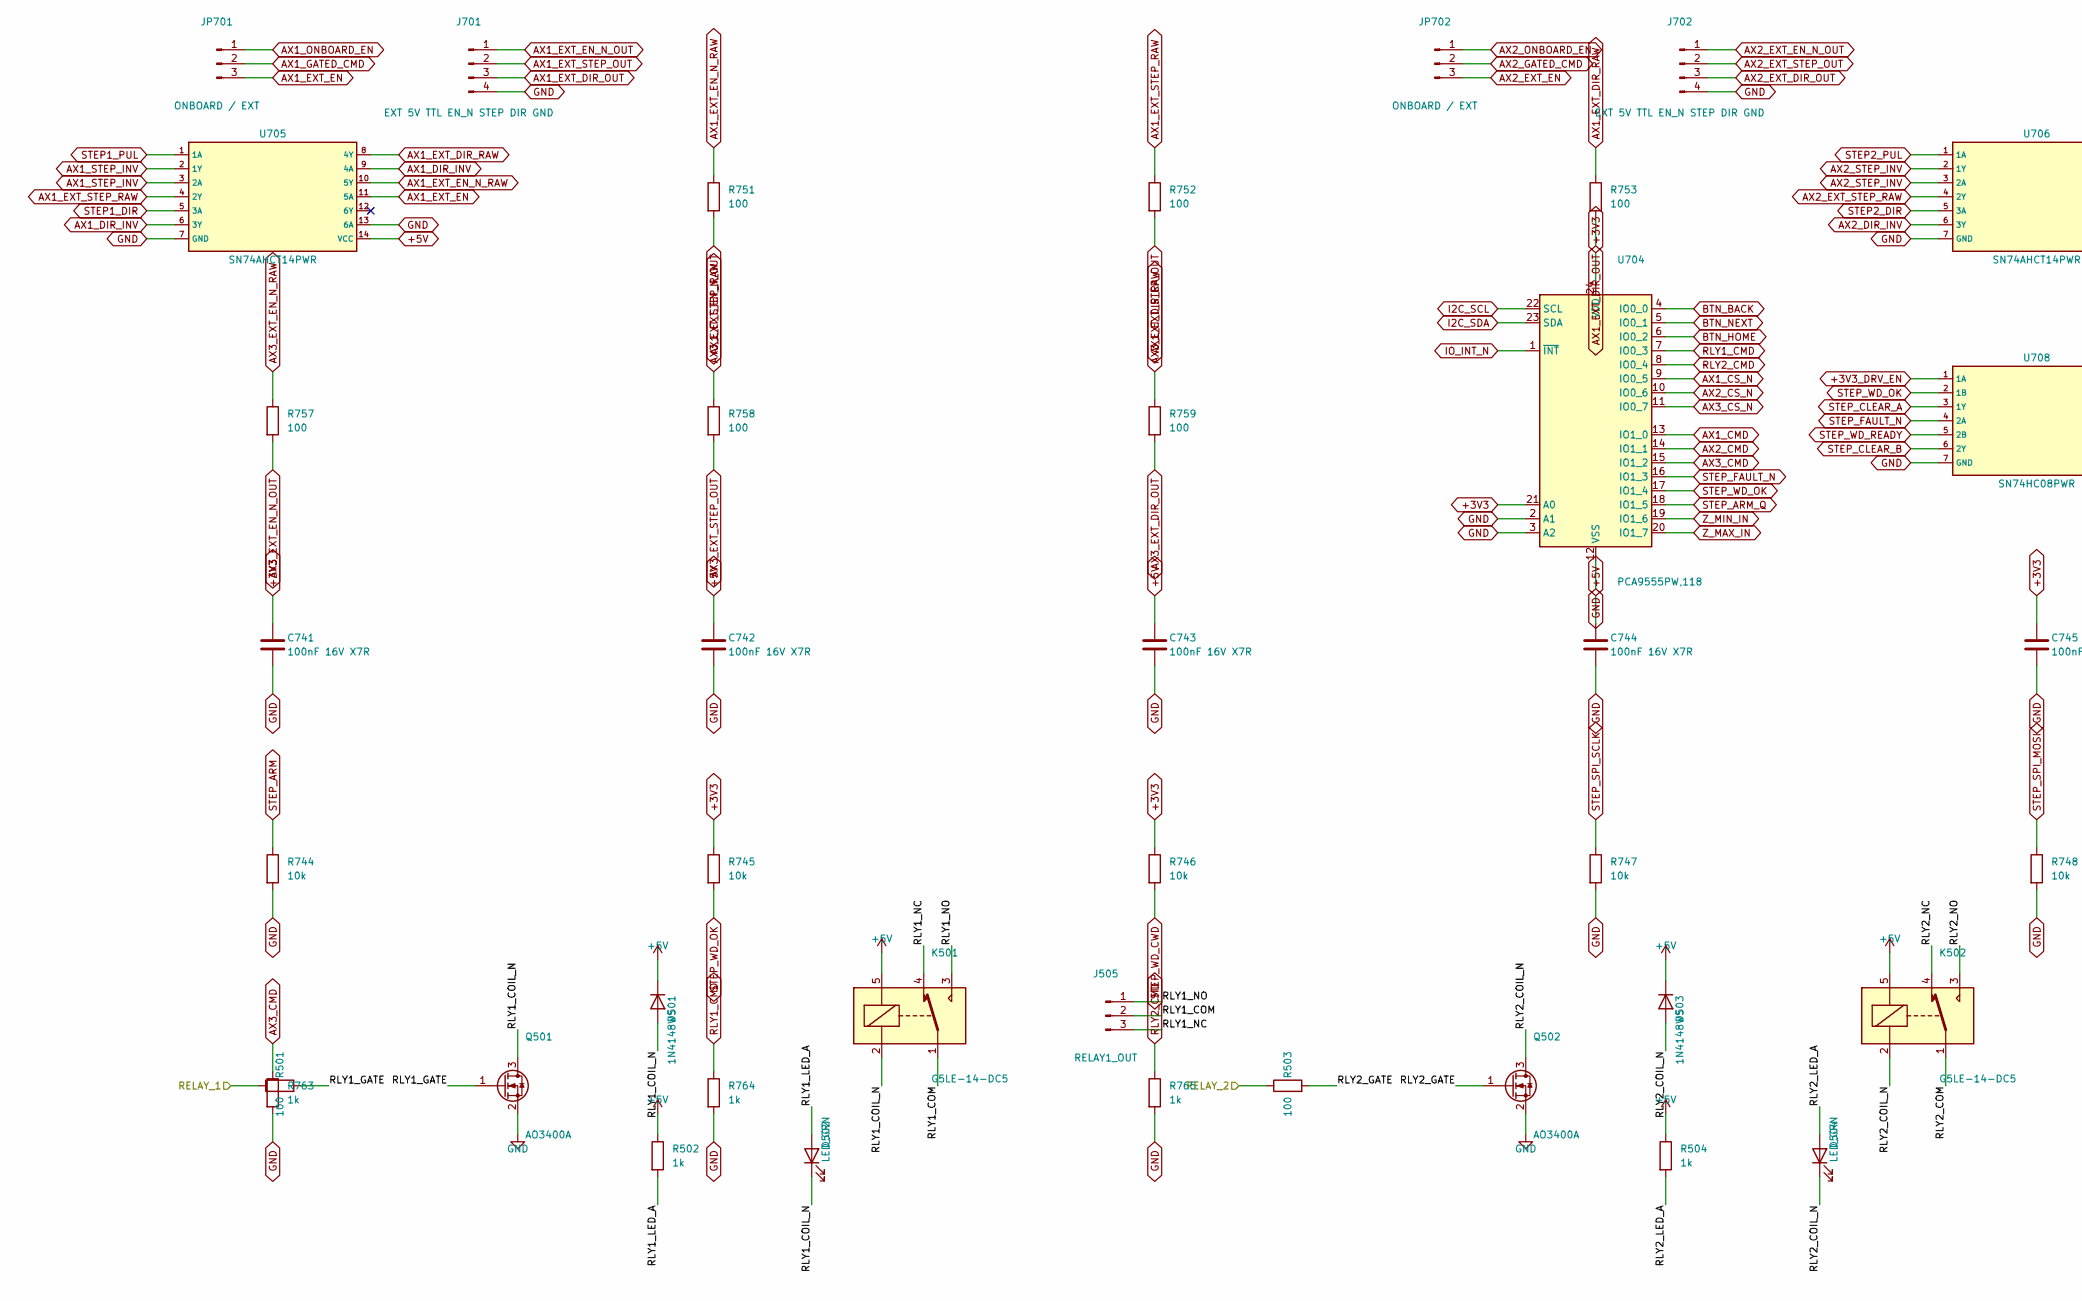
[picture p115: schematic Steppers_Relays.kicad_sch, ABX-Motion, part in row 2, column 1]

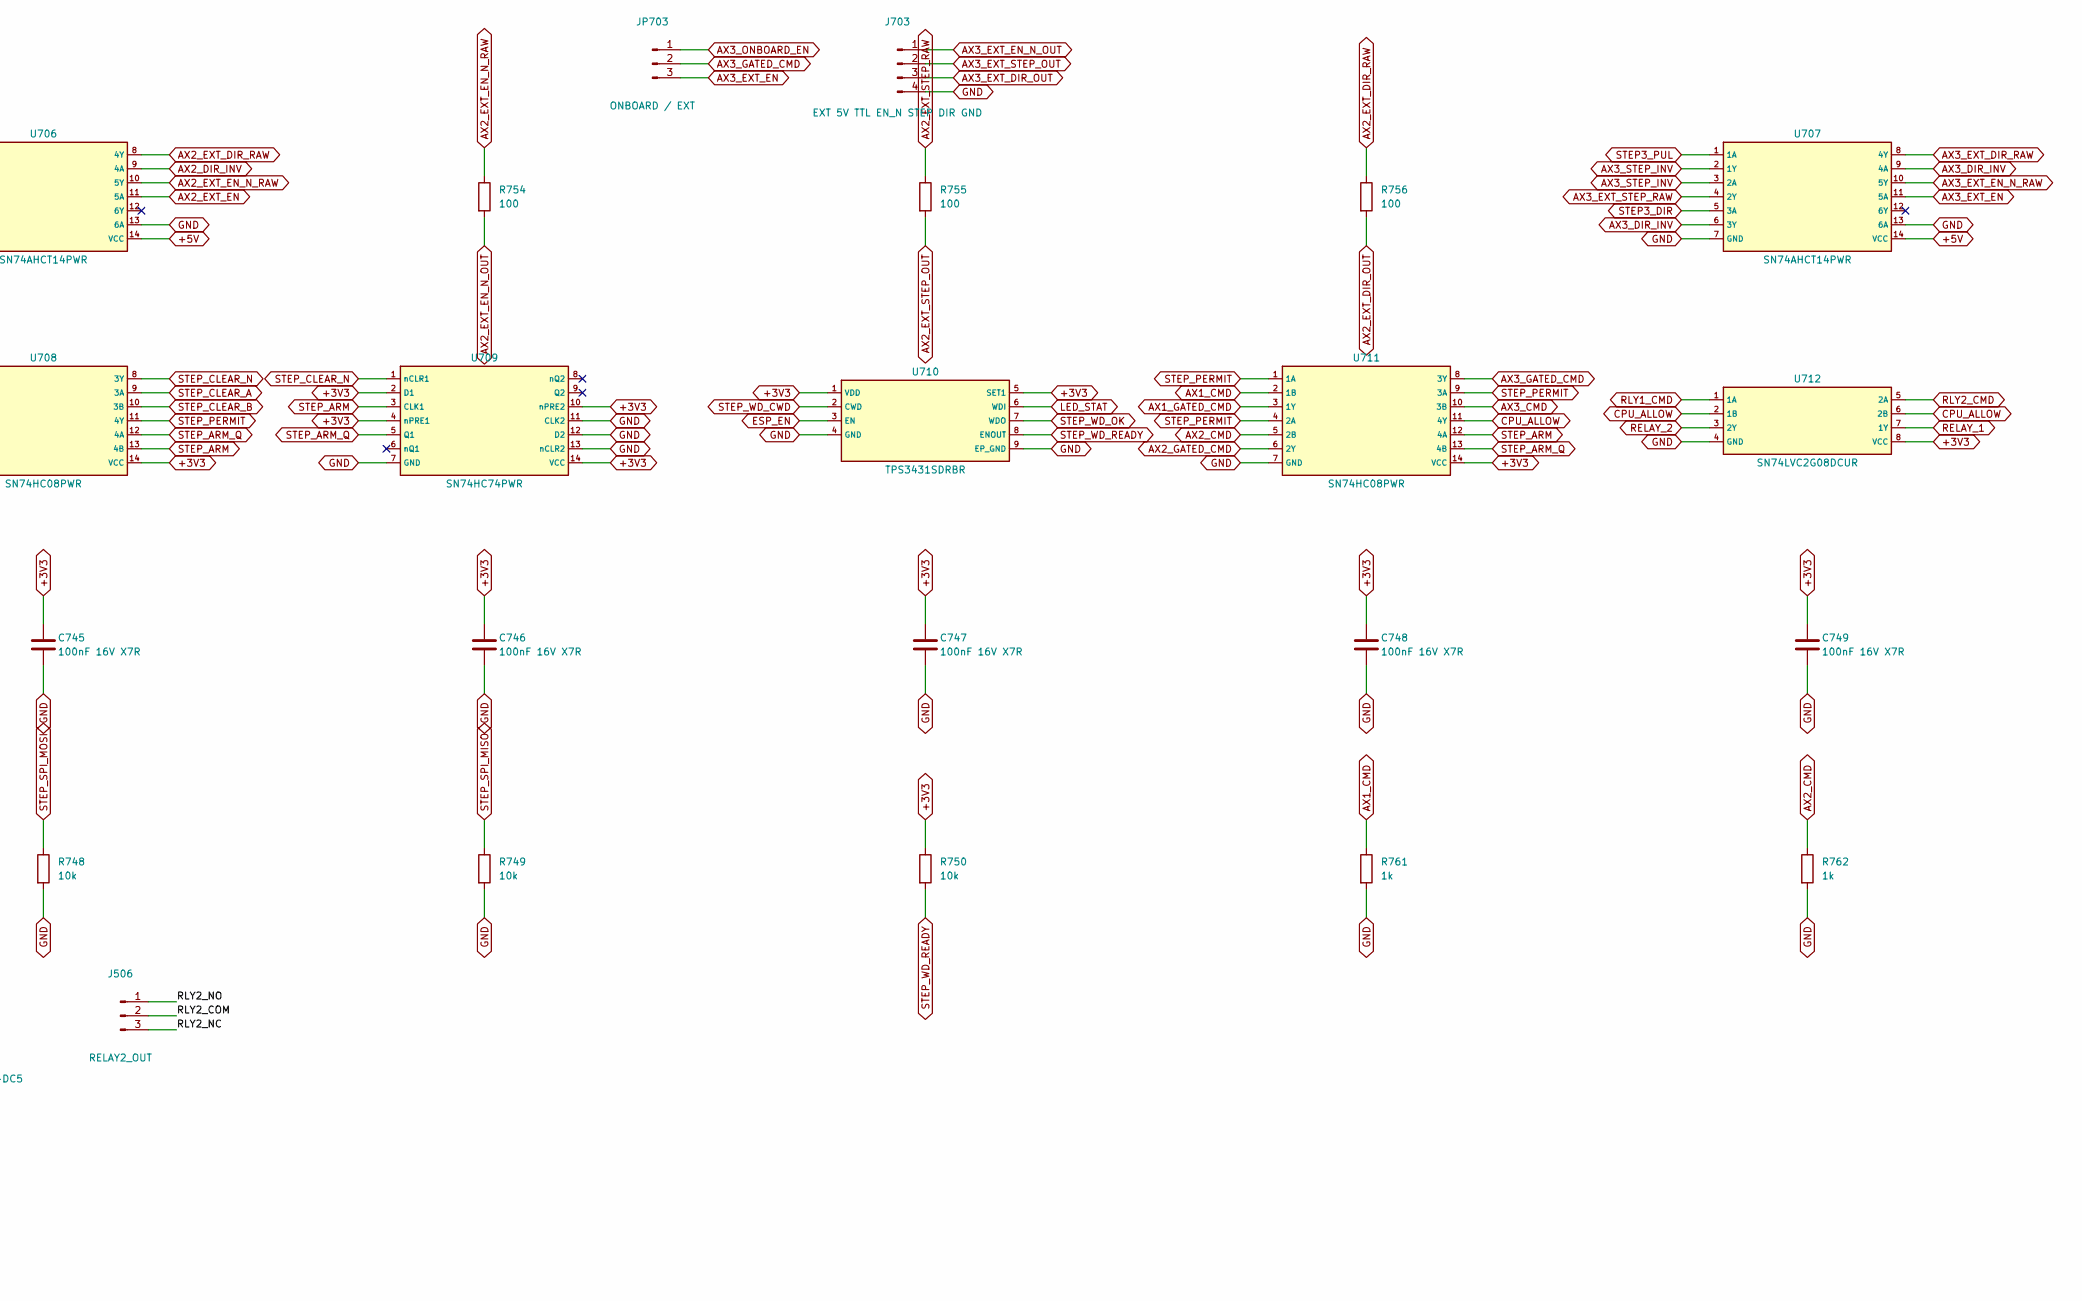
[picture p116: schematic Steppers_Relays.kicad_sch, ABX-Motion, part in row 2, column 2]

Parts:
C711, C712, C721, C722, C731, C732: 10nF 63V X7R; C_0603_1608Metric; LCSC C162275
C713, C723, C733: 100nF 63V X7R; C_0603_1608Metric; LCSC C77058
C714, C724, C734: 1uF 16V X7R; C_0603_1608Metric; LCSC C59782
C715, C725, C735, C741, C742, C743, C744, C745, C746, C747, C748, C749: 100nF 16V X7R; C_0603_1608Metric; LCSC C14663
C716, C726, C736: 1uF 10V X7R; C_0603_1608Metric; LCSC C59782
C717, C727, C737: 100uF 63V; CP_Radial_D8.0mm_P3.50mm; LCSC C88747
D501, D503: 1N4148WS; D_SOD-323; LCSC C2128
D502, D504: LED_GRN; LED_0603_1608Metric; LCSC C12624
J505: RELAY1_OUT; ABX_J505_TerminalBlock_Phoenix_MKDS-1_5-3-5.08_1x03_P5.08mm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; LCSC C72334
J506: RELAY2_OUT; ABX_J506_TerminalBlock_Phoenix_MKDS-1_5-3-5.08_1x03_P5.08mm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; LCSC C72334
J701, J702, J703: EXT 5V TTL EN_N STEP DIR GND; PinHeader_1x04_P2.54mm_Vertical; LCSC C492403
J711: JST-XH MOTOR 1; JST_XH_B4B-XH-A_1x04_P2.50mm_Vertical; LCSC C566014
J712: JST-XH MOTOR 2; JST_XH_B4B-XH-A_1x04_P2.50mm_Vertical; LCSC C566014
J713: JST-XH MOTOR 3; JST_XH_B4B-XH-A_1x04_P2.50mm_Vertical; LCSC C566014
JP701, JP702, JP703: ONBOARD / EXT; PinHeader_1x03_P2.54mm_Vertical; LCSC C492402
K501, K502: G5LE-14-DC5; Relay_SPDT_Omron-G5LE-1; LCSC C116963
Q501, Q502: AO3400A; SOT-23; LCSC C20917
R501, R503, R751, R752, R753, R754, R755, R756, R757, R758, R759: 100; R_0603_1608Metric; LCSC C22775
R502, R504, R761, R762, R763, R764, R765: 1k; R_0603_1608Metric; LCSC C21190
R711, R712, R713, R714, R715, R716, R717, R718, R721, R722, R723, R724, R725, R726, R727, R728, R731, R732, R733, R734, R735, R736, R737, R738, R744, R745, R746, R747, R748, R749, R750: 10k; R_0603_1608Metric; LCSC C25804
U701, U702, U703: DRV8462DDWR; DRV8462_DDW0044E; LCSC C5930226
U704: PCA9555PW,118; TSSOP-24_4.4x7.8mm_P0.65mm; LCSC C128392
U705, U706, U707: SN74AHCT14PWR; TSSOP-14_4.4x5mm_P0.65mm; LCSC C7481
U708, U711: SN74HC08PWR; TSSOP-14_4.4x5mm_P0.65mm; LCSC C7642
U709: SN74HC74PWR; TSSOP-14_4.4x5mm_P0.65mm; LCSC C6761
U710: TPS3431SDRBR; TPS3431_DRB0008A; LCSC C702145
U712: SN74LVC2G08DCUR; VSSOP-8_2.3x2mm_P0.5mm; LCSC C91875

Connections:
+3V3: C715.1, C725.1, C735.1, C741.1, C745.1, C746.1, C747.1, C748.1, C749.1, R712.1, R713.1, R714.1, R715.1, R722.1, R723.1, R724.1, R725.1, R732.1, R733.1, R734.1, R735.1, R745.1, R746.1, R750.1, U701.25 (VCC), U702.25 (VCC), U703.25 (VCC), U704.21 (A0), U704.24 (VDD), U708.14 (VCC), U709.2 (D1), U709.4 (nPRE1), U709.10 (nPRE2), U709.14 (VCC), U710.1 (VDD), U710.5 (SET1), U711.14 (VCC), U712.8 (VCC); also elsewhere on the board
+3V3_DRV_EN: U708.1 (1A); also elsewhere on the board
+5V: C742.1, C743.1, C744.1, D501.1 (K), D503.1 (K), K501.5, K502.5, R502.1, R504.1, U705.14 (VCC), U706.14 (VCC), U707.14 (VCC); also elsewhere on the board
+BATT: C711.1, C712.1, C714.2, C717.1, C721.1, C722.1, C724.2, C727.1, C731.1, C732.1, C734.2, C737.1, U701.2 (VM), U701.11 (VM), U701.12 (VM), U701.21 (VM), U702.2 (VM), U702.11 (VM), U702.12 (VM), U702.21 (VM), U703.2 (VM), U703.11 (VM), U703.12 (VM), U703.21 (VM); also elsewhere on the board
/Steppers_and_Relays/RLY1_COIL_N: D501.2 (A), D502.1 (K), K501.2, Q501.3 (D)
/Steppers_and_Relays/RLY1_COM: J505.2, K501.1
/Steppers_and_Relays/RLY1_GATE: Q501.1 (G), R501.2
/Steppers_and_Relays/RLY1_LED_A: D502.2 (A), R502.2
/Steppers_and_Relays/RLY1_NC: J505.3, K501.4
/Steppers_and_Relays/RLY1_NO: J505.1, K501.3
/Steppers_and_Relays/RLY2_COIL_N: D503.2 (A), D504.1 (K), K502.2, Q502.3 (D)
/Steppers_and_Relays/RLY2_COM: J506.2, K502.1
/Steppers_and_Relays/RLY2_GATE: Q502.1 (G), R503.2
/Steppers_and_Relays/RLY2_LED_A: D504.2 (A), R504.2
/Steppers_and_Relays/RLY2_NC: J506.3, K502.4
/Steppers_and_Relays/RLY2_NO: J506.1, K502.3
AX1_A1: J711.1, U701.4 (AOUT1), U701.5 (AOUT1), U701.6 (AOUT1)
AX1_A2: J711.2, U701.7 (AOUT2), U701.8 (AOUT2), U701.9 (AOUT2)
AX1_B1: J711.3, U701.17 (BOUT1), U701.18 (BOUT1), U701.19 (BOUT1)
AX1_B2: J711.4, U701.14 (BOUT2), U701.15 (BOUT2), U701.16 (BOUT2)
AX1_CMD: R761.1, U704.13 (IO1_0), U711.2 (1B)
AX1_CPH: C713.1, U701.44 (CPH)
AX1_CPL: C713.2, U701.43 (CPL)
AX1_CS_N: R713.2, U701.34 (nSCS), U704.9 (IO0_5)
AX1_DIR_INV: U705.6 (3Y), U705.9 (4A)
AX1_DVDD: C716.1, U701.24 (DVDD)
AX1_EXT_DIR_OUT: J701.3, R753.2
AX1_EXT_DIR_RAW: R753.1, U705.8 (4Y)
AX1_EXT_EN: JP701.3, R716.1, U705.11 (5A)
AX1_EXT_EN_N_OUT: J701.1, R751.2
AX1_EXT_EN_N_RAW: R751.1, U705.10 (5Y)
AX1_EXT_STEP_OUT: J701.2, R752.2
AX1_EXT_STEP_RAW: R752.1, U705.4 (2Y)
AX1_GATED_CMD: JP701.2, U711.3 (1Y)
AX1_MODE: R715.2, U701.28 (MODE)
AX1_ONBOARD_EN: JP701.1, R711.1, U701.41 (ENABLE)
AX1_SLEEP_N: R712.2, U701.42 (nSLEEP)
AX1_STEP_INV: U705.2 (1Y), U705.3 (2A)
AX1_VCP: C714.1, U701.1 (VCP)
AX2_A1: J712.1, U702.4 (AOUT1), U702.5 (AOUT1), U702.6 (AOUT1)
AX2_A2: J712.2, U702.7 (AOUT2), U702.8 (AOUT2), U702.9 (AOUT2)
AX2_B1: J712.3, U702.17 (BOUT1), U702.18 (BOUT1), U702.19 (BOUT1)
AX2_B2: J712.4, U702.14 (BOUT2), U702.15 (BOUT2), U702.16 (BOUT2)
AX2_CMD: R762.1, U704.14 (IO1_1), U711.5 (2B)
AX2_CPH: C723.1, U702.44 (CPH)
AX2_CPL: C723.2, U702.43 (CPL)
AX2_CS_N: R723.2, U702.34 (nSCS), U704.10 (IO0_6)
AX2_DIR_INV: U706.6 (3Y), U706.9 (4A)
AX2_DVDD: C726.1, U702.24 (DVDD)
AX2_EXT_DIR_OUT: J702.3, R756.2
AX2_EXT_DIR_RAW: R756.1, U706.8 (4Y)
AX2_EXT_EN: JP702.3, R726.1, U706.11 (5A)
AX2_EXT_EN_N_OUT: J702.1, R754.2
AX2_EXT_EN_N_RAW: R754.1, U706.10 (5Y)
AX2_EXT_STEP_OUT: J702.2, R755.2
AX2_EXT_STEP_RAW: R755.1, U706.4 (2Y)
AX2_GATED_CMD: JP702.2, U711.6 (2Y)
AX2_MODE: R725.2, U702.28 (MODE)
AX2_ONBOARD_EN: JP702.1, R721.1, U702.41 (ENABLE)
AX2_SLEEP_N: R722.2, U702.42 (nSLEEP)
AX2_STEP_INV: U706.2 (1Y), U706.3 (2A)
AX2_VCP: C724.1, U702.1 (VCP)
AX3_A1: J713.1, U703.4 (AOUT1), U703.5 (AOUT1), U703.6 (AOUT1)
AX3_A2: J713.2, U703.7 (AOUT2), U703.8 (AOUT2), U703.9 (AOUT2)
AX3_B1: J713.3, U703.17 (BOUT1), U703.18 (BOUT1), U703.19 (BOUT1)
AX3_B2: J713.4, U703.14 (BOUT2), U703.15 (BOUT2), U703.16 (BOUT2)
AX3_CMD: R763.1, U704.15 (IO1_2), U711.10 (3B)
AX3_CPH: C733.1, U703.44 (CPH)
AX3_CPL: C733.2, U703.43 (CPL)
AX3_CS_N: R733.2, U703.34 (nSCS), U704.11 (IO0_7)
AX3_DIR_INV: U707.6 (3Y), U707.9 (4A)
AX3_DVDD: C736.1, U703.24 (DVDD)
AX3_EXT_DIR_OUT: J703.3, R759.2
AX3_EXT_DIR_RAW: R759.1, U707.8 (4Y)
AX3_EXT_EN: JP703.3, R736.1, U707.11 (5A)
AX3_EXT_EN_N_OUT: J703.1, R757.2
AX3_EXT_EN_N_RAW: R757.1, U707.10 (5Y)
AX3_EXT_STEP_OUT: J703.2, R758.2
AX3_EXT_STEP_RAW: R758.1, U707.4 (2Y)
AX3_GATED_CMD: JP703.2, U711.8 (3Y)
AX3_MODE: R735.2, U703.28 (MODE)
AX3_ONBOARD_EN: JP703.1, R731.1, U703.41 (ENABLE)
AX3_SLEEP_N: R732.2, U703.42 (nSLEEP)
AX3_STEP_INV: U707.2 (1Y), U707.3 (2A)
AX3_VCP: C734.1, U703.1 (VCP)
BTN_BACK: U704.4 (IO0_0); also elsewhere on the board
BTN_HOME: U704.6 (IO0_2); also elsewhere on the board
BTN_NEXT: U704.5 (IO0_1); also elsewhere on the board
CPU_ALLOW: U711.11 (4Y), U712.2 (1B), U712.6 (2B)
ESP_EN: U710.3 (EN); also elsewhere on the board
GND: C711.2, C712.2, C715.2, C716.2, C717.2, C721.2, C722.2, C725.2, C726.2, C727.2, C731.2, C732.2, C735.2, C736.2, C737.2, C741.2, C742.2, C743.2, C744.2, C745.2, C746.2, C747.2, C748.2, C749.2, J701.4, J702.4, J703.4, Q501.2 (S), Q502.2 (S), R711.2, R716.2, R717.2, R718.2, R721.2, R726.2, R727.2, R728.2, R731.2, R736.2, R737.2, R738.2, R744.2, R747.2, R748.2, R749.2, R761.2, R762.2, R763.2, R764.2, R765.2, U701.3 (PGNDA), U701.10 (PGNDA), U701.13 (PGNDB), U701.20 (PGNDB), U701.22 (GND), U701.23 (GND), U701.45 (EP_GND), U702.3 (PGNDA), U702.10 (PGNDA), U702.13 (PGNDB), U702.20 (PGNDB), U702.22 (GND), U702.23 (GND), U702.45 (EP_GND), U703.3 (PGNDA), U703.10 (PGNDA), U703.13 (PGNDB), U703.20 (PGNDB), U703.22 (GND), U703.23 (GND), U703.45 (EP_GND), U704.2 (A1), U704.3 (A2), U704.12 (VSS), U705.7 (GND), U705.13 (6A), U706.7 (GND), U706.13 (6A), U707.7 (GND), U707.13 (6A), U708.7 (GND), U709.7 (GND), U709.11 (CLK2), U709.12 (D2), U709.13 (nCLR2), U710.4 (GND), U710.9 (EP_GND), U711.7 (GND), U712.4 (GND); also elsewhere on the board
I2C_SCL: U704.22 (SCL); also elsewhere on the board
I2C_SDA: U704.23 (SDA); also elsewhere on the board
IO_INT_N: U704.1 (~INT); also elsewhere on the board
LED_STAT: U710.6 (WDI); also elsewhere on the board
RELAY_1: R501.1, U712.7 (1Y); also elsewhere on the board
RELAY_2: R503.1, U712.3 (2Y); also elsewhere on the board
RLY1_CMD: R764.1, U704.7 (IO0_3), U712.1 (1A)
RLY2_CMD: R765.1, U704.8 (IO0_4), U712.5 (2A)
STEP1_DIR: R718.1, U701.40 (DIR), U705.5 (3A); also elsewhere on the board
STEP1_PUL: R717.1, U701.39 (STEP), U705.1 (1A); also elsewhere on the board
STEP2_DIR: R728.1, U702.40 (DIR), U706.5 (3A); also elsewhere on the board
STEP2_PUL: R727.1, U702.39 (STEP), U706.1 (1A); also elsewhere on the board
STEP3_DIR: R738.1, U703.40 (DIR), U707.5 (3A); also elsewhere on the board
STEP3_PUL: R737.1, U703.39 (STEP), U707.1 (1A); also elsewhere on the board
STEP_ARM: R744.1, U708.13 (4B), U709.3 (CLK1), U711.12 (4A); also elsewhere on the board
STEP_ARM_Q: U704.18 (IO1_5), U708.12 (4A), U709.5 (Q1), U711.13 (4B)
STEP_CLEAR_A: U708.3 (1Y), U708.9 (3A)
STEP_CLEAR_B: U708.6 (2Y), U708.10 (3B)
STEP_CLEAR_N: U708.8 (3Y), U709.1 (nCLR1)
STEP_FAULT_N: R714.2, R724.2, R734.2, U701.26 (nFAULT), U702.26 (nFAULT), U703.26 (nFAULT), U704.16 (IO1_3), U708.4 (2A)
STEP_PERMIT: U708.11 (4Y), U711.1 (1A), U711.4 (2A), U711.9 (3A)
STEP_SPI_MISO: R749.1, U701.36 (SDO), U702.36 (SDO), U703.36 (SDO); also elsewhere on the board
STEP_SPI_MOSI: R748.1, U701.37 (SDI), U702.37 (SDI), U703.37 (SDI); also elsewhere on the board
STEP_SPI_SCLK: R747.1, U701.38 (SCLK), U702.38 (SCLK), U703.38 (SCLK); also elsewhere on the board
STEP_WD_CWD: R746.2, U710.2 (CWD)
STEP_WD_OK: R745.2, U704.17 (IO1_4), U708.2 (1B), U710.7 (WDO)
STEP_WD_READY: R750.2, U708.5 (2B), U710.8 (ENOUT)
Z_MAX_IN: U704.20 (IO1_7); also elsewhere on the board
Z_MIN_IN: U704.19 (IO1_6); also elsewhere on the board

Notes on the sheet:
REV 1.2: THREE DRV8462 AXES — HARDWARE ARM / WATCHDOG / EXTERNAL OUTPUTS
2 A RMS normal design target; 3 A RMS NOT thermally qualified. EXT: 5V TTL, EN active LOW. Powered hot-plug not supported.

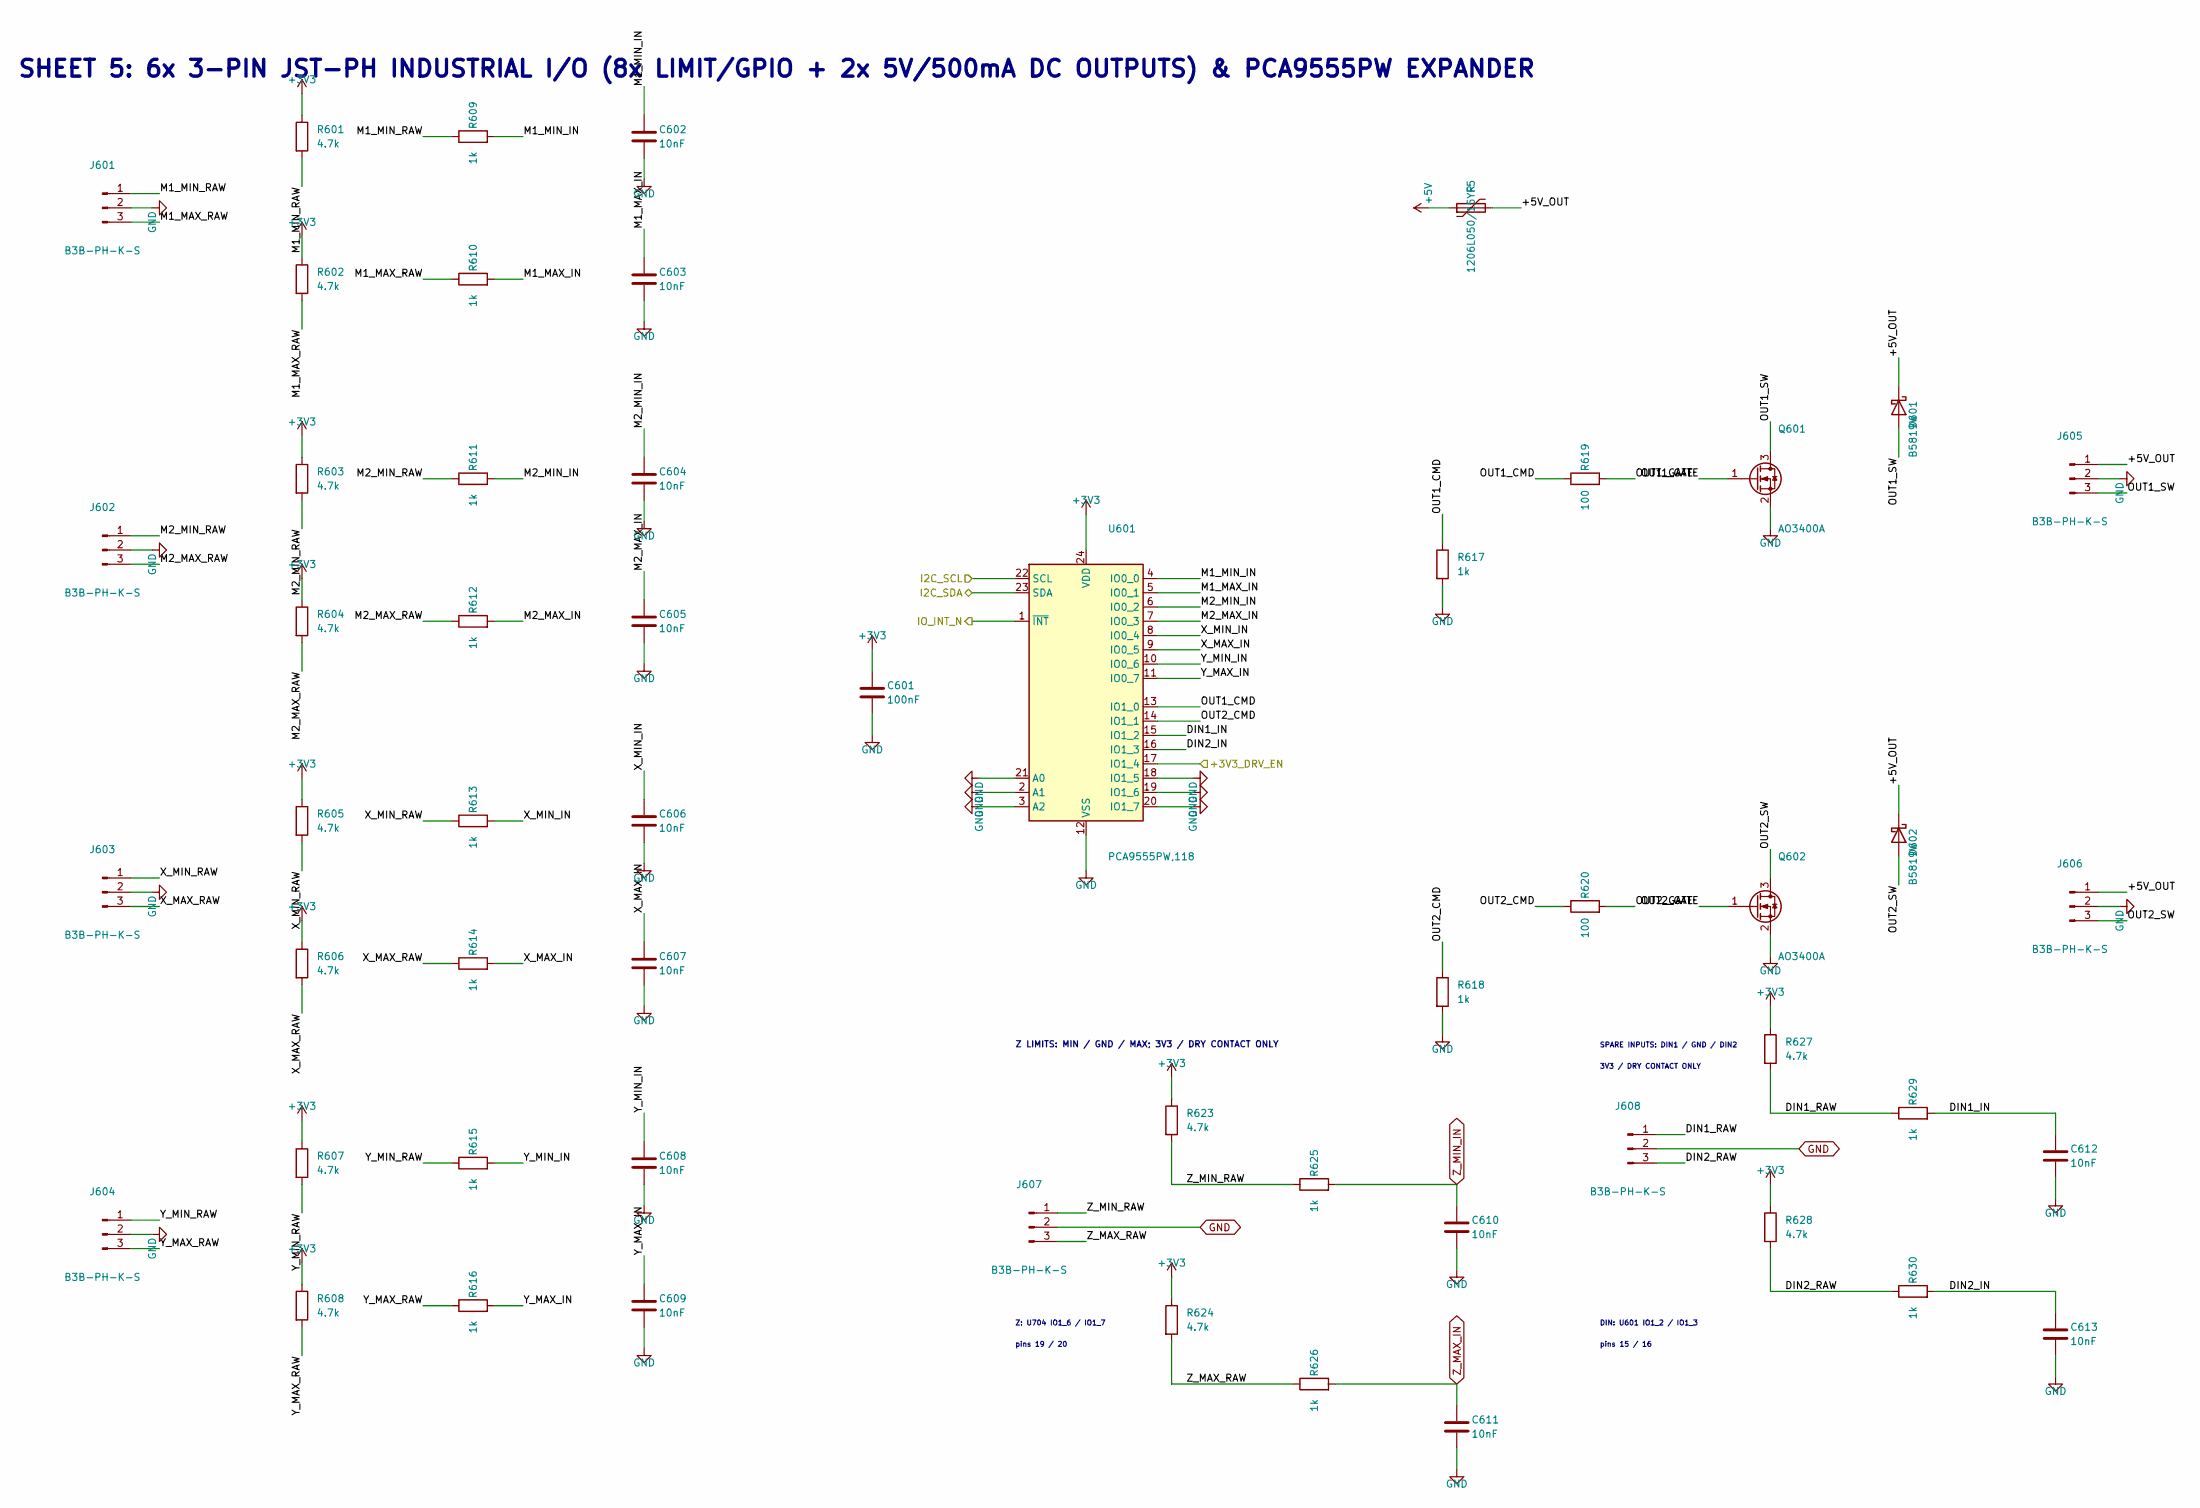
[picture p117: schematic Industrial_IO.kicad_sch, ABX-Motion]

Parts:
C601: 100nF; C_0603_1608Metric; LCSC C14663
C602, C603, C604, C605, C606, C607, C608, C609, C610, C611, C612, C613: 10nF; C_0603_1608Metric; LCSC C57112
D601, D602: B5819W; D_SOD-123; LCSC C8598
F5: 1206L050/15YR; Fuse_1206_3216Metric; LCSC C151162
J601, J602, J603, J604, J605, J606, J607, J608: B3B-PH-K-S; JST_PH_B3B-PH-K_1x03_P2.00mm_Vertical; LCSC C131339
Q601, Q602: AO3400A; SOT-23; LCSC C20917
R601, R602, R603, R604, R605, R606, R607, R608, R623, R624, R627, R628: 4.7k; R_0603_1608Metric; LCSC C23162
R609, R610, R611, R612, R613, R614, R615, R616, R617, R618, R625, R626, R629, R630: 1k; R_0603_1608Metric; LCSC C21190
R619, R620: 100; R_0603_1608Metric; LCSC C22775
U601: PCA9555PW,118; TSSOP-24_4.4x7.8mm_P0.65mm; LCSC C128392

Connections:
+3V3: C601.1, R601.1, R602.1, R603.1, R604.1, R605.1, R606.1, R607.1, R608.1, R623.1, R624.1, R627.1, R628.1, U601.24 (VDD); also elsewhere on the board
+3V3_DRV_EN: U601.17 (IO1_4); also elsewhere on the board
+5V: F5.1; also elsewhere on the board
/Industrial_IO/+5V_OUT: D601.1 (K), D602.1 (K), F5.2, J605.1, J606.1
/Industrial_IO/DIN1_IN: C612.1, R629.2, U601.15 (IO1_2)
/Industrial_IO/DIN1_RAW: J608.1, R627.2, R629.1
/Industrial_IO/DIN2_IN: C613.1, R630.2, U601.16 (IO1_3)
/Industrial_IO/DIN2_RAW: J608.3, R628.2, R630.1
/Industrial_IO/M1_MAX_IN: C603.1, R610.2, U601.5 (IO0_1)
/Industrial_IO/M1_MAX_RAW: J601.3, R602.2, R610.1
/Industrial_IO/M1_MIN_IN: C602.1, R609.2, U601.4 (IO0_0)
/Industrial_IO/M1_MIN_RAW: J601.1, R601.2, R609.1
/Industrial_IO/M2_MAX_IN: C605.1, R612.2, U601.7 (IO0_3)
/Industrial_IO/M2_MAX_RAW: J602.3, R604.2, R612.1
/Industrial_IO/M2_MIN_IN: C604.1, R611.2, U601.6 (IO0_2)
/Industrial_IO/M2_MIN_RAW: J602.1, R603.2, R611.1
/Industrial_IO/OUT1_CMD: R617.1, R619.1, U601.13 (IO1_0)
/Industrial_IO/OUT1_GATE: Q601.1 (G), R619.2
/Industrial_IO/OUT1_SW: D601.2 (A), J605.3, Q601.3 (D)
/Industrial_IO/OUT2_CMD: R618.1, R620.1, U601.14 (IO1_1)
/Industrial_IO/OUT2_GATE: Q602.1 (G), R620.2
/Industrial_IO/OUT2_SW: D602.2 (A), J606.3, Q602.3 (D)
/Industrial_IO/X_MAX_IN: C607.1, R614.2, U601.9 (IO0_5)
/Industrial_IO/X_MAX_RAW: J603.3, R606.2, R614.1
/Industrial_IO/X_MIN_IN: C606.1, R613.2, U601.8 (IO0_4)
/Industrial_IO/X_MIN_RAW: J603.1, R605.2, R613.1
/Industrial_IO/Y_MAX_IN: C609.1, R616.2, U601.11 (IO0_7)
/Industrial_IO/Y_MAX_RAW: J604.3, R608.2, R616.1
/Industrial_IO/Y_MIN_IN: C608.1, R615.2, U601.10 (IO0_6)
/Industrial_IO/Y_MIN_RAW: J604.1, R607.2, R615.1
/Industrial_IO/Z_MAX_RAW: J607.3, R624.2, R626.1
/Industrial_IO/Z_MIN_RAW: J607.1, R623.2, R625.1
GND: C601.2, C602.2, C603.2, C604.2, C605.2, C606.2, C607.2, C608.2, C609.2, C610.2, C611.2, C612.2, C613.2, J601.2, J602.2, J603.2, J604.2, J605.2, J606.2, J607.2, J608.2, Q601.2 (S), Q602.2 (S), R617.2, R618.2, U601.2 (A1), U601.3 (A2), U601.12 (VSS), U601.18 (IO1_5), U601.19 (IO1_6), U601.20 (IO1_7), U601.21 (A0); also elsewhere on the board
I2C_SCL: U601.22 (SCL); also elsewhere on the board
I2C_SDA: U601.23 (SDA); also elsewhere on the board
IO_INT_N: U601.1 (~INT); also elsewhere on the board
Z_MAX_IN: C611.1, R626.2; also elsewhere on the board
Z_MIN_IN: C610.1, R625.2; also elsewhere on the board

Notes on the sheet:
SHEET 5: 6x 3-PIN JST-PH INDUSTRIAL I/O (8x LIMIT/GPIO + 2x 5V/500mA DC OUTPUTS) & PCA9555PW EXPANDER
Z LIMITS: MIN / GND / MAX; 3V3 / DRY CONTACT ONLY
SPARE INPUTS: DIN1 / GND / DIN2
3V3 / DRY CONTACT ONLY
Z: U704 IO1_6 / IO1_7
pins 19 / 20
DIN: U601 IO1_2 / IO1_3
pins 15 / 16
