levdan159/abx-motion/abx-motion.kicad_pcb

## KiCad design abx-motion.kicad_pcb (continued)

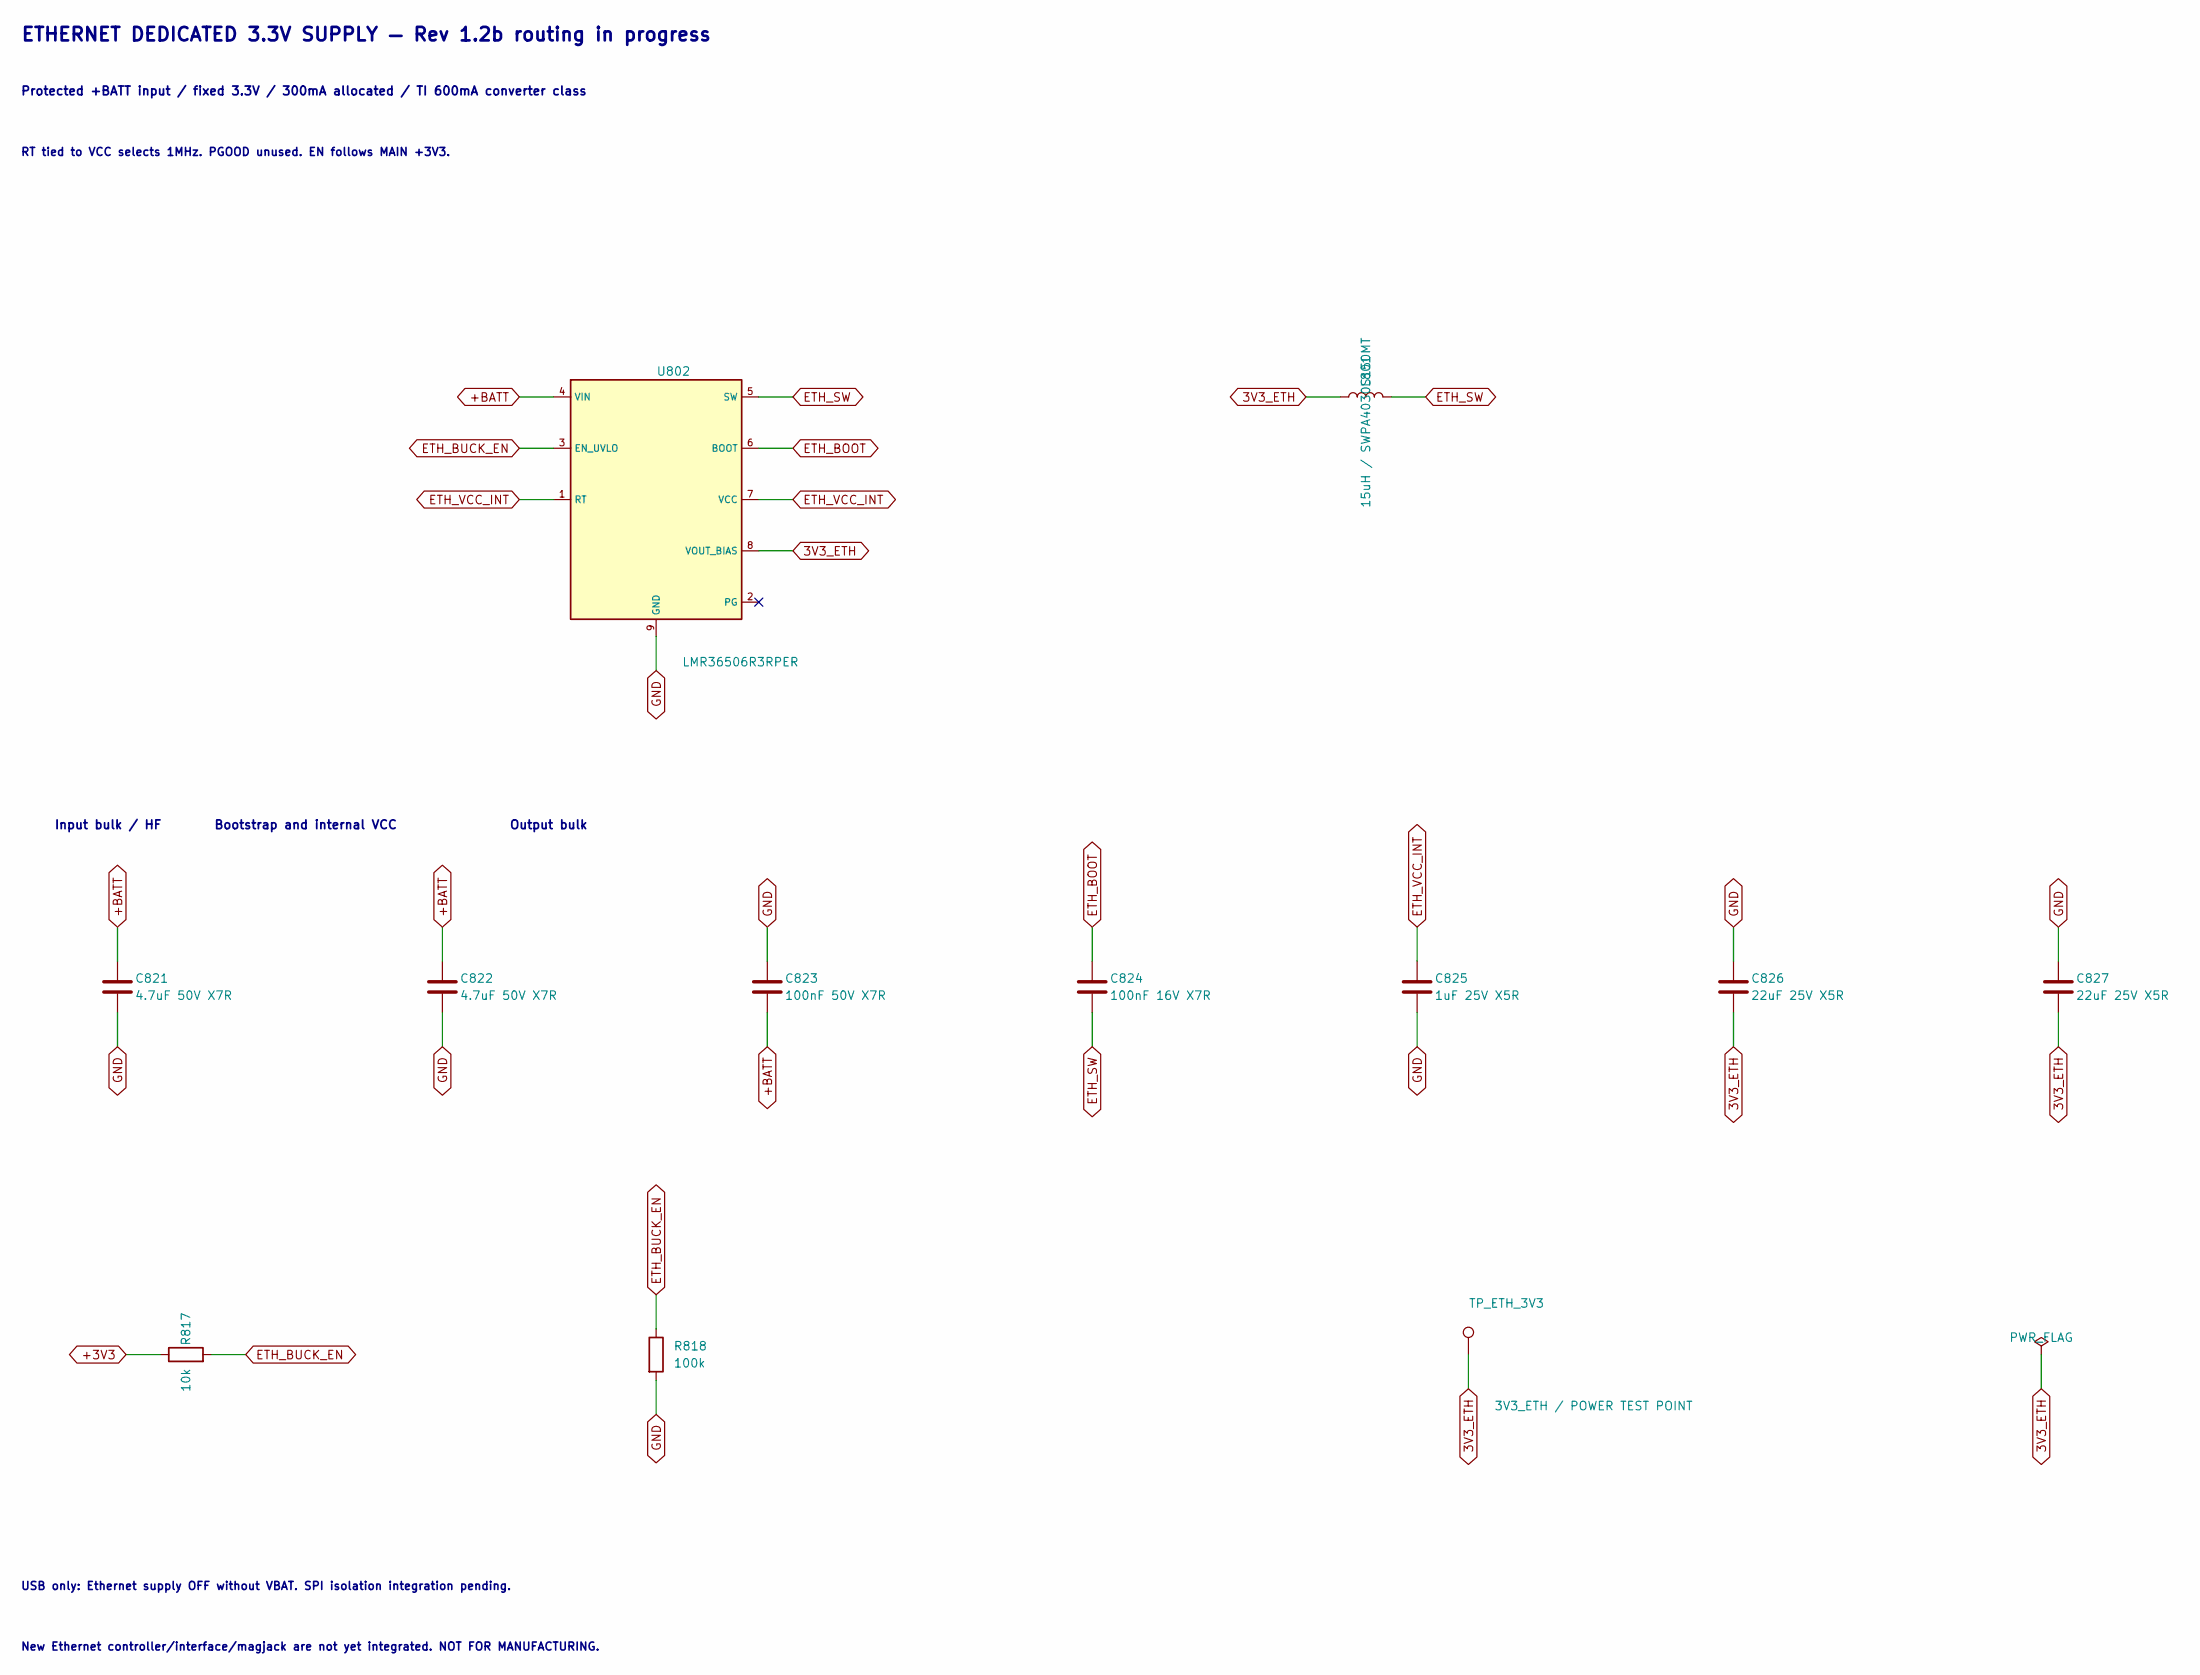
[picture p118: schematic Ethernet_Power.kicad_sch, ABX-Motion]

Parts:
C821, C822: 4.7uF 50V X7R; C_1206_3216Metric
C823: 100nF 50V X7R; C_0603_1608Metric
C824: 100nF 16V X7R; C_0402_1005Metric
C825: 1uF 25V X5R; C_0402_1005Metric
C826, C827: 22uF 25V X5R; C_1206_3216Metric
L801: 15uH / SWPA4030S150MT; L_Sunlord_SWPA4030S
R817: 10k; R_0402_1005Metric
R818: 100k; R_0402_1005Metric
TP_ETH_3V3: 3V3_ETH / POWER TEST POINT; TestPoint_Pad_D1.5mm
U802: LMR36506R3RPER; LMR36506_RPE0009B

Connections:
3V3_ETH: C826.2, C827.2, L801.1, TP_ETH_3V3.1, U802.8 (VOUT_BIAS)
+3V3: R817.1; also elsewhere on the board
+BATT: C821.1, C822.1, C823.2, U802.4 (VIN); also elsewhere on the board
ETH_BOOT: C824.1, U802.6 (BOOT)
ETH_BUCK_EN: R817.2, R818.1, U802.3 (EN_UVLO)
ETH_SW: C824.2, L801.2, U802.5 (SW)
ETH_VCC_INT: C825.1, U802.1 (RT), U802.7 (VCC)
GND: C821.2, C822.2, C823.1, C825.2, C826.1, C827.1, R818.2, U802.9 (GND); also elsewhere on the board

Notes on the sheet:
ETHERNET DEDICATED 3.3V SUPPLY — Rev 1.2b routing in progress
Protected +BATT input / fixed 3.3V / 300mA allocated / TI 600mA converter class
RT tied to VCC selects 1MHz. PGOOD unused. EN follows MAIN +3V3.
Input bulk / HF Bootstrap and internal VCC Output bulk
USB only: Ethernet supply OFF without VBAT. SPI isolation integration pending.
New Ethernet controller/interface/magjack are not yet integrated. NOT FOR MANUFACTURING.

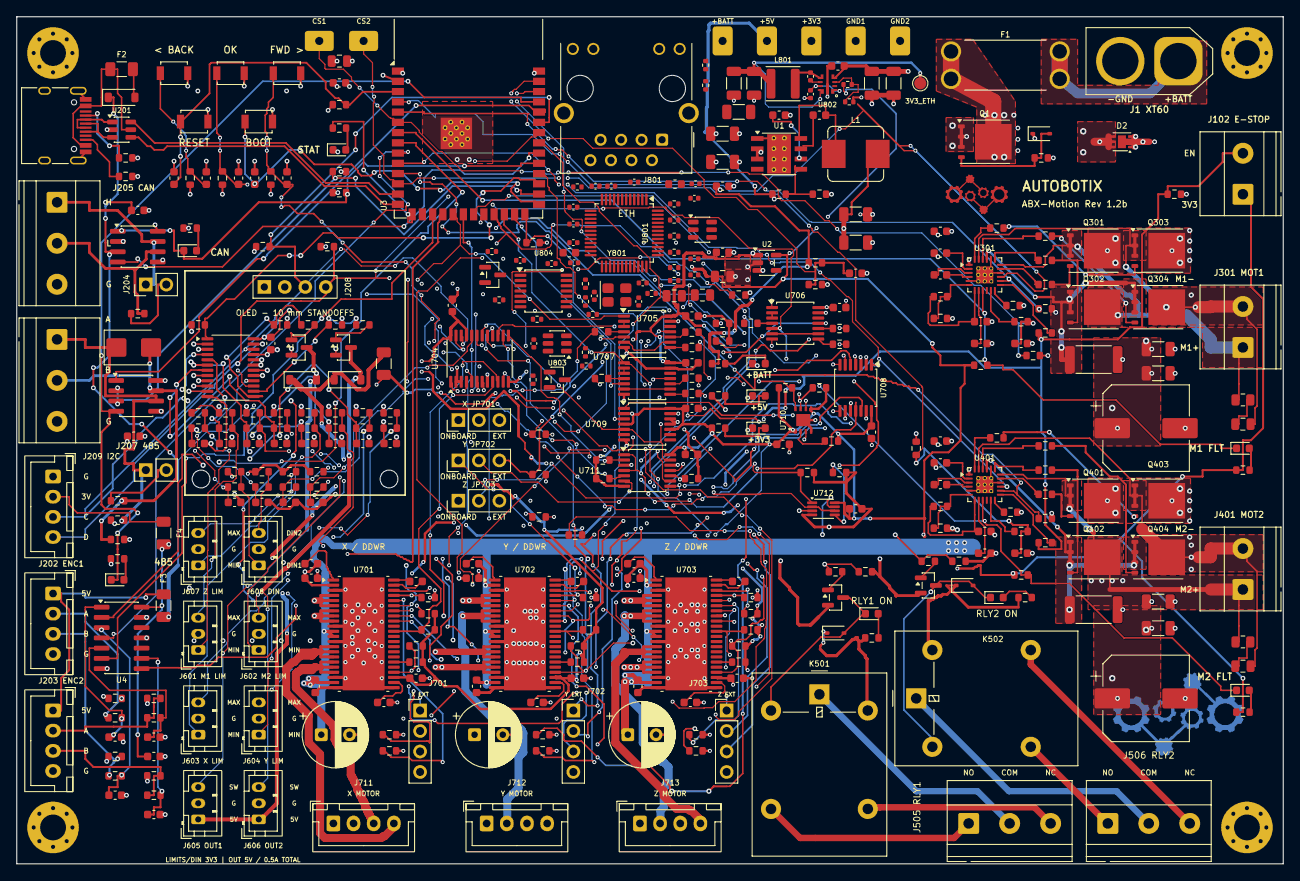
[picture p119: board abx-motion.kicad_pcb from above]

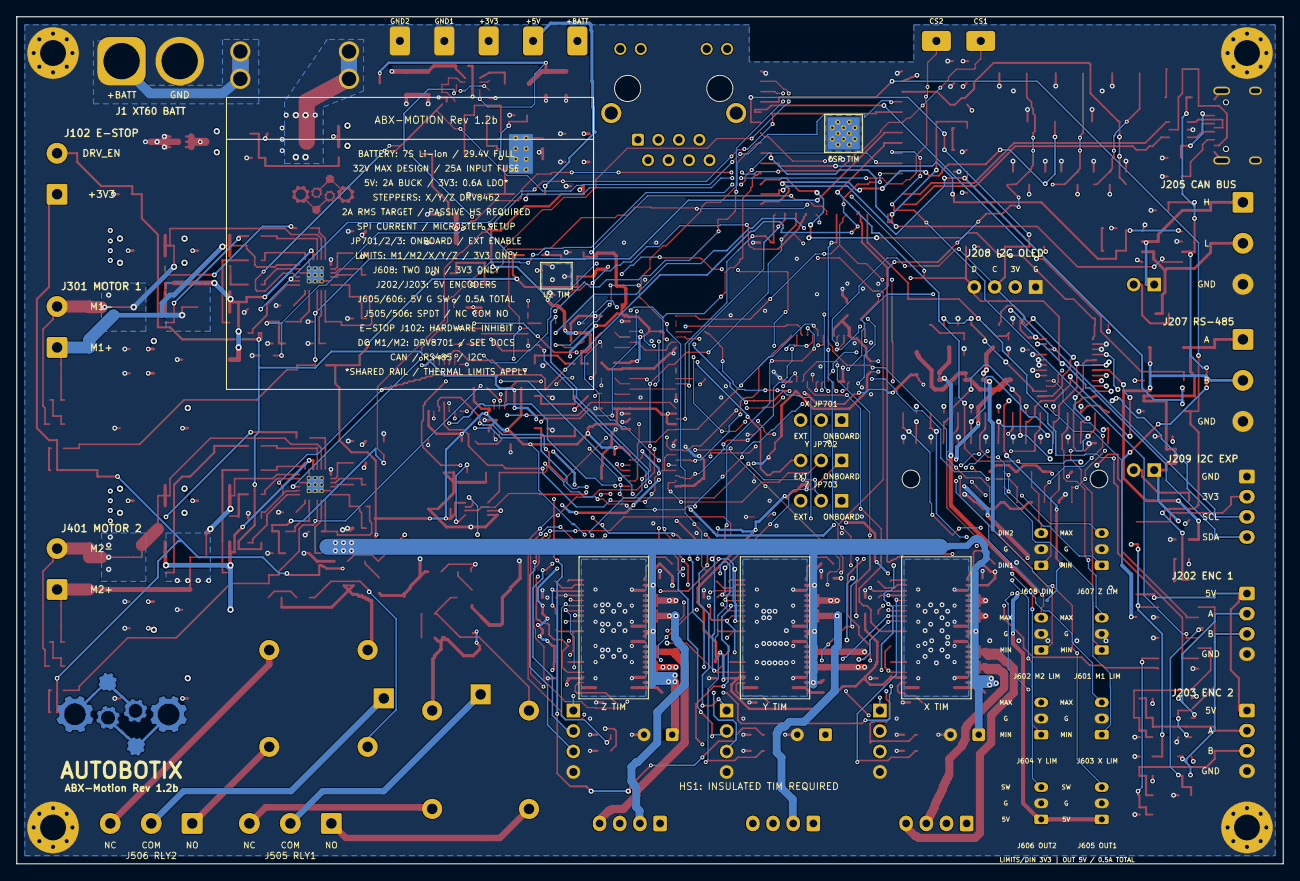
[picture p120: board abx-motion.kicad_pcb from below]

Board: 4 copper layers, 157.0 x 105.0 mm, 406 parts (2 on the bottom side), 254 nets.

Other parts of the board:
C801, C802, C803, C804, C805, C806, C807, C815, C819, C828, C829: 100nF; C_0402_1005Metric
C809: 4.7uF; C_0603_1608Metric
C810, C816: 10nF; C_0402_1005Metric
C811, C812: 10uF; C_0805_2012Metric
C813, C814: CL TBD; C_0402_1005Metric
C817, C818: 6.8nF; C_0402_1005Metric
C820: 1nF HV / SELECT; C_1206_3216Metric
D801: ETHERNET ESD / SELECT; SOT-23-6
FB801: FERRITE / RATED >=300mA; L_0603_1608Metric
J801: HR911105A / C12074; RJ45_Hanrun_HR911105A_Horizontal
Q801, Q802: BSS138; SOT-23
R801: 12.4k 1%; R_0402_1005Metric
R802, R803, R804, R805: 49.9R 1%; R_0402_1005Metric
R806, R807, R808, R809, R810, R819, R821: 10k; R_0402_1005Metric
R811, R812: 330R; R_0402_1005Metric
R813, R814, R815: 22R / SI TBD; R_0402_1005Metric
R816: 100k; R_0402_1005Metric
R820: 4.7k; R_0402_1005Metric
TIM_ESP: GND TIM 4x4 NO PASTE; TIM_GND_4x4_Bottom
U801: W5500 / C32843; LQFP-48_7x7mm_P0.5mm
U803: TPS3808G33DBVR; SOT-23-6
U804: TXU0304PWR; TSSOP-14_4.4x5mm_P0.65mm
Y801: 25MHz / CL TO SELECT; ABX_Y801_Crystal_SMD_3225-4Pin_3.2x2.5mm

Their connections:
GND: TIM_ESP.1; also elsewhere on the board
