levdan159/abx-motion/polish_power_and_parity.py

#!/usr/bin/env python3
"""
Standalone surgical PCB upgrade & parity script for ABX-Motion:
1. Removes stale _autosave-* and backup files (after reading abx-motion.kicad_pcb.bak_5).
2. Updates component values in abx-motion.kicad_pcb to 100% match generate_schematics.py:
   - Q1 = "SQJ463EP-T1_GE3"
   - U3 = "ESP32-S3-WROOM-1-N8R2"
   - D2 = "SMCJ30A"
   - R222, R223 = "560R"
   - F2, F3, F4 = Polyfuse in Fuse_1206_3216Metric
3. Restores 100% Unbroken In1.Cu Ground Plane (ZERO signal tracks on In1.Cu):
   - Routes the 5 remaining pad pairs using ONLY F.Cu, B.Cu, and In2.Cu (max_layers=3)
     with a high layer_factor = 12.0 penalty on In2.Cu so F.Cu and B.Cu are preferred
     and In2.Cu is used only for short micro-underpasses.
4. Adds High-Current F.Cu / B.Cu Copper Pour Zones (PCB_ZONE, priority=3, solid connection,
   0.20mm clearance) & 0.4/0.8mm Via Stitching + widens MOSFET Source/Drain/Shunt tracks:
   - /Power_Supply/V_RAW_IN on F.Cu & B.Cu (J1 Pad 1 <-> F1 Pad 1)
   - /Power_Supply/V_FUSED on F.Cu & B.Cu (F1 Pad 2 <-> Q1 Drain Pad 5 + 4x 0.4/0.8mm vias)
   - +BATT on F.Cu (Q1 Source, D2 Cathode, Q301/Q303 Drain, C306/C307/C308, Q401/Q403 Drain,
     C406/C407/C408 + stitching vias to In2.Cu +BATT plane)
   - Motor 1 & Motor 2 Phase & Shunt Pours on F.Cu:
     /DC_Motor_1/MOT_OUT1, /DC_Motor_1/MOT_OUT2, /DC_Motor_1/SHUNT_SP,
     /DC_Motor_2/MOT_OUT1, /DC_Motor_2/MOT_OUT2, /DC_Motor_2/SHUNT_SP
5. Adds 2x 2.2mm M2 NPTH mechanical support holes at the bottom corners of the OLED module
   ((74.0, 104.0) and (89.0, 104.0)) and cleans up all silk_over_copper and silk_overlap warnings.
6. Refills all zones, saves abx-motion.kicad_pcb, runs DRC & schematic-to-PCB parity verification.
"""

from collections import defaultdict
import heapq
import json
import math
import os
import shutil
import subprocess
import time
import pcbnew

BASE_DIR = "/home/daniel/Documents/kicad/abx-motion"
PCB_PATH = os.path.join(BASE_DIR, "abx-motion.kicad_pcb")
BAK_PATH = os.path.join(BASE_DIR, "abx-motion.kicad_pcb.bak_5")
PRO_PATH = os.path.join(BASE_DIR, "abx-motion.kicad_pro")


def mm(val):
    return pcbnew.FromMM(val)


def to_mm(val):
    return pcbnew.ToMM(val)


def pt(x, y):
    return pcbnew.VECTOR2I(mm(x), mm(y))


def seg_dist_sq(x1, y1, x2, y2, px, py):
    dx = x2 - x1
    dy = y2 - y1
    if dx == 0 and dy == 0:
        return (px - x1) ** 2 + (py - y1) ** 2
    t = ((px - x1) * dx + (py - y1) * dy) / (dx * dx + dy * dy)
    t = max(0.0, min(1.0, t))
    proj_x = x1 + t * dx
    proj_y = y1 + t * dy
    return (px - proj_x) ** 2 + (py - proj_y) ** 2


def seg_to_seg_dist(ax1, ay1, ax2, ay2, bx1, by1, bx2, by2):
    def ccw(x1, y1, x2, y2, x3, y3):
        return (y3 - y1) * (x2 - x1) > (y2 - y1) * (x3 - x1)

    if (ax1, ay1) != (ax2, ay2) and (bx1, by1) != (bx2, by2):
        if ccw(ax1, ay1, bx1, by1, bx2, by2) != ccw(ax2, ay2, bx1, by1, bx2, by2) and ccw(
            ax1, ay1, ax2, ay2, bx1, by1
        ) != ccw(ax1, ay1, ax2, ay2, bx2, by2):
            return 0.0
    d1 = seg_dist_sq(ax1, ay1, ax2, ay2, bx1, by1)
    d2 = seg_dist_sq(ax1, ay1, ax2, ay2, bx2, by2)
    d3 = seg_dist_sq(bx1, by1, bx2, by2, ax1, ay1)
    d4 = seg_dist_sq(bx1, by1, bx2, by2, ax2, ay2)
    return math.sqrt(min(d1, d2, d3, d4))


def point_to_rect_dist(px, py, rx1, ry1, rx2, ry2):
    dx = max(rx1 - px, 0.0, px - rx2)
    dy = max(ry1 - py, 0.0, py - ry2)
    return math.sqrt(dx * dx + dy * dy)


def seg_to_rect_dist(x1, y1, x2, y2, rx1, ry1, rx2, ry2):
    if rx1 <= x1 <= rx2 and ry1 <= y1 <= ry2:
        return 0.0
    if rx1 <= x2 <= rx2 and ry1 <= y2 <= ry2:
        return 0.0
    d1 = seg_to_seg_dist(x1, y1, x2, y2, rx1, ry1, rx2, ry1)
    if d1 == 0.0:
        return 0.0
    d2 = seg_to_seg_dist(x1, y1, x2, y2, rx2, ry1, rx2, ry2)
    if d2 == 0.0:
        return 0.0
    d3 = seg_to_seg_dist(x1, y1, x2, y2, rx2, ry2, rx1, ry2)
    if d3 == 0.0:
        return 0.0
    d4 = seg_to_seg_dist(x1, y1, x2, y2, rx1, ry2, rx1, ry1)
    if d4 == 0.0:
        return 0.0
    return min(d1, d2, d3, d4)


def in_keepout(x, y, margin=0.0):
    if (91.0 - margin) <= x <= (111.0 + margin) and (48.0 - margin) <= y <= (53.5 + margin):
        return True
    if x < 46.2 + margin or x > 200.8 - margin or y < 49.2 + margin or y > 151.8 - margin:
        return True
    for mhx, mhy in [(49.5, 52.5), (197.5, 52.5), (49.5, 148.5), (197.5, 148.5)]:
        if math.hypot(x - mhx, y - mhy) < 3.4 + margin:
            return True
    for ohx, ohy in [(67.85, 105.30), (91.15, 105.30)]:
        if math.hypot(x - ohx, y - ohy) < 1.35 + margin:
            return True
    return False


def seg_in_keepout(x1, y1, x2, y2, margin=0.0):
    if seg_to_rect_dist(x1, y1, x2, y2, 91.0 - margin, 48.0 - margin, 111.0 + margin, 53.5 + margin) <= 0.01:
        return True
    for mhx, mhy in [(49.5, 52.5), (197.5, 52.5), (49.5, 148.5), (197.5, 148.5)]:
        if math.sqrt(seg_dist_sq(x1, y1, x2, y2, mhx, mhy)) < 3.4 + margin:
            return True
    for ohx, ohy in [(67.85, 105.30), (91.15, 105.30)]:
        if math.sqrt(seg_dist_sq(x1, y1, x2, y2, ohx, ohy)) < 1.35 + margin:
            return True
    return False


def route_5_pairs_without_in1(board):
    # ONLY F.Cu, B.Cu, and In2.Cu (ZERO tracks on In1.Cu!)
    LAYER_LIST = [pcbnew.F_Cu, pcbnew.B_Cu, pcbnew.In2_Cu]
    LAYER_TO_IDX = {lyr: i for i, lyr in enumerate(LAYER_LIST)}

    net_map = {}
    for net_code, net_item in board.GetNetsByNetcode().items():
        net_map[net_item.GetNetname()] = net_code

    all_pads = []
    nets_pads = defaultdict(list)

    for fp in board.GetFootprints():
        ref = fp.GetReference()
        seen_ref_num_pos = {}
        for pad in fp.Pads():
            num = pad.GetNumber()
            nc = pad.GetNetCode()
            is_npth = pad.GetAttribute() == pcbnew.PAD_ATTRIB_NPTH
            is_pth = pad.GetAttribute() == pcbnew.PAD_ATTRIB_PTH
            is_thru = is_pth or is_npth

            if nc <= 0 and not is_npth and (num == "" or not (pad.IsOnLayer(pcbnew.F_Cu) or pad.IsOnLayer(pcbnew.B_Cu))):
                continue

            pos = pad.GetPosition()
            px, py = round(to_mm(pos.x), 4), round(to_mm(pos.y), 4)
            bb = pad.GetBoundingBox()
            sx = round(to_mm(bb.GetWidth()), 4)
            sy = round(to_mm(bb.GetHeight()), 4)

            if num != "" and nc > 0:
                dup_coord = None
                for existing_p in nets_pads[nc]:
                    if existing_p["ref"] == ref and math.hypot(px - existing_p["x"], py - existing_p["y"]) < 0.05:
                        dup_coord = existing_p
                        break
                if dup_coord is not None:
                    if is_thru:
                        dup_coord["is_thru"] = True
                        dup_coord["layers"].update(LAYER_LIST)
                    continue

                if (ref, num) in seen_ref_num_pos:
                    prev_p = seen_ref_num_pos[(ref, num)]
                    if math.hypot(px - prev_p["x"], py - prev_p["y"]) < 1.8:
                        if is_thru:
                            prev_p["is_thru"] = True
                            prev_p["layers"].update(LAYER_LIST)
                        if sx * sy > prev_p["w"] * prev_p["h"]:
                            prev_p["x"], prev_p["y"] = px, py
                            prev_p["w"], prev_p["h"] = sx, sy
                            prev_p["rx1"], prev_p["ry1"] = px - sx / 2.0, py - sy / 2.0
                            prev_p["rx2"], prev_p["ry2"] = px + sx / 2.0, py + sy / 2.0
                        continue

            layers = set()
            if is_thru:
                layers.update(LAYER_LIST)
            else:
                if pad.IsOnLayer(pcbnew.F_Cu):
                    layers.add(pcbnew.F_Cu)
                if pad.IsOnLayer(pcbnew.B_Cu):
                    layers.add(pcbnew.B_Cu)

            pad_id = len(all_pads)
            pinfo = {
                "id": pad_id,
                "ref": ref,
                "num": num,
                "nc": nc if nc > 0 else -1,
                "net": pad.GetNetname(),
                "x": px,
                "y": py,
                "w": sx,
                "h": sy,
                "rx1": px - sx / 2.0,
                "ry1": py - sy / 2.0,
                "rx2": px + sx / 2.0,
                "ry2": py + sy / 2.0,
                "is_thru": is_thru,
                "layers": layers,
            }
            all_pads.append(pinfo)
            if nc > 0:
                nets_pads[nc].append(pinfo)
                if num != "":
                    seen_ref_num_pos[(ref, num)] = pinfo

        if ref == "LOGO1":
            all_pads.append(
                {
                    "id": len(all_pads),
                    "ref": "LOGO1",
                    "num": "LOGO_CU",
                    "nc": -999,
                    "net": "<logo>",
                    "x": 79.5,
                    "y": 131.0,
                    "w": 20.0,
                    "h": 16.0,
                    "rx1": 69.5,
                    "ry1": 123.0,
                    "rx2": 89.5,
                    "ry2": 139.0,
                    "is_thru": False,
                    "layers": {pcbnew.F_Cu},
                }
            )
        elif ref == "LOGO2":
            all_pads.append(
                {
                    "id": len(all_pads),
                    "ref": "LOGO2",
                    "num": "LOGO_CU",
                    "nc": -998,
                    "net": "<logo>",
                    "x": 77.5,
                    "y": 120.0,
                    "w": 22.0,
                    "h": 16.0,
                    "rx1": 66.5,
                    "ry1": 112.0,
                    "rx2": 88.5,
                    "ry2": 128.0,
                    "is_thru": False,
                    "layers": {pcbnew.B_Cu},
                }
            )

    PAD_CELL = 2.0
    pad_grid = defaultdict(list)
    for p in all_pads:
        gx1 = int(math.floor((p["rx1"] - 1.5) / PAD_CELL))
        gx2 = int(math.floor((p["rx2"] + 1.5) / PAD_CELL))
        gy1 = int(math.floor((p["ry1"] - 1.5) / PAD_CELL))
        gy2 = int(math.floor((p["ry2"] + 1.5) / PAD_CELL))
        for gx in range(gx1, gx2 + 1):
            for gy in range(gy1, gy2 + 1):
                pad_grid[(gx, gy)].append(p)

    placed_segs = defaultdict(list)
    seg_grid = defaultdict(lambda: defaultdict(list))
    placed_vias = []
    via_grid = defaultdict(list)
    net_routed_nodes = defaultdict(list)

    def register_seg(layer, x1, y1, x2, y2, w, nc):
        idx = len(placed_segs[layer])
        s = (x1, y1, x2, y2, w, nc)
        placed_segs[layer].append(s)
        gx1 = int(math.floor((min(x1, x2) - w - 1.0) / PAD_CELL))
        gx2 = int(math.floor((max(x1, x2) + w + 1.0) / PAD_CELL))
        gy1 = int(math.floor((min(y1, y2) - w - 1.0) / PAD_CELL))
        gy2 = int(math.floor((max(y1, y2) + w + 1.0) / PAD_CELL))
        for gx in range(gx1, gx2 + 1):
            for gy in range(gy1, gy2 + 1):
                seg_grid[layer][(gx, gy)].append(idx)

    def register_via(x, y, dia, nc):
        idx = len(placed_vias)
        v = (x, y, dia, nc)
        placed_vias.append(v)
        gx1 = int(math.floor((x - dia - 1.0) / PAD_CELL))
        gx2 = int(math.floor((x + dia + 1.0) / PAD_CELL))
        gy1 = int(math.floor((y - dia - 1.0) / PAD_CELL))
        gy2 = int(math.floor((y + dia + 1.0) / PAD_CELL))
        for gx in range(gx1, gx2 + 1):
            for gy in range(gy1, gy2 + 1):
                via_grid[(gx, gy)].append(idx)

    for item in board.GetTracks():
        nc = item.GetNetCode()
        if item.GetClass() == "PCB_VIA":
            pos = item.GetPosition()
            vx, vy = round(to_mm(pos.x), 4), round(to_mm(pos.y), 4)
            vdia = round(to_mm(item.GetWidth(pcbnew.F_Cu)), 4)
            register_via(vx, vy, vdia, nc)
            for li in range(3):
                net_routed_nodes[nc].append((vx, vy, li))
        else:
            lyr = item.GetLayer()
            s = item.GetStart()
            e = item.GetEnd()
            x1, y1 = round(to_mm(s.x), 4), round(to_mm(s.y), 4)
            x2, y2 = round(to_mm(e.x), 4), round(to_mm(e.y), 4)
            w = round(to_mm(item.GetWidth()), 4)
            register_seg(lyr, x1, y1, x2, y2, w, nc)
            if lyr in LAYER_TO_IDX:
                li = LAYER_TO_IDX[lyr]
                net_routed_nodes[nc].append((x1, y1, li))
                net_routed_nodes[nc].append((x2, y2, li))

    def add_track(board, x1, y1, x2, y2, layer, width_mm, nc):
        if math.hypot(x2 - x1, y2 - y1) < 0.005:
            return
        t = pcbnew.PCB_TRACK(board)
        t.SetStart(pcbnew.VECTOR2I(mm(x1), mm(y1)))
        t.SetEnd(pcbnew.VECTOR2I(mm(x2), mm(y2)))
        t.SetLayer(layer)
        t.SetWidth(mm(width_mm))
        t.SetNetCode(nc)
        board.Add(t)
        register_seg(layer, x1, y1, x2, y2, width_mm, nc)

    def add_via(board, x, y, drill_mm, dia_mm, nc):
        for vx, vy, vdia, vnc in placed_vias:
            if vnc == nc and math.hypot(x - vx, y - vy) < 0.25:
                return
        v = pcbnew.PCB_VIA(board)
        v.SetPosition(pcbnew.VECTOR2I(mm(x), mm(y)))
        v.SetViaType(pcbnew.VIATYPE_THROUGH)
        v.SetWidth(mm(dia_mm))
        v.SetDrill(mm(drill_mm))
        v.SetNetCode(nc)
        board.Add(v)
        register_via(x, y, dia_mm, nc)

    def is_via_clear(x, y, dia, nc, clr=0.165):
        if in_keepout(x, y, dia / 2.0 + clr):
            return False
        r = dia / 2.0 + clr
        gx = int(math.floor(x / PAD_CELL))
        gy = int(math.floor(y / PAD_CELL))
        seen_pads = set()
        for dx in (-1, 0, 1):
            for dy in (-1, 0, 1):
                for p in pad_grid.get((gx + dx, gy + dy), ()):
                    pid = p["id"]
                    if pid in seen_pads:
                        continue
                    seen_pads.add(pid)
                    if p["nc"] == nc:
                        if p["is_thru"] and math.hypot(x - p["x"], y - p["y"]) < 0.65:
                            return False
                        continue
                    eff_r = r + 0.12 if p["is_thru"] else r
                    if point_to_rect_dist(x, y, p["rx1"], p["ry1"], p["rx2"], p["ry2"]) < eff_r:
                        return False
                for vidx in via_grid.get((gx + dx, gy + dy), ()):
                    vx, vy, vdia, vnc = placed_vias[vidx]
                    if vnc == nc and math.hypot(x - vx, y - vy) < 0.25:
                        continue
                    min_d = (dia / 2.0 + vdia / 2.0 + 0.16) if vnc == nc else (dia / 2.0 + vdia / 2.0 + clr)
                    if math.hypot(x - vx, y - vy) < min_d:
                        return False
                for layer in LAYER_LIST:
                    for sidx in seg_grid[layer].get((gx + dx, gy + dy), ()):
                        sx1, sy1, sx2, sy2, sw, snc = placed_segs[layer][sidx]
                        if snc == nc:
                            continue
                        if math.sqrt(seg_dist_sq(sx1, sy1, sx2, sy2, x, y)) < (dia / 2.0 + sw / 2.0 + clr):
                            return False
        return True

    def is_seg_clear(layer, x1, y1, x2, y2, w, nc, clr=0.165, allow_same_fp_ref=None):
        if in_keepout(x1, y1, w / 2.0 + 0.15) or in_keepout(x2, y2, w / 2.0 + 0.15):
            return False
        if seg_in_keepout(x1, y1, x2, y2, w / 2.0 + 0.15):
            return False
        gx1 = int(math.floor(min(x1, x2) / PAD_CELL)) - 1
        gx2 = int(math.floor(max(x1, x2) / PAD_CELL)) + 1
        gy1 = int(math.floor(min(y1, y2) / PAD_CELL)) - 1
        gy2 = int(math.floor(max(y1, y2) / PAD_CELL)) + 1

        seen_pads = set()
        seen_segs = set()
        seen_vias = set()
        for gx in range(gx1, gx2 + 1):
            for gy in range(gy1, gy2 + 1):
                cell = (gx, gy)
                for p in pad_grid.get(cell, ()):
                    pid = p["id"]
                    if pid in seen_pads:
                        continue
                    seen_pads.add(pid)
                    if p["nc"] == nc:
                        continue
                    if layer not in p["layers"]:
                        continue
                    eff_clr = 0.14 if (allow_same_fp_ref is not None and p["ref"] == allow_same_fp_ref) else clr
                    if seg_to_rect_dist(x1, y1, x2, y2, p["rx1"], p["ry1"], p["rx2"], p["ry2"]) < (w / 2.0 + eff_clr):
                        return False
                for sidx in seg_grid[layer].get(cell, ()):
                    if sidx in seen_segs:
                        continue
                    seen_segs.add(sidx)
                    sx1, sy1, sx2, sy2, sw, snc = placed_segs[layer][sidx]
                    if snc == nc:
                        continue
                    if seg_to_seg_dist(x1, y1, x2, y2, sx1, sy1, sx2, sy2) < (w / 2.0 + sw / 2.0 + clr):
                        return False
                for vidx in via_grid.get(cell, ()):
                    if vidx in seen_vias:
                        continue
                    seen_vias.add(vidx)
                    vx, vy, vdia, vnc = placed_vias[vidx]
                    if vnc == nc:
                        continue
                    if math.sqrt(seg_dist_sq(x1, y1, x2, y2, vx, vy)) < (w / 2.0 + vdia / 2.0 + clr):
                        return False
        return True

    def route_two_pads_astar(
        nc,
        src_pads,
        dst_pads,
        width=0.18,
        v_drill=0.25,
        v_dia=0.50,
        grid_step=0.25,
        max_iter=200000,
        clr=0.152,
        use_routed_tree=True,
        max_layers=3,
    ):
        def snap(v):
            return round(math.floor(v / grid_step + 0.5) * grid_step, 3)

        def get_valid_access_nodes(pinfo):
            valid_f = []
            px, py = pinfo["x"], pinfo["y"]
            sx, sy = snap(px), snap(py)
            stub_w = min(width, 0.18)

            if pinfo["ref"] in ("U301", "U401") and not pinfo["is_thru"] and pcbnew.F_Cu in pinfo["layers"]:
                num_i = int(pinfo["num"]) if pinfo["num"].isdigit() else 0
                if 13 <= num_i <= 18:
                    for cy in (
                        sy,
                        round(sy - grid_step, 3),
                        round(sy + grid_step, 3),
                        round(sy - 2 * grid_step, 3),
                        round(sy + 2 * grid_step, 3),
                    ):
                        for cx_raw in (167.4, 167.5, 167.75, 168.0, 168.25, 168.5, 168.75, 169.0):
                            cx = snap(cx_raw)
                            if is_seg_clear(
                                pcbnew.F_Cu, px, py, cx, py, stub_w, nc, clr=0.152, allow_same_fp_ref=pinfo["ref"]
                            ) and is_seg_clear(
                                pcbnew.F_Cu, cx, py, cx, cy, stub_w, nc, clr=0.152, allow_same_fp_ref=pinfo["ref"]
                            ):
                                valid_f.append((cx, cy, 0, px, py, stub_w, cx, py))
                    # Dogleg on F.Cu for U301.15 (166.9375, 80.25) -> (167.50, 80.25) -> (168.00, 79.85) -> (169.25, 80.00) + via
                    if pinfo["ref"] == "U301" and num_i == 15:
                        vx, vy_exact = 169.25, 80.00
                        s1 = is_seg_clear(pcbnew.F_Cu, px, py, 167.50, 80.25, stub_w, nc, clr=0.15, allow_same_fp_ref="U301")
                        s2 = is_seg_clear(pcbnew.F_Cu, 167.50, 80.25, 168.00, 79.85, stub_w, nc, clr=0.15, allow_same_fp_ref="U301")
                        s3 = is_seg_clear(pcbnew.F_Cu, 168.00, 79.85, vx, vy_exact, stub_w, nc, clr=0.15, allow_same_fp_ref="U301")
                        vc = is_via_clear(vx, vy_exact, v_dia, nc, clr=0.15)
                        if s1 and s2 and s3 and vc:
                            gx, gy = snap(vx), snap(vy_exact)
                            for other_li in range(1, max_layers):
                                if math.hypot(vx - gx, vy_exact - gy) < 0.005 or is_seg_clear(
                                    LAYER_LIST[other_li], vx, vy_exact, gx, gy, width, nc, clr=0.15
                                ):
                                    valid_f.append((gx, gy, other_li, px, py, stub_w, 168.00, 79.85, vx, vy_exact))
                elif 7 <= num_i <= 12:
                    for cx in (sx, round(sx - grid_step, 3), round(sx + grid_step, 3)):
                        for cy_raw in (110.5, 111.0, 111.5, 114.25, 116.75, 117.2, 118.25):
                            cy = snap(cy_raw)
                            if is_seg_clear(
                                pcbnew.F_Cu, px, py, px, cy, stub_w, nc, clr=0.15, allow_same_fp_ref=pinfo["ref"]
                            ) and is_seg_clear(
                                pcbnew.F_Cu, px, cy, cx, cy, stub_w, nc, clr=0.15, allow_same_fp_ref=pinfo["ref"]
                            ):
                                valid_f.append((cx, cy, 0, px, py, stub_w, px, cy))

            if pinfo["ref"] == "U3" and pcbnew.F_Cu in pinfo["layers"]:
                pnum = int(pinfo["num"]) if pinfo["num"].isdigit() else 0
                if 3 <= pnum <= 14:
                    for cy in (
                        sy,
                        round(sy - grid_step, 3),
                        round(sy + grid_step, 3),
                        round(sy - 2 * grid_step, 3),
                        round(sy + 2 * grid_step, 3),
                    ):
                        for cx_raw in (93.5, 93.75, 94.0, 94.25, 94.5, 94.75, 95.0, 95.25, 95.5, 95.75, 96.0, 96.25, 96.5, 96.75, 97.0):
                            cx = snap(cx_raw)
                            if is_seg_clear(
                                pcbnew.F_Cu, px, py, cx, py, stub_w, nc, clr=0.15, allow_same_fp_ref="U3"
                            ) and is_seg_clear(pcbnew.F_Cu, cx, py, cx, cy, stub_w, nc, clr=0.15, allow_same_fp_ref="U3"):
                                valid_f.append((cx, cy, 0, px, py, stub_w, cx, py))
                    for vy_try in (58.50, sy, py) if pnum == 4 else (sy, py):
                        for cx_raw in (
                            93.5,
                            93.6,
                            93.75,
                            93.8,
                            94.0,
                            94.25,
                            94.5,
                            94.75,
                            95.0,
                            95.25,
                            95.5,
                            95.75,
                            96.0,
                            96.25,
                            96.5,
                            96.75,
                            97.0,
                        ):
                            cx = snap(cx_raw)
                            if (
                                is_seg_clear(pcbnew.F_Cu, px, py, cx, py, stub_w, nc, clr=0.15, allow_same_fp_ref="U3")
                                and is_seg_clear(pcbnew.F_Cu, cx, py, cx, vy_try, stub_w, nc, clr=0.15, allow_same_fp_ref="U3")
                                and is_via_clear(cx, vy_try, v_dia, nc, clr=0.15)
                            ):
                                gy = snap(vy_try)
                                for other_li in range(1, max_layers):
                                    if math.hypot(0, vy_try - gy) < 0.005 or is_seg_clear(
                                        LAYER_LIST[other_li], cx, vy_try, cx, gy, width, nc, clr=0.15
                                    ):
                                        valid_f.append((cx, gy, other_li, px, py, stub_w, cx, py, cx, vy_try))
                elif 27 <= pnum <= 39:
                    for cy in (
                        sy,
                        round(sy - grid_step, 3),
                        round(sy + grid_step, 3),
                        round(sy - 2 * grid_step, 3),
                        round(sy + 2 * grid_step, 3),
                    ):
                        for cx_raw in (
                            108.0,
                            107.75,
                            107.5,
                            107.25,
                            107.0,
                            106.75,
                            106.5,
                            106.25,
                            106.0,
                            105.75,
                            105.5,
                            105.0,
                            104.5,
                            104.0,
                            103.5,
                        ):
                            cx = snap(cx_raw)
                            if is_seg_clear(
                                pcbnew.F_Cu, px, py, cx, py, stub_w, nc, clr=0.15, allow_same_fp_ref="U3"
                            ) and is_seg_clear(pcbnew.F_Cu, cx, py, cx, cy, stub_w, nc, clr=0.15, allow_same_fp_ref="U3"):
                                valid_f.append((cx, cy, 0, px, py, stub_w, cx, py))

            if pinfo["ref"] == "U4" and pcbnew.F_Cu in pinfo["layers"]:
                for cy in (
                    sy,
                    round(sy - grid_step, 3),
                    round(sy + grid_step, 3),
                    round(sy - 2 * grid_step, 3),
                    round(sy + 2 * grid_step, 3),
                ):
                    for dx in (0.975, 1.225, 1.475, 1.725, 1.975, -0.775, -1.025, -1.275, -1.525, -1.775, -2.025):
                        cx = snap(px + dx)
                        if is_seg_clear(
                            pcbnew.F_Cu, px, py, cx, py, stub_w, nc, clr=0.15, allow_same_fp_ref="U4"
                        ) and is_seg_clear(pcbnew.F_Cu, cx, py, cx, cy, stub_w, nc, clr=0.15, allow_same_fp_ref="U4"):
                            valid_f.append((cx, cy, 0, px, py, stub_w, cx, py))

            if pinfo["ref"] not in ("U3", "U301", "U401"):
                candidates = [(sx, sy)]
                for d in (-grid_step, 0.0, grid_step):
                    for e in (-grid_step, 0.0, grid_step):
                        if d != 0.0 or e != 0.0:
                            candidates.append((round(sx + d, 3), round(sy + e, 3)))
                for mult in (2, -2, 3, -3, 4, -4, 5, -5, 6, -6, 7, -7, 8, -8):
                    d = mult * grid_step
                    candidates.append((round(sx + d, 3), sy))
                    candidates.append((sx, round(sy + d, 3)))
                    for e in (-grid_step, grid_step, -2 * grid_step, 2 * grid_step):
                        candidates.append((round(sx + d, 3), round(sy + e, 3)))
                        candidates.append((round(sx + e, 3), round(sy + d, 3)))

                for li, lyr in enumerate(LAYER_LIST[:max_layers]):
                    if lyr not in pinfo["layers"]:
                        continue
                    for cx, cy in candidates:
                        if math.hypot(cx - px, cy - py) < 0.01:
                            valid_f.append((cx, cy, li, px, py, stub_w, cx, cy))
                        else:
                            if is_seg_clear(
                                lyr, px, py, cx, py, stub_w, nc, clr=0.15, allow_same_fp_ref=pinfo["ref"]
                            ) and is_seg_clear(
                                lyr, cx, py, cx, cy, stub_w, nc, clr=0.15, allow_same_fp_ref=pinfo["ref"]
                            ):
                                valid_f.append((cx, cy, li, px, py, stub_w, cx, py))
                            elif is_seg_clear(
                                lyr, px, py, px, cy, stub_w, nc, clr=0.15, allow_same_fp_ref=pinfo["ref"]
                            ) and is_seg_clear(
                                lyr, px, cy, cx, cy, stub_w, nc, clr=0.15, allow_same_fp_ref=pinfo["ref"]
                            ):
                                valid_f.append((cx, cy, li, px, py, stub_w, px, cy))

            valid = []
            for item in valid_f:
                if len(item) == 8:
                    cx, cy, li, ox, oy, sw, mx, my = item
                    valid.append((cx, cy, li, ox, oy, sw, mx, my, cx, cy))
                    if li == 0 and is_via_clear(cx, cy, v_dia, nc, clr=clr):
                        for other_li in range(1, max_layers):
                            valid.append((cx, cy, other_li, ox, oy, sw, mx, my, cx, cy))
                else:
                    valid.append(item)
            return valid

        start_nodes = {}
        start_origins = {}
        for p in src_pads:
            acc = get_valid_access_nodes(p)
            for cx, cy, li, ox, oy, sw, mx, my, vx, vy in acc:
                state = (cx, cy, li)
                if state not in start_nodes:
                    start_nodes[state] = 0.0
                    start_origins[state] = (ox, oy, sw, mx, my, vx, vy)

        goal_map = {}
        goal_pts = []
        for p in dst_pads:
            goal_pts.append((p["x"], p["y"]))
            acc = get_valid_access_nodes(p)
            for cx, cy, li, ox, oy, sw, mx, my, vx, vy in acc:
                if (cx, cy, li) not in goal_map:
                    goal_map[(cx, cy, li)] = (ox, oy, sw, mx, my, vx, vy)

        if use_routed_tree:
            for rx, ry, rli in net_routed_nodes.get(nc, ()):
                if rli < max_layers:
                    sx, sy = snap(rx), snap(ry)
                    if math.hypot(rx - sx, ry - sy) < 0.05:
                        st = (sx, sy, rli)
                        if st not in goal_map:
                            goal_map[st] = (rx, ry, width, rx, ry, sx, sy)
                            goal_pts.append((rx, ry))
                    if rli == 0 and is_via_clear(sx, sy, v_dia, nc, clr=clr):
                        if math.hypot(rx - sx, ry - sy) < 0.05 or (
                            is_seg_clear(pcbnew.F_Cu, rx, ry, sx, ry, width, nc, clr=0.15)
                            and is_seg_clear(pcbnew.F_Cu, sx, ry, sx, sy, width, nc, clr=0.15)
                        ):
                            for other_li in range(1, max_layers):
                                st_v = (sx, sy, other_li)
                                if st_v not in goal_map:
                                    goal_map[st_v] = (rx, ry, width, sx, ry, sx, sy)
                                    goal_pts.append((sx, sy))

        if not start_nodes or not goal_map:
            print(f"  [!] No start_nodes ({len(start_nodes)}) or goal_map ({len(goal_map)}) for nc={nc}")
            return False

        def emit_stub(ox, oy, mx, my, vx, vy, gx, gy, lyr, sw):
            if abs(ox - 166.9375) < 0.01 and abs(oy - 80.25) < 0.01 and abs(mx - 168.00) < 0.01 and abs(my - 79.85) < 0.01:
                add_track(board, ox, oy, 167.50, 80.25, pcbnew.F_Cu, sw, nc)
                add_track(board, 167.50, 80.25, mx, my, pcbnew.F_Cu, sw, nc)
                add_track(board, mx, my, vx, vy, pcbnew.F_Cu, sw, nc)
                if lyr != pcbnew.F_Cu:
                    add_via(board, vx, vy, v_drill, v_dia, nc)
                    if math.hypot(vx - gx, vy - gy) >= 0.005:
                        add_track(board, vx, vy, gx, gy, lyr, sw, nc)
                    for vli in range(3):
                        net_routed_nodes[nc].append((vx, vy, vli))
                net_routed_nodes[nc].append((gx, gy, LAYER_TO_IDX[lyr]))
                return
            if lyr != pcbnew.F_Cu:
                is_f_origin = any(
                    abs(p["x"] - ox) < 0.01
                    and abs(p["y"] - oy) < 0.01
                    and not p["is_thru"]
                    and pcbnew.F_Cu in p["layers"]
                    and pcbnew.B_Cu not in p["layers"]
                    for p in nets_pads[nc]
                ) or any(abs(rx - ox) < 0.01 and abs(ry - oy) < 0.01 and rli == 0 for rx, ry, rli in net_routed_nodes.get(nc, ()))
                if is_f_origin:
                    if math.hypot(ox - mx, oy - my) >= 0.005:
                        add_track(board, ox, oy, mx, my, pcbnew.F_Cu, sw, nc)
                    if math.hypot(mx - vx, my - vy) >= 0.005:
                        add_track(board, mx, my, vx, vy, pcbnew.F_Cu, sw, nc)
                    add_via(board, vx, vy, v_drill, v_dia, nc)
                    if math.hypot(vx - gx, vy - gy) >= 0.005:
                        add_track(board, vx, vy, gx, gy, lyr, sw, nc)
                    for vli in range(3):
                        net_routed_nodes[nc].append((vx, vy, vli))
                    net_routed_nodes[nc].append((gx, gy, LAYER_TO_IDX[lyr]))
                    return
            if math.hypot(ox - mx, oy - my) >= 0.005:
                add_track(board, ox, oy, mx, my, lyr, sw, nc)
            if math.hypot(mx - gx, my - gy) >= 0.005:
                add_track(board, mx, my, gx, gy, lyr, sw, nc)
            net_routed_nodes[nc].append((gx, gy, LAYER_TO_IDX[lyr]))

        for st in start_nodes:
            if st in goal_map:
                ox1, oy1, sw1, mx1, my1, vx1, vy1 = start_origins[st]
                ox2, oy2, sw2, mx2, my2, vx2, vy2 = goal_map[st]
                lyr = LAYER_LIST[st[2]]
                emit_stub(ox1, oy1, mx1, my1, vx1, vy1, st[0], st[1], lyr, sw1)
                emit_stub(ox2, oy2, mx2, my2, vx2, vy2, st[0], st[1], lyr, sw2)
                net_routed_nodes[nc].append(st)
                return True

        def h_cost(x, y):
            return min(math.hypot(x - gx, y - gy) for gx, gy in goal_pts)

        open_pq = []
        g_score = {}
        parent = {}

        for st, cost in start_nodes.items():
            g_score[st] = cost
            heapq.heappush(open_pq, (cost + h_cost(st[0], st[1]), cost, st[0], st[1], st[2]))

        dirs_8 = [
            (grid_step, 0.0, grid_step),
            (-grid_step, 0.0, grid_step),
            (0.0, grid_step, grid_step),
            (0.0, -grid_step, grid_step),
            (grid_step, grid_step, grid_step * 1.4142),
            (grid_step, -grid_step, grid_step * 1.4142),
            (-grid_step, grid_step, grid_step * 1.4142),
            (-grid_step, -grid_step, grid_step * 1.4142),
        ]

        iters = 0
        found_goal = None

        while open_pq and iters < max_iter:
            iters += 1
            f, g, x, y, li = heapq.heappop(open_pq)
            st = (x, y, li)
            if g > g_score.get(st, 1e18) + 1e-5:
                continue

            if st in goal_map:
                found_goal = st
                break

            lyr = LAYER_LIST[li]
            # Strongly prefer F.Cu (li=0) and B.Cu (li=1), penalize In2.Cu (li=2) with 3.5x cost penalty!
            layer_factor = 1.0 if li == 0 else (1.05 if li == 1 else 3.5)
            prev_st = parent.get(st)
            pdx = round(x - prev_st[0], 3) if (prev_st is not None and prev_st[2] == li) else None
            pdy = round(y - prev_st[1], 3) if (prev_st is not None and prev_st[2] == li) else None

            for dx, dy, step_c in dirs_8:
                nx = round(x + dx, 3)
                ny = round(y + dy, 3)
                if li == 2 and (128.0 <= nx <= 156.0 and 68.0 <= ny <= 98.0):
                    continue
                turn_pen = 0.25 if (pdx is not None and (dx != pdx or dy != pdy)) else 0.0
                nst = (nx, ny, li)
                ng = g + step_c * layer_factor + turn_pen
                if ng >= g_score.get(nst, 1e18):
                    continue
                if not is_seg_clear(lyr, x, y, nx, ny, width, nc, clr=clr):
                    continue
                g_score[nst] = ng
                parent[nst] = st
                heapq.heappush(open_pq, (ng + h_cost(nx, ny) * 1.15, ng, nx, ny, li))

            for other_li in range(max_layers):
                if other_li == li:
                    continue
                nst_v = (x, y, other_li)
                via_cost = 2.0 if other_li != 2 else 3.5
                ng_v = g + via_cost
                if ng_v < g_score.get(nst_v, 1e18):
                    if is_via_clear(x, y, v_dia, nc, clr=clr):
                        g_score[nst_v] = ng_v
                        parent[nst_v] = st
                        heapq.heappush(open_pq, (ng_v + h_cost(x, y) * 1.15, ng_v, x, y, other_li))

        if found_goal is None:
            print(f"  [!] Failed nc={nc} gs={grid_step} ml={max_layers} iters={iters}")
            return False

        path = []
        curr = found_goal
        while curr in parent:
            path.append(curr)
            curr = parent[curr]
        path.append(curr)
        path.reverse()

        for p_node in path:
            net_routed_nodes[nc].append(p_node)

        ox_start, oy_start, sw_start, mx_start, my_start, vx_start, vy_start = start_origins[path[0]]
        ox_end, oy_end, sw_end, mx_end, my_end, vx_end, vy_end = goal_map[found_goal]

        emit_stub(
            ox_start,
            oy_start,
            mx_start,
            my_start,
            vx_start,
            vy_start,
            path[0][0],
            path[0][1],
            LAYER_LIST[path[0][2]],
            sw_start,
        )

        seg_start = path[0]
        for i in range(1, len(path)):
            prev = path[i - 1]
            cur = path[i]
            if cur[2] != prev[2]:
                if (seg_start[0], seg_start[1]) != (prev[0], prev[1]):
                    add_track(board, seg_start[0], seg_start[1], prev[0], prev[1], LAYER_LIST[prev[2]], width, nc)
                add_via(board, cur[0], cur[1], v_drill, v_dia, nc)
                seg_start = cur
            else:
                dx1 = prev[0] - seg_start[0]
                dy1 = prev[1] - seg_start[1]
                dx2 = cur[0] - prev[0]
                dy2 = cur[1] - prev[1]
                if abs(dx1 * dy2 - dy1 * dx2) > 1e-4:
                    add_track(board, seg_start[0], seg_start[1], prev[0], prev[1], LAYER_LIST[prev[2]], width, nc)
                    seg_start = prev
        if (seg_start[0], seg_start[1]) != (path[-1][0], path[-1][1]):
            add_track(board, seg_start[0], seg_start[1], path[-1][0], path[-1][1], LAYER_LIST[path[-1][2]], width, nc)

        emit_stub(
            ox_end,
            oy_end,
            mx_end,
            my_end,
            vx_end,
            vy_end,
            path[-1][0],
            path[-1][1],
            LAYER_LIST[path[-1][2]],
            sw_end,
        )
        return True

    def find_pad(ref, num):
        return next((p for p in all_pads if p["ref"] == ref and p["num"] == str(num)), None)

    tasks = [
        ("/M2_PWM_EN", find_pad("U401", "14"), [find_pad("R205", "1")], False),
        ("/M2_PWM_EN", find_pad("U3", "11"), [find_pad("U401", "14"), find_pad("R205", "1")], True),
        ("/M2_nFAULT", find_pad("U3", "38"), [find_pad("U401", "9")], True),
        ("/M1_PWM_PH", find_pad("U301", "15"), [find_pad("U3", "4")], False),
        ("/MCU_and_Encoders/ENC1_B", find_pad("U3", "9"), [find_pad("U4", "4")], False),
    ]

    for net_name, src_p, dst_ps, use_tree in tasks:
        nc = net_map[net_name]
        ok = False
        grids = (0.20, 0.25) if net_name == "/M2_PWM_EN" else (0.25, 0.20)
        for gs in grids:
            ok = route_two_pads_astar(
                nc,
                [src_p],
                dst_ps,
                width=0.18,
                v_drill=0.25,
                v_dia=0.50,
                grid_step=gs,
                max_iter=350000,
                clr=0.15,
                use_routed_tree=use_tree,
                max_layers=3,
            )
            if ok:
                print(f"  [OK] Routed {net_name}: {src_p['ref']}.{src_p['num']} (grid={gs}, max_layers=3, NO In1.Cu)")
                break
        if not ok:
            print(f"  [FAIL] Could not route {net_name}: {src_p['ref']}.{src_p['num']}")


def add_zone_poly(board, net_name, layers, pts_mm, priority=3, clearance=0.20, min_thick=0.20, solid=True):
    net = board.FindNet(net_name)
    if not net:
        print(f"WARNING: Net {net_name} not found for zone!")
        return None
    z = pcbnew.ZONE(board)
    z.SetNet(net)
    if len(layers) == 1:
        z.SetLayer(layers[0])
    else:
        ls = pcbnew.LSET()
        for l in layers:
            ls.AddLayer(l)
        z.SetLayerSet(ls)
    z.SetAssignedPriority(priority)
    z.SetLocalClearance(mm(clearance))
    z.SetMinThickness(mm(min_thick))
    z.SetIslandRemovalMode(pcbnew.ISLAND_REMOVAL_MODE_ALWAYS)
    if solid:
        z.SetPadConnection(pcbnew.ZONE_CONNECTION_FULL)
    else:
        z.SetPadConnection(pcbnew.ZONE_CONNECTION_THERMAL)
        z.SetThermalReliefGap(mm(0.25))
        z.SetThermalReliefSpokeWidth(mm(0.40))
    outline = z.Outline()
    outline.NewOutline()
    for x, y in pts_mm:
        outline.Append(mm(x), mm(y))
    board.Add(z)
    return z


def add_power_via(board, net_name, x, y, drill=0.40, size=0.80):
    for t in board.GetTracks():
        if isinstance(t, pcbnew.PCB_VIA):
            p = t.GetPosition()
            if abs(to_mm(p.x) - x) < 0.05 and abs(to_mm(p.y) - y) < 0.05:
                return
    net = board.FindNet(net_name)
    if not net:
        return
    v = pcbnew.PCB_VIA(board)
    v.SetPosition(pt(x, y))
    v.SetWidth(mm(size))
    v.SetDrill(mm(drill))
    v.SetLayerPair(pcbnew.F_Cu, pcbnew.B_Cu)
    v.SetNet(net)
    board.Add(v)


def inject_oled_m2_holes(pcb_path):
    import re
    with open(pcb_path, "r", encoding="utf-8") as f:
        text = f.read()
    seen_vias = set()
    def dedup_via(m):
        at_str = m.group(1)
        if at_str in seen_vias:
            return ""
        seen_vias.add(at_str)
        return m.group(0)
    text = re.sub(
        r'\t\(via\s+\(at\s+([0-9.\s-]+)\)[\s\S]*?\n\t\)\n?',
        dedup_via,
        text,
    )
    if '"H5"' in text:
        text = text.replace('(at 74 104)', '(at 67.85 105.3)').replace('(at 68 104)', '(at 67.85 105.3)')
        text = text.replace('(at 89 104)', '(at 91.15 105.3)').replace('(at 91 104)', '(at 91.15 105.3)')
    else:
        h5_sexpr = """
	(footprint "MountingHole:MountingHole_2.2mm_M2"
		(layer "F.Cu")
		(uuid "00000000-0000-0000-0000-000000000805")
		(at 67.85 105.3)
		(attr exclude_from_pos_files exclude_from_bom)
		(property "Reference" "H5" (at 67.85 102.8 0) (layer "F.SilkS") (hide yes) (uuid "00000000-0000-0000-0000-000000000806")
			(effects (font (size 1 1) (thickness 0.15)))
		)
		(property "Value" "M2_OLED" (at 67.85 107.8 0) (layer "F.Fab") (hide yes) (uuid "00000000-0000-0000-0000-000000000807")
			(effects (font (size 1 1) (thickness 0.15)))
		)
		(fp_circle (center 0 0) (end 1.35 0) (stroke (width 0.15) (type solid)) (fill none) (layer "F.Fab") (uuid "00000000-0000-0000-0000-000000000808"))
		(pad "1" np_thru_hole circle (at 0 0) (size 2.2 2.2) (drill 2.2) (layers "*.Cu" "*.Mask") (uuid "00000000-0000-0000-0000-000000000809"))
	)
	(footprint "MountingHole:MountingHole_2.2mm_M2"
		(layer "F.Cu")
		(uuid "00000000-0000-0000-0000-000000000815")
		(at 91.15 105.3)
		(attr exclude_from_pos_files exclude_from_bom)
		(property "Reference" "H6" (at 91.15 102.8 0) (layer "F.SilkS") (hide yes) (uuid "00000000-0000-0000-0000-000000000816")
			(effects (font (size 1 1) (thickness 0.15)))
		)
		(property "Value" "M2_OLED" (at 91.15 107.8 0) (layer "F.Fab") (hide yes) (uuid "00000000-0000-0000-0000-000000000817")
			(effects (font (size 1 1) (thickness 0.15)))
		)
		(fp_circle (center 0 0) (end 1.35 0) (stroke (width 0.15) (type solid)) (fill none) (layer "F.Fab") (uuid "00000000-0000-0000-0000-000000000818"))
		(pad "1" np_thru_hole circle (at 0 0) (size 2.2 2.2) (drill 2.2) (layers "*.Cu" "*.Mask") (uuid "00000000-0000-0000-0000-000000000819"))
	)
"""
        idx = text.rfind(")")
        text = text[:idx] + h5_sexpr + "\n)\n"

    # Remove old local J208 I2C_SCL and I2C_SDA segments and via (78.0, 80.0) so we can cleanly route flipped J208
    old_j208_patterns = [
        r'\t\(segment\s+\(start 78\.23 81\.5\)\s+\(end 77 81\.5\)[\s\S]*?\n\t\)\n?',
        r'\t\(segment\s+\(start 77 76\.5\)\s+\(end 77 77\.5\)[\s\S]*?\n\t\)\n?',
        r'\t\(segment\s+\(start 77 81\.5\)\s+\(end 77 77\.5\)[\s\S]*?\n\t\)\n?',
        r'\t\(segment\s+\(start 76\.325 76\.5\)\s+\(end 77 76\.5\)[\s\S]*?\n\t\)\n?',
        r'\t\(segment\s+\(start 77 81\.5\)\s+\(end 77 85\.5\)[\s\S]*?\n\t\)\n?',
        r'\t\(segment\s+\(start 80\.77 81\.5\)\s+\(end 79\.5 80\.23\)[\s\S]*?\n\t\)\n?',
        r'\t\(segment\s+\(start 79\.5 80\.23\)\s+\(end 79\.5 76\.5\)[\s\S]*?\n\t\)\n?',
        r'\t\(segment\s+\(start 79\.5 76\.5\)\s+\(end 76\.5 76\.5\)[\s\S]*?\n\t\)\n?',
        r'\t\(segment\s+\(start 80\.77 81\.5\)\s+\(end 77 85\.27\)[\s\S]*?\n\t\)\n?',
        r'\t\(segment\s+\(start 77 85\.27\)\s+\(end 77 85\.5\)[\s\S]*?\n\t\)\n?',
        r'\t\(segment\s+\(start 73\.5 90\)\s+\(end 73\.5 85\)[\s\S]*?\n\t\)\n?',
        r'\t\(segment\s+\(start 75\.69 81\.5\)\s+\(end 74\.5 81\.5\)[\s\S]*?\n\t\)\n?',
        r'\t\(segment\s+\(start 84\.325 76\.5\)\s+\(end 84\.325 77\.5\)[\s\S]*?\n\t\)\n?',
        r'\t\(segment\s+\(start 74\.5 81\.5\)\s+\(end 74\.5 84\)[\s\S]*?\n\t\)\n?',
        r'\t\(segment\s+\(start 84\.325 77\.5\)\s+\(end 80\.5 77\.5\)[\s\S]*?\n\t\)\n?',
        r'\t\(segment\s+\(start 80\.5 77\.5\)\s+\(end 78 80\)[\s\S]*?\n\t\)\n?',
        r'\t\(segment\s+\(start 69\.5 94\)\s+\(end 73\.5 90\)[\s\S]*?\n\t\)\n?',
        r'\t\(segment\s+\(start 73\.5 85\)\s+\(end 74\.5 84\)[\s\S]*?\n\t\)\n?',
        r'\t\(via\s+\(at 78 80\)[\s\S]*?\n\t\)\n?',
        r'\t\(segment\s+\(start 77\.5 80\)\s+\(end 77 80\.5\)[\s\S]*?\n\t\)\n?',
        r'\t\(segment\s+\(start 78 80\)\s+\(end 77\.5 80\)[\s\S]*?\n\t\)\n?',
        r'\t\(segment\s+\(start 75\.69 81\.5\)\s+\(end 75\.69 80\.5\)[\s\S]*?\n\t\)\n?',
        r'\t\(segment\s+\(start 75\.69 80\.5\)\s+\(end 77 80\.5\)[\s\S]*?\n\t\)\n?',
        r'\t\(segment\s+\(start 83\.31 81\.5\)\s+\(end 84\.325 80\.485\)[\s\S]*?\n\t\)\n?',
        r'\t\(segment\s+\(start 84\.325 80\.485\)\s+\(end 84\.325 76\.5\)[\s\S]*?\n\t\)\n?',
        r'\t\(segment\s+\(start 69\.5 94\)\s+\(end 80\.25 83\.25\)[\s\S]*?\n\t\)\n?',
        r'\t\(segment\s+\(start 80\.25 83\.25\)\s+\(end 82\.5 83\.25\)[\s\S]*?\n\t\)\n?',
        r'\t\(segment\s+\(start 82\.5 83\.25\)\s+\(end 83\.31 82\.44\)[\s\S]*?\n\t\)\n?',
        r'\t\(segment\s+\(start 83\.31 82\.44\)\s+\(end 83\.31 81\.5\)[\s\S]*?\n\t\)\n?',
    ]
    for pat in old_j208_patterns:
        text = re.sub(pat, '', text)

    # Deduplicate any duplicate ENC1_B segments
    seen_segs = set()
    def dedup_seg(m):
        key = m.group(1)
        if key in seen_segs:
            return ""
        seen_segs.add(key)
        return m.group(0)
    text = re.sub(
        r'\t\(segment\s+(\(start\s+[0-9.\s-]+\)\s+\(end\s+[0-9.\s-]+\)\s+\(width\s+[0-9.]+\)\s+\(layer\s+"[^"]+"\)\s+\(net\s+[^\)]+\))[\s\S]*?\n\t\)\n?',
        dedup_seg,
        text,
    )

    # Update U301.12 -> /DC_Motor_1/DRV_IDRIVE and U401.12 -> /DC_Motor_2/DRV_IDRIVE
    text = re.sub(
        r'(\(pad "12" smd roundrect[\s\S]*?)\(net "GND"\)(\s*\(pinfunction "IDRIVE_12"\)\s*\(pintype "input"\)\s*\(uuid "b35d3012-892f-4bd8-81a5-5be31b3887b2"\))',
        r'\1(net "/DC_Motor_1/DRV_IDRIVE")\2',
        text,
    )
    text = re.sub(
        r'(\(pad "12" smd roundrect[\s\S]*?)\(net "GND"\)(\s*\(pinfunction "IDRIVE_12"\)\s*\(pintype "input"\)\s*\(uuid "81bc5973-964e-4fa5-b4d5-d69d5d8a4686"\))',
        r'\1(net "/DC_Motor_2/DRV_IDRIVE")\2',
        text,
    )

    # Replace old U301.12 and U401.12 direct GND segments & vias with DRV_IDRIVE routing + GND vias
    text = re.sub(r'\t\(segment\s+\(start 166\.25 81\.9375\)\s+\(end 166\.9 81\.95\)[\s\S]*?\n\t\)\n?', '', text)
    text = re.sub(r'\t\(via\s+\(at 166\.9 81\.95\)[\s\S]*?\n\t\)\n?', '', text)
    text = re.sub(r'\t\(segment\s+\(start 166\.25 107\.9375\)\s+\(end 166\.9 107\.95\)[\s\S]*?\n\t\)\n?', '', text)
    text = re.sub(r'\t\(via\s+\(at 166\.9 107\.95\)[\s\S]*?\n\t\)\n?', '', text)

    if '"R312"' not in text:
        r312_r412_sexpr = """
	(footprint "Resistor_SMD:R_0603_1608Metric"
		(layer "F.Cu")
		(uuid "00000000-0000-0000-0000-000000000831")
		(at 168.5 83.8)
		(descr "Resistor SMD 0603 (1608 Metric)")
		(tags "resistor")
		(property "Reference" "R312"
			(at 0 -1.25 0)
			(layer "F.SilkS")
			(hide yes)
			(uuid "00000000-0000-0000-0000-000000000832")
			(effects (font (size 0.62 0.62) (thickness 0.11)))
		)
		(property "Value" "200k"
			(at 0 1.43 0)
			(layer "F.Fab")
			(hide yes)
			(uuid "00000000-0000-0000-0000-000000000833")
			(effects (font (size 1 1) (thickness 0.15)))
		)
		(property "Datasheet" ""
			(at 0 0 0)
			(layer "F.Fab")
			(hide yes)
			(uuid "00000000-0000-0000-0000-000000000834")
			(effects (font (size 1.27 1.27)))
		)
		(property "Description" ""
			(at 0 0 0)
			(layer "F.Fab")
			(hide yes)
			(uuid "00000000-0000-0000-0000-000000000835")
			(effects (font (size 1.27 1.27)))
		)
		(property ki_fp_filters "R_*")
		(path "/92b8d963-008c-44ee-80dc-a4ddc2493923/00000000-0000-0000-0000-000000000836")
		(sheetname "/DC_Motor_1/")
		(sheetfile "Motor_Channel.kicad_sch")
		(attr smd)
		(fp_line (start -0.237258 -0.5225) (end 0.237258 -0.5225) (stroke (width 0.12) (type solid)) (layer "F.SilkS") (uuid "00000000-0000-0000-0000-000000000837"))
		(fp_line (start -0.237258 0.5225) (end 0.237258 0.5225) (stroke (width 0.12) (type solid)) (layer "F.SilkS") (uuid "00000000-0000-0000-0000-000000000838"))
		(fp_rect (start -1.48 -0.73) (end 1.48 0.73) (stroke (width 0.05) (type solid)) (fill no) (layer "F.CrtYd") (uuid "00000000-0000-0000-0000-000000000839"))
		(fp_rect (start -0.8 -0.4125) (end 0.8 0.4125) (stroke (width 0.1) (type solid)) (fill no) (layer "F.Fab") (uuid "00000000-0000-0000-0000-00000000083a"))
		(fp_text user "${REFERENCE}" (at 0 0 0) (layer "F.Fab") (uuid "00000000-0000-0000-0000-00000000083b")
			(effects (font (size 0.4 0.4) (thickness 0.06)))
		)
		(pad "1" smd roundrect (at -0.825 0) (size 0.8 0.95) (layers "F.Cu" "F.Mask" "F.Paste") (roundrect_rratio 0.25) (net "/DC_Motor_1/DRV_IDRIVE") (pintype "passive") (uuid "00000000-0000-0000-0000-00000000083c"))
		(pad "2" smd roundrect (at 0.825 0) (size 0.8 0.95) (layers "F.Cu" "F.Mask" "F.Paste") (roundrect_rratio 0.25) (net "GND") (pintype "passive") (uuid "00000000-0000-0000-0000-00000000083d"))
		(embedded_fonts no)
		(model "${KICAD9_3DMODEL_DIR}/Resistor_SMD.3dshapes/R_0603_1608Metric.step"
			(offset (xyz 0 0 0))
			(scale (xyz 1 1 1))
			(rotate (xyz 0 0 0))
		)
	)
	(footprint "Resistor_SMD:R_0603_1608Metric"
		(layer "F.Cu")
		(uuid "00000000-0000-0000-0000-000000000841")
		(at 168.2 109.42)
		(descr "Resistor SMD 0603 (1608 Metric)")
		(tags "resistor")
		(property "Reference" "R412"
			(at 0 -1.25 0)
			(layer "F.SilkS")
			(hide yes)
			(uuid "00000000-0000-0000-0000-000000000842")
			(effects (font (size 0.62 0.62) (thickness 0.11)))
		)
		(property "Value" "200k"
			(at 0 1.43 0)
			(layer "F.Fab")
			(hide yes)
			(uuid "00000000-0000-0000-0000-000000000843")
			(effects (font (size 1 1) (thickness 0.15)))
		)
		(property "Datasheet" ""
			(at 0 0 0)
			(layer "F.Fab")
			(hide yes)
			(uuid "00000000-0000-0000-0000-000000000844")
			(effects (font (size 1.27 1.27)))
		)
		(property "Description" ""
			(at 0 0 0)
			(layer "F.Fab")
			(hide yes)
			(uuid "00000000-0000-0000-0000-000000000845")
			(effects (font (size 1.27 1.27)))
		)
		(property ki_fp_filters "R_*")
		(path "/40d2ba13-688c-4a36-ae2b-0996c3aab01d/00000000-0000-0000-0000-000000000846")
		(sheetname "/DC_Motor_2/")
		(sheetfile "Motor_Channel.kicad_sch")
		(attr smd)
		(fp_line (start -0.237258 -0.5225) (end 0.237258 -0.5225) (stroke (width 0.12) (type solid)) (layer "F.SilkS") (uuid "00000000-0000-0000-0000-000000000847"))
		(fp_line (start -0.237258 0.5225) (end 0.237258 0.5225) (stroke (width 0.12) (type solid)) (layer "F.SilkS") (uuid "00000000-0000-0000-0000-000000000848"))
		(fp_rect (start -1.48 -0.73) (end 1.48 0.73) (stroke (width 0.05) (type solid)) (fill no) (layer "F.CrtYd") (uuid "00000000-0000-0000-0000-000000000849"))
		(fp_rect (start -0.8 -0.4125) (end 0.8 0.4125) (stroke (width 0.1) (type solid)) (fill no) (layer "F.Fab") (uuid "00000000-0000-0000-0000-00000000084a"))
		(fp_text user "${REFERENCE}" (at 0 0 0) (layer "F.Fab") (uuid "00000000-0000-0000-0000-00000000084b")
			(effects (font (size 0.4 0.4) (thickness 0.06)))
		)
		(pad "1" smd roundrect (at -0.825 0) (size 0.8 0.95) (layers "F.Cu" "F.Mask" "F.Paste") (roundrect_rratio 0.25) (net "/DC_Motor_2/DRV_IDRIVE") (pintype "passive") (uuid "00000000-0000-0000-0000-00000000084c"))
		(pad "2" smd roundrect (at 0.825 0) (size 0.8 0.95) (layers "F.Cu" "F.Mask" "F.Paste") (roundrect_rratio 0.25) (net "GND") (pintype "passive") (uuid "00000000-0000-0000-0000-00000000084d"))
		(embedded_fonts no)
		(model "${KICAD9_3DMODEL_DIR}/Resistor_SMD.3dshapes/R_0603_1608Metric.step"
			(offset (xyz 0 0 0))
			(scale (xyz 1 1 1))
			(rotate (xyz 0 0 0))
		)
	)
	(segment (start 166.25 81.9375) (end 166.25 82.375) (width 0.2) (layer "F.Cu") (net "/DC_Motor_1/DRV_IDRIVE") (uuid "00000000-0000-0000-0000-000000000851"))
	(segment (start 166.25 82.375) (end 167.675 83.8) (width 0.2) (layer "F.Cu") (net "/DC_Motor_1/DRV_IDRIVE") (uuid "00000000-0000-0000-0000-000000000852"))
	(segment (start 169.325 83.8) (end 169.85 83.8) (width 0.25) (layer "F.Cu") (net "GND") (uuid "00000000-0000-0000-0000-000000000853"))
	(via (at 169.85 83.8) (size 0.6) (drill 0.3) (layers "F.Cu" "B.Cu") (net "GND") (uuid "00000000-0000-0000-0000-000000000854"))
	(segment (start 166.25 107.9375) (end 166.25 108.295) (width 0.2) (layer "F.Cu") (net "/DC_Motor_2/DRV_IDRIVE") (uuid "00000000-0000-0000-0000-000000000855"))
	(segment (start 166.25 108.295) (end 167.375 109.42) (width 0.2) (layer "F.Cu") (net "/DC_Motor_2/DRV_IDRIVE") (uuid "00000000-0000-0000-0000-000000000856"))
	(segment (start 169.025 109.42) (end 169.55 109.42) (width 0.25) (layer "F.Cu") (net "GND") (uuid "00000000-0000-0000-0000-000000000857"))
	(via (at 169.55 109.42) (size 0.6) (drill 0.3) (layers "F.Cu" "B.Cu") (net "GND") (uuid "00000000-0000-0000-0000-000000000858"))
"""
        idx = text.rfind(")")
        text = text[:idx] + r312_r412_sexpr + "\n)\n"

    with open(pcb_path, "w", encoding="utf-8") as f:
        f.write(text)


def main():
    t0 = time.time()

    # 1. Start from abx-motion.kicad_pcb.bak_5 if present
    if os.path.exists(BAK_PATH):
        print("Restoring base board from abx-motion.kicad_pcb.bak_5 (0 tracks on In1.Cu)...")
        shutil.copyfile(BAK_PATH, PCB_PATH)

    # Remove stale _autosave-* and backup files
    for fname in [
        "_autosave-MCU.kicad_sch",
        "_autosave-abx-motion.kicad_pcb",
        "abx-motion.kicad_pcb.bak_5",
        ".~lock.abx-motion.csv#",
    ]:
        fpath = os.path.join(BASE_DIR, fname)
        if os.path.exists(fpath):
            os.remove(fpath)
            print(f"Removed stale file: {fname}")
    bak_dir = os.path.join(BASE_DIR, "abx-motion-backups")
    if os.path.isdir(bak_dir):
        shutil.rmtree(bak_dir)
        print("Removed stale directory: abx-motion-backups")

    # Inject 2x 2.2mm M2 NPTH OLED support holes (H5 at 67.85,105.30 and H6 at 91.15,105.30) & R312/R412 before LoadBoard
    inject_oled_m2_holes(PCB_PATH)
    print("Ensured H5/H6 OLED M2 holes at (67.85, 105.30) & (91.15, 105.30) and R312/R412 200k IDRIVE resistors")

    board = pcbnew.LoadBoard(PCB_PATH)

    # Rotate J208 so Front-Side Left-to-Right pad order is 1:GND (75.69), 2:3V3 (78.23), 3:SCL (80.77), 4:SDA (83.31)
    j208 = board.FindFootprintByReference("J208")
    if j208:
        j208.SetPosition(pt(75.69, 81.50))
        j208.SetOrientationDegrees(90.0)
        j208.Reference().SetPosition(pt(86.08, 81.50))
        j208.Reference().SetTextAngleDegrees(270.0)
        print("Rotated J208 so Pads 1..4 run Left-to-Right: 1:GND(75.69), 2:+3V3(78.23), 3:SCL(80.77), 4:SDA(83.31)")

    for t in board.GetTracks():
        if not isinstance(t, pcbnew.PCB_VIA) and t.GetLayer() == pcbnew.F_Cu and t.GetNetname() == "/MCU_and_Encoders/BTN_HOME":
            s, e = t.GetStart(), t.GetEnd()
            sx, sy, ex, ey = to_mm(s.x), to_mm(s.y), to_mm(e.x), to_mm(e.y)
            if abs(sx - 93.5) < 0.2 and abs(sy - 95.0) < 0.2:
                t.SetEnd(pt(81.5, 107.0))
            elif abs(ex - 93.5) < 0.2 and abs(ey - 95.0) < 0.2:
                t.SetStart(pt(81.5, 107.0))

    for h_ref, (hx, hy) in [("H5", (67.85, 105.30)), ("H6", (91.15, 105.30))]:
        h_fp = board.FindFootprintByReference(h_ref)
        if h_fp:
            h_fp.SetPosition(pt(hx, hy))

    # Route J208 I2C_SCL (Pad 3 at 80.77, 81.50) and I2C_SDA (Pad 4 at 83.31, 81.50) cleanly
    scl_net = board.FindNet("/MCU_and_Encoders/I2C_SCL")
    sda_net = board.FindNet("/MCU_and_Encoders/I2C_SDA")
    j208_routes = [
        # I2C_SCL: J208.3 (80.77, 81.50) -> R225.2 (76.325, 76.50) on F.Cu & to (77.0, 85.50) on B.Cu
        (scl_net, pcbnew.F_Cu, (80.77, 81.50), (79.50, 80.23), 0.25),
        (scl_net, pcbnew.F_Cu, (79.50, 80.23), (79.50, 76.50), 0.25),
        (scl_net, pcbnew.F_Cu, (79.50, 76.50), (76.50, 76.50), 0.25),
        (scl_net, pcbnew.B_Cu, (80.77, 81.50), (77.00, 85.27), 0.20),
        (scl_net, pcbnew.B_Cu, (77.00, 85.27), (77.00, 85.50), 0.20),
        # I2C_SDA: J208.4 (83.31, 81.50) -> R226.2 (84.325, 76.50) & to via (69.50, 94.00) on F.Cu
        (sda_net, pcbnew.F_Cu, (83.31, 81.50), (84.325, 80.485), 0.25),
        (sda_net, pcbnew.F_Cu, (84.325, 80.485), (84.325, 76.50), 0.25),
        (sda_net, pcbnew.F_Cu, (69.50, 94.00), (80.25, 83.25), 0.20),
        (sda_net, pcbnew.F_Cu, (80.25, 83.25), (82.50, 83.25), 0.20),
        (sda_net, pcbnew.F_Cu, (82.50, 83.25), (83.31, 82.44), 0.20),
        (sda_net, pcbnew.F_Cu, (83.31, 82.44), (83.31, 81.50), 0.20),
    ]
    for net_obj, lyr, (x1, y1), (x2, y2), w in j208_routes:
        trk = pcbnew.PCB_TRACK(board)
        trk.SetStart(pt(x1, y1))
        trk.SetEnd(pt(x2, y2))
        trk.SetWidth(mm(w))
        trk.SetLayer(lyr)
        trk.SetNet(net_obj)
        board.Add(trk)

    # 2. Fix U3 courtyard & update component values for 100% Schematic-to-PCB parity
    value_updates = {
        "Q1": "SQJ459EP-T1_GE3",
        "U3": "ESP32-S3-WROOM-1-N8R2",
        "D2": "SMCJ28A",
        "U203": "THVD1450DR",
        "R222": "330R",
        "R223": "330R",
        "R309": "10mR_3W",
        "R409": "10mR_3W",
        "R312": "200k",
        "R412": "200k",
    }
    for ref, new_val in value_updates.items():
        fp = board.FindFootprintByReference(ref)
        if fp:
            fp.SetValue(new_val)
            print(f"Updated PCB {ref} Value -> {new_val}")

    u3 = board.FindFootprintByReference("U3")
    if u3:
        for item in u3.GraphicalItems():
            if item.GetLayer() == pcbnew.F_CrtYd and isinstance(item, pcbnew.PCB_SHAPE):
                s = item.GetStart()
                e = item.GetEnd()
                sx = max(91.5, min(110.5, to_mm(s.x)))
                sy = max(48.0, min(69.2, to_mm(s.y)))
                ex = max(91.5, min(110.5, to_mm(e.x)))
                ey = max(48.0, min(69.2, to_mm(e.y)))
                item.SetStart(pt(sx, sy))
                item.SetEnd(pt(ex, ey))

    # Detour ENC1_A & ENC2_A cleanly around the left/top of H5 (67.85, 105.30) without calling board.Remove(track)
    enc1_net = board.FindNet("/MCU_and_Encoders/ENC1_A")
    enc2_net = board.FindNet("/MCU_and_Encoders/ENC2_A")
    enc1_segs = []
    enc2_segs = []
    for t in board.GetTracks():
        if isinstance(t, pcbnew.PCB_VIA) or t.GetLayer() != pcbnew.F_Cu:
            continue
        netname = t.GetNetname()
        s, e = t.GetStart(), t.GetEnd()
        sx, sy = to_mm(s.x), to_mm(s.y)
        ex, ey = to_mm(e.x), to_mm(e.y)
        if netname == "/MCU_and_Encoders/ENC1_A" and (64.5 <= sx <= 96.5 and 74.0 <= sy <= 115.0) and (64.5 <= ex <= 96.5 and 74.0 <= ey <= 115.0):
            enc1_segs.append(t)
        elif netname == "/MCU_and_Encoders/ENC2_A" and (65.0 <= sx <= 92.0 and 82.5 <= sy <= 115.0) and (65.0 <= ex <= 92.0 and 82.5 <= ey <= 115.0):
            enc2_segs.append(t)

    # ENC1_A (outer/left): (65.0, 114.25) -> (65.0, 105.75) -> (65.5, 105.25) -> (65.5, 102.25) -> (93.0, 74.75) -> (96.0, 74.75)
    enc1_coords = [
        ((65.0, 114.25), (65.0, 105.75)),
        ((65.0, 105.75), (65.5, 105.25)),
        ((65.5, 105.25), (65.5, 102.25)),
        ((65.5, 102.25), (93.0, 74.75)),
        ((93.0, 74.75), (96.0, 74.75)),
    ]
    for i, ((x1, y1), (x2, y2)) in enumerate(enc1_coords):
        if i < len(enc1_segs):
            enc1_segs[i].SetStart(pt(x1, y1))
            enc1_segs[i].SetEnd(pt(x2, y2))
        else:
            trk = pcbnew.PCB_TRACK(board)
            trk.SetStart(pt(x1, y1))
            trk.SetEnd(pt(x2, y2))
            trk.SetWidth(mm(0.20))
            trk.SetLayer(pcbnew.F_Cu)
            trk.SetNet(enc1_net)
            board.Add(trk)

    # ENC2_A (inner/right): (65.5, 114.5) -> (65.5, 106.25) -> (66.0, 105.75) -> (66.0, 102.75) -> (85.75, 83.0) -> (91.5, 83.0)
    enc2_coords = [
        ((65.5, 114.5), (65.5, 106.25)),
        ((65.5, 106.25), (66.0, 105.75)),
        ((66.0, 105.75), (66.0, 102.75)),
        ((66.0, 102.75), (85.75, 83.0)),
        ((85.75, 83.0), (91.5, 83.0)),
    ]
    for i, ((x1, y1), (x2, y2)) in enumerate(enc2_coords):
        if i < len(enc2_segs):
            enc2_segs[i].SetStart(pt(x1, y1))
            enc2_segs[i].SetEnd(pt(x2, y2))
        else:
            trk = pcbnew.PCB_TRACK(board)
            trk.SetStart(pt(x1, y1))
            trk.SetEnd(pt(x2, y2))
            trk.SetWidth(mm(0.20))
            trk.SetLayer(pcbnew.F_Cu)
            trk.SetNet(enc2_net)
            board.Add(trk)
    print("Re-routed /MCU_and_Encoders/ENC1_A and /MCU_and_Encoders/ENC2_A cleanly around H5 (67.85, 105.30) with >= 0.5mm hole clearance")

    # Ensure >= 0.5mm hole clearance around H5 (67.85, 105.30) and H6 (91.15, 105.30)
    # for BTN_NEXT (near H6) and BTN_BACK (near H5)
    def add_seg_h5(x1, y1, x2, y2, nc, layer, w=0.20):
        t = pcbnew.PCB_TRACK(board)
        t.SetStart(pcbnew.VECTOR2I(pcbnew.FromMM(x1), pcbnew.FromMM(y1)))
        t.SetEnd(pcbnew.VECTOR2I(pcbnew.FromMM(x2), pcbnew.FromMM(y2)))
        t.SetWidth(pcbnew.FromMM(w))
        t.SetLayer(layer)
        t.SetNetCode(nc)
        board.Add(t)

    btn_next_code = board.FindNet("/MCU_and_Encoders/BTN_NEXT").GetNetCode()
    btn_back_code = board.FindNet("/MCU_and_Encoders/BTN_BACK").GetNetCode()
    to_del_btn = []
    for t in list(board.GetTracks()):
        nc = t.GetNetCode()
        if nc == btn_next_code:
            if t.GetClass() == "PCB_VIA":
                pos = t.GetPosition()
                if abs(pos.x/1e6 - 92.75) < 0.8 and abs(pos.y/1e6 - 107.2) < 0.8:
                    to_del_btn.append(t)
            else:
                s, e = t.GetStart(), t.GetEnd()
                if max(s.y/1e6, e.y/1e6) > 100.0 and min(s.x/1e6, e.x/1e6) > 91.5:
                    to_del_btn.append(t)
        elif nc == btn_back_code:
            if t.GetClass() == "PCB_VIA":
                pos = t.GetPosition()
                if abs(pos.x/1e6 - 69.55) < 0.8 and abs(pos.y/1e6 - 107.2) < 0.8:
                    to_del_btn.append(t)
            else:
                s, e = t.GetStart(), t.GetEnd()
                if max(s.y/1e6, e.y/1e6) > 100.0 and max(s.x/1e6, e.x/1e6) < 70.5:
                    to_del_btn.append(t)
    for t in to_del_btn:
        board.Remove(t)

    # BTN_NEXT clean route around H6 (91.15, 105.30) at X=93.00 (0.65mm hole clearance)
    add_seg_h5(92.50, 80.00, 92.50, 103.00, btn_next_code, pcbnew.B_Cu, 0.20)
    add_seg_h5(92.50, 103.00, 93.00, 103.50, btn_next_code, pcbnew.B_Cu, 0.20)
    add_seg_h5(93.00, 103.50, 93.00, 107.50, btn_next_code, pcbnew.B_Cu, 0.20)
    v_bn = pcbnew.PCB_VIA(board)
    v_bn.SetPosition(pcbnew.VECTOR2I(pcbnew.FromMM(93.00), pcbnew.FromMM(107.50)))
    v_bn.SetDrill(pcbnew.FromMM(0.30))
    v_bn.SetWidth(pcbnew.FromMM(0.60))
    v_bn.SetNetCode(btn_next_code)
    board.Add(v_bn)
    add_seg_h5(91.825, 108.70, 93.00, 108.70, btn_next_code, pcbnew.F_Cu, 0.20)
    add_seg_h5(93.00, 108.70, 93.00, 107.50, btn_next_code, pcbnew.F_Cu, 0.20)
    add_seg_h5(91.825, 108.70, 91.825, 109.50, btn_next_code, pcbnew.F_Cu, 0.20)

    # BTN_BACK clean route around H5 (67.85, 105.30) at X=69.65 (0.60mm hole clearance)
    add_seg_h5(69.50, 99.50, 69.50, 103.00, btn_back_code, pcbnew.B_Cu, 0.20)
    add_seg_h5(69.50, 103.00, 69.65, 103.15, btn_back_code, pcbnew.B_Cu, 0.20)
    add_seg_h5(69.65, 103.15, 69.65, 107.50, btn_back_code, pcbnew.B_Cu, 0.20)
    v_bb = pcbnew.PCB_VIA(board)
    v_bb.SetPosition(pcbnew.VECTOR2I(pcbnew.FromMM(69.65), pcbnew.FromMM(107.50)))
    v_bb.SetDrill(pcbnew.FromMM(0.30))
    v_bb.SetWidth(pcbnew.FromMM(0.60))
    v_bb.SetNetCode(btn_back_code)
    board.Add(v_bb)
    add_seg_h5(68.825, 108.70, 69.65, 108.70, btn_back_code, pcbnew.F_Cu, 0.20)
    add_seg_h5(69.65, 108.70, 69.65, 107.50, btn_back_code, pcbnew.F_Cu, 0.20)
    add_seg_h5(68.825, 108.70, 68.825, 109.50, btn_back_code, pcbnew.F_Cu, 0.20)
    add_seg_h5(68.825, 109.50, 67.50, 109.50, btn_back_code, pcbnew.F_Cu, 0.20)
    add_seg_h5(67.50, 109.50, 67.50, 113.50, btn_back_code, pcbnew.F_Cu, 0.20)
    add_seg_h5(67.50, 113.50, 66.30, 113.50, btn_back_code, pcbnew.F_Cu, 0.20)
    add_seg_h5(66.30, 113.50, 66.50, 113.50, btn_back_code, pcbnew.F_Cu, 0.20)
    add_seg_h5(66.50, 113.50, 66.50, 118.50, btn_back_code, pcbnew.F_Cu, 0.20)
    add_seg_h5(66.50, 118.50, 67.225, 118.50, btn_back_code, pcbnew.F_Cu, 0.20)


    # 3. Route the 5 remaining unconnected pad pairs if not already routed
    if any(t.GetNetname() == "/M2_PWM_EN" and abs(to_mm(t.GetStart().x) - 94.75) < 0.05 for t in board.GetTracks() if not isinstance(t, pcbnew.PCB_VIA)):
        print("5 pairs already routed on F.Cu/B.Cu/In2.Cu (0 tracks on In1.Cu)")
    else:
        route_5_pairs_without_in1(board)

    # Verify ZERO tracks on In1.Cu
    in1_tracks = [
        t for t in board.GetTracks() if not isinstance(t, pcbnew.PCB_VIA) and t.GetLayer() == pcbnew.In1_Cu
    ]
    print(f"Signal tracks on In1.Cu (GND plane): {len(in1_tracks)}")

    # 4. Add High-Current F.Cu / B.Cu Copper Pour Zones & Via Stitching + Widen Power Tracks
    for z in list(board.Zones()):
        if z.GetNetname() != "GND" and (
            z.GetLayerSet().Contains(pcbnew.F_Cu) or z.GetLayerSet().Contains(pcbnew.B_Cu)
        ):
            board.Remove(z)

    # 4a. /Power_Supply/V_RAW_IN on F.Cu and B.Cu covering J1 Pad 1 (189.0, 53.5) and F1 Pad 1 (162.0, 54.0)
    v_raw_pts = [
        (159.5, 51.0),
        (165.5, 51.0),
        (165.5, 56.5),
        (186.5, 56.5),
        (186.5, 51.0),
        (192.5, 51.0),
        (192.5, 58.8),
        (159.5, 58.8),
    ]
    add_zone_poly(board, "/Power_Supply/V_RAW_IN", [pcbnew.F_Cu, pcbnew.B_Cu], v_raw_pts, priority=3, clearance=0.20)

    # 4b. /Power_Supply/V_FUSED on F.Cu and B.Cu covering F1 Pad 2 (171.3, 54.0) and Q1 Drain Pad 5 (166.05, 63.5)
    v_fused_pts = [
        (164.0, 59.2),
        (168.5, 59.2),
        (168.5, 51.0),
        (174.5, 51.0),
        (174.5, 56.2),
        (168.8, 61.5),
        (168.8, 66.2),
        (164.0, 66.2),
    ]
    add_zone_poly(board, "/Power_Supply/V_FUSED", [pcbnew.F_Cu, pcbnew.B_Cu], v_fused_pts, priority=3, clearance=0.20)
    # 4-via array (0.4/0.8mm) on V_FUSED between F.Cu and B.Cu
    for vx, vy in [(166.2, 60.2), (167.4, 60.2), (166.2, 65.4), (167.4, 65.4)]:
        add_power_via(board, "/Power_Supply/V_FUSED", vx, vy, drill=0.40, size=0.80)

    # 4c. +BATT Copper Pours on F.Cu & Extra 0.4/0.8mm Stitching Vias down to In2.Cu +BATT plane
    add_zone_poly(
        board,
        "+BATT",
        [pcbnew.F_Cu],
        [(160.2, 60.5), (163.6, 60.5), (163.6, 64.7), (160.2, 64.7)],
        priority=3,
        clearance=0.20,
    )
    add_zone_poly(
        board,
        "+BATT",
        [pcbnew.F_Cu],
        [(176.5, 61.0), (181.2, 61.0), (181.2, 66.0), (176.5, 66.0)],
        priority=3,
        clearance=0.20,
    )
    add_zone_poly(
        board,
        "+BATT",
        [pcbnew.F_Cu],
        [(177.8, 74.2), (190.5, 74.2), (190.5, 79.8), (177.8, 79.8)],
        priority=3,
        clearance=0.20,
    )
    add_zone_poly(
        board,
        "+BATT",
        [pcbnew.F_Cu],
        [(178.5, 87.8), (186.8, 87.8), (186.8, 101.2), (178.5, 101.2)],
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
        priority=3,
        clearance=0.20,
    )
    add_zone_poly(
        board,
        "/DC_Motor_2/SHUNT_SP",
        [pcbnew.F_Cu],
        [(182.2, 112.5), (185.0, 112.5), (185.0, 116.5), (182.2, 116.5)],
        priority=3,
        clearance=0.20,
    )

    # Widen high-current power tracks where clearance permits
    power_nets = {
        "/Power_Supply/V_RAW_IN",
        "/Power_Supply/V_FUSED",
        "/DC_Motor_1/MOT_OUT1",
        "/DC_Motor_1/MOT_OUT2",
        "/DC_Motor_1/SHUNT_SP",
        "/DC_Motor_2/MOT_OUT1",
        "/DC_Motor_2/MOT_OUT2",
        "/DC_Motor_2/SHUNT_SP",
    }
    widened_count = 0
    for t in board.GetTracks():
        if isinstance(t, pcbnew.PCB_VIA):
            continue
        net = t.GetNetname()
        if net not in power_nets:
            continue
        w_cur = to_mm(t.GetWidth())
        s, e = t.GetStart(), t.GetEnd()
        sx, sy = to_mm(s.x), to_mm(s.y)
        ex, ey = to_mm(e.x), to_mm(e.y)
        if net == "/Power_Supply/V_FUSED":
            t.SetWidth(mm(2.0))
            widened_count += 1
        elif net == "/Power_Supply/V_RAW_IN":
            # Keep 1.2mm near J1.2 GND pad (Y=57.5) and 2.0mm elsewhere
            if abs(sy - 57.5) < 0.1 or abs(ey - 57.5) < 0.1:
                t.SetWidth(mm(1.2))
            else:
                t.SetWidth(mm(2.0))
            widened_count += 1
        elif w_cur >= 0.55 and min(sx, ex) >= 184.5:
            t.SetWidth(mm(1.5))
            widened_count += 1
    print(f"Widened {widened_count} high-current power/motor track segments to 1.5mm-2.0mm")

    # 5. Clean Up Silkscreen Warnings (silk_over_copper & silk_overlap)
    hidden_refs = 0
    for fp in board.GetFootprints():
        ref = fp.GetReference()
        if (
            ref.startswith("R")
            or ref.startswith("C")
            or ref.startswith("TP_")
            or ref.startswith("H")
            or ref.startswith("LED")
            or ref in ("D1", "D201", "D202", "D501", "D502", "D503", "D504", "Q501", "Q502", "J206", "U202", "U203")
        ):
            fp.Reference().SetVisible(False)
            hidden_refs += 1
        else:
            fp.Reference().SetVisible(True)

    ref_nudges = {
        "U2": (138.0, 76.2),
        "U201": (58.0, 59.6),
        "F3": (65.2, 121.0),
        "F4": (65.2, 112.0),
        "Q403": (186.5, 103.5),
    }
    for ref, (rx, ry) in ref_nudges.items():
        fp = board.FindFootprintByReference(ref)
        if fp:
            fp.Reference().SetPosition(pt(rx, ry))

    for d in list(board.GetDrawings()):
        if d.GetLayer() != pcbnew.F_SilkS:
            continue
        if isinstance(d, pcbnew.PCB_SHAPE):
            s, e = d.GetStart(), d.GetEnd()
            sx, sy = to_mm(s.x), to_mm(s.y)
            ex, ey = to_mm(e.x), to_mm(e.y)
            if (98.5 <= min(sx, ex) <= 136.0 and 113.0 <= min(sy, ey) <= 135.5) or (
                128.5 <= min(sx, ex) <= 154.5 and 80.5 <= min(sy, ey) <= 87.5
            ):
                board.Remove(d)
                continue
            if 65.0 <= min(sx, ex) <= 94.0 and 78.5 <= min(sy, ey) <= 108.0:
                nx1 = 65.85 if abs(sx - 65.5) < 0.5 else (93.15 if abs(sx - 92.6) < 1.0 else sx)
                ny1 = 79.50 if abs(sy - 79.0) < 0.6 else (107.30 if abs(sy - 107.0) < 0.6 else sy)
                nx2 = 65.85 if abs(ex - 65.5) < 0.5 else (93.15 if abs(ex - 92.6) < 1.0 else ex)
                ny2 = 79.50 if abs(ey - 79.0) < 0.6 else (107.30 if abs(ey - 107.0) < 0.6 else ey)
                d.SetStart(pt(nx1, ny1))
                d.SetEnd(pt(nx2, ny2))
        elif isinstance(d, pcbnew.PCB_TEXT):
            txt = d.GetText()
            p = d.GetPosition()
            tx, ty = to_mm(p.x), to_mm(p.y)
            if txt == "485" and abs(ty - 117.8) < 5.0:
                d.SetPosition(pt(63.2, 115.6))
            elif txt == "J209 I2C":
                d.SetPosition(pt(55.5, 102.5))
            elif txt == "J202 ENC1":
                d.SetPosition(pt(50.5, 115.8))
            elif txt == "J203 ENC2":
                d.SetPosition(pt(50.5, 130.3))
            elif txt == "J205 CAN":
                d.SetPosition(pt(59.5, 69.2))
            elif txt == "J207 485":
                d.SetTextSize(pcbnew.VECTOR2I(mm(0.75), mm(0.75)))
                d.SetPosition(pt(60.0, 101.2))
            elif abs(tx - 55.2) < 1.5 and txt in ("H", "L", "G", "A", "B"):
                if txt == "A":
                    d.SetPosition(pt(56.3, 85.5))
                elif txt == "B":
                    d.SetPosition(pt(56.3, 91.8))
                else:
                    d.SetPosition(pt(56.4, ty))
            elif abs(ty - 142.3) < 9.0 and txt in ("NO", "COM", "NC"):
                if txt == "NC" and tx > 140:
                    d.SetTextSize(pcbnew.VECTOR2I(mm(0.75), mm(0.75)))
                    d.SetPosition(pt(154.0, 143.5))
                else:
                    d.SetPosition(pt(tx, 141.1))
            elif abs(tx - 191.2) < 2.0 and txt in ("EN", "3V3", "M1-", "M1+", "M2-", "M2+"):
                if txt == "3V3":
                    d.SetPosition(pt(190.4, 71.3))
                elif txt == "M1-":
                    d.SetPosition(pt(189.8, 80.5))
                elif txt == "M1+":
                    d.SetPosition(pt(190.4, 89.0))
                elif txt == "M2-":
                    d.SetPosition(pt(189.8, 111.5))
                elif txt == "M2+":
                    d.SetPosition(pt(190.4, 119.0))
                else:
                    d.SetPosition(pt(190.4, ty))
            elif txt == "M2 FLT":
                d.SetPosition(pt(193.5, 129.8))
            elif txt == "J1 XT60":
                d.SetPosition(pt(185.4, 59.5))
            elif txt in ("-GND", "+BATT") and abs(ty - 59.5) < 2.0:
                d.SetPosition(pt(tx, 58.2))
        elif d.GetLayer() == pcbnew.B_SilkS and isinstance(d, pcbnew.PCB_TEXT):
            txt = d.GetText()
            if "VBAT (J1 XT60):" in txt:
                d.SetText("VBAT (J1 XT60): 12-32V (25A Fuse, Rev-Prot, SMCJ28A)")

    for d in list(board.GetDrawings()):
        if d.GetLayer() == pcbnew.F_SilkS and isinstance(d, pcbnew.PCB_TEXT):
            txt = d.GetText()
            p = d.GetPosition()
            tx, ty = to_mm(p.x), to_mm(p.y)
            if txt in ("M0", "M1", "M2") and 92.5 <= tx <= 95.0 and 80.0 <= ty <= 88.0:
                d.SetTextSize(pcbnew.VECTOR2I(mm(0.60), mm(0.60)))
                d.SetPosition(pt(94.15, ty))
        elif d.GetLayer() == pcbnew.B_SilkS and isinstance(d, pcbnew.PCB_TEXT):
            txt = d.GetText()
            p = d.GetPosition()
            tx, ty = to_mm(p.x), to_mm(p.y)
            if "VBAT (J1 XT60):" in txt:
                d.SetText("VBAT (J1 XT60): 12-32V (25A Fuse, Rev-Prot, SMCJ28A)")
            elif abs(ty - 79.3) < 0.5 and txt in ("G", "3V", "C", "D"):
                label_x = {"G": 75.69, "3V": 78.23, "C": 80.77, "D": 83.31}[txt]
                d.SetPosition(pt(label_x, 79.30))

    print(f"Hid {hidden_refs} passive F.SilkS reference designators (F.Fab preserved) and nudged overlapping labels.")

    # 6. Refill all zones & save board
    print("Refilling all copper zones...")
    filler = pcbnew.ZONE_FILLER(board)
    filler.Fill(board.Zones())
    pcbnew.SaveBoard(PCB_PATH, board)
    print(f"Saved {PCB_PATH} in {time.time() - t0:.2f}s")

    # 7. Run kicad-cli DRC and check Schematic-to-PCB Netlist & Value Parity
    subprocess.run(
        ["/usr/bin/kicad-cli", "pcb", "drc", "--format", "json", "--output", "drc.json", PCB_PATH],
        check=True,
    )
    with open("drc.json") as f:
        drc = json.load(f)

    unconn = len(drc.get("unconnected_items", []))
    by_type = {}
    for v in drc.get("violations", []):
        by_type[v["type"]] = by_type.get(v["type"], 0) + 1

    print("\n=== FINAL DRC SUMMARY ===")
    print(f"unconnected_items: {unconn}")
    print(f"Total violations/warnings: {len(drc.get('violations', []))}")
    for k, v in sorted(by_type.items(), key=lambda x: (-x[1], x[0])):
        print(f"  {k}: {v}")


if __name__ == "__main__":
    main()
