levdan159/abx-motion/(commit log)

2026-10-19 Initial release: ABX-Motion 4-layer ESP32-S3 robotics controller (0 DRC/ERC, full JLCPCB manufacturing package)
    [MCU.kicad_sch, Motor_Channel.kicad_sch, Power.kicad_sch, Steppers_Relays.kicad_sch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]
2026-10-19 Docs: Update README to reflect KiCad 10.0
2026-10-19 Fix 5 LCSC part numbers and apply JLCPCB 3D viewer centroid & rotation offsets in CPL
    [abx-motion-bom.csv, abx-motion-bom_20261019_1253.csv, abx-motion-bom_20261019_1308.csv, abx-motion-jlcpcb-bom.csv, abx-motion-jlcpcb-bom_20261019_1253.csv, abx-motion-jlcpcb-bom_20261019_1308.csv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]
2026-10-19 Fix B4B-XH-A LCSC part number (C144395) and K501/K502 relay 270deg CPL rotation
    [abx-motion-bom.csv, abx-motion-bom_20261019_1253.csv, abx-motion-bom_20261019_1308.csv, abx-motion-jlcpcb-bom.csv, abx-motion-jlcpcb-bom_20261019_1253.csv, abx-motion-jlcpcb-bom_20261019_1308.csv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]
2026-10-19 Fix all BOM LCSC part numbers and mathematically align all CPL centroids/rotations against EasyEDA pad geometry
    [abx-motion-bom.csv, abx-motion-jlcpcb-bom.csv, abx-motion.kicad_pcb, confirmed-bom-errors.csv, placement-review.csv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]
2026-10-19 Update silkscreen fonts, gerbers, and manufacturing archives
    [abx-motion-B_Cu.gbl, abx-motion-B_Mask.gbs, abx-motion-B_Paste.gbp, abx-motion-B_Silkscreen.gbo, abx-motion-Edge_Cuts.gm1, abx-motion-F_Cu.gtl, abx-motion-F_Mask.gts, abx-motion-F_Paste.gtp]
2026-10-19 Resolve all 5 prototype review items (F1 3557-2 4-pad THT, SMCJ30A, 2.2nF/0.5W snubber, 0.45-0.50mm stepper traces, clean PTH/NPTH drills)
    [Motor_Channel.kicad_sch, Power.kicad_sch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]
2026-10-19 Release v1.0-production: finalize F1 3D STEP model alignment and archive V1.0 production package
    [Fuseholder_Keystone_3557-2.step, MCU.kicad_sch, Motor_Channel.kicad_sch, Power.kicad_sch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]
2026-10-19 Complete V1.1 compact 6-channel I/O & DC output architecture (0 ERC, 0 DRC errors, 0 unconnected, 0 parity)
    [Industrial_IO.kicad_sch, JLCPCB_BOM.csv, MCU.kicad_sch, Motor_Channel.kicad_sch, Steppers_Relays.kicad_sch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]
2026-10-19 Finalize V1.1 rear exposed-copper gold gear branding, polish, validation, and production package
    [Industrial_IO.kicad_sch, JLCPCB_BOM.csv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]
2026-10-20 Finalize Rev 1.1d robustness, thermal layout and manufacturing package
    Preserve sensing and current-limit fixes, assembly part/rotation corrections,
    D2 package changes, revision markings and incremental thermal copper/vias.
    Archive the working checkpoints and supplier/validation evidence alongside
    matched Gerbers, BOM, CPL, schematic PDF, renders and hash manifests.
    Current Rev 1.1d: ERC 0; DRC 0 errors, 0 opens and 0 parity issues,
    with 19 existing library footprint warnings. Preserve original routing and
    component placements; physical powered qualification is not yet performed.
    Relay alignment requires assembler review before assembly.
    [Fuseholder_Keystone_3557-2.step, Industrial_IO.kicad_sch, JLCPCB_BOM.csv, MCU.kicad_sch, Motor_Channel.kicad_sch, Power.kicad_sch, Steppers_Relays.kicad_sch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]
2026-10-20 Outline Rev 1.2 three-axis integrated stepper architecture
2026-10-20 Research integrated stepper layout, thermal design and safe control for Rev 1.2
    [conduction-loss-comparison.csv, implementation-checklist.csv]
2026-10-20 Consolidate Rev 1.2 relay bay and promote checked layout to root
    [Fuseholder_Keystone_3557-2.step, Industrial_IO.kicad_sch, MCU.kicad_sch, Motor_Channel.kicad_sch, Power.kicad_sch, Steppers_Relays.kicad_sch, abx-motion.kicad_pcb, abx-motion.kicad_sch]
2026-10-20 Shift relay outputs bottom-right and refine relay routing and indicators
    [abx-motion.kicad_pcb, before.kicad_pcb, native-placement-changes.csv]
2026-10-20 Use low-profile EXT control headers with matching front and rear legends
    [Steppers_Relays.kicad_sch, abx-motion.kicad_pcb, before-Steppers_Relays.kicad_sch, before.kicad_pcb, rev-1.2-parts-overrides.csv]
2026-10-20 Pack upright EXT headers and symmetric motor connectors to the right
    [Steppers_Relays.kicad_sch, abx-motion.kicad_pcb, before-Steppers_Relays.kicad_sch, before-right-shift.kicad_pcb, before-symmetry.kicad_pcb, before.kicad_pcb, motor-group-routing.json, motor-routed-drc.json]
2026-10-20 Pack digital I/O beneath OLED and straighten local routing
    [MCU.kicad_sch, abx-motion.kicad_pcb, placements-native.csv, rev-1.2-parts-overrides.csv]
2026-10-23 Save Rev 1.2a three-axis checkpoint and audited JLCPCB exports
    [DFN-8-1EP_3x3mm_P0.65mm_EP1.5x2.25mm.step, HS1-machining-plan.dxf, Industrial_IO.kicad_sch, MCU.kicad_sch, Motor_Channel.kicad_sch, Power.kicad_sch, Steppers_Relays.kicad_sch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]
2026-10-23 Fix JLC terminal entry directions and LED polarity in Rev 1.2a CPL
    [component-orientation-review.csv, placements.csv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]
2026-10-23 Add Rev 1.2b Ethernet placement candidate with optional ETH SKU
    [DFN-8-1EP_3x3mm_P0.65mm_EP1.5x2.25mm.step, Fuseholder_Keystone_3557-2.step, abx-motion-eth-placement.kicad_pcb]
2026-10-23 Move Ethernet draft CS test pads to left of ESP32
    [abx-motion-eth-placement.kicad_pcb]
2026-10-23 Expand Ethernet supply reservation and add draft 3V3 test pad
    [abx-motion-eth-placement.kicad_pcb]
2026-10-23 Place dedicated Ethernet 3V3 supply and power-domain interface
    [abx-motion-eth-placement.kicad_pcb]
2026-10-24 Begin Rev 1.2b Ethernet routing and clean displaced copper
    [Ethernet_Power.kicad_sch, Industrial_IO.kicad_sch, MCU.kicad_sch, Motor_Channel.kicad_sch, Power.kicad_sch, Steppers_Relays.kicad_sch, abx-motion-eth-placement.kicad_pcb, abx-motion-eth-placement.kicad_sch]
2026-10-24 Record final QA for Ethernet initial routing checkpoint
    [schematic-erc.json]
2026-10-24 Promote reviewed Ethernet draft into root abx-motion project
    [Ethernet_Power.kicad_sch, abx-motion.kicad_pcb, abx-motion.kicad_sch]
2026-10-24 Bundle Ethernet 3D models for reliable root project loading
    [C_0402_1005Metric.step, C_0603_1608Metric.step, C_0805_2012Metric.step, C_1206_3216Metric.step, Crystal_SMD_3225-4Pin_3.2x2.5mm.step, LQFP-48_7x7mm_P0.5mm.step, L_0603_1608Metric.step, L_Sunlord_SWPA4030S.step]
2026-10-24 Clear root project DRC findings and preserve explicit Ethernet draft status
    [MCU.kicad_sch, Motor_Channel.kicad_sch, Power.kicad_sch, Steppers_Relays.kicad_sch, abx-motion.kicad_pcb]
