levdan159/abx-motion/(notices)

Notices in the files:
abx-3dmodels/ethernet/C_1206_3216Metric.step:
Copyright (C) 2017, kicad StepUp
This work is licensed under the [Creative Commons CC-BY-SA 4.0 License](https://creativecommons.org/licenses/by-sa/4.0/legalcode),
with the following exception:
To the extent that the creation of electronic designs that use 'Licensed Material' can be considered to be 'Adapted Material',
You are free to use the library data in your own projects without the obligation to share your project files under this or any other license agreement.
abx-3dmodels/ethernet/R_0402_1005Metric.step:
Copyright (C) 2018, kicad StepUp
abx-3dmodels/ethernet/SOT-23-6.step:
Copyright (C) 2025, KiCAD
This work is licensed under the
[Creative Commons CC-BY-SA 4.0 License](https://creativecommons.org/licenses/by-sa/4.0/legalcode),
project files under this or any other license agreement. However, if you wish to distribute
variants/ABX-Motion-ETH/abx-3dmodels/DFN-8-1EP_3x3mm_P0.65mm_EP1.5x2.25mm.step:
Copyright (C) 2024, KiCAD
